Brunobnhtr/projeto-integrador-camara-frigorifica/imagens/regulador_de_tensao_lm2596_step_down_com_display.webp

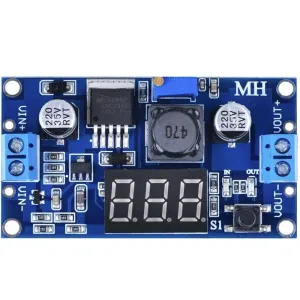
imagens/regulador_de_tensao_lm2596_step_down_com_display.webp
