Brunobnhtr/projeto-integrador-camara-frigorifica/imagens/bts7960-Pinout.webp

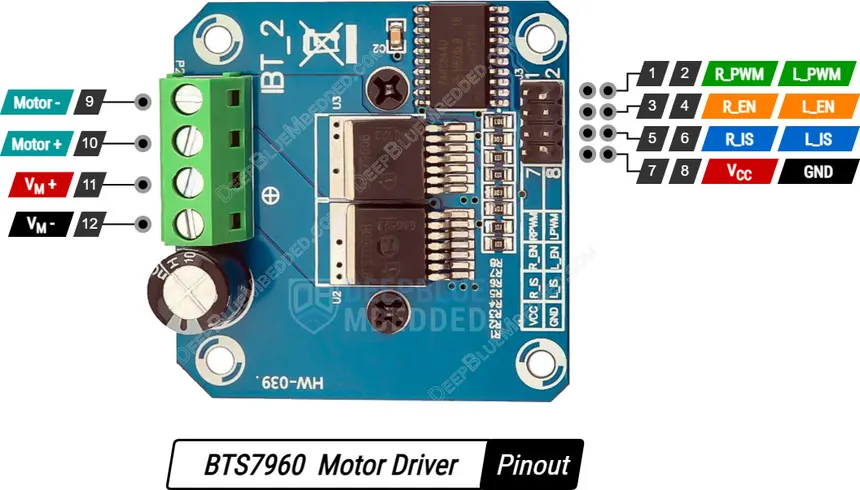
imagens/bts7960-Pinout.webp
