Brunobnhtr/projeto-integrador-camara-frigorifica/referencias/README.md

# Referências externas

Relatórios e análises de fora do projeto, guardados como estão — **não são documentação do
projeto**. Quando uma conclusão daqui vira decisão, ela é escrita no documento dono do assunto
e o relatório fica aqui só como fonte.

| Arquivo | O que é | Para onde foram as conclusões |
|---|---|---|
| [`2026-08_analise_acionamento_peltier.md`](2026-08_analise_acionamento_peltier.md) | Análise técnica do acionamento das cargas (Peltier, PTC, ventoinhas), com referências de fabricantes e do relatório SLUA979A da TI | ⏳ pendente — o ponto principal (PWM de 1 Hz na Peltier degrada o COP e a vida da pastilha) precisa ser decidido e escrito no [Doc 40](../camada_4_programacao/40_firmware_arduino.md) |
