Brunobnhtr/projeto-integrador-camara-frigorifica/compras_projeto/RELATORIO_OFERTAS_ALIEXPRESS.md

# Relatório Completo de Ofertas e Links no AliExpress

**Data da Varredura:** 01/11/2026 13:03
**Total de Itens Analisados:** 60 componentes
**Orçamento Estimado das Peças:** R$ 963.08

> [!NOTE]
> Todos os 60 componentes foram varridos no AliExpress com filtros anti-isca, detecção de frete grátis e verificação de reputação. O arquivo interativo [`lista_compras_interativa.html`](file:///c:/Users/Bruno/Documents/Estudos%20Programação/tecnico%20em%20eletrotecnica/projeto%20integrador/lista_compras_interativa.html) já foi atualizado com todos os links e opções.

### 1 · Núcleo térmico da câmara

| ID | Componente | Preço (R$) | Frete | Total (R$) | Reputação / Vendas | Anúncio Selecionado |
| :--- | :--- | :---: | :---: | :---: | :--- | :--- |
| `CAM-01` | **Kit Peltier duplo 2× TEC1-12706** | R$ 68.11 | Grátis | **R$ 68.11** | 68 vendido(s) 5★ | [Kit DIY Resfriamento Peltier Duplo com R...](https://pt.aliexpress.com/item/1005011995246407.html) |
| `CAM-02` | **Dissipador do lado quente (rejeitar 184 W a 43 °C)** | R$ 6.99 | Grátis | **R$ 6.99** | 8 vendido(s) 5★ | [Dissipador de Calor de Alumínio 40mm 40x...](https://pt.aliexpress.com/item/1005013118166628.html) |
| `CAM-03` | **Aquecedor Cerâmico PTC 12 V / 50 W com ventoinha integrada** | R$ 20.98 | Grátis | **R$ 20.98** | 57 vendido(s) 4.5★ | [Aquecedor automático, termostato, ptc, c...](https://pt.aliexpress.com/item/1005001849494940.html) |
| `CAM-04` | **Ventoinha 40 mm 12 V (boca dos dutos)** | R$ 5.59 | Grátis | **R$ 5.59** | 42 vendido(s) 4★ | [Dc 5v 12v 24v ventilador turbo impressor...](https://pt.aliexpress.com/item/1005004661839574.html) |
| `CAM-05` | **Sensor AM2315C (temperatura + umidade)** | R$ 28.20 | Grátis | **R$ 28.20** | ★ | [1 unidade/peça, 100% novo, sensor de tem...](https://pt.aliexpress.com/item/1005013336794806.html) |

### 2 · Vedação e montagem da câmara

| ID | Componente | Preço (R$) | Frete | Total (R$) | Reputação / Vendas | Anúncio Selecionado |
| :--- | :--- | :---: | :---: | :---: | :--- | :--- |
| `VED-01` | **Cola S-320 Sinteglas (acrílico)** | R$ 4.36 | Grátis | **R$ 4.36** | 300 vendido(s) 4.6★ | [5/30/50/100 pces cola de unhas de adesão...](https://pt.aliexpress.com/item/1005009827743042.html) |
| `VED-02` | **Silicone neutro transparente** | R$ 3.06 | Grátis | **R$ 3.06** | 243 vendido(s) 3.9★ | [Borracha De Silicone Resistente De Alta ...](https://pt.aliexpress.com/item/1005005574541570.html) |
| `VED-03` | **Fita adesiva de alumínio 50 mm** | R$ 5.17 | Grátis | **R$ 5.17** | 164 vendido(s) 4.5★ | [Filme de isolamento térmico de folha de ...](https://pt.aliexpress.com/item/1005006259610758.html) |
| `VED-04` | **Perfil EPDM tubular autoadesivo 9 × 6 mm** | R$ 6.99 | Grátis | **R$ 6.99** | 18 vendido(s) ★ | [Fita de Vedação de Espuma de Borracha EP...](https://pt.aliexpress.com/item/1005012600375752.html) |
| `VED-05` | **Dobradiça piano de alumínio 250 mm** | R$ 3.87 | Grátis | **R$ 3.87** | 28 vendido(s) 4★ | [Engrossar 304 aço inoxidável miniatura s...](https://pt.aliexpress.com/item/1005010578226233.html) |
| `VED-06` | **Fecho de pressão tipo borboleta (inox)** | R$ 3.91 | Grátis | **R$ 3.91** | 16 vendido(s) ★ | [Fecho de trava para caixa de ferramentas...](https://pt.aliexpress.com/item/1005013139036831.html) |
| `VED-07` | **Sílica gel indicadora** | R$ 8.28 | Grátis | **R$ 8.28** | 89 vendido(s) 5★ | [Desecante de sílica gel que muda de cor ...](https://pt.aliexpress.com/item/1005009708591354.html) |
| `VED-08` | **Bandeja de alumínio removível (condensado)** | R$ 4.36 | Grátis | **R$ 4.36** | 291 vendido(s) 4.7★ | [Chaveiro colorido vazio maquiagem compac...](https://pt.aliexpress.com/item/1005010219203881.html) |
| `VED-09` | **Tubo de silicone Ø 4 mm (respiro)** | R$ 3.96 | Grátis | **R$ 3.96** | 88 vendido(s) 5★ | [Mangueira de borracha de silicone de gra...](https://pt.aliexpress.com/item/1005007005480071.html) |
| `VED-10` | **Pasta térmica de alta condutividade** | R$ 4.44 | Grátis | **R$ 4.44** | 17 vendido(s) 4.9★ | [Pasta de graxa térmica condutora gd900, ...](https://pt.aliexpress.com/item/1005007124076300.html) |
| `VED-11` | **Prensa-cabo PG13,5 (PC-1) + prensa-cabo PG11 (PC-2)** | R$ 6.59 | Grátis | **R$ 6.59** | 4.000+ vendido(s) 4.8★ | [10 unidades de prensa-cabos à prova d'ág...](https://pt.aliexpress.com/item/1005003593198702.html) |
| `VED-12` | **Passa-fio / bucha do respiro Ø 6 mm** | R$ 5.61 | Grátis | **R$ 5.61** | 94 vendido(s) 4.7★ | [Plugue de borracha para cabo shifter ele...](https://pt.aliexpress.com/item/1005006423905385.html) |
| `VED-13` | **Isolante EPS/XPS 1 mm** | R$ 6.99 | Grátis | **R$ 6.99** | 29 vendido(s) 5★ | [1/18 peças de Folhas de Espuma EVA Color...](https://pt.aliexpress.com/item/1005012741696113.html) |

### 3 · Cargas de ensaio (LED 12 V)

| ID | Componente | Preço (R$) | Frete | Total (R$) | Reputação / Vendas | Anúncio Selecionado |
| :--- | :--- | :---: | :---: | :---: | :--- | :--- |
| `ELE-01` | **LED 5 mm difuso (kit)** | R$ 3.06 | Grátis | **R$ 3.06** | 200 vendido(s) 4.8★ | [10/20/100 pces led transparente redondo ...](https://pt.aliexpress.com/item/1005006728032746.html) |
| `ELE-02` | **Resistor 1 kΩ 1/4 W** | R$ 6.89 | Grátis | **R$ 6.89** | 1K+ vendido(s | [Frete grátis 100 peças 1/4w resistor de ...](https://pt.aliexpress.com/item/32660635741.html) |
| `ELE-03` | **Borne 2 vias 5,08 mm para PCB** | R$ 4.29 | Grátis | **R$ 4.29** | 2 vendido(s) ★ | [10 Peças Bloco de Terminais KF301-2P de ...](https://pt.aliexpress.com/item/1005011982846512.html) |
| `ELE-04` | **Placa ilhada 10 × 15 cm — corta em 2 de 95 × 75 mm** | R$ 6.99 | Grátis | **R$ 6.99** | 66 vendido(s) 4.8★ | [5pcs PCB 5x7 4x6 3x7 2x8 10x15 9x7x10 7x...](https://pt.aliexpress.com/item/1005001990562066.html) |
| `ELE-05` | **Verniz isolante para PCB (conformal coating)** | R$ 4.86 | Grátis | **R$ 4.86** | 48 vendido(s) 5★ | [1Pç Selante Isolante Eletrônico Impermeá...](https://pt.aliexpress.com/item/1005012496214820.html) |
| `ELE-06` | **Régua de borne plugável 8 vias 5,08 mm (macho + fêmea)** | R$ 5.20 | Grátis | **R$ 5.20** | 122 vendido(s) 4.6★ | [10 Peças Conector de Bloco de Terminais ...](https://pt.aliexpress.com/item/1005010423019702.html) |

### 4 · Controle e interface

| ID | Componente | Preço (R$) | Frete | Total (R$) | Reputação / Vendas | Anúncio Selecionado |
| :--- | :--- | :---: | :---: | :---: | :--- | :--- |
| `CTR-01` | **Arduino Mega 2560 R3** | R$ 48.50 | Grátis | **R$ 48.50** | 16 vendido(s) 5★ | [Placa Arduino Mega 2560 R3 CH340 (seleci...](https://pt.aliexpress.com/item/1005009455420266.html) |
| `CTR-02` | **Adaptador DIN do Mega com bornes parafuso** | R$ 54.00 | Grátis | **R$ 54.00** | 465 vendido(s) 4.6★ | [Shield Borne Parafuso Mega 2560 Montado ...](https://pt.aliexpress.com/item/1005008674435948.html) |
| `CTR-03` | **ESP32-WROOM-32U (DevKit 30 pinos, u.FL)** | R$ 8.81 | Grátis | **R$ 8.81** | 94 vendido(s) 5★ | [Kit de Placa de Desenvolvimento 32 com C...](https://pt.aliexpress.com/item/1005012903691148.html) |
| `CTR-04` | **DNLCB30 — base DIN para ESP32** | R$ 30.23 | Grátis | **R$ 30.23** | 500+ vendido(s) 4.9★ | [30pin 38pin esp32 placa de expansão mont...](https://pt.aliexpress.com/item/1005007915407236.html) |
| `CTR-05` | **IHM ES3C28P — ESP32-S3 2,8" toque, microSD, microfone (LCDWIKI)** | R$ 64.90 | Grátis | **R$ 64.90** | 154 vendido(s) 4.8★ | [Display IHM Touch 2.8 ESP32-S3 ES3C28P (...](https://pt.aliexpress.com/item/1005008568072063.html) |
| `CTR-06` | **Cartão microSD 8–16 GB Classe 10** | R$ 26.39 | Grátis | **R$ 26.39** | 26 vendido(s) 4.7★ | [2026 1PCS Cartão TF Classe 10 128GB 256G...](https://pt.aliexpress.com/item/1005013170105807.html) |
| `CTR-07` | **Conversor de nível lógico bidirecional 4 canais** | R$ 2.59 | Grátis | **R$ 2.59** | 37 vendido(s | [Conversor de Nível Lógico I2C de 2/4 Can...](https://pt.aliexpress.com/item/1005012391263916.html) |
| `CTR-08` | **Módulo RTC DS3231** | R$ 5.00 | Grátis | **R$ 5.00** | 280 vendido(s) 5★ | [Tzt ds3231 at24c32 módulo iic ds1302 mód...](https://pt.aliexpress.com/item/1005008404452597.html) |
| `CTR-09` | **Bateria CR2032** | R$ 5.25 | Grátis | **R$ 5.25** | 3 vendido(s) 5★ | [VINIK Bateria de Litio CR2032 Cartela C/...](https://pt.aliexpress.com/item/1005013396106230.html) |

### 5 · Sensores e potência

| ID | Componente | Preço (R$) | Frete | Total (R$) | Reputação / Vendas | Anúncio Selecionado |
| :--- | :--- | :---: | :---: | :---: | :--- | :--- |
| `POT-01` | **Módulo N4AIC24 — 22 canais 0–20 mA + 2 canais 0–30 V, RS-485 (eletechsup)** | R$ 45.71 | Grátis | **R$ 45.71** | 63 vendido(s) 4.8★ | [Placa do coletor do IO do PLC de MODBUS ...](https://pt.aliexpress.com/item/1005006985583356.html) |
| `POT-03` | **DS18B20 à prova d'água + adaptador com pull-up 4,7 kΩ** | R$ 3.17 | Grátis | **R$ 3.17** | 1.000+ vendido(s) 5★ | [Kit de módulo sensor de temperatura ds18...](https://pt.aliexpress.com/item/4000068914916.html) |
| `POT-04` | **Driver ponte-H BTS7960 (IBT-2)** | R$ 15.45 | Grátis | **R$ 15.45** | 215 vendido(s) 4.4★ | [Módulo Driver de Motor de Alta Potência ...](https://pt.aliexpress.com/item/1005001552617411.html) |
| `POT-05` | **Suporte SPCI4 para trilho DIN (placa BTS7960)** | R$ 18.14 | Grátis | **R$ 18.14** | 211 vendido(s) 5★ | [Suporte de montagem com capacidade forte...](https://pt.aliexpress.com/item/1005006330486538.html) |
| `POT-06` | **Módulo MAX485 TTL ↔ RS-485** | R$ 2.52 | Grátis | **R$ 2.52** | 413 vendido(s | [1/5 pces max485 módulo RS-485 ttl virar ...](https://pt.aliexpress.com/item/1005008143587329.html) |

### 6 · Comando e proteção

| ID | Componente | Preço (R$) | Frete | Total (R$) | Reputação / Vendas | Anúncio Selecionado |
| :--- | :--- | :---: | :---: | :---: | :--- | :--- |
| `CMD-01` | **KM1 — Relé 14 pinos 24 Vcc (HH64P / LY4NJ 10 A) + base DIN PTF14A** | R$ 5.00 | Grátis | **R$ 5.00** | 7 vendido(s) ★ | [5 peças branco ly4nj hh64p ac 110v 220v ...](https://pt.aliexpress.com/item/1005009694726729.html) |
| `CMD-02` | **Módulo relé 1 canal 5 V optoacoplado** | R$ 3.99 | Grátis | **R$ 3.99** | 729 vendido(s | [DC 3V 5V 12V 24V 1 Canal Relé Optoacopla...](https://pt.aliexpress.com/item/1005006636278681.html) |
| `CMD-03` | **Botão de emergência cogumelo 22 mm com trava** | R$ 15.61 | Grátis | **R$ 15.61** | 2.000+ vendido(s) 4.9★ | [ZB2-BE102C p172 220v 10a vermelho nc 22m...](https://pt.aliexpress.com/item/1005002447999037.html) |
| `CMD-04` | **Botão START / LIGAR 22 mm verde** | R$ 3.65 | Grátis | **R$ 3.65** | 63 vendido(s) ★ | [XB2-EC31 XB2-EC42 XB2-EC51 cogumelo cabe...](https://pt.aliexpress.com/item/1005005249188935.html) |
| `CMD-05` | **Botão STOP 22 mm preto** | R$ 16.38 | Grátis | **R$ 16.38** | 700+ vendido(s) 4.5★ | [1PC Botão de Pressão Momentâneo de Metal...](https://pt.aliexpress.com/item/1005011991759856.html) |
| `CMD-06` | **Sinaleiro LED 22 mm 5 V** | R$ 5.80 | Grátis | **R$ 5.80** | 5K+ vendido(s | [Luz indicadora de metal led 6/8/10/12/16...](https://pt.aliexpress.com/item/1005006509086830.html) |
| `CMD-07` | **Disjuntor bipolar DIN 2P** | R$ 8.18 | Grátis | **R$ 8.18** | 10.000+ vendido(s) 4.9★ | [Disjuntor Miniatura TOMZN AC MCB TOB1-63...](https://pt.aliexpress.com/item/1005005315486852.html) |
| `CMD-08` | **Porta-fusível DIN 1 via com gaveta (ramais DC)** | R$ 17.27 | Grátis | **R$ 17.27** | 191 vendido(s) 5★ | [1 conjunto RT18-32X ac 500v ~ 690v 32a 1...](https://pt.aliexpress.com/item/1005005652228604.html) |
| `CMD-09` | **Fusíveis para F1/F2/F3 — valores e formato pendentes** | R$ 18.51 | Grátis | **R$ 18.51** | 286 vendido(s) 4.9★ | [Fusível cerâmico rápido do sopro, 10x38m...](https://pt.aliexpress.com/item/1005004206329118.html) |
| `CMD-10` | **Placa de distribuição 8 canais com chave + porta-fusível (trilho DIN)** | R$ 47.79 | Grátis | **R$ 47.79** | 119 vendido(s) 4.9★ | [Caixa de Fusíveis Universal para Carro c...](https://pt.aliexpress.com/item/1005004520637634.html) |
| `CMD-12` | **Fusíveis de lâmina ATO/ATC 1 A (para o CMD-10)** | R$ 6.69 | Grátis | **R$ 6.69** | 1.000+ vendido(s) 4.8★ | [Caixa média do fusível do carro do ATC, ...](https://pt.aliexpress.com/item/4000827623534.html) |
| `CMD-11` | **Barra de terra PE para painel** | R$ 6.99 | Grátis | **R$ 6.99** | 250 vendido(s | [1 peça verde azul parafuso latão trilho ...](https://pt.aliexpress.com/item/1005005675027929.html) |

### 7 · Alimentação

| ID | Componente | Preço (R$) | Frete | Total (R$) | Reputação / Vendas | Anúncio Selecionado |
| :--- | :--- | :---: | :---: | :---: | :--- | :--- |
| `ALI-01` | **Fonte chaveada 24 Vcc 10 A / 240 W** | R$ 134.99 | Grátis | **R$ 134.99** | 6 vendido(s) ★ | [Fonte de Alimentação Chaveada NDR-240-24...](https://pt.aliexpress.com/item/1005012555935454.html) |
| `ALI-02` | **T2/T3 — conversores propostos, modelos não aprovados** | R$ 58.00 | Grátis | **R$ 58.00** | 2.000+ vendido(s) 4.8★ | [Conversor Step-Down 24V para 12V 15A/20A...](https://pt.aliexpress.com/item/32827678754.html) |

### 8 · Comunicação

| ID | Componente | Preço (R$) | Frete | Total (R$) | Reputação / Vendas | Anúncio Selecionado |
| :--- | :--- | :---: | :---: | :---: | :--- | :--- |
| `COM-01` | **Antena 2,4 GHz SMA macho 3 dBi articulável** | R$ 8.35 | Grátis | **R$ 8.35** | 97 vendido(s) 5★ | [2.4GHz 3dBi WiFi 2.4g Antena Aérea RP-SM...](https://pt.aliexpress.com/item/1005003106292591.html) |
| `COM-02` | **Pigtail IPEX (u.FL) → SMA fêmea de painel, 20–30 cm** | R$ 3.61 | Grátis | **R$ 3.61** | 1.000+ vendido(s) 5★ | [U.FL IPX IPX1 UFL para RP-SMA Antena de ...](https://pt.aliexpress.com/item/1005006779358232.html) |

### 9 · Passivos

| ID | Componente | Preço (R$) | Frete | Total (R$) | Reputação / Vendas | Anúncio Selecionado |
| :--- | :--- | :---: | :---: | :---: | :--- | :--- |
| `PAS-01` | **Capacitor cerâmico 100 nF** | R$ 4.01 | Grátis | **R$ 4.01** | 1.000+ vendido(s) 4.8★ | [100PCS capacitor cerâmico monolítico 10P...](https://pt.aliexpress.com/item/1005007121552900.html) |
| `PAS-02` | **Resistor 10 kΩ ¼ W** | R$ 2.29 | Grátis | **R$ 2.29** | 632 vendido(s | [100pcs 1/4W 1R ~ 22M 1% resistor de film...](https://pt.aliexpress.com/item/1005002759346943.html) |
| `PAS-03` | **Diodo 1N4007** | R$ 3.45 | Grátis | **R$ 3.45** | 108 vendido(s) 5★ | [100PCS 1N4007 IN4007 4007 1N4007W 1N4007...](https://pt.aliexpress.com/item/1005007474734646.html) |

### 3 · Cargas de ensaio (LED 12 V)

| ID | Componente | Preço (R$) | Frete | Total (R$) | Reputação / Vendas | Anúncio Selecionado |
| :--- | :--- | :---: | :---: | :---: | :--- | :--- |
| `ELE-07` | **Chapa de alumínio 5052, 1,0 mm — retalho 250 × 200 mm** | R$ 25.19 | Grátis | **R$ 25.19** | 5 vendido(s) ★ | [5052 placa redonda de alumínio do círcul...](https://pt.aliexpress.com/item/1005010446356446.html) |
| `ELE-08` | **Parafuso M4 × 10 mm + porca (berço nas cantoneiras CAM-24)** | R$ 4.43 | Grátis | **R$ 4.43** | 213 vendido(s) 5★ | [1-2 Peças M3 M4 M5 M6 M8 M10 M12 Parafus...](https://pt.aliexpress.com/item/1005005883416931.html) |
| `ELE-09` | **Parafuso M3 × 8 mm + porca (fixação das placas no berço)** | R$ 3.49 | Grátis | **R$ 3.49** | 42 vendido(s) ★ | [1-100 Peças M1 M1.2 M1.4 M1.6 M2 M2.5 M3...](https://pt.aliexpress.com/item/1005008277639639.html) |
