Brunobnhtr/projeto-integrador-camara-frigorifica/compras_projeto/LISTA_COMPRAS.md

# Lista de compras — Projeto Integrador

Atualizado em 01/11/2026 · **0 de 60** itens com preço · total **R$ 0,00**

> **BLOQUEIO DE COMPRA:** PTC 12 V/50 W e conversores T2 (5 V/5 A) e T3 (12 V/20 A) são propostas sem modelos/fichas aprovados. Não comprar nem energizar. Corte DC do PTC, F3, proteção da saída de 12 V e condutores seguem pendentes; esta lista não autoriza compra.

> Não entram na lista porque o SENAI fornece: Cabos de alimentação e de sinal; Trilho DIN 35 mm; Canaletas perfuradas 30×30 e 25×25; Parafusos, porcas e arruelas; Gabinete/painel 600×800×250 (ou 700×700×250); Chapa de acrílico (corte da câmara); Bornes internos de distribuição (BD-24V, BD-POT, BD-5V, BD-AUX, BD-0V).

## Bloco 1 · Núcleo térmico da câmara

| ID | Item | Qtd | Loja | Preço | Link |
|---|---|---|---|---|---|
| CAM-01 | Kit Peltier duplo 2× TEC1-12706 | 1 kit | AliExpress | R$ 20,69 | [abrir](https://pt.aliexpress.com/item/1005009521156873.html) |
| CAM-02 | Dissipador do lado quente (rejeitar 184 W a 43 °C) | 1 | AliExpress | R$ 6,99 | [abrir](https://pt.aliexpress.com/item/1005013118166628.html) |
| CAM-03 | Aquecedor Cerâmico PTC 12 V / 50 W com ventoinha integrada | 1 | AliExpress | R$ 20,98 | [abrir](https://pt.aliexpress.com/item/1005001849494940.html) |
| CAM-04 | Ventoinha 40 mm 12 V (boca dos dutos) | 2 | AliExpress | R$ 5,59 | [abrir](https://pt.aliexpress.com/item/1005004661839574.html) |
| CAM-05 | Sensor AM2315C (temperatura + umidade) | 1 | Mercado Livre | a confirmar | [abrir](https://lista.mercadolivre.com.br/sensor-am2315c) |
| CAM-05 | Sensor AM2315C (temperatura + umidade) | 1 | AliExpress | a confirmar | [abrir](https://www.aliexpress.com/w/wholesale-AM2315C-sensor.html) |
| CAM-05 | Sensor AM2315C (temperatura + umidade) | 1 | AliExpress | R$ 28,20 | [abrir](https://pt.aliexpress.com/item/1005013336794806.html) |

## Bloco 2 · Vedação e montagem da câmara

| ID | Item | Qtd | Loja | Preço | Link |
|---|---|---|---|---|---|
| VED-01 | Cola S-320 Sinteglas (acrílico) | 1 frasco | AliExpress | R$ 4,36 | [abrir](https://pt.aliexpress.com/item/1005009827743042.html) |
| VED-02 | Silicone neutro transparente | 1 tubo | AliExpress | R$ 3,06 | [abrir](https://pt.aliexpress.com/item/1005005574541570.html) |
| VED-03 | Fita adesiva de alumínio 50 mm | 1 rolo 20 m | AliExpress | R$ 5,17 | [abrir](https://pt.aliexpress.com/item/1005006259610758.html) |
| VED-04 | Perfil EPDM tubular autoadesivo 9 × 6 mm | ~1,5 m | AliExpress | R$ 6,99 | [abrir](https://pt.aliexpress.com/item/1005012600375752.html) |
| VED-05 | Dobradiça piano de alumínio 250 mm | 1 | AliExpress | R$ 3,87 | [abrir](https://pt.aliexpress.com/item/1005010578226233.html) |
| VED-06 | Fecho de pressão tipo borboleta (inox) | 2 | AliExpress | R$ 3,91 | [abrir](https://pt.aliexpress.com/item/1005013139036831.html) |
| VED-07 | Sílica gel indicadora | 4 sachês | AliExpress | R$ 8,28 | [abrir](https://pt.aliexpress.com/item/1005009708591354.html) |
| VED-08 | Bandeja de alumínio removível (condensado) | 1 | AliExpress | R$ 4,36 | [abrir](https://pt.aliexpress.com/item/1005010219203881.html) |
| VED-09 | Tubo de silicone Ø 4 mm (respiro) | 0,5 m | AliExpress | R$ 3,96 | [abrir](https://pt.aliexpress.com/item/1005007005480071.html) |
| VED-10 | Pasta térmica de alta condutividade | 1 bisnaga | AliExpress | R$ 4,44 | [abrir](https://pt.aliexpress.com/item/1005007124076300.html) |
| VED-11 | Prensa-cabo PG13,5 (PC-1) + prensa-cabo PG11 (PC-2) | 1 de cada | AliExpress | R$ 6,59 | [abrir](https://pt.aliexpress.com/item/1005003593198702.html) |
| VED-12 | Passa-fio / bucha do respiro Ø 6 mm | 1 | AliExpress | R$ 5,61 | [abrir](https://pt.aliexpress.com/item/1005006423905385.html) |
| VED-13 | Isolante EPS/XPS 1 mm | a medir | AliExpress | R$ 6,99 | [abrir](https://pt.aliexpress.com/item/1005012741696113.html) |

## Bloco 3 · Cargas de ensaio (LED 12 V)

| ID | Item | Qtd | Loja | Preço | Link |
|---|---|---|---|---|---|
| ELE-01 | LED 5 mm difuso (kit) | 8 | AliExpress | R$ 3,06 | [abrir](https://pt.aliexpress.com/item/1005006728032746.html) |
| ELE-02 | Resistor 1 kΩ 1/4 W | 8 | AliExpress | R$ 6,89 | [abrir](https://pt.aliexpress.com/item/32660635741.html) |
| ELE-03 | Borne 2 vias 5,08 mm para PCB | 8 (4 por placa) | AliExpress | R$ 4,29 | [abrir](https://pt.aliexpress.com/item/1005011982846512.html) |
| ELE-04 | Placa ilhada 10 × 15 cm — corta em 2 de 95 × 75 mm | 1 | AliExpress | R$ 6,99 | [abrir](https://pt.aliexpress.com/item/1005001990562066.html) |
| ELE-05 | Verniz isolante para PCB (conformal coating) | 1 frasco | AliExpress | R$ 4,86 | [abrir](https://pt.aliexpress.com/item/1005012496214820.html) |
| ELE-06 | Régua de borne plugável 8 vias 5,08 mm (macho + fêmea) | 2 conjuntos | AliExpress | R$ 5,20 | [abrir](https://pt.aliexpress.com/item/1005010423019702.html) |

## Bloco 4 · Controle e interface

| ID | Item | Qtd | Loja | Preço | Link |
|---|---|---|---|---|---|
| CTR-01 | Arduino Mega 2560 R3 | 1 | AliExpress | R$ 15,28 | [abrir](https://pt.aliexpress.com/item/1005009455420266.html) |
| CTR-02 | Adaptador DIN do Mega com bornes parafuso | 1 | AliExpress | R$ 16,34 | [abrir](https://pt.aliexpress.com/item/1005008674435948.html) |
| CTR-03 | ESP32-WROOM-32U (DevKit 30 pinos, u.FL) | 1 | AliExpress | R$ 8,81 | [abrir](https://pt.aliexpress.com/item/1005012903691148.html) |
| CTR-04 | DNLCB30 — base DIN para ESP32 | 1 | AliExpress | R$ 30,23 | [abrir](https://pt.aliexpress.com/item/1005007915407236.html) |
| CTR-05 | IHM ES3C28P — ESP32-S3 2,8" toque, microSD, microfone (LCDWIKI) | 1 | AliExpress | R$ 19,32 | [abrir](https://pt.aliexpress.com/item/1005008568072063.html) |
| CTR-06 | Cartão microSD 8–16 GB Classe 10 | 1 | AliExpress | R$ 26,39 | [abrir](https://pt.aliexpress.com/item/1005013170105807.html) |
| CTR-07 | Conversor de nível lógico bidirecional 4 canais | 1 | AliExpress | R$ 2,59 | [abrir](https://pt.aliexpress.com/item/1005012391263916.html) |
| CTR-08 | Módulo RTC DS3231 | 1 | AliExpress | R$ 5,00 | [abrir](https://pt.aliexpress.com/item/1005008404452597.html) |
| CTR-09 | Bateria CR2032 | 1 | AliExpress | R$ 5,25 | [abrir](https://pt.aliexpress.com/item/1005013396106230.html) |

## Bloco 5 · Sensores e potência

| ID | Item | Qtd | Loja | Preço | Link |
|---|---|---|---|---|---|
| POT-01 | Módulo N4AIC24 — 22 canais 0–20 mA + 2 canais 0–30 V, RS-485 (eletechsup) | 1 | AliExpress | R$ 45,71 | [abrir](https://pt.aliexpress.com/item/1005006985583356.html) |
| POT-03 | DS18B20 à prova d'água + adaptador com pull-up 4,7 kΩ | 1 kit | AliExpress | R$ 3,17 | [abrir](https://pt.aliexpress.com/item/4000068914916.html) |
| POT-04 | Driver ponte-H BTS7960 (IBT-2) | 2 | AliExpress | R$ 15,45 | [abrir](https://pt.aliexpress.com/item/1005001552617411.html) |
| POT-05 | Suporte SPCI4 para trilho DIN (placa BTS7960) | 2 | AliExpress | R$ 18,14 | [abrir](https://pt.aliexpress.com/item/1005006330486538.html) |
| POT-06 | Módulo MAX485 TTL ↔ RS-485 | 1 | AliExpress | R$ 2,52 | [abrir](https://pt.aliexpress.com/item/1005008143587329.html) |

## Bloco 6 · Comando e proteção

| ID | Item | Qtd | Loja | Preço | Link |
|---|---|---|---|---|---|
| CMD-01 | KM1 — Relé 14 pinos 24 Vcc (HH64P / LY4NJ 10 A) + base DIN PTF14A | 1 | Mercado Livre | a confirmar | [abrir](https://lista.mercadolivre.com.br/rele-ly2n-24vcc-com-base-din-ptf08a) |
| CMD-01 | KM1 — Relé 14 pinos 24 Vcc (HH64P / LY4NJ 10 A) + base DIN PTF14A | 1 | AliExpress | a confirmar | [abrir](https://www.aliexpress.com/w/wholesale-LY2NJ-24VDC-relay-with-socket-base.html) |
| CMD-01 | KM1 — Relé 14 pinos 24 Vcc (HH64P / LY4NJ 10 A) + base DIN PTF14A | 1 | AliExpress | R$ 5,00 | [abrir](https://pt.aliexpress.com/item/1005009694726729.html) |
| CMD-01 | KM1 — Relé 14 pinos 24 Vcc (HH64P / LY4NJ 10 A) + base DIN PTF14A | 1 | AliExpress | R$ 6,99 | [abrir](https://pt.aliexpress.com/item/1005008248092442.html) |
| CMD-01 | KM1 — Relé 14 pinos 24 Vcc (HH64P / LY4NJ 10 A) + base DIN PTF14A | 1 | AliExpress | R$ 15,05 | [abrir](https://pt.aliexpress.com/item/1005004341879976.html) |
| CMD-02 | Módulo relé 1 canal 5 V optoacoplado | 3 | AliExpress | R$ 3,99 | [abrir](https://pt.aliexpress.com/item/1005006636278681.html) |
| CMD-03 | Botão de emergência cogumelo 22 mm com trava | 1 | AliExpress | R$ 15,61 | [abrir](https://pt.aliexpress.com/item/1005002447999037.html) |
| CMD-04 | Botão START / LIGAR 22 mm verde | 1 | AliExpress | R$ 3,65 | [abrir](https://pt.aliexpress.com/item/1005005249188935.html) |
| CMD-05 | Botão STOP 22 mm preto | 1 | AliExpress | R$ 16,38 | [abrir](https://pt.aliexpress.com/item/1005011991759856.html) |
| CMD-06 | Sinaleiro LED 22 mm 5 V | 4 | AliExpress | R$ 5,80 | [abrir](https://pt.aliexpress.com/item/1005006509086830.html) |
| CMD-07 | Disjuntor bipolar DIN 2P | 1 | AliExpress | R$ 8,18 | [abrir](https://pt.aliexpress.com/item/1005005315486852.html) |
| CMD-08 | Porta-fusível DIN 1 via com gaveta (ramais DC) | 3 | AliExpress | R$ 17,27 | [abrir](https://pt.aliexpress.com/item/1005005652228604.html) |
| CMD-09 | Fusíveis para F1/F2/F3 — valores e formato pendentes | a dimensionar | AliExpress | R$ 18,51 | [abrir](https://pt.aliexpress.com/item/1005004206329118.html) |
| CMD-10 | Placa de distribuição 8 canais com chave + porta-fusível (trilho DIN) | 1 | AliExpress | R$ 47,79 | [abrir](https://pt.aliexpress.com/item/1005004520637634.html) |
| CMD-12 | Fusíveis de lâmina ATO/ATC 1 A (para o CMD-10) | 10 (8 + 2 de reserva) | AliExpress | R$ 6,69 | [abrir](https://pt.aliexpress.com/item/4000827623534.html) |
| CMD-11 | Barra de terra PE para painel | 1 | AliExpress | R$ 6,99 | [abrir](https://pt.aliexpress.com/item/1005005675027929.html) |

## Bloco 7 · Alimentação

| ID | Item | Qtd | Loja | Preço | Link |
|---|---|---|---|---|---|
| ALI-01 | Fonte chaveada 24 Vcc 10 A / 240 W | 1 | Mercado Livre | a confirmar | [abrir](https://www.mercadolivre.com.br/fonte-chaveada-24v-10a-240w-bivolt-gabinete-metal-colmeia/up/MLBU2208031138) |
| ALI-01 | Fonte chaveada 24 Vcc 10 A / 240 W | 1 | AliExpress | R$ 134,99 | [abrir](https://pt.aliexpress.com/item/1005012555935454.html) |
| ALI-02 | T2/T3 — conversores propostos, modelos não aprovados | 2 | AliExpress | R$ 25,10 | [abrir](https://pt.aliexpress.com/item/32827678754.html) |

## Bloco 8 · Comunicação

| ID | Item | Qtd | Loja | Preço | Link |
|---|---|---|---|---|---|
| COM-01 | Antena 2,4 GHz SMA macho 3 dBi articulável | 1 | AliExpress | R$ 8,35 | [abrir](https://pt.aliexpress.com/item/1005003106292591.html) |
| COM-02 | Pigtail IPEX (u.FL) → SMA fêmea de painel, 20–30 cm | 1 | AliExpress | R$ 3,61 | [abrir](https://pt.aliexpress.com/item/1005006779358232.html) |

## Bloco 9 · Passivos

| ID | Item | Qtd | Loja | Preço | Link |
|---|---|---|---|---|---|
| PAS-01 | Capacitor cerâmico 100 nF | 2 | Mercado Livre | a confirmar | [abrir](https://produto.mercadolivre.com.br/MLB-1854298160-kit-20-capacitores-ceramicos-100nf-50v-104-_JM) |
| PAS-01 | Capacitor cerâmico 100 nF | 2 | AliExpress | R$ 4,01 | [abrir](https://pt.aliexpress.com/item/1005007121552900.html) |
| PAS-02 | Resistor 10 kΩ ¼ W | 6 | AliExpress | R$ 2,29 | [abrir](https://pt.aliexpress.com/item/1005002759346943.html) |
| PAS-03 | Diodo 1N4007 | 3 | Mercado Livre | a confirmar | [abrir](https://produto.mercadolivre.com.br/MLB-3563968257-filtro-diodo-supressor-de-ruido-0-a-24vcc-dds-sibratec-_JM) |
| PAS-03 | Diodo 1N4007 | 3 | AliExpress | R$ 3,45 | [abrir](https://pt.aliexpress.com/item/1005007474734646.html) |

## Bloco 3 · Cargas de ensaio (LED 12 V)

| ID | Item | Qtd | Loja | Preço | Link |
|---|---|---|---|---|---|
| ELE-07 | Chapa de alumínio 5052, 1,0 mm — retalho 250 × 200 mm | 1 | AliExpress | R$ 25,19 | [abrir](https://pt.aliexpress.com/item/1005010446356446.html) |
| ELE-08 | Parafuso M4 × 10 mm + porca (berço nas cantoneiras CAM-24) | 4 conjuntos | AliExpress | R$ 4,43 | [abrir](https://pt.aliexpress.com/item/1005005883416931.html) |
| ELE-09 | Parafuso M3 × 8 mm + porca (fixação das placas no berço) | 8 conjuntos | AliExpress | R$ 3,49 | [abrir](https://pt.aliexpress.com/item/1005008277639639.html) |
