Brunobnhtr/projeto-integrador-camara-frigorifica/demanda_secundaria/02_PROJECT_CANVAS.md

# PROJECT MODEL CANVAS
## SILO INTELIGENTE (Demanda GP Inovação #13063)

| JUSTIFICATIVAS | OBJETIVO SMART | BENEFÍCIOS |
| :--- | :--- | :--- |
| **Por que o projeto existe?**<br>- Processo atual de medição da gipsita é manual.<br>- Risco de acidentes ao subir nos silos.<br>- Falta de previsibilidade logística, causando paradas ou falta de material para os fornos.<br>- Alto nível de particulado (poeira) dificulta uso de sensores ópticos/ultrassônicos convencionais. | **O que o projeto vai entregar e quando?**<br>Desenvolver, no prazo do curso técnico, um protótipo funcional de telemetria sem contato para medição de nível de sólidos (gipsita), integrando radar de 80GHz a um painel IoT (ESP32) enviando dados via Wi-Fi/MQTT para uma interface de controle em tempo real. | **Quais os ganhos esperados?**<br>- Fim da necessidade do operador escalar silos de forma arriscada.<br>- Informação 24/7 sobre o estoque logístico, permitindo melhor controle dos fornos.<br>- Painel centralizado eliminando o "achismo" fabril.<br>- Custo-benefício aplicando IoT e microcontroladores sobre instrumentação pesada. |

| PRODUTO | REQUISITOS | STAKEHOLDERS |
| :--- | :--- | :--- |
| **O que será entregue?**<br>1. Painel Elétrico de Medição IP65.<br>2. Sistema de captação de sinal 4-20mA (Conversor ADC e ESP32).<br>3. Sensor Radar de Nível 80GHz instalado no topo do silo.<br>4. Dashboard remoto em tempo real exibindo a lotação (Volume) dos três silos. | **Características obrigatórias?**<br>- O sensor não pode ter contato físico direto com a matéria-prima.<br>- O sistema de sensoriamento deve ser imune à poeira densa (uso de onda eletromagnética).<br>- O painel elétrico deve suportar o ambiente hostil da mineração (vedação).<br>- Leitura atualizada pelo menos a cada 10 segundos.<br>- Conformidade com a NR-10 e NR-35 (reduzindo trabalho em altura). | **Quem está envolvido?**<br>- **Equipe técnica:** Alunos do curso de Eletrotécnica.<br>- **Cliente:** Gestores de Operação e Logística da fábrica de gesso.<br>- **Banca de Avaliação:** Professores do SENAI. |

| EQUIPE | PREMISSAS | RESTRIÇÕES |
| :--- | :--- | :--- |
| **Quem fará o trabalho?**<br>- Integrantes do grupo (Técnicos em Eletrotécnica em formação).<br> | **Suposições essenciais?**<br>- A infraestrutura da empresa cliente tem cobertura de Wi-Fi próxima aos silos.<br>- O cliente fornecerá a altura geométrica e formato (cone/cilindro) do silo para o cálculo algorítmico do volume.<br>- Disponibilidade de alimentação elétrica 127/220V no topo do silo ou na base. | **Limitações do projeto?**<br>- Orçamento limitado para a construção do protótipo.<br>- Não podemos alterar ou interferir nos painéis de comando dos fornos, apenas extrair a medição.<br>- O sensor deve ser homologado e não uma adaptação caseira de ultrassom (que falhará na poeira). |

| RISCOS | LINHA DO TEMPO | CUSTOS |
| :--- | :--- | :--- |
| **O que pode dar errado?**<br>- Queda de rede Wi-Fi interrompendo a telemetria (Mitigação: usar armazenamento local no SD Card do ESP32 até a rede voltar).<br>- Superaquecimento do painel devido ao sol escaldante na área externa (Mitigação: instalar o quadro protegido com tampa anti-UV ou teto). | **Quando será feito?**<br>- **Fase 1:** Pesquisa de especificação do radar didático/industrial e componentes elétricos.<br>- **Fase 2:** Montagem do quadro de comando e teste de bancada na maquete.<br>- **Fase 3:** Programação do ESP32, MQTT e Dashboard.<br>- **Fase 4:** Teste na maquete do silo e Validação final. | **Estimativa orçamentária do Protótipo:**<br>- **Opção Nível 1:** Radar mmWave Distância (ex: Acconeer A121 ou DFRobot): ~R$ 70 a R$ 150<br>- **Opção Nível 2:** Radar Industrial 80GHz Chinês 4-20mA: ~R$ 1.000 a R$ 1.500<br><br>*(Demais custos da maquete/painel)*<br>- Quadro IP65, Disjuntores, Bornes e Fontes: ~R$ 150<br>- Módulos IoT (ESP32): ~R$ 60<br>- Componentes da maquete (tubos PVC): ~R$ 50<br>**Custo Total (Nível 1):** ~R$ 330<br>**Custo Total (Nível 2):** ~R$ 1.300 |
