Brunobnhtr/projeto-integrador-camara-frigorifica/entrega_senai/06_entrega/ANALISE_VIABILIDADE.md

# Análise de Viabilidade — Projeto Integrador 2026

> ⚠️ **Como usar:** este documento apresenta a análise de viabilidade das **duas demandas**
> cadastradas no SAGA (GP Inovação SENAI). Cada demanda é analisada de forma independente,
> com três pilares: **viabilidade técnica**, **viabilidade econômica** e **viabilidade
> operacional**. O formato segue o padrão das entregas do Projeto Integrador — linguagem
> impessoal, objetiva e com evidências.

---

# DEMANDA 1 — Cabine Climatizada de Ensaios Térmicos

> **SAGA GP Inovação:** Projeto Integrador 2026/01 6.01 03
> **Título:** Implementação de Sistema de Controle Inteligente com ESP32 para Cabine Climatizada
> **Empresa:** Ensaios & Controle Tech
> **Área:** Automação

---

## 1. Descrição da Demanda

A empresa realiza ensaios térmicos em dispositivos eletrônicos embarcados, submetendo até 50
unidades simultaneamente a ciclos de aquecimento e resfriamento em cabine climatizada, conforme
a série IEC 60068-2. O sistema atual opera com Arduino e acionamento manual, sem monitoramento
remoto, sem registro de dados e sem detecção individual de falha. Quando um dispositivo falha
durante o ciclo, a falha só é percebida ao final — sem rastreabilidade de quando nem por quê.
O ensaio inteiro é descartado.
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
