Brunobnhtr/projeto-integrador-camara-frigorifica/compras_projeto/fotos/CAM-01_capturado.jpg

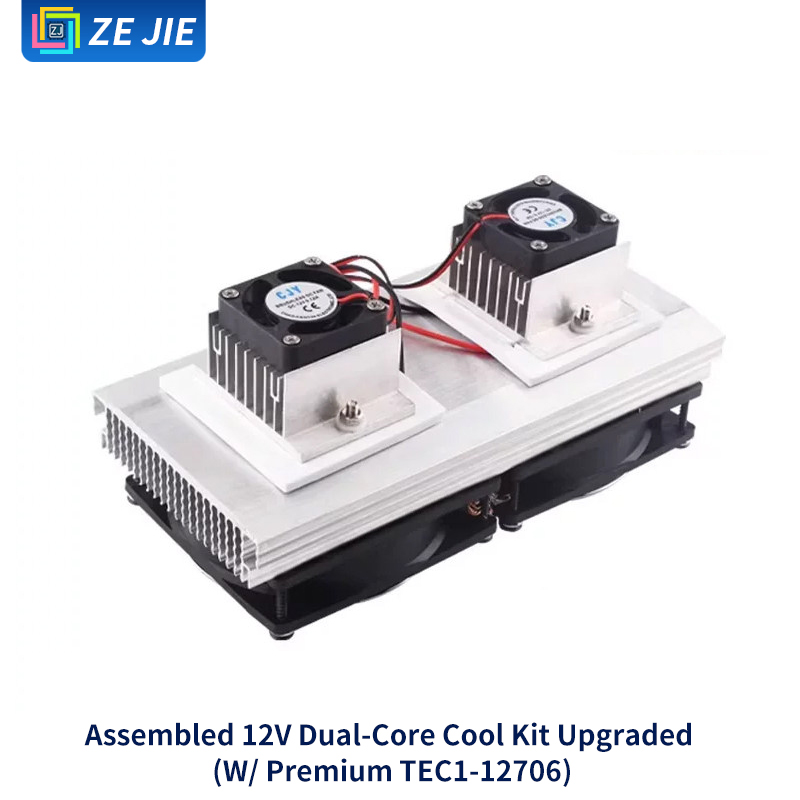
compras_projeto/fotos/CAM-01_capturado.jpg
