Brunobnhtr/projeto-integrador-camara-frigorifica/compras_projeto/fotos/CAM-01_variacao.jpg

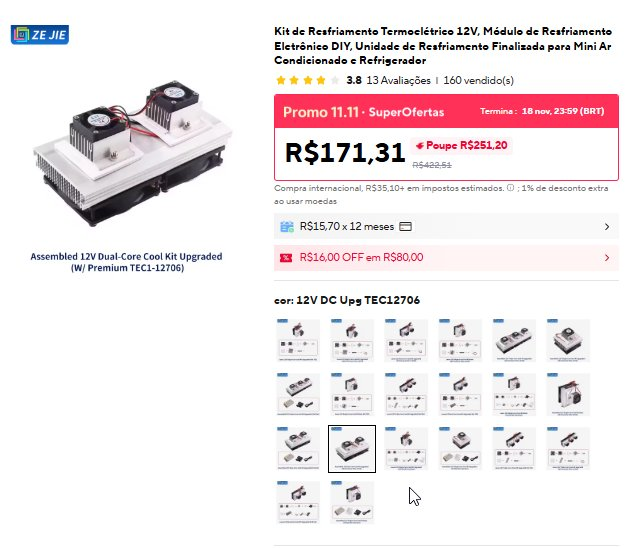
compras_projeto/fotos/CAM-01_variacao.jpg
