Brunobnhtr/projeto-integrador-camara-frigorifica/compras_projeto/fotos/CAM-05_capturado.jpg

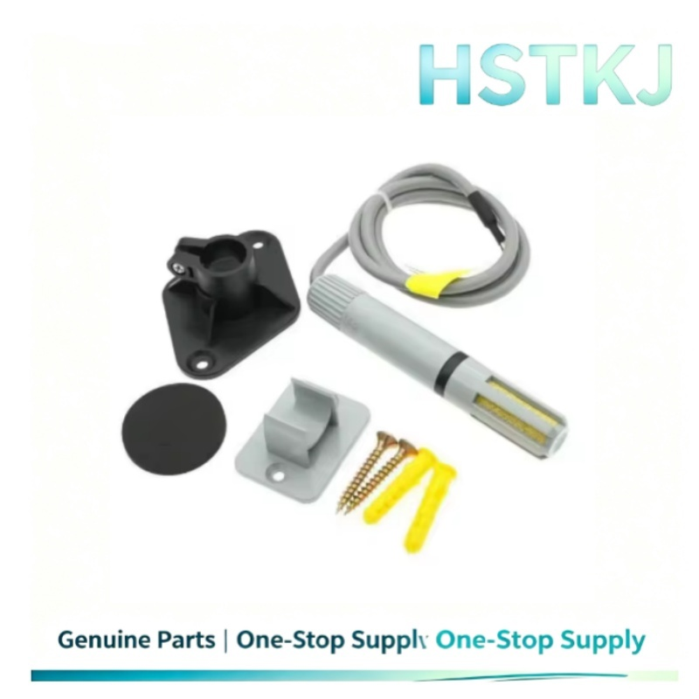
compras_projeto/fotos/CAM-05_capturado.jpg
