Brunobnhtr/projeto-integrador-camara-frigorifica/compras_projeto/fotos/CMD-01_capturado.jpg

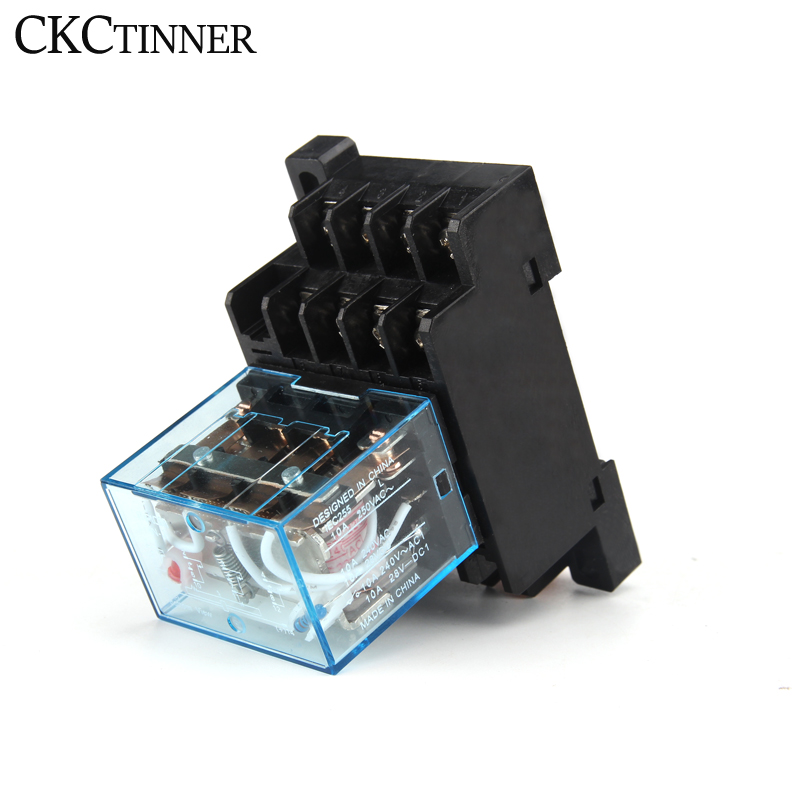
compras_projeto/fotos/CMD-01_capturado.jpg
