Brunobnhtr/projeto-integrador-camara-frigorifica/compras_projeto/fotos/CTR-01_capturado.jpg

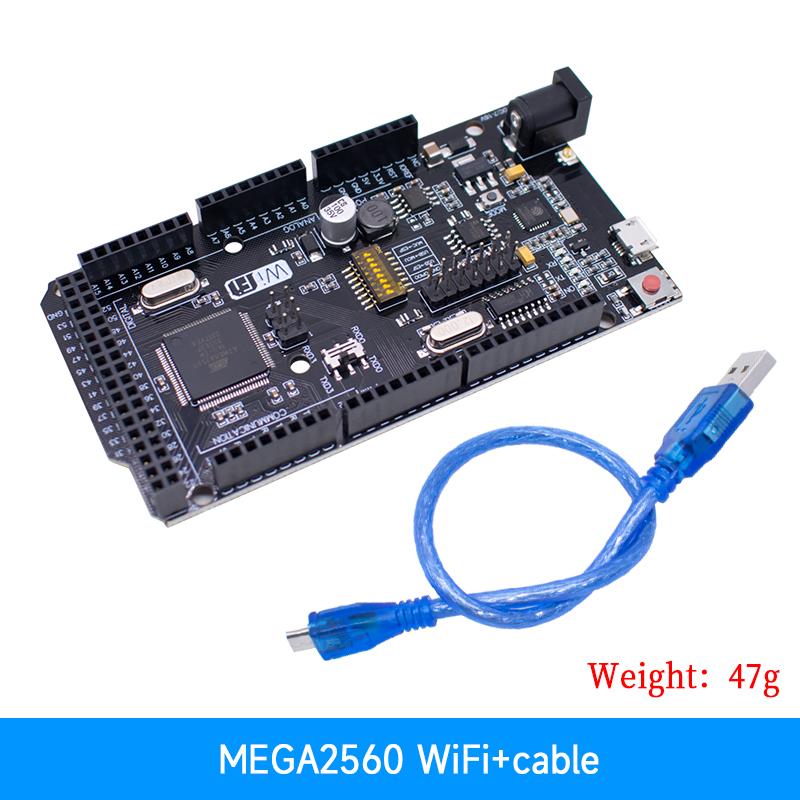
compras_projeto/fotos/CTR-01_capturado.jpg
