Brunobnhtr/projeto-integrador-camara-frigorifica/compras_projeto/fotos/ELE-04_capturado.jpg

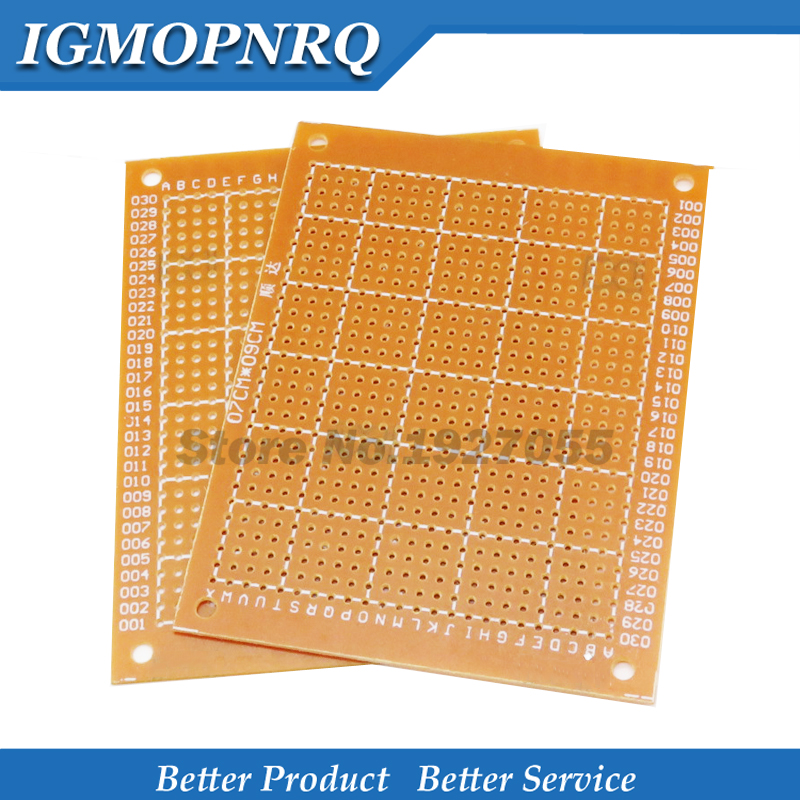
compras_projeto/fotos/ELE-04_capturado.jpg
