Brunobnhtr/projeto-integrador-camara-frigorifica/compras_projeto/fotos/POT-01_capturado.jpg

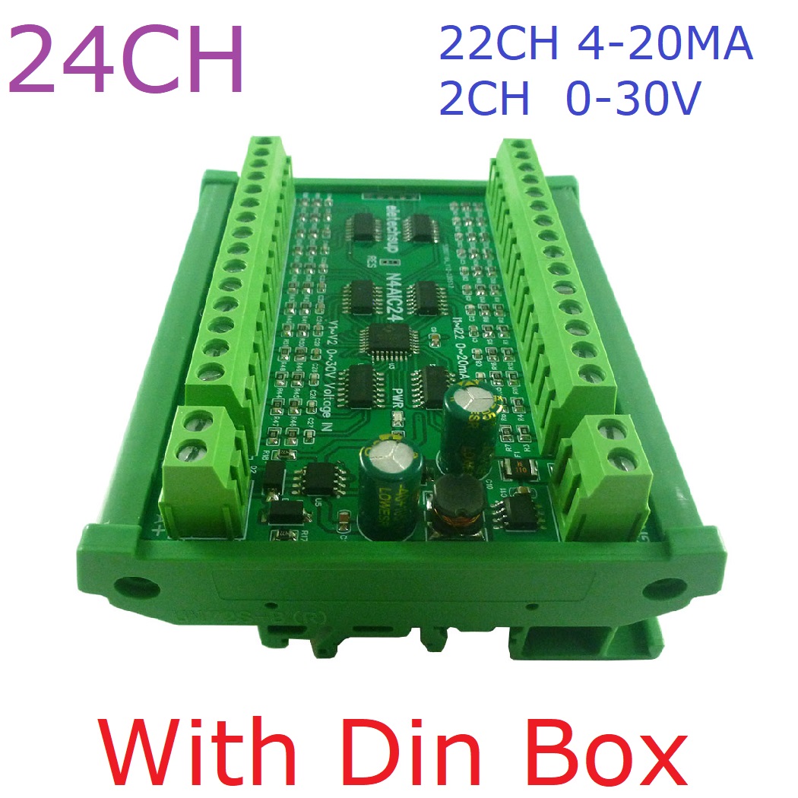
compras_projeto/fotos/POT-01_capturado.jpg
