Brunobnhtr/projeto-integrador-camara-frigorifica/compras_projeto/fotos/POT-04_capturado.jpg

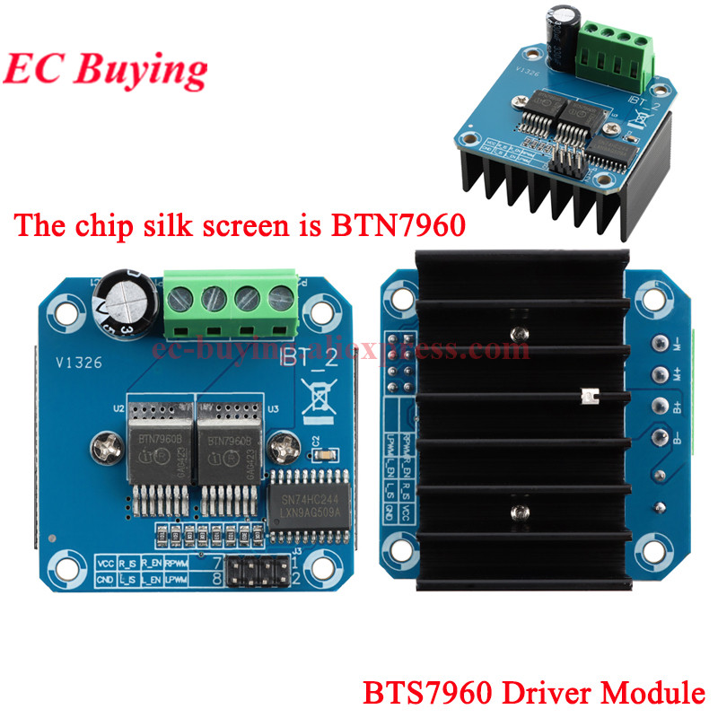
compras_projeto/fotos/POT-04_capturado.jpg
