Brunobnhtr/projeto-integrador-camara-frigorifica/compras_projeto/fotos/VED-03_capturado.jpg

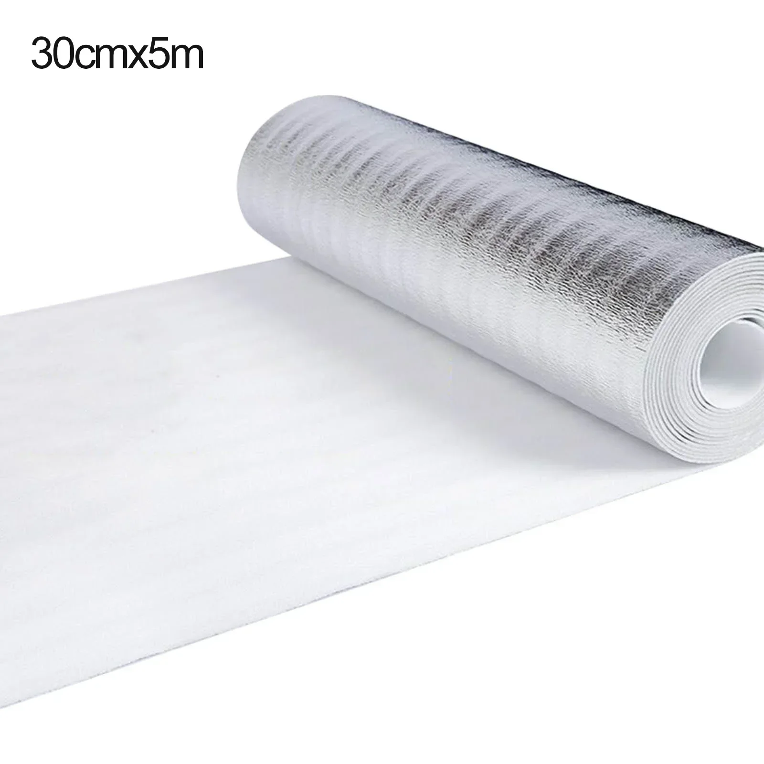
compras_projeto/fotos/VED-03_capturado.jpg
