Brunobnhtr/projeto-integrador-camara-frigorifica/compras_projeto/fotos/VED-04_capturado.jpg

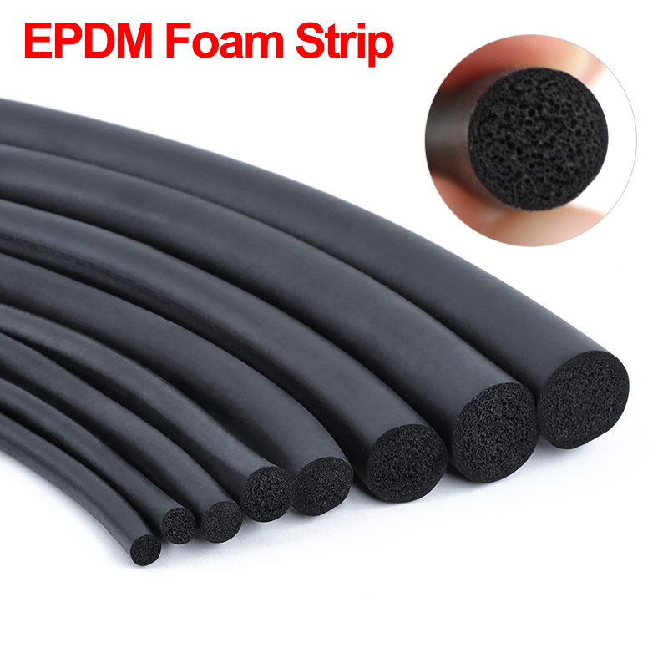
compras_projeto/fotos/VED-04_capturado.jpg
