Brunobnhtr/projeto-integrador-camara-frigorifica/desenhos/10_placa_pi1_circuito.png

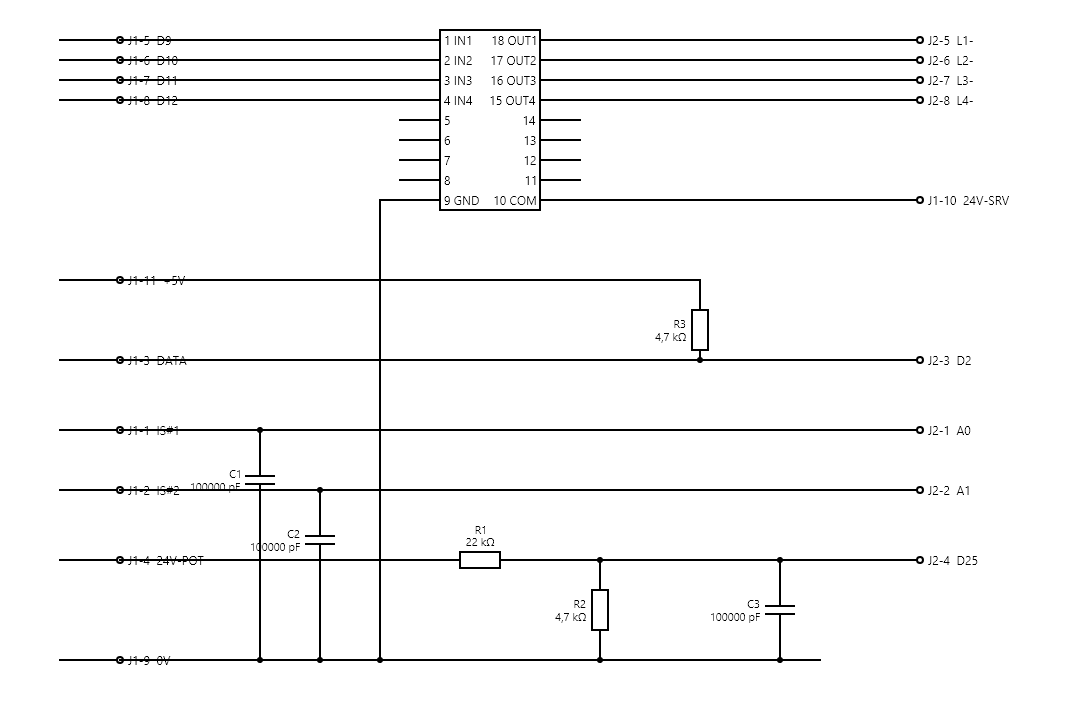
desenhos/10_placa_pi1_circuito.png
