Brunobnhtr/projeto-integrador-camara-frigorifica/imagens/rele ka1 e ka2.webp

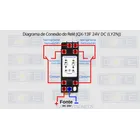
imagens/rele ka1 e ka2.webp
