Brunobnhtr/projeto-integrador-camara-frigorifica/painel_interativo/cad_corte/previas/CHAPA_acrilico_branco_3mm.png

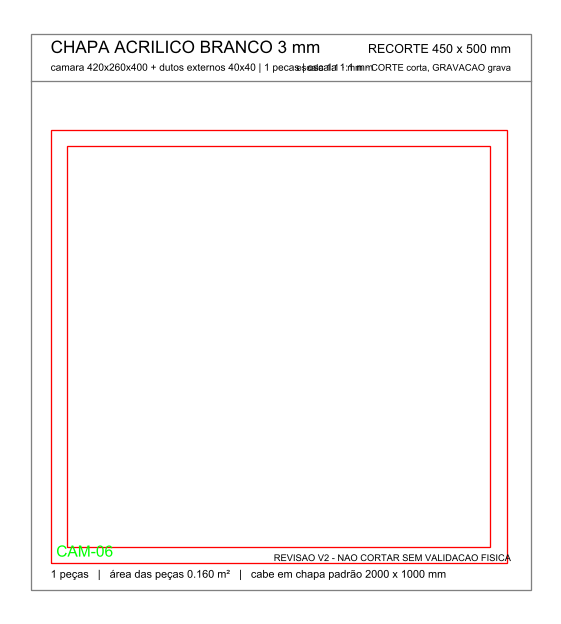
painel_interativo/cad_corte/previas/CHAPA_acrilico_branco_3mm.png
