Brunobnhtr/projeto-integrador-camara-frigorifica/painel_interativo/cad_corte/previas/CHAPA_acrilico_cristal_2mm.png

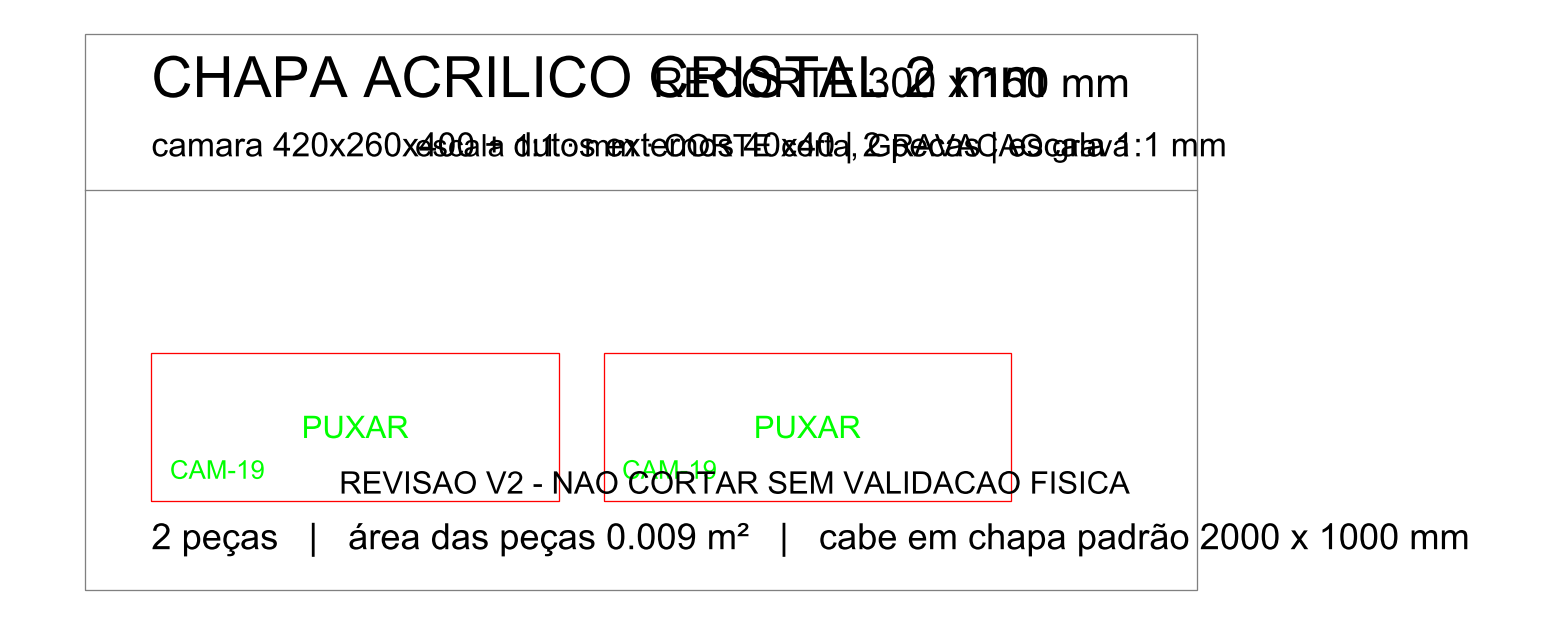
painel_interativo/cad_corte/previas/CHAPA_acrilico_cristal_2mm.png
