Brunobnhtr/projeto-integrador-camara-frigorifica/painel_interativo/cad_corte/previas/CHAPA_acrilico_cristal_5mm.png

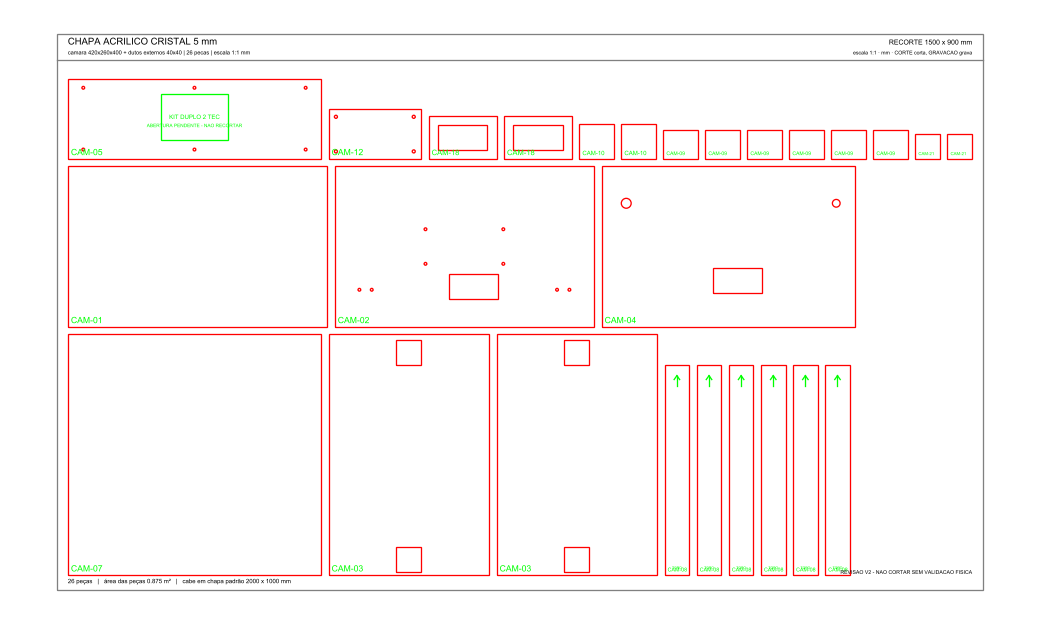
painel_interativo/cad_corte/previas/CHAPA_acrilico_cristal_5mm.png
