Brunobnhtr/projeto-integrador-camara-frigorifica/painel_interativo/cad_corte/previas/CHAPA_aluminio_3mm.png

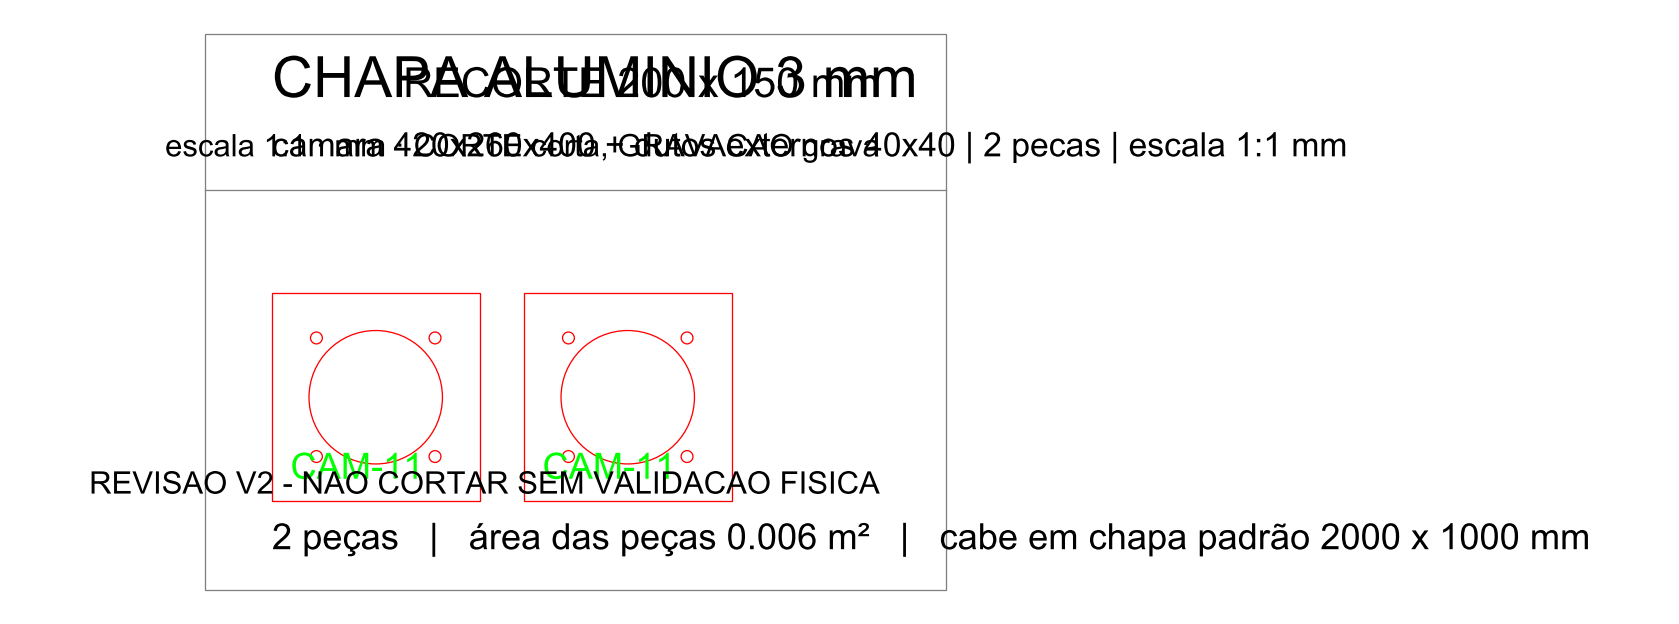
painel_interativo/cad_corte/previas/CHAPA_aluminio_3mm.png
