Brunobnhtr/projeto-integrador-camara-frigorifica/painel_interativo/cad_corte/previas/CHAPA_inox_1mm.png

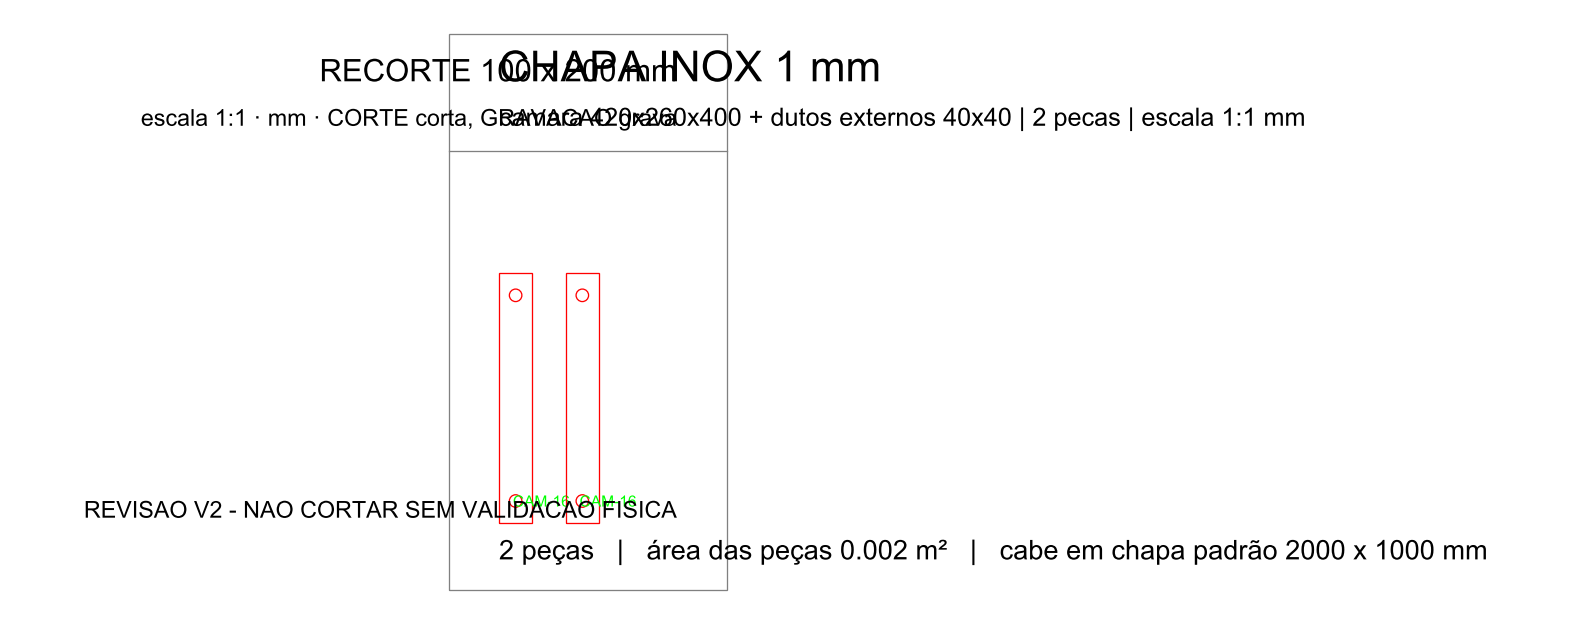
painel_interativo/cad_corte/previas/CHAPA_inox_1mm.png
