Brunobnhtr/projeto-integrador-camara-frigorifica/painel_interativo/cad_corte/previas/CHAPA_mdf_15mm.png

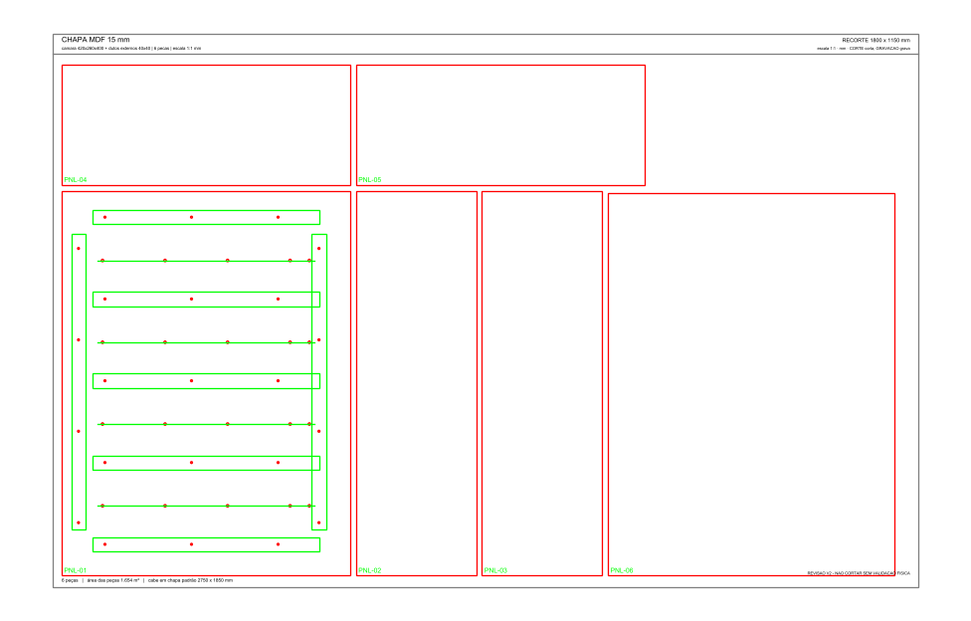
painel_interativo/cad_corte/previas/CHAPA_mdf_15mm.png
