Brunobnhtr/projeto-integrador-camara-frigorifica/painel_interativo/cad_corte/previas/CIRCULACAO_DE_AR_V8.png

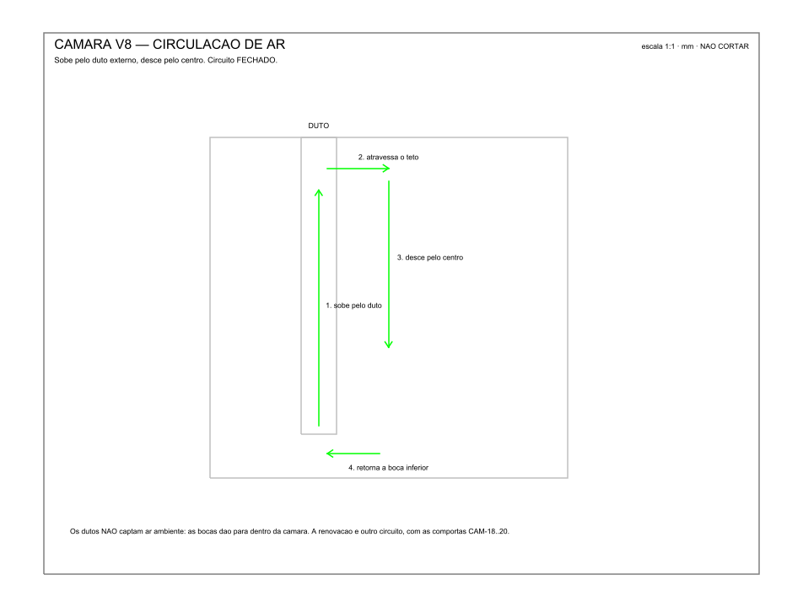
painel_interativo/cad_corte/previas/CIRCULACAO_DE_AR_V8.png
