Brunobnhtr/projeto-integrador-camara-frigorifica/painel_interativo/cad_corte/previas/CORTE_INTERNO_V8.png

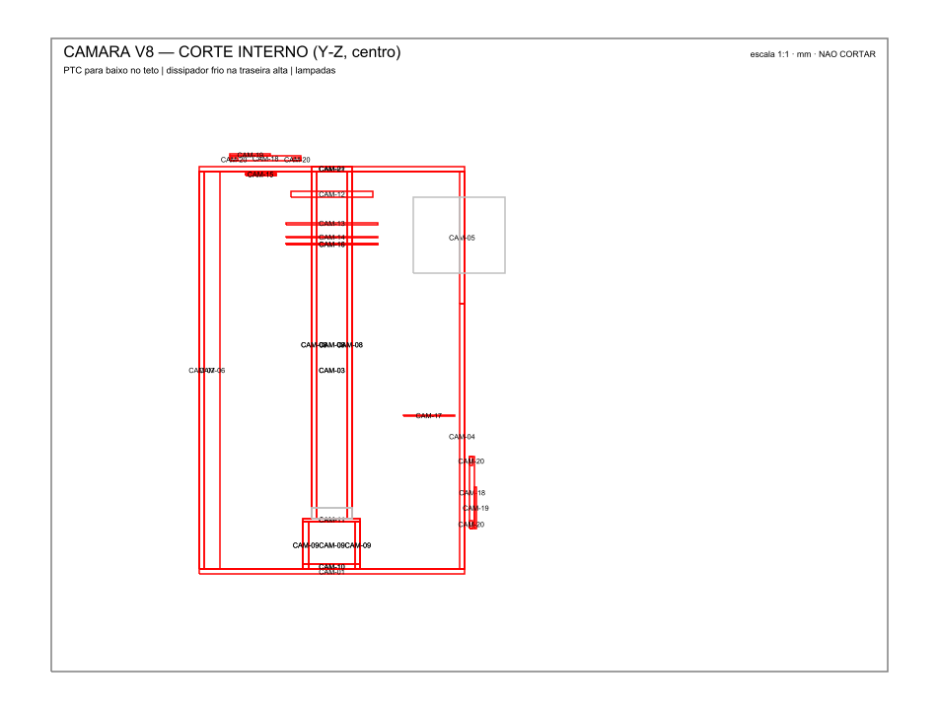
painel_interativo/cad_corte/previas/CORTE_INTERNO_V8.png
