Brunobnhtr/projeto-integrador-camara-frigorifica/painel_interativo/cad_corte/previas/DETALHE_LAMPADA_V8.png

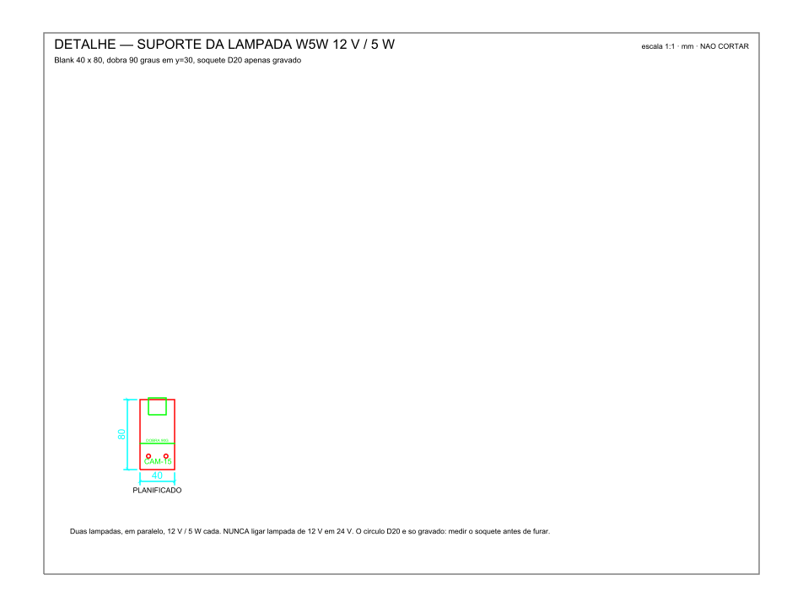
painel_interativo/cad_corte/previas/DETALHE_LAMPADA_V8.png
