Brunobnhtr/projeto-integrador-camara-frigorifica/painel_interativo/cad_corte/previas/DETALHE_VENTILACAO_V8.png

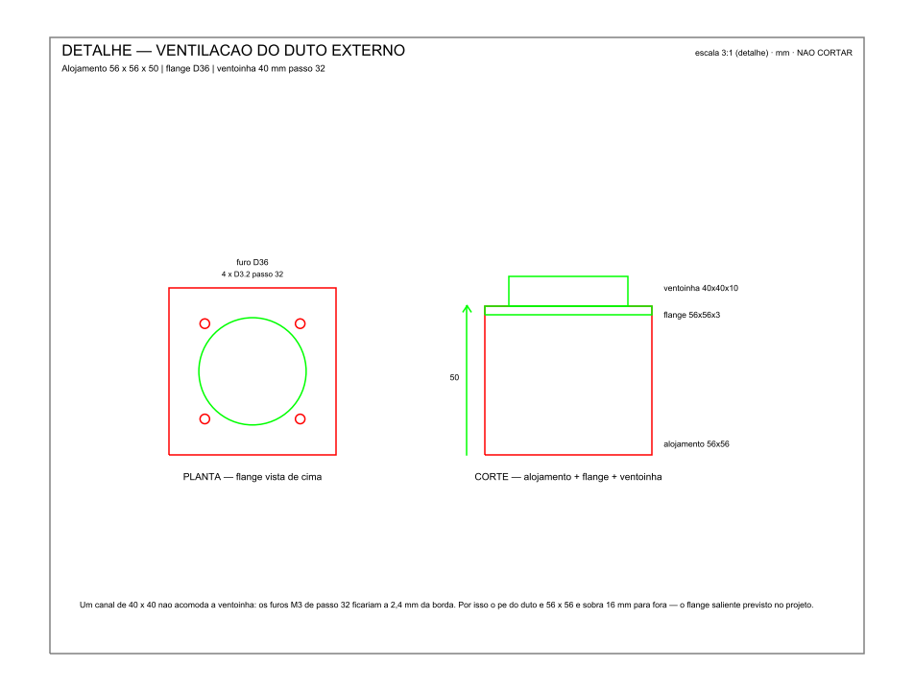
painel_interativo/cad_corte/previas/DETALHE_VENTILACAO_V8.png
