Brunobnhtr/projeto-integrador-camara-frigorifica/painel_interativo/cad_corte/previas/VISTA_FRONTAL_V8.png

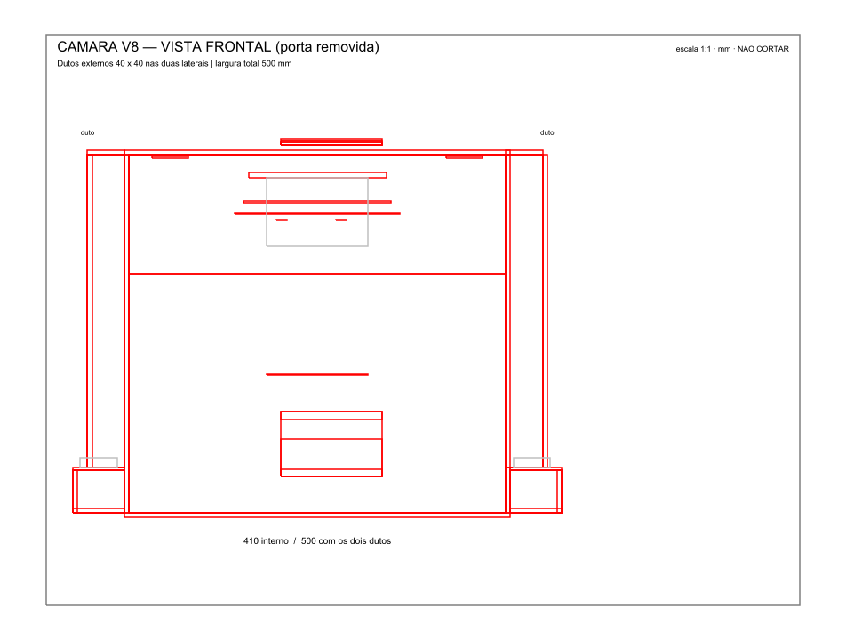
painel_interativo/cad_corte/previas/VISTA_FRONTAL_V8.png
