Brunobnhtr/projeto-integrador-camara-frigorifica/painel_interativo/cad_corte/previas/VISTA_PLANTA_V8.png

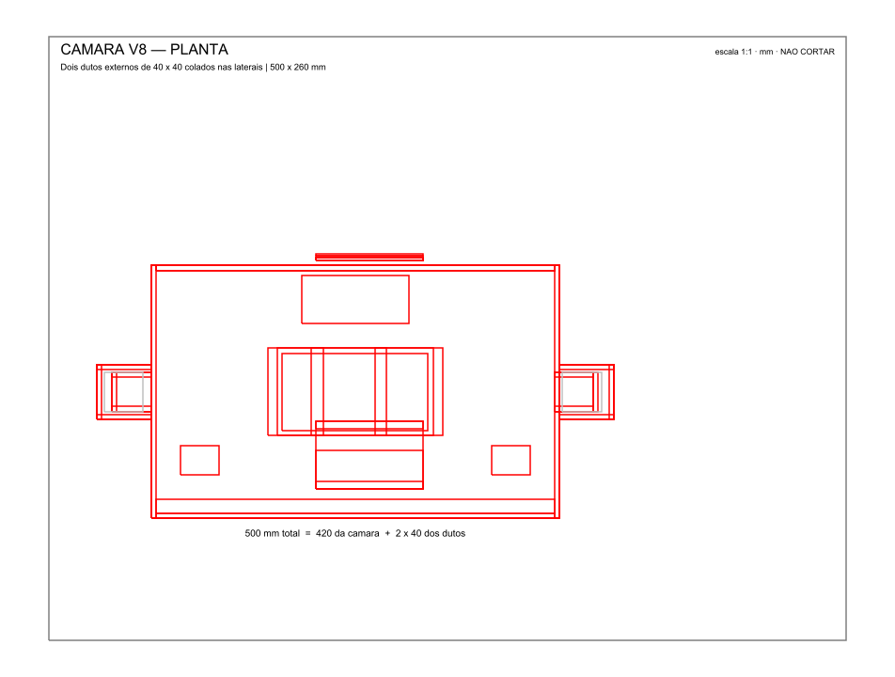
painel_interativo/cad_corte/previas/VISTA_PLANTA_V8.png
