Brunobnhtr/projeto-integrador-camara-frigorifica/painel_interativo/cad_corte/previas/VISTA_TRASEIRA_V8.png

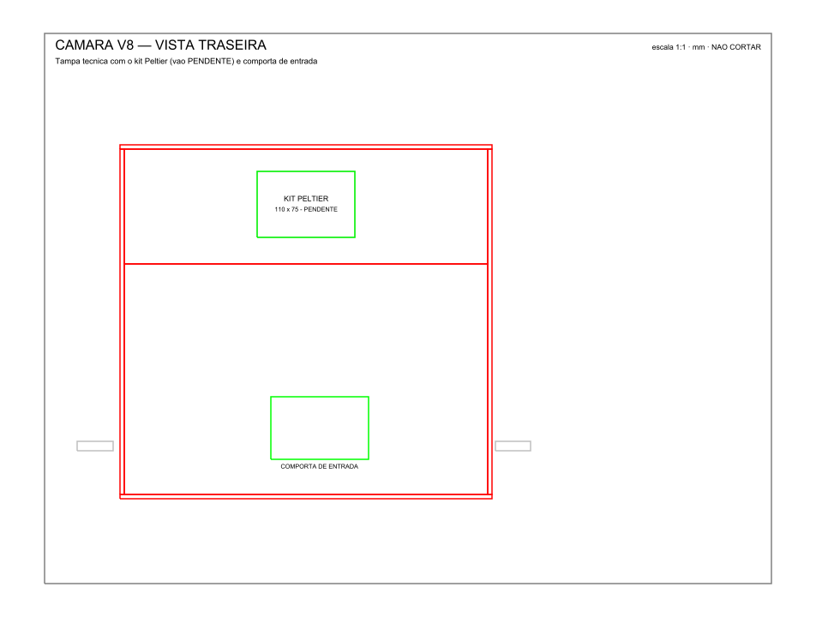
painel_interativo/cad_corte/previas/VISTA_TRASEIRA_V8.png
