Brunobnhtr/projeto-integrador-camara-frigorifica/painel_interativo/cad_corte/V12_SUPORTES_PTC_LAMPADAS_FANS_INTERNAS/BANDEJA_LAMPADAS_V12.png

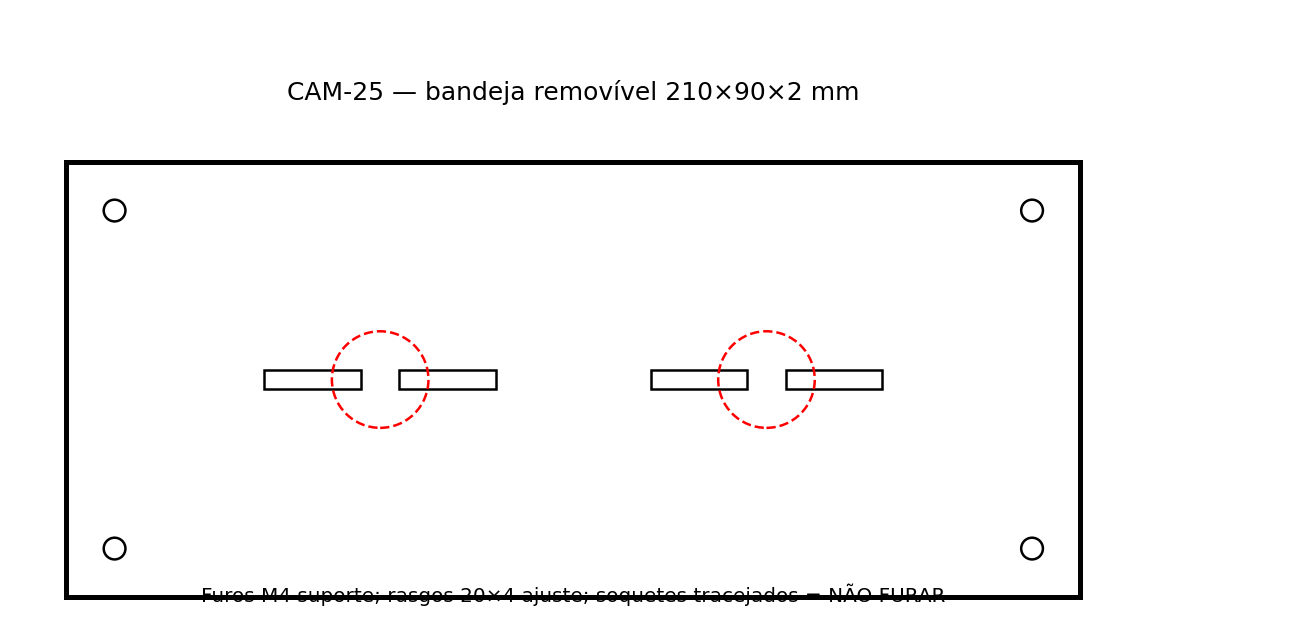
painel_interativo/cad_corte/V12_SUPORTES_PTC_LAMPADAS_FANS_INTERNAS/BANDEJA_LAMPADAS_V12.png
