Brunobnhtr/projeto-integrador-camara-frigorifica/camada_0_fundamentos/03_lista_materiais.md

# CAMADA 0 · Doc 03 — Lista de Materiais (BOM)

> ⚠️ **Revisão da sétima auditoria:** trechos do carrinho e tabelas de versões
> anteriores abaixo são históricos, não especificações de compra. A planilha
> regenerada reconcilia o painel com o modelo atual (700 × 700 × 250 mm,
> N4AIC24/Modbus, oito DUTs e sinaleiros de 5 V). ST-1 e ST-2 seguem bloqueados
> para compra; o PTC não está liberado para energização.

> ⛔ **Proposta provisória de potência — não comprar nem montar T2, T3 ou o PTC ainda.**
> A especificação pretendida é T2 24→5,0 V/5 A, T3 24→12 V/20 A e PTC 12 V/50 W.
> O modelo exato e as fichas, a tensão máxima/transientes de entrada de T2, o corte
> CC independente do PTC, F3 e bitolas ainda estão pendentes. As linhas correspondentes
> ficam fora da planilha de compra até a liberação técnica.

> A BOM está organizada **na ordem de construção (por camada)**, não por tipo de peça. Assim você compra o que precisa quando precisa, e não fica com R$ 800 em componentes parados esperando a maquete ficar pronta.
>
> 🔄 **Mudanças em relação à versão anterior:** a **fonte ATX saiu** (não tem 24 V — ver [Doc 02 §2.1](02_arquitetura_de_energia.md)); entraram a **fonte chaveada de 24 V**, os **conversores step-down**, o **disjuntor**, o **relé de interface KM1** e todo o material de cenografia da maquete.
>
> 🗂 **Revisão intermediária "Potência em 24 V" — registro histórico, substituído pela proposta provisória acima:**
>
> | Saiu | Entrou |
> |---|---|
> | ~~1× XL4016 (T1)~~ + ~~2× XL4015~~ + ~~kit LM2596~~ | **T2 e T3 provisórios, aguardando validação de modelo e ficha** |
> | ~~6× Diodo Zener (5V6 / 13 V / 15 V)~~ | **Decisão antiga baseada no LM2596; revisar as proteções quando T2/T3 forem identificados.** |
> | ~~2× porta-fusível (F4/F5)~~ + ~~fusíveis de saída~~ | A revisão retirou F4/F5; F1/F2/F3 e o novo ramal ainda exigem coordenação e dimensionamento |
> | ~~2× voltímetro 3 fios~~ (T2 e T3) | Decisão baseada nos LM2596 da revisão intermediária; não presumir display nos conversores atualmente propostos |
> | ~~Tubo PVC Ø 63 mm + tampas~~ + ~~cooler 30 mm do T1~~ | **Janelas de acrílico** nos tubos dos postes |
> | ~~1× Peltier~~ · ~~1× PTC 12 V antigo~~ · ~~1× cooler 80 mm~~ | **2× Peltier (série)** · **proposta PTC 12 V / 50 W, compra bloqueada** · **2× cooler 80 mm** |
>
> **Orçamento ainda não fechado.** T2/T3 e o ramal do PTC não têm modelos nem proteções aprovados; não considerar economias ou equivalência de custo até obter as fichas e dimensionar o conjunto.

---

## 🟢 Em palavras simples — como usar esta lista sem se perder

Esta é a **lista de compras** do projeto. Ela é longa, e isso assusta. Mas há três coisas que tornam ela fácil de usar:

**1. Ela está na ordem em que você vai construir, não por tipo de peça.**
Não procure "todos os resistores" — eles estão espalhados de propósito, cada um perto da etapa em que é usado. Você compra o que precisa quando precisa.

**2. Você não compra tudo de uma vez.** São 5 lotes:

| Lote | Quando | Por quê |
|---|---|---|
| **A** | Agora | Coisas que demoram a chegar. Se atrasar, atrasa o projeto inteiro |
| **B** | Agora também | Acrílico e MDF — a gráfica leva de 5 a 10 dias para cortar |
| **C** | Ao começar o painel | Não adianta ter borne com a caixa do painel ainda por fazer |
| **D** | Ao começar a fiação | Cabos e terminais |
| **E** | No fim | Tinta, figuras, acabamento |

**3. As colunas querem dizer isto:**

| Coluna | O que é |
|---|---|
| **Item** | O nome pelo qual procurar |
| **Qtd** | Quantos comprar — já inclui reservas onde faz sentido |
| **Especificação** | Os detalhes que **não podem** estar errados. É aqui que mora o motivo de o item ser aquele e não outro |
| **Link** | Deixado em branco de propósito, para você colar o anúncio escolhido |

> ⚠️ **Leia a coluna Especificação antes de comprar, sempre.** Muitos itens deste projeto têm um "sósia" mais barato que **não serve**. Exemplos: relé de 10 A que só vale 5 A em corrente contínua; PTC de 24 V/80 W no lugar da proposta provisória de 12 V/50 W (ainda bloqueada); fusível de 6 A onde precisa de 10 A. Todos parecem certos no anúncio.

### Os 6 erros de compra mais fáceis de cometer

Se você já tinha uma lista antiga em mãos, **confira estes seis antes de fechar o pedido**:

| ⚠️ | Item | O erro |
|---|---|---|
| 1 | **Peltier** | Comprar 1. São **3** (2 em uso + 1 reserva), do mesmo lote |
| 2 | **PTC** | Proposta atual: **12 V / 50 W**; confirmar modelo e proteções. **Não comprar enquanto bloqueado** |
| 3 | **Cooler externo 80 mm** | Comprar 1. São **2**, e os dois com **3 fios** |
| 4 | **Fusível F1** | Comprar 6 A. Tem que ser **10 A** |
| 5 | **Fio rígido** | Comprar fino. **Vermelho 1,00 mm²** e **azul 1,50 mm²** |
| 6 | **Fonte** | Comprar a de 150 W. **Só a de 240 W atende** |

### Dicionário rápido de compras

| Termo no anúncio | O que quer dizer |
|---|---|
| **Trilho DIN** | Barra metálica padrão onde os componentes do painel encaixam. Tudo "DIN" encaixa nela |
| **Borne** | Peça onde o fio é preso com parafuso. Organiza e permite desmontar |
| **Step-down** | Abaixa a tensão |
| **CC / CV** | Corrente Constante / Tensão Constante — modos de ajuste de um conversor |
| **NA / NF** | Contato Normalmente Aberto / Normalmente Fechado |
| **Bivolt / auto-range** | Funciona em 110 e 220 V sem chavinha |
| **Terminal tubular (ilhós)** | Ponteira que se crimpa na ponta do fio antes de parafusar. **Obrigatório** em painel |
| **3 fios** (num cooler) | Tem o fio extra que informa a rotação. O projeto **depende** disso |

---

## 🛒 Carrinho de 19/08/2026 — registro histórico, não usar para compras

> 📌 **Esta seção é o retrato do carrinho real, com os preços do dia.** Ela existe porque
> conferir anúncio contra projeto é o momento em que os erros de compra aparecem — e aqui já
> apareceram seis.

### Registro do que foi considerado correto naquela revisão (histórico; não comprar)

| Item no carrinho | R$ | No projeto é | Conferir ao receber |
|---|---:|---|---|
| ~~Módulo sensor de tensão DC 0-25 V (5 pçs)~~ | 16,07 | ~~SV-1 — vigia analógica do 24 V~~. **Obsoleto; não comprar.** A tensão de BD-POT é medida pelo V1 do N4AIC24 via Modbus RTU/RS-485. | |
| Sensor WCS2702 ajustável | 25,41 | ⭐ **SC-1** — detector de dispositivo morto | Que tenha **furo de passagem** para o fio (é por ele que entram as 10 voltas) |
| Conversor de nível lógico 4 canais I²C | 10,44 | **CONV** — 5 V ↔ 3,3 V entre Mega e ESP32 | Bidirecional, com os dois lados alimentados |
| BTS7960 ponte-H 43 A (2 pçs) | 20,96 | **BTS1 e BTS2** | Barra de pinos com `R_EN`, `L_EN`, `R_IS`, `GND` |
| LM2596 com display (2 pçs) | 21,16 | Proposta antiga para **T2/T3**, substituída pelas especificações provisórias atuais; não comprar | Modelo e ficha técnica pendentes |
| Módulo relé 1 canal 5 V (2 pçs) | 6,79 | **KA1** (veto), **KA2** e **KA3** (ventoinhas) — ⚠️ **compre 2 pares**: são 3 em uso | ⭐ **"5VDC" no corpo do relé** e jumper em **H** |
| AM2315C I²C | 68,59 | Sensor de temperatura e umidade da câmara | Endereço 0x38, não conflita com o RTC (0x68) |
| ESP32-WROOM-32U DevKitC | 31,72 | **ESP32** — MQTT e dashboard | Versão **U** = conector de antena externa ✔ |
| Antena 2,4 GHz RP-SMA + cabo U.FL→SMA + flange | 42,00 | A antena do ESP32, do lado de **fora** da caixa | ⚠️ **RP-SMA e SMA não encaixam entre si** — confira que antena e flange são o mesmo padrão |
| Aquecedor PTC 24 V com ventilador | 78,08 | Proposta antiga de PTC, substituída pela proposta provisória de **12 V/50 W**; não comprar | Modelo, corte DC e proteções pendentes |
| DS18B20 à prova d'água, cabo 1 m | 6,90 | Sonda do dissipador (1-Wire) | ⚠️ **VEJA O ALERTA ABAIXO** |

### ⚠️ Os seis pontos de atenção do carrinho

**1 · O DS18B20 do carrinho parece ser só a sonda — e o projeto precisa do adaptador.**
O anúncio fala em sonda de aço com cabo de 1 m, e não menciona a plaquinha de terminais. É o
**adaptador** que traz o **pull-up de 4,7 kΩ** — o resistor sem o qual o sensor não responde
([Doc 33 §33.4](../camada_3_eletrica/33_placa_interface_componentes.md)). Duas saídas:

- comprar o **kit com adaptador** (`DS18B20 waterproof kit adapter terminal`), ou
- comprar 1 resistor de 4,7 kΩ e ligá-lo entre `DATA` e `+5 V` no borne — funciona igual.

⭐ **De qualquer forma, meça ao receber:** ohmímetro entre `DATA` e `VCC`, procurando ~4,7 kΩ.

**2 · As placas de ensaio (R$ 64,39) e os bornes KF128 (R$ 16,48) não são mais necessários.**
Elas eram para a PI-1 e a PI-2 — **as duas deixaram de existir**. O que sobrou de solda no
projeto é a placa simuladora do DUT, que cabe num pedaço de 30 × 40 mm.

| | Carrinho | Necessário |
|---|---:|---:|
| Placas de ensaio | R$ 64,39 (conjunto 5×7, 7×9, 9×15 cm) | uma sobra qualquer, ou a menor do conjunto |
| Bornes KF128 (2 anúncios) | R$ 16,48 | nenhum — os bornes agora são de **trilho DIN** |

💰 **Economia possível: ~R$ 65**, comprando só a placa menor.

**3 · Os dois módulos DIN de fusível/distribuição podem cobrir mais de um item da lista.**

| Item no carrinho | R$ | Pode substituir |
|---|---:|---|
| Módulo de distribuição DC para trilho DIN, com divisora de fusíveis e interruptor | 55,39 | Parte dos blocos **BD-** e o porta-fusível **F-P** |
| Módulo de interface de fusível DIN 2–15 canais (5×20 mm) | 52,66 | Os fusíveis de ramal **F1, F2, F3** e o **F-P** |

⚠️ **Confira ao receber, antes de comprar bloco de distribuição separado:** quantas saídas tem
cada um, se cada saída tem fusível próprio, e a corrente máxima. O projeto precisa de **6
barramentos** (BD-24V, BD-POT, BD-5V, BD-AUX e os dois blocos de 0 V) e de **4 fusíveis**
(F1 10 A, F2 2 A, F3 2 A e o F-P de 100 mA). Se os dois módulos cobrirem isso, saem itens da
lista; se não, eles complementam.

**4 · ⭐ O adaptador DIN do Mega (R$ 113,71) VIROU REQUISITO — era listado como opcional.**
O `DNMEGA1` põe o Arduino no trilho e transforma cada pino num borne de parafuso. Ele sempre foi
o que a decisão de **não soldar nada no painel** pressupõe — e o modelo do painel já o assumia
(82 bornes, 134 × 96 mm), enquanto esta lista o chamava de conforto. **A contradição acabou:**

- os capacitores `C1` e `C2` moram nos bornes `A0`–`GND2` e `A1`–`GND2` do próprio adaptador
  ([Doc 33 §33.10](../camada_3_eletrica/33_placa_interface_componentes.md));
- sem ele, os pinos do Mega são headers fêmea: não há parafuso onde prender a perna do capacitor,
  e voltaria a ser preciso um bloco de bornes só para isso — com o componente pendurado no ar.

💰 **O que ele devolve:** os 3 bornes do BS-1, os fios `S5`, `S6` e `D20`, e 24 mm do trilho 3.

**5 · Os 6 filamentos COB LED de 3 V não estão no projeto.**
São R$ 70 em filamentos de letra, DC 3 V. Se forem para letreiro ou iluminação cenográfica da
maquete, tudo bem — mas ⚠️ **eles são de 3 V**: ligados direto no BD-5V queimam. Cada um precisa
de resistor em série (`(5 − 3) ÷ 0,02 = 100 Ω`) ou de fonte própria. E, se entrarem na maquete,
**entram no balanço do BD-5V** ([Doc 02](02_arquitetura_de_energia.md)) — hoje ele já está com
12 de 14 saídas usadas.

**6 · 🗑️ O módulo MOSFET de 4 canais (R$ 43,51) SAIU do projeto — não feche este item.**
Ele era o **MV-1**, e ficou prestando **um** serviço: ligar e desligar as 5 ventoinhas internas.
12 V, 0,63 A, **uma comutação por ensaio**, num pino (`D29`) que **nem PWM tem** — e um MOSFET
só se paga quando é preciso modular ou comutar milhares de vezes por hora.

| | MV-1 (MOSFET 4 canais) | **KA3 (módulo de relé)** |
|---|---:|---:|
| Preço | R$ 43,51 | **R$ 3,40** |
| Canais usados | 1 de 4 | 1 de 1 |
| Chaveia | o **negativo** (canal N de lado baixo) | ⭐ o **positivo**, contato seco |
| Espaço no trilho | 66 mm | cabe na caixa dos outros dois relés |

💰 **O que muda no pedido:** tire o módulo MOSFET, compre **2 pares** de módulo de relé de 1 canal
(R$ 13,58 pelos 4, com 1 de reserva) e troque a caixa DIN de 4M pela de **6M**. Economia líquida de
**~R$ 33**. Justificativa completa em [Doc 31 §31.16](../camada_3_eletrica/31_comando_e_protecoes.md).

### 🔎 O que ainda falta comprar

Nada disso aparece no carrinho, e tudo é necessário para montar:

| Falta | Qtd | Onde entra |
|---|---:|---|
| ⭐ **Sinaleiro 22 mm de 5 V** | 4 | RUN, COOL, HEAT, FALHA — acesos direto pelo pino do Arduino |
| **Bornes de passagem DIN 2,5 mm²** | 4 | 🔧 **Só reservas** — o BS-1 saiu: os capacitores foram para os bornes do próprio Mega ([Doc 33 §33.10](../camada_3_eletrica/33_placa_interface_componentes.md)) |
| **Blocos de distribuição DIN** | ver ponto 3 | BD-24V, BD-POT, BD-5V, BD-AUX, BD-0V e BD-0V-B |
| **Botoeira cogumelo com trava** | 1 | **S0** — a emergência |
| **Botoeiras 22 mm** (verde e preta) | 2 | S1 LIGAR · S2 STOP |
| **Relé 24 V 14 pinos HH64P / LY4NJ + base PTF14A** | 1 | KM1 *(Peltier 24 V + PTC 12 V + Selo)* |
| **RTC DS3231** | 1 | Data e hora do log |
| **Capacitor cerâmico 100 nF** | 4 | C1 e C2 + reservas |
| **Resistores** ¼ W | ~10 | 2× 10 kΩ (BTS) · 3× 10 kΩ (pull-down dos KA1/KA2/KA3) · 4× 220 Ω (postes) · 1,2 kΩ (DUT) + reservas |
| **Diodo 1N4007** | 4 | D1 (bobina do KM1), D2 (ventoinhas do radiador) e D3 (ventoinhas internas) + reserva |
| **LED 3 mm branco** | 4 | Iluminação dos postes |
| **Fusíveis** | A revisar | F1 e F-P conforme circuito; F2/F3 e o ramal novo do PTC sem liberação |
| **Trilho DIN, canaleta, caixa do painel, cabo e anilhas** | — | A infraestrutura do painel ([Doc 20](../camada_2_painel/20_painel_projeto_e_layout.md)) |

---

## Índice de compras por prioridade

| Lote | Quando comprar | Itens | Custo estimado |
|---|---|---|---|
| **Lote A** | Após liberar componentes de potência | Itens sem pendência técnica; **não comprar T2, T3 nem PTC** até aprovar modelos e proteção | Recalcular |
| **Lote B** | Junto com o A | Estrutura da maquete e acrílico (gráfica leva 5–10 dias) | ~R$ 450 |
| **Lote C** | Ao iniciar a Camada 2 | Painel, trilho DIN, bornes, botoeiras | ~R$ 350 |
| **Lote D** | Ao iniciar a Camada 3 | Cabos, terminais, canaleta, fusíveis | ~R$ 200 |
| **Lote E** | Por último | Cenografia, tintas, figuras, acabamento | ~R$ 200 |

> Valores são ordem de grandeza para orçamento (Mercado Livre / lojas de material elétrico, 2026). Preencha a coluna **Link** com o anúncio escolhido.

---

## 🌏 Comprando no AliExpress — o que muda no planejamento

A planilha gerada tem uma coluna **🌏 AliExpress** com busca pronta **em inglês** (termo em português não acha quase nada por lá). Mas importar muda três coisas no projeto, e a mais perigosa não é o preço.

### 1. ⏱️ O prazo é o risco real — não o preço

| Origem | Prazo típico |
|---|---|
| Mercado Livre / loja local | 2 a 7 dias |
| **AliExpress** | **20 a 60 dias** |
| AliExpress com "Envio do Brasil" | 5 a 15 dias (mais caro, estoque limitado) |

> ⚠️ **Um pedido feito hoje pode chegar depois da entrega do projeto.** Faça a conta ao contrário: **data da apresentação − 60 dias = último dia para pedir.** Se essa data já passou, compre nacional e pare de discutir preço.

### 2. 🔁 Não existe devolução prática — compre reserva

Se um componente chegar morto, errado ou nunca chegar, **você não recebe outro a tempo**. Isso muda a lógica de quantidades:

| Componente | Reserva | Por quê |
|---|---|---|
| Peltier | **+1** (já na lista: 3) | É o que mais queima, e queima por erro de montagem |
| LM2596 | **+1 kit** | São os únicos conversores do projeto |
| BTS7960 | **+1** | Sem ele não há acionamento |
| ~~ULN2803~~ | ~~+1~~ | 🗑️ saiu do projeto com os sinaleiros de 5 V |
| DS18B20 | **+1** | É o sensor que fecha a malha de controle |
| ESP32 | **+1** | É o protagonista do edital |
| Arduino Mega | **+1** (já na lista: 2) | Roda o PID, o intertravamento e as proteções |

> 💡 **A regra:** se o item **para o projeto** quando falha, e vem do exterior, compre dois. A diferença de custo é de poucos reais; a diferença de risco é o projeto inteiro.

### 3. 💰 O preço do anúncio não é o preço final

Importação para pessoa física tem **imposto**, e as regras mudam com frequência. Trate o valor anunciado como **base**, não como total, e **confira as regras vigentes** antes de fechar o pedido.

> 📌 **Regra prática de orçamento:** reserve **+40 % sobre o valor do anúncio** para imposto e frete. Se sobrar, ótimo. Se você orçar pelo preço do anúncio, vai faltar.

### 4. ⚡ O que NÃO importar — e este é um argumento de norma

O edital exige *"garantir conformidade com normas de segurança elétrica"*. Componentes que fazem parte da **cadeia de proteção** precisam ser certificados, e produto de importação direta não traz certificação INMETRO.

| Comprar **NACIONAL** (certificado) | Por quê |
|---|---|
| **Disjuntor 2P 6 A curva C** | É a proteção da entrada em 127 V. Certificação não é detalhe |
| **Fonte chaveada 24 V / 240 W** | Faz a barreira entre 127 V e a parte SELV. Além disso é pesada — frete inviabiliza |
| **Relé KM1** | Aqui você **vê o produto, tem nota fiscal e consegue trocar** se vier errado. Importado, um relé sem marca chega em 40 dias e sem recurso — e relé é peça de segurança, no caminho crítico da montagem |
| **Porta-fusíveis, trilho DIN, canaleta, bornes** | Baratos aqui, volumosos para importar |
| **Cabos e terminais** | Peso e volume |
| **MDF, acrílico, tintas, cenografia** | Óbvio |

| Comprar **IMPORTADO** (vale muito a pena) | Economia típica |
|---|---|
| Peltier, PTC de 24 V, LM2596, BTS7960, sensores e módulos | 3× a 5× mais barato |
| ESP32, Arduino, tela ES3C28P, sensores, módulo RTC | 2× a 4× |
| Coolers, dissipadores, botoeiras 22 mm, sinaleiros | 2× a 3× |

> ✅ **A planilha já faz essa separação sozinha:** o link do AliExpress só aparece nos itens que faz sentido importar. **Item sem link de AliExpress é recomendação de compra nacional, não falha do gerador.**

### 5. 📦 Estratégia de pedido

1. **Divida em 2 pedidos** com vendedores diferentes. Se um travar na alfândega ou sumir, você não fica sem nada.
2. **Priorize o que tem prazo longo E é insubstituível**: PTC de 24 V, Peltier, LM2596.
3. **Prefira vendedores com muitas vendas e avaliação alta**, mesmo custando um pouco mais.
4. **Tire foto de tudo ao abrir** — é a sua única prova se algo vier errado.
5. **Teste cada componente assim que chegar**, ainda dentro do prazo de reclamação. Não deixe para descobrir na montagem que o módulo veio morto.

> 🎯 **O item mais crítico para pedir cedo é o PTC de 24 V.** No mercado nacional ele é raro; no AliExpress é comum, mas com o prazo longo. **Ele define a sua data-limite de pedido.**

---

# 🔌 SISTEMA DE ENERGIA (o coração da refatoração)

## E.1 — Subestação: entrada AC e fonte principal

| Item | Qtd | Especificação | Busca sugerida | Link |
|---|---:|---|---|---|
| **Fonte chaveada 24 Vcc** | 1 | **24 V / 10 A / 240 W**, bivolt 110-220 V (chave seletora ou auto-range). Modelo tipo **S-240-24** | `fonte chaveada 24v 10a 240w` | |
| **Disjuntor DIN 2P 6 A curva C** | 1 | Bipolar, 6 A, curva C (por causa do inrush da fonte), 3 kA | `disjuntor bipolar 6a curva c din` | |
| ~~Chave rotativa 0-1 22 mm~~ | ~~1~~ | **REMOVIDA do projeto.** O disjuntor Q0 acumula proteção e chave geral. ⚠️ Por isso ele precisa ficar **acessível por fora** da casa de comando: monte atrás de uma tampa com recorte, como num quadro de luz | `chave seletora 2 posicoes 22mm` | |
| Cabo PP 3×1,5 mm² + plugue | 1,5 m | Cabo de entrada AC com plugue 2P+T 10 A | `cabo pp 3x1,5 com plugue` | |
| Prensa-cabo PG9 / PG13 | 3 | Entrada e saída de cabos da caixa da subestação | `prensa cabo pg9` | |
| Borne DIN 4 mm² | 6 | Distribuição 24 V e 0 V na subestação | `borne trilho din 4mm parafuso` | |
| **Cooler 60 mm 24 V** | 1 | Exaustão da **casa de comando** (~29 W de perda da fonte). ⚠️ **Obrigatório, não opcional** — a casinha encolheu para 250 × 150 × 90 mm e a fonte continua dissipando o mesmo. ⚠️ **24 V**: é a única tensão de saída disponível. Alternativa: 2× de 12 V **em série** | `cooler 60mm 24v` | |
| Grade + filtro 60 mm | 1 | Veneziana de entrada de ar da subestação | `grade cooler 60mm com filtro` | |

> ⚠️ **A CASA DE COMANDO deve ser fechada e aparafusada.** É o único lugar do projeto com 127 V AC. Sinalize com etiqueta **"PERIGO — 127 V CA"** na tampa.
>
> 🔄 **A subestação é um PÁTIO ABERTO** (cercado, com brita), com uma **casa de comando** fechada dentro dele — como numa subestação real ao tempo. Só a fonte, o disjuntor e a chave ficam trancados; os fusíveis de 24 V ficam **visíveis no pátio**. Ver [Doc 11 §11.3](../camada_1_maquete/11_subestacao_e_postes.md).

## E.2 — Conversores de tensão (os "transformadores" da maquete)

| Item | Qtd | Especificação | Ajuste | Link |
|---|---:|---|---|---|
| **T2 — conversor 24 V → 5 V / 5 A (25 W)** | 1 | **PROPOSTA · NÃO COMPRAR.** Saída fixa 5,0 V. Exigir ficha do modelo exato e confirmar Vin máximo acima da tensão máxima real da fonte e transientes; verificar dissipação, proteção e entrada segura da placa Arduino | `conversor buck 24v 5v 5a ficha tecnica` | |
| **T3 — conversor 24 V → 12 V / 20 A (240 W)** | 1 | **PROPOSTA · NÃO COMPRAR.** Ficha do modelo exato deve comprovar operação contínua, faixa de entrada, térmica, proteção e capacidade em 5,49 A ou mais | `conversor buck 24v 12v 20a ficha tecnica` | |
| Kit LM2596 reserva | — | ~~Removido da arquitetura proposta~~ | — | |
| **Acrílico transparente 1 mm** | 1 lâmina | Janelas dos postes somente se o conversor escolhido tiver display e a decisão de exibição for mantida; modelo ainda pendente | — | |
| **Voltímetro + amperímetro digital 3 fios** | 1 | **Único medidor comprado à parte** — vai na caixa de derivação do **P1**, mostrando os 24,0 V do barramento e **a corrente das Peltier ao vivo**. Faixa: 0-100 V / 10 A | — | |

> ⛔ Os links e especificações dos LM2596 acima pertencem ao projeto anterior. A proposta nova ainda não tem modelos aprovados; não inferir proteção, corrente contínua ou segurança a partir do anúncio.

> 📌 As janelas e a demonstração do display pertencem ao kit LM2596 anterior. Não fabricar os recortes antes de selecionar os conversores novos.

## E.3 — Proteção do sistema de energia

| Item | Qtd | Especificação | Aplicação | Link |
|---|---:|---|---|---|
| Porta-fusível mini automotivo | 3 | **Fusível de LÂMINA (automotivo)**, não de vidro. Trilho DIN 35 mm **ou** bloco parafusado — ver nota abaixo | **F1, F2, F3** — entrada dos 3 ramais, **na subestação** | |
| *Alternativa:* **bloco de 3 posições para fusível lâmina** | 1 | Substitui os 3 suportes acima. ⚠️ Conferir: **fusível lâmina** · **≥ 10 A por posição** · **≥ 32 Vdc** · preferir **entrada comum** (1 entrada + 3 saídas). Parafusa na parede da caixa — dispensa trilho DIN na subestação | idem | |
| **Fusível mini automotivo 10 A** | 2 | 1 uso + 1 reserva | **F1** — ramal RM1 (potência 24 V, 6,0 A) | |
| Fusível mini automotivo 2 A | 3 | 1 uso + 2 reservas | **F2** (comando); F3 para T3 está pendente de dimensionamento e não é item liberado | |
| Terminal olhal M4 amarelo | 10 | Aterramento e barramento de 0 V | — | |

> ⚠️ **F1 subiu de 6 A para 10 A.** O ramal de potência agora conduz 6,0 A contínuos em 24 V; um fusível de 6 A abriria em operação normal. **Confira antes de comprar** — é o erro mais fácil de cometer copiando a lista antiga.

> ### ⚠️ Os 3 ramais são TODOS de 24 V — confusão comum
>
> É natural olhar "3 ramais" e pensar "24 V, 12 V e 5 V". **Não é isso.** No ponto onde ficam os fusíveis, os três conduzem **24 V**:
>
> ```
> FONTE 24 V
>     ├──[F1 10A]──► R1 · 24 V ──► poste P1 ──► 24 V DIRETO ──► BTS/Peltier
>     ├──[F2  2A]──► R2 · 24 V ──► poste P2 ──► [LM2596] ──► 5,10 V
>     └──[F3  2A]──► R3 · 24 V ──► poste P3 ──► [LM2596] ──► 12,0 V
>          ▲                                       ▲
>     tudo 24 V aqui                  é AQUI que a tensão muda
> ```
>
> **O que difere entre os ramais é a CORRENTE, não a tensão.** O R1 leva 6,0 A (as duas Peltier); R2 e R3 levam menos de 1 A cada. Por isso F1 é de 10 A e os outros de 2 A.
>
> ### 📍 E eles ficam na SUBESTAÇÃO, não no painel
>
> Na saída da fonte de 24 V, dentro da caixa fechada. O motivo é a função: eles protegem **a linha que atravessa a maquete pelos postes**. Se ficassem no painel, justamente o trecho mais longo e mais exposto do projeto ficaria sem proteção.
>
> É o mesmo princípio da chave fusível real: ela fica **no poste, na origem do ramal** — não na casa do consumidor.

> ### 🔩 Lâmina ou vidro? Use LÂMINA
>
> | Tipo | Corrente do suporte | Serve para o F1 (10 A)? |
> |---|---|---|
> | **Lâmina (automotivo)** ✅ | ~30 A por posição | **Sim, com folga** |
> | Vidro 5 × 20 mm | 5 A ou 6,3 A | ❌ **Não** |
> | Vidro/cerâmico 6 × 30 mm | 15–20 A | Sim, mas ver abaixo |
>
> **Três motivos para a lâmina, além da corrente:**
> 1. **É projetada para corrente contínua de 12 a 32 V** — exatamente o nosso barramento de 24 Vdc. Fusível de vidro é pensado para 250 V **AC**; funciona aqui, mas fora da aplicação natural.
> 2. **2 A e 10 A são valores padrão de linha** — acha em qualquer auto peças.
> 3. **O corpo é translúcido**: dá para ver o elemento queimado sem instrumento. Num projeto didático isso vale ponto na apresentação.

> 🗑️ **Os 6 diodos Zener e os fusíveis F4/F5 saíram do projeto.** O circuito *crowbar* existia para proteger contra a falha do conversor em curto; o LM2596 já traz **limite de corrente e desligamento térmico no próprio CI**, e o barramento que mais preocupava (os 12 V de potência do T1) deixou de existir. Resultado: **8 componentes a menos**, nenhum deles em fio volante. O raciocínio completo está em [Doc 02 §2.6](02_arquitetura_de_energia.md), inclusive o risco residual que se está aceitando.
>
> ✅ **O que NÃO saiu:** os fusíveis de **entrada** dos ramais (F1, F2, F3). Eles nunca foram parte do crowbar — são a seletividade da rede de distribuição, o equivalente à chave fusível do poste, e continuam obrigatórios.

---

# 🏭 CAMADA 1 — MAQUETE

## M.1 — Base e estrutura

| Item | Qtd | Especificação | Link |
|---|---:|---|---|
| MDF 12 mm | 1 chapa | **1500 × 500 mm** — tampo da base | |
| MDF 15 mm | — | Moldura perimetral 40 mm de altura (4 tiras) | |
| MDF 15 mm | 3 tiras | **Travessas de reforço** 15 × 40 mm, com entalhe de 20 × 25 mm no centro | |
| Pés de borracha antiderrapante | 8 | Autoadesivos, Ø 25 mm — a base tem 1,5 m e pesa ~18 kg | |
| **Conector circular GX16 8 pinos** | 1 par | **Opcional** — só na versão modular (união elétrica entre os 2 módulos) | |
| Pinos-guia Ø 6 mm + buchas | 2 | **Opcional** — alinhamento dos módulos | |
| Alças de transporte | 2 | Alça embutida de baú/case, laterais | |
| Parafusos M5×20, M4×16, M3×12 | kits | Fixações gerais | |
| Insertos rosqueados M4/M5 p/ MDF | 20 | Evita espanar a rosca no MDF | |

## M.2 — Subestação (caixa)

| Item | Qtd | Especificação | Link |
|---|---:|---|---|
| MDF 9 mm ou acrílico opaco 4 mm | — | **CASA DE COMANDO 250 × 150 × 90 mm** (L×P×A), face de operação voltada para a rua. Abriga **apenas** fonte, disjuntor e chave — os fusíveis de 24 V ficam no pátio aberto | |
| **Fio verde-amarelo 0,75 mm²** | 1 m | ⚡ **Aterramento das estruturas metálicas do pátio** à barra de terra (equipotencialização). Torre real é aterrada — vale ponto na defesa | |
| *Opcional:* **arame / barra de latão 1,5–2 mm** | 2 m | Estruturas treliçadas do pátio. ⚠️ **Latão aceita solda de estanho; alumínio não** — se quiser treliça soldada, é latão | |
| Dobradiça pequena + fecho | 1 jogo | Tampa de manutenção | |
| Tela metálica / alambrado miniatura | 1 | Cerca do pátio (tela de aço, malha 3 mm). ⚠️ **Funcional, não decorativa**: com o pátio aberto, é ela que delimita a área e impede aproximação — mesma função da cerca de uma subestação real | |
| Pedrisco / brita fina (aquário) | 500 g | Piso do pátio da subestação — como nas subestações reais | |
| Placa "PERIGO ALTA TENSÃO" | 2 | Impressa em papel adesivo, ~15 × 10 mm | |

## M.3 — Postes e linha de distribuição

| Item | Qtd | Especificação | Link |
|---|---:|---|---|
| **Tubo de alumínio Ø 8 mm** | 1,5 m | Cortar em 3 postes de **350 mm** (300 mm visíveis + 50 mm de encaixe) | |
| Barra chata de alumínio 12 × 2 mm | 40 cm | **Cruzetas** — 3 peças de 90 mm + 3 de 60 mm | |
| **Fio rígido ENCAPADO 1,00 mm² VERMELHO** ⬆ | 2 m | Ramal **R1** (potência, **6,0 A**). ⚠️ Subiu de 0,75 para 1,00 mm² por causa da corrente das 2 Peltier. **Nunca condutor nu** — em CC qualquer ponte metálica é curto franco | |
| **Fio rígido ENCAPADO 0,50 mm² MARROM** | 2 m | Ramal **R2** (comando) | |
| **Fio rígido ENCAPADO 0,50 mm² CINZA** | 2 m | Ramal **R3** (auxiliares) | |
| **Fio rígido ENCAPADO 1,50 mm² AZUL CLARO** ⬆ | 2 m | **Retorno comum 0 V** — o "neutro" da linha, 40 mm abaixo da cruzeta. Subiu de 1,00 para 1,50 mm²: conduz a **soma** dos 3 ramais (7,11 A) | |
| Contas/miçangas marrom ou branca Ø 6 mm | 20 | **Isoladores** de pino da cruzeta | |
| **Tubo de PVC Ø 50 mm** | 24 cm | Corpos dos 3 postes — 8 cm cada: **T2** (P2), **T3** (P3) e a **caixa de derivação** (P1). Agora os três têm o mesmo diâmetro, porque o P1 deixou de ter conversor | |
| Tampa/cap PVC Ø 50 mm | 6 | Tampas dos 3 corpos | |
| Cinta de alumínio 10 mm | 1 m | Fixação dos transformadores e da caixa de derivação nos postes | |
| **Bornes de emenda pequenos (2 ou 3 vias)** | 2 | Dentro da **caixa de derivação do P1** — ali os 24 V só se distribuem, não se transformam | |
| Flange/base de fixação dos postes | 3 | Podem ser feitas com sobra de MDF + insertos M4 | |
| Etiquetas adesivas impressas | 3 | Identificação dos corpos: **"P1 — DERIVAÇÃO 24 V"**, **"T2 — 24/5 V"**, **"T3 — 24/12 V"** | |

> 🔎 **O poste P1 não tem transformador — e isso é proposital.** Como as Peltier e o PTC já operam em 24 V, não há tensão a transformar naquele ramal: o corpo do P1 é apenas uma **caixa de derivação** com bornes e o medidor de tensão/corrente. Vale a etiqueta e vale explicar na defesa, porque é a analogia mais bonita que a maquete ganhou: **consumidor industrial de grande porte é atendido na tensão primária da rede e monta a própria subestação**, enquanto os consumidores comuns recebem o transformador de poste. P1 é o grande consumidor; P2 e P3 são os transformadores de distribuição.

## M.4 — Rua e entrada da empresa (zona externa)

| Item | Qtd | Especificação | Link |
|---|---:|---|---|
| Tinta spray **cinza-asfalto escuro fosco** | 1 | Pista da rua | |
| **Tubo de alumínio Ø 5 mm** | 60 cm | 3 postes de **iluminação pública** de 180 mm — ⚠️ diferentes dos postes de distribuição | |
| Arame 1,5 mm | 1 m | Braço curvo das luminárias e estrutura do portão | |
| **LED 3 mm branco quente** | 4 | 3 luminárias da rua + 1 na guarita. **Alimentados em 5 V** (BD-5V), com 220 Ω em série, sempre acesos. Vf ≈ 3,1 V | |
| **Resistor 220 Ω 1/4 W** | — | Limitador dos LEDs da rua — **já contabilizado na lista L.4**, não compre de novo. ⚠️ Valor dimensionado para **5 V**: `(5 − 3,1)/220 = 8,6 mA`. Monte cada um **dentro da base do poste**, com termorretrátil | |
| **Carro de passeio miniatura 1:50** | 2 | ~88 mm. Se só achar 1:64 (68 mm), pode usar — mas não misture escalas | |
| **Caminhão / van 1:50** | 1 | ~150 mm, entrando pelo portão | |
| Tira de MDF 3 mm | 1,5 m | **Meio-fio (guia)**, 4 mm de altura, pintado de branco | |
| Fita branca 2 mm ou caneta posca branca | 1 | Faixa central tracejada, faixa de bordo e faixa de pedestres | |
| MDF 4 mm | — | **Muro da empresa**: 50 mm de altura × 290 mm, em X = 640 | |
| MDF 4 mm | — | **Guarita** 45 × 45 × 55 mm, com janela recortada | |
| Tinta azul industrial | 1 | Portão corrediço | |
| Árvores de maquete | 3 | Escala 1:50, na calçada da frente | |
| Placas de trânsito miniatura | 2 | "PARE" e "VELOCIDADE MÁXIMA 10 km/h" | |
| Lixeira urbana + abrigo de ônibus | 1 cada | Opcional — enriquece a cena | |

> 🎬 **A rua é o que explica de onde vem a energia.** Sem ela, a subestação e os postes ficam "flutuando no nada". E o **muro com portão** marca o limite: à esquerda, via pública e rede da concessionária; à direita, a instalação do consumidor — que é o que o painel comanda.

## M.5 — Chão de fábrica (cenografia)

| Item | Qtd | Especificação | Link |
|---|---:|---|---|
| Tinta spray cinza claro fosco | 2 | Piso industrial (epóxi) | |
| Tinta spray preto fosco | 1 | Estruturas e acabamento | |
| Verniz fosco spray | 1 | Proteção final do piso pintado | |
| **Fita adesiva amarela 10 mm** | 1 rolo | Demarcação de corredores e áreas | |
| **Fita zebrada amarelo/preto 20 mm** | 1 rolo | Faixa de segurança em frente ao painel (**exigência NR-10** — zona de trabalho) | |
| Fita adesiva verde 10 mm | 1 rolo | Rota de fuga | |
| Figuras de maquete escala **1:50** | 10 | (4 na fábrica, 3 na rua, 3 reservas) Pessoas com EPI (loja de maquetaria/arquitetura) | |
| Miniaturas: empilhadeira, pallets, tambores | — | Ambientação do chão de fábrica | |
| Extintor miniatura + placa | 2 | Sinalização de segurança | |
| Placas de sinalização impressas | 1 folha | "RISCO ELÉTRICO", "USO OBRIGATÓRIO DE EPI", "SAÍDA" — papel adesivo | |
| **Eletrocalha / perfilado aéreo** | 60 cm | Canaleta de acrílico ou perfil U de alumínio — leva os cabos do painel à câmara **por cima**, como na indústria | |
| Suportes/mãos-francesas da eletrocalha | 4 | Cantoneira de alumínio | |
| EVA ou MDF 6 mm | — | Bases de máquinas fictícias e plataformas | |

---

# ❄️ CAMADA 1 — CÂMARA TÉRMICA

## C.1 — Acrílico (levar a lista para a gráfica — corte a laser)

> ⚠️ **REVISÃO V7 — esta tabela está duplamente superada.** Ela descreve o envelope
> **V4** (câmara de 5,25 L), que por sua vez já foi substituído pela V6 (40,8 L) e
> agora pela **V7** (15,0 L). A lista válida hoje é
> [`cad_corte/LISTA_FERRAGENS_E_MATERIAIS_V7.md`](../cad_corte/LISTA_FERRAGENS_E_MATERIAIS_V7.md),
> gerada a partir dos dois CSV de corte:
>
> | | V7 |
> |---|---|
> | Câmara | **300 × 200 × 250 internos (15,0 L)**, corpo de 310 × 205 × 260 |
> | Peças | **36 físicas em 22 modelos + 6 de isolamento** |
> | Acrílico 5 mm | 0,475 m² (chapa de 1150 × 700) |
> | Isopor EPS 1 mm | 0,364 m² |
> | Painel | 600 × 800 × 250, 6 peças de MDF 15 mm (1,59 m²) |
>
> Use a tabela abaixo **só como histórico** do que já foi comprado na V4.

| Peça | Espessura | Dimensão | Qtd | Observação |
|---|---|---|---:|---|
| Parede lateral ESQ / DIR | 5 mm transp. | 110 × 250 mm | 2 | Recorte 90 × 210 mm (duto), bordas 45° |
| Parede traseira | 5 mm transp. | 210 × 250 mm | 1 | Bordas 45° + **2 furos Ø 16 mm para prensa-cabo**, um no canto inferior e outro no superior, ⚠️ **afastados ≥ 100 mm** |
| Tampa topo | 5 mm transp. | 210 × 110 mm | 1 | Recorte das 2 Peltier |
| Base externa | 5 mm transp. | 210 × 110 mm | 1 | 🔧 **Sem furos** — o dreno saiu do projeto |
| Base interna (apoio do PTC) | 5 mm transp. | 190 × 90 mm | 1 | Bordas 90° |
| **Porta — vidro externo** | 5 mm transp. | 210 × 250 mm | 1 | **Porta dupla (ver §C.3)** |
| **Porta — vidro interno** | 5 mm transp. | 190 × 230 mm | 1 | **Porta dupla** |
| **Porta — moldura espaçadora** | 10 mm transp. | tiras 10 mm | 4 | Perímetro da porta, cria a câmara de ar |
| Dutos: frente | 3 mm transp. | 30 × 210 mm | 2 | Bordas 45° |
| Dutos: laterais | 3 mm transp. | 30 × 210 mm | 4 | Borda traseira 90° |
| Dutos: tampas topo/base | 3 mm transp. | 30 × 30 mm | 4 | Borda traseira 90° |
| Cobertura externa | 3 mm **branco** | conforme §C.2 | 5 | **Branco** = visual de painel PIR de câmara frigorífica real |
| Cubinhos de apoio | sobra 5 mm | 20 × 20 × 30 mm | 4 | Sustentam a base interna (plenum de 30 mm) |

> 🎨 **Mudança de acabamento:** a cobertura externa passou de **preto** para **branco**. Câmaras frigoríficas reais são feitas de painel sanduíche PIR com face de aço branco — o visual fica imediatamente reconhecível como "câmara fria" dentro da fábrica.

## C.2 — Isolamento térmico

| Item | Qtd | Especificação | Link |
|---|---:|---|---|
| ~~XPS 30 mm~~ | ~~1 m²~~ | 🔧 **REMOVIDO.** O vão de 30 mm que ele ocupava fica **com ar**, e a fita de alumínio nas duas faces o transforma em barreira de radiação. Custa **3 pontos de duty** (41 % → 44 %) e economiza a chapa inteira. Ver [Doc 12 §12.2](../camada_1_maquete/12_camara_termica.md) | |
| ⭐ **Fita adesiva de alumínio 50 mm** | **3 rolos** | 🔧 **Virou o isolamento E a superfície externa da câmara.** Reveste toda a caixa por fora e sela **todas** as juntas coladas do acrílico. Com ε ≈ 0,05 ela mais que dobra a resistência de superfície (0,13 → 0,31 m²·K/W). ⚠️ **Barreira de vapor é a função mais importante dela** — quanto menos vapor entra, mais a sílica dura e menos gelo se forma | |
| ~~Espaçadores de 30 mm~~ | — | 🔧 **REMOVIDOS junto com a cobertura externa.** Eles só existiam para manter o vão de ar aberto | |
| Manta elastomérica autoadesiva 6 mm | 1 m² | Tipo Armaflex — cantos, arestas e ao redor das passagens de cabo | |
| Espuma expansiva PU (mini) | 1 | Selagem das passagens de cabo | |

## C.3 — Vedação, porta e condensado

| Item | Qtd | Especificação | Link |
|---|---:|---|---|
| **Perfil EPDM tubular autoadesivo 9 × 6 mm** | 2 m | Vedação da porta — perfil **tubular** comprime muito melhor que o chato de 5 mm | |
| Dobradiça piano de alumínio | 1 | 250 mm (cortar de uma barra de 75 cm) | |
| **Fecho de pressão (borboleta) inox** | 2 | Comprime a vedação — tipo fecho de baú | |
| Puxador de câmara fria (miniatura) | 1 | Estética — pode ser um puxador de móvel pequeno | |
| Cola S-320 Sinteglas | 250 ml | Colagem de acrílico por capilaridade | |
| Silicone neutro transparente | 1 tubo | Vedação de juntas (⚠️ **neutro**, o acético ataca o acrílico) | |
| ⭐ **Bandeja de alumínio REMOVÍVEL** | 1 | ~190 × 90 mm, **sem furo** — desliza para fora para esvaziar. 🔧 Era fixa e inclinada, com dreno | |
| ⭐ **Tubo de silicone Ø 4 mm** | 40 cm | **RESPIRO**, enrolado em espiral dentro da câmara. ⚠️ **Não é opcional:** resfriar de 25 para 5 °C contrai o ar 6,7 % e, numa câmara bem vedada, isso dá **34 kgf puxando a porta para dentro**. O caminho longo e estreito equaliza a pressão e quase não deixa vapor passar | |
| ⭐ **Sílica gel indicadora** | **4 sachês** | 3 na câmara + 1 dentro da câmara de ar da porta dupla. Azul → rosa = trocar. Regenera no forno a 120 °C por 2 h | |
| ~~Tubo Ø 6 mm, sifão e frasco coletor~~ | — | 🔧 **REMOVIDOS.** São **~1 grama de água** numa apresentação inteira (§12.6) — a bandeja removível dá conta | |

---

# ⚡ CAMADA 2 — PAINEL DE COMANDO

| Item | Qtd | Especificação | Link |
|---|---:|---|---|
| Caixa de comando ou MDF | 1 | **500 × 500 × 200 mm** — comprada pronta ou feita em MDF 15 mm | |
| Porta do painel | 1 | MDF 12 mm ou acrílico fumê 5 mm (fica bonito ver os LEDs) | |
| **Trilho DIN 35 mm** | 1,5 m | Aço galvanizado — 3 trilhos de ~360 mm | |
| **Canaleta perfurada 30 × 30 mm** | 3 m | Com tampa. **Placa de montagem:** 4 horizontais + 2 verticais ≈ 2,8 m | |
| ⭐ **Canaleta perfurada 25 × 25 mm** | 2 m | **PORTA** — 5 horizontais + 1 vertical na dobradiça ≈ 1,5 m. Mais estreita que a da placa porque a porta tem menos fio e não pode ficar pesada | |
| ⭐ **Espiral organizador Ø 12 mm** | 40 cm | A **passagem flexível** entre a placa e a porta. Protege o chicote nos ciclos de abertura | |
| **Bloco de distribuição DIN** — 1 entrada 4 mm² + **4 saídas** | 1 | **BD-POT** — 24 V de potência comutados pelo KM1 → BTS #1, BTS #2, medição do D25 e 1 reserva. ⚠️ Cai com a emergência | |
| **Bloco de distribuição DIN** — 1 entrada 2,5 mm² + **4 saídas** | 1 | **BD-AUX** — 12 V auxiliar (do T3): cooler dos BTS + 2 coolers das Peltier + 1 reserva | |
| **Bloco de distribuição DIN** — 1 entrada 2,5 mm² + **6 saídas** | 1 | **BD-24V** — 24 V permanentes. São **3 cargas** (DNLCB30/ESP32, cadeia de comando e a alimentação das 2 posições de ensaio) + 3 reservas. ⭐ **Duas saídas ficaram livres** quando os sinaleiros passaram para 5 V: elas levavam o positivo comum das lâmpadas e o COM do o driver dos sinaleiros, que saiu. **Não confundir com o BD-POT** — este não cai com a emergência | |
| **Bloco de distribuição DIN** — 1 entrada 2,5 mm² + **8 saídas** ⬆ | 1 | **BD-5V** — ⚠️ **Subiu de 6 para 8:** são **7 cargas** (Arduino, tela ES3C28P, RTC, lógica do BTS #1, lógica do BTS #2, placa PI-1 e os LEDs da maquete) + 1 reserva | |
| ⭐ **Barra de distribuição / régua com pente — mín. 20 pontos** ⬆⬆ | 1 | **BD-0V** — o **star ground** do projeto. ⚠️ **Um bloco de 8 saídas NÃO serve:** aqui convergem **4 entradas + ~16 retornos**. Use uma **barra de neutro/terra de 16–20 furos** em suporte DIN, ou **dois blocos de 1×8 interligados** por ponte de 4 mm². Entrada de **10 mm²** | |

> ### ⚠️ Conferência de saídas — feita cabo a cabo no [Doc 30](../camada_3_eletrica/30_forca_e_distribuicao.md)
>
> | Bloco | Cargas reais | Comprar | Antes |
> |---|---:|---:|---:|
> | BD-POT | 3 | **4** | 4 ✅ |
> | BD-AUX | 3 | **4** | 4 ✅ |
> | BD-24V | **5** | **6** | 4 ❌ faltava |
> | BD-5V | **7** | **8** | 6 ❌ faltava |
> | BD-0V | **~20** | **20** | 8 ❌❌ faltava muito |
>
> **Por que o BD-0V é tão maior que os outros:** ele é o único bloco por onde passa **tudo**. Cada carga do projeto tem um positivo (que sai de um bloco diferente conforme a tensão) mas **todas dividem o mesmo retorno**. Somando as 4 entradas e os retornos de BTS, relés, Arduino, ESP32, tela ES3C28P, RTC, PI-1, três coolers, LEDs e posições de ensaio, passa de 20 pontos.
>
> ✅ **A troca da tela já está contabilizada.** A ES3C28P substituiu a Nextion **e** o módulo de cartão SD, mas ocupa a mesma saída de 5 V que a Nextion ocupava — e o RTC continua existindo. **O BD-5V segue com 7 cargas e o BD-24V com 5.** O DNLCB30 e o ESP32 de IoT permanecem.
| Bornes DIN parafuso 2,5 mm² | 6 | Passagem e reservas | |
| Separadores/tampas de borne | 4 | Acabamento das réguas | |
| **Alternativa mais barata:** bornes comuns + **ponte de interligação (pente)** | — | Funciona igual aos blocos, custa menos, menos prático para alterar depois | |
| Identificadores de borne e de cabo | 1 kit | Anilhas numeradas — **exigido em painel industrial** | |
| Trava-fim de trilho DIN | 8 | Impede os componentes de deslizarem | |
| **Botão de Emergência cogumelo 22 mm** | 1 | Com trava (girar p/ destravar) — **2 blocos NF** (1 para o comando 24 V, 1 para a leitura do Arduino) | |
| **Botão START / LIGAR 22 mm** | 1 | **Verde**, momentâneo — **1 bloco NA de 24 V**. ⭐ Fica na **cadeia de comando**, refazendo o selo do KM1: é ele que traz os 24 V de volta ao BD-POT depois de um STOP. **Não é lido por pino nenhum.** ⚠️ Etiquete-o como `LIGAR` — o `INICIAR ENSAIO` é o da tela | |
| **Botão STOP 22 mm** | 1 | Preto, momentâneo — **1 NF de 24 V + 1 NA de 5 V**. O NF fica **dentro da malha do selo do KM1**, em série com o do cogumelo, e corta a potência de verdade, retendo; o NA avisa o `D23` | |
| **Blocos de contato 22 mm avulsos** | 3 | **3 NF**: emergência (2 NF) e STOP (1 NF). ⭐ O NA de 5 V do STOP e o NA de 24 V do LIGAR vêm com as próprias botoeiras. Ver [Doc 31 §31.6](../camada_3_eletrica/31_comando_e_protecoes.md) | |

> ### ⭐ A porta: TRÊS botoeiras e a tela
>
> **EMERGÊNCIA (vermelho) · STOP (preto) · LIGAR (verde)**, mais a IHM.
>
> ⭐ **Um selo só, e um botão só para refazê-lo:**
>
> | | cai com | refeito por |
> |---|---|---|
> | Selo do **KM1** | EMERGÊNCIA · STOP · trip do KA1 · falta de energia | **LIGAR verde** |
>
> 🔧 **O botão azul de REARME saiu daqui**, junto com o **segundo relé de selo**. Ele existia para refazer esse selo, e depois dele ainda era preciso apertar o verde — dois botões para a mesma decisão. Hoje destravar o cogumelo devolve tensão à malha e o verde religa, que é exatamente o que a ISO 13850 pede: soltar o atuador não religa; religar é um ato deliberado. **E some junto o erro mais caro do painel, que era trocar os dois selos entre si.**
>
> 🔧 **A seletora LOCAL / REMOTO continua fora**, e não volta: era a segunda camada de uma regra que a primeira já garante sozinha — *o `START` nunca é aceito por MQTT*. Libera o pino **D26**.

| **Chave seccionadora 24 V no painel** | 1 | Rotativa 2 posições 22 mm — chave geral local da máquina. ⚠️ **Não confundir com a antiga seletora LOCAL/REMOTO, que foi removida** | |
| **Sinaleiros LED 22 mm ⭐ 5 V** | 4 | Verde (RUN), Azul (COOL), Amarelo (HEAT), Vermelho (FAULT). ⭐ **5 V, e não mais 24 V** — cada um é aceso DIRETO por um pino do Arduino (D9 a D12), sem CI, sem relé e sem resistor externo: o resistor já vem dentro do sinaleiro. ⚠️ **Confirme ~20 mA no anúncio e MEÇA ao receber** (passo A-02) — 20 mA é o limite recomendado do pino do Mega. O vermelho de FALHA continua aceso na emergência porque quem o segura é o Arduino, alimentado pelo BD-5V, que não cai | |
| **Prensa-cabo PG9** | 3 | Entrada **24 V de potência** (vindo do P1) · saída de potência para a câmara · saída de sinais | |
| **Prensa-cabo PG7** | 2 | Entrada 5 V (do T2) e entrada 12 V auxiliar + 24 V (do T3) | |
| ~~Placa ilhada 9 × 15 cm~~ | ~~2~~ | 🗑️ **NÃO COMPRE PARA O PAINEL.** Não há mais placa nenhuma: o divisor e o pull-up viraram módulos comprados, e os dois capacitores que sobraram entram parafusados em borne. ⚠️ **Uma placa pequena ainda serve** para o corpo da placa simuladora de DUT (~30 × 40 mm) — qualquer sobra resolve | |
| ⭐ **Prensa-cabo PG9 — parede da CÂMARA** | 2 | **PC-1 (potência)** e **PC-2 (medição e sinal)**, um em cada canto da parede traseira. ⚠️ **Não é economia juntar num só:** os BTS chaveiam 6 A e induziriam transiente nos retornos de 17,6 mA e no I²C. Ver Doc 12 §12.7 | |
| Bolsa porta-documentos p/ porta | 1 | Guarda o diagrama elétrico — **padrão em painel industrial** | |

---

# 🧠 CAMADA 2/3 — ELETRÔNICA E COMANDO

## L.1 — Controle e interface

| Item | Qtd | Especificação | Link |
|---|---:|---|---|
| Arduino Mega 2560 R3 | **2** | ATmega2560, 54 GPIO, 4 UARTs. **1 uso + 1 reserva** — ele roda o PID e as proteções; se morrer, o projeto para. ⚙️ **Versão: CH340 + USB Type-C.** O chip USB não é o processador (o ATmega2560 é o mesmo nas três versões) — muda só a ponte USB↔serial, que só serve para gravar e depurar. ⚠️ **CH340 pode exigir driver no Windows** (site `wch.cn`): se for gravar em PC de escola sem permissão de instalar, prefira a versão com **ATmega16U2** (anunciada como "sem CH340"), que é nativa. ⚠️ **Type-C: use cabo A-para-C** — algumas placas baratas omitem os resistores de 5,1 kΩ nos pinos CC e não são reconhecidas por cabo C-para-C | |
| Shield de expansão Mega (bornes parafuso) | 1 | Sensor Shield V2.0 | |
| Suporte DIN para Arduino Mega | 1 | Ou SPCI4/adaptador | |
| ~~Tela Nextion Basic 3.2"~~ | ~~1~~ | ~~NX4024T032~~ — **substituída pelo módulo ESP32-S3 com tela** (ver abaixo) | |
| ⭐ **ES3C28P** — ESP32-**S3** 2,8" toque capacitivo, microSD, microfone (LCDWIKI) | 1 | **A IHM do projeto.** Substitui a tela Nextion **e** o módulo de cartão SD. **8 MB de PSRAM** → a Xiaozhi roda. ILI9341V 240×320, toque capacitivo FT6336G, 5 V / 140 mA, **−30 a 80 °C**. Vem com alto-falante. ⚠️ Comprar a versão **ES3C28P** (com toque) — a `ES3N28P` é sem toque | |

> ### ✅ O módulo de tela — modelo confirmado e pinagem levantada
>
> A placa escolhida é a **ES3C28P**, da LCDWIKI. Tem wiki oficial e um pacote de suporte no GitHub, o que para um projeto escolar vale muito.
>
> ### ⭐ Ela tem PSRAM — e o anúncio não diz
>
> A descrição do vendedor lista só `384 KB ROM + 512 KB SRAM + 16 KB RTC SRAM + 16 MB Flash`. **Faltou a informação mais importante:** a wiki oficial e o pacote de suporte no GitHub confirmam **8 MB de PSRAM OPI**.
>
> É isso que separa esta placa da ESP32-2432S028R (*Cheap Yellow Display*), que foi a primeira candidata: **sem PSRAM a Xiaozhi não roda de jeito nenhum**; com 8 MB, roda. O próprio anúncio já promete *"suporte ao chat de voz Xiaozhi AI"*, o que só faz sentido por causa dela.
>
> | Ponto | Resultado |
> |---|---|
> | Processador | ✅ **ESP32-S3** dual-core LX7 |
> | **PSRAM** | ✅ **8 MB OPI** — confirmada na wiki e no BSP |
> | Flash | ✅ 16 MB |
> | Slot microSD | ✅ em interface **SDMMC dedicada** (CLK IO38, CMD IO40, DATA IO39/41/48/47) |
> | Alimentação | ✅ **5 V** · 140 mA só com a tela |
> | Toque | ✅ **capacitivo** (FT6336G, por I²C) — dedo, sem caneta |
> | Microfone e alto-falante | ✅ mic embutido, alto-falante **vem na caixa** |
> | Temperatura de operação | ✅ **−30 a 80 °C** |
> | Documentação | ✅ wiki oficial + BSP no GitHub |
>
> #### 🔌 A ligação com o Arduino — os pinos que sobram
>
> A CYD usa quase tudo no display. Sobram só três, em dois conectores JST de 1,25 mm:
>
> ### 🔌 Os conectores — e por que some o improviso do cabo USB cortado
>
> | Conector | Pinos | Uso no projeto |
> |---|---|---|
> | ⭐ **UART** | 5 V ⚠️ · **GND · TXD (IO44) · RXD (IO43)** | **serial** — usar só 3 fios, ver abaixo |
> | I²C | 3,3 V · GND · SDA (IO16) · SCL (IO15) | livre — compartilhado com o toque |
> | Expansão | IO2 · IO3 · IO14 · IO21 | 4 GPIOs livres de verdade |
> | Speaker | — | alto-falante que vem na caixa |
> | BAT | — | ⚠️ **não usar** — ver abaixo |
>
> ### 🔌 "VBUS" e "GND-PWR" no diagrama SÃO o Type-C
>
> No desenho do painel a tela aparece com dois bornes, `VBUS` e `GND-PWR`. **Não são uma segunda entrada de alimentação ao lado do Type-C — são o Type-C.**
>
> `VBUS` é o nome universal do pino de **+5 V** de qualquer conector USB, e `GND-PWR` é o **0 V** dele. São o vermelho e o preto do mesmo cabo. Não existe alimentar por um sem o outro, do mesmo jeito que não se alimenta nada com um fio só.
>
> Eles ganharam nome no diagrama por um motivo prático: **todo condutor do painel precisa de um destino com nome** para o desenho poder mostrar onde ele termina e para o script conseguir conferir. "Vai no USB" não é um borne; `VBUS` e `GND-PWR` são.
>
> **Como isso vira montagem:** um **rabicho Type-C** — plugue USB-C de um lado, dois fios nus do outro, de 20 a 30 cm. Vermelho no BD-5V (saída 2), preto no BD-0V (ponto R9). Você não solda nada na placa nem abre o conector: pluga.
>
> | O que você compra | Onde encosta |
> |---|---|
> | rabicho USB-C macho, 2 fios, ~0,5 mm² | vermelho → **BD-5V O2** · preto → **BD-0V Z9** |
>
> 🔥 **Um alimentador de cada vez.** Com o rabicho ligado no barramento, **não plugue também um carregador nem o cabo do PC** — seriam duas fontes de 5 V empurrando uma contra a outra dentro do mesmo conector, sem nada entre elas. Para gravar firmware: desligue o disjuntor do painel **ou** desconecte o rabicho antes de plugar o PC.
>
> ⚠️ Confira a bitola do rabicho antes de usar. A tela puxa ~140 mA e o cabo é longo — ele atravessa a dobradiça da porta.
>
> ### ⚠️ O pino de 5 V do conector UART é provavelmente SAÍDA — não ligue nele
>
> A wiki oficial lista **apenas duas** entradas de alimentação: o **Type-C** e o **conector de bateria**. O conector UART é descrito só como *"depuração, download e comunicação — requer um módulo USB-serial externo"*.
>
> Ou seja, aquele pino de 5 V provavelmente existe para **alimentar o adaptador USB-serial** que se plugaria ali — é saída, não entrada.
>
> 🔥 **Ligá-lo no BD-5V seria ruim:** os 5,10 V do painel encontrariam os 5 V da placa, um empurrando o outro, com corrente circulando por onde não deve.
>
> **Regra segura: alimente pelo Type-C e use só 3 fios do cabo UART** — GND, TXD e RXD. Isole a ponta do quarto fio.
>
> #### 🔎 Como tirar a dúvida com multímetro, sem energizar
>
> Com a placa **desligada e sem nada conectado**, meça continuidade entre o pino de 5 V do conector UART e o **VBUS do Type-C** (ou o positivo do capacitor grande perto do USB):
>
> | Leitura | Significa |
> |---|---|
> | ~0 Ω nos dois sentidos | é a mesma rede → **pode alimentar por ali** |
> | queda de diodo só num sentido | protegido / unidirecional → **só saída** |
> | aberto | redes independentes → não alimenta |
>
> ### ⚠️ E o TXD/RXD são 3,3 V — o conversor continua obrigatório
>
> Não é suposição. São o `IO43` e o `IO44` do ESP32-S3, e três fontes batem: o **BSP no GitHub** mapeia `TX = GPIO44` e `RX = GPIO43`; a ficha declara **"tensão de operação 3,0~3,6 V"** para o módulo; e a wiki fala em *"módulo USB-serial externo"*, que para ESP32 é de 3,3 V. **Nenhuma documentação menciona conversor de nível a bordo.**
>
> ### ⚠️ O UART é o UART0 — o mesmo do log de boot
>
> Os pinos IO43/IO44 são o **UART0** do ESP32-S3, por onde o bootloader imprime o log a cada reinício. **O Arduino vai receber ~500 bytes de texto toda vez que a tela reiniciar.** Não faz mal, mas o parser do Arduino precisa **ignorar linhas que não sigam o protocolo** — o que é boa prática de qualquer jeito.
>
> Duas saídas se incomodar:
> 1. **No ESP-IDF**, apontar o console para o USB-Serial-JTAG em vez do UART0. O log some do conector e o UART0 fica limpo.
> 2. **Usar o conector de expansão** (IO2/IO3) para uma UART1 dedicada, deixando o conector UART só para os 5 V. Custa um segundo cabo.
>
> ### 🔋 Não instale bateria
>
> A placa aceita Li-Po e traz circuito de carga. **Não use.** Dentro de um painel elétrico fechado, uma bateria de lítio é risco de incêndio sem contrapartida — o painel já tem 24 V permanente pelo BD-24V, que é o que mantém a supervisão viva. Deixe o conector BAT vazio.
>
> ### 🔌 O conversor de nível — ligação pino a pino
>
> O modelo de **6 pinos por lado** é o de **4 canais**: alimentação + terra + 4 vias. Usamos 2.
>
> | Tela | Conversor | Arduino Mega |
> |---|---|---|
> | 3,3 V (conector **I²C**) | `LV` | — |
> | GND | `GND` (dos **dois** lados) | BD-0V |
> | **RXD · IO43** (conector UART) | `LV1` ↔ `HV1` | **pino 16** (TX2) |
> | **TXD · IO44** (conector UART) | `LV2` ↔ `HV2` | **pino 17** (RX2) |
> | — (o `HV` vem do Arduino) | `HV` | **5 V** do BD-5V |
> | *alimentação da tela* | — | **Type-C**, cabo à parte |
>
> Os canais 3 e 4 ficam livres para uma expansão futura.
>
> ### 🎁 O que ela habilita que o Nextion não habilitava
>
> | Recurso | Uso no projeto |
> |---|---|
> | **Alto-falante** (vem na caixa) | ⭐ **alarme sonoro** quando um DUT morre — hoje o projeto só avisa pelo sinaleiro FALHA, que ninguém vê de costas |
> | **Microfone + 8 MB PSRAM** | a **Xiaozhi** no futuro, como você planejou |
> | **LED RGB** (IO42) | um segundo indicador de estado, sem gastar sinaleiro |
> | **4 GPIOs de expansão** | espaço para crescer, coisa que a CYD não tinha |
>
> ### 🤔 O único ponto em que o toque capacitivo perde
>
> Toque **capacitivo não funciona com luva grossa**; o resistivo funciona. Numa fábrica de verdade isso pesa a favor do resistivo — e é um bom detalhe para citar na defesa, mostrando que a escolha foi consciente. Para esta bancada, o capacitivo ganha por ser muito mais agradável de usar e não exigir caneta.
>
> ### ⭐ O módulo de tela — exigências que motivaram a escolha
>
> Estas foram as cinco exigências levantadas para escolher a placa. Ficam registradas porque explicam **por que a ES3C28P foi escolhida** e servem de critério caso seja preciso trocar de modelo:
>
> | # | Exigência | Por quê |
> |---|---|---|
> | 1 | **PSRAM** (8 MB de preferência) | Sem PSRAM não roda LVGL com folga, e **a IA da Xiaozhi não roda de jeito nenhum** |
> | 2 | **Slot microSD ligado ao ESP32** | É o que substitui o módulo de cartão. Confirmar que o SD é do ESP32 e não só do display |
> | 3 | **2 GPIOs livres** para UART | É por eles que o Arduino conversa com a tela. Nessas placas quase tudo vai para o display |
> | 4 | **Entrada de 5 V** que não seja só o USB | O painel alimenta pelo BD-5V; depender de conector USB dentro de um painel é frágil |
> | 5 | **I²S livre + mic e alto-falante** | Só se a Xiaozhi entrar no plano. Decidir agora evita furar a porta duas vezes |
>
> ⚠️ **Não é o slot SD do Nextion.** No Nextion o cartão só grava o firmware da tela; aqui ele é **armazenamento de verdade**, no barramento SPI do próprio ESP32. É essa diferença que permite o módulo acumular as duas funções.
>
> ### 🔥 O item que é fácil esquecer e queima a placa
>
> | Item | Qtd | Por quê |
> |---|---|---|
> | **Conversor de nível lógico bidirecional 4 canais** (3,3 V ↔ 5 V) | 1 | ⚠️ **Obrigatório.** O GPIO do ESP32 aceita no máximo **3,6 V** e o Arduino Mega transmite em **5 V**. Buscar `conversor nivel logico bidirecional 4 canais` |
>
> ### ⚠️ "Mas eu alimento a placa com 5 V — ela não fala em 5 V?"
>
> **Não.** Os 5 V não chegam ao ESP32: eles entram num **regulador na própria placa**, que os converte em 3,3 V. O chip e os pinos dele trabalham em 3,3 V.
>
> ```
>    5 V  ──►  [regulador da placa]  ──►  3,3 V  ──►  ESP32
>                                                      ▲
>                                           os GPIOs vivem AQUI
> ```
>
> O projeto já tem esse mesmo arranjo: a **DNLCB30 recebe 24 V** e o ESP32 dentro dela segue em 3,3 V. **Alimentação e nível lógico são grandezas diferentes** — uma é a comida, a outra é o idioma.
>
> **Só um sentido precisa de conversão:**
>
> | Sentido | Precisa? | Por quê |
> |---|---|---|
> | Arduino TX (5 V) → tela RXD | ❌ **precisa** | 5 V num pino de 3,6 V no máximo |
> | Tela TXD (3,3 V) → Arduino RX | ✅ vai direto | o Mega lê acima de 3,0 V como nível alto |
>
> ### 🤔 "E a DNLCB30, que já tem conversor? Não dá para aproveitar?"
>
> **Não, e o motivo é a topologia dela.** O conversor da DNLCB30 fica *entre o soquete do ESP32 e o borne*:
>
> ```
>    borne parafuso ──[conversor]── pino do soquete ── ESP32
>         5 V                            3,3 V
> ```
>
> O lado de 5 V é o borne, acessível. O lado de **3,3 V termina no pino do soquete**, onde o ESP32 está encaixado — não existe borne para ele. Para o sinal chegar na tela, o ESP32 teria que **repassá-lo por software**, que é a arquitetura em cadeia já descartada (a tela cega se o ESP32 reiniciar).
>
> Grampear um fio no pino do soquete resolveria no papel, mas traz três problemas — e o terceiro é sério:
>
> 1. **O GPIO do ESP32 fica exposto** ao sinal. Se o firmware um dia configurar aquele pino como saída, dois circuitos disputam a mesma linha.
> 2. **É fio soldado em header dentro de painel** — falha por vibração, e meses depois.
> 3. ⚠️ **Retroalimentação.** No módulo dedicado, o lado `LV` é alimentado pelos **3,3 V da própria tela**: se a tela desliga, o lado baixo morre junto e nada é injetado nela. Grampeando a DNLCB30, o sinal fica vivo sempre que o **ESP32 de IoT** estiver ligado — injetando 3,3 V numa placa sem alimentação, pelos diodos de proteção dela. É o mesmo mecanismo de dano, por outro caminho.
>
> **Os R$ 5 do módulo compram o direito de não pensar mais nisso.**

> 🎁 **O módulo resolve dois problemas com um.** Os conversores baseados em BSS138 já trazem **pull-up de 10 kΩ nos dois lados de cada canal** — ou seja, ele também resolve o GPIO35 sem pull-up. Com resistores avulsos você resolveria só a conversão, e ainda ficaria com componente solto no meio do fio, contra a regra que motivou a placa PI-1.
>
> **Ligação:**
>
> | Conversor | Liga em |
> |---|---|
> | **LV** | ES3C28P · 3,3 V (conector **I²C**) |
> | **HV** | Arduino · 5 V |
> | **GND** (os dois lados) | BD-0V |
> | **LV1 ↔ HV1** | **RXD (IO43)** ↔ Mega **pino 16** (TX2) |
> | **LV2 ↔ HV2** | **TXD (IO44)** ↔ Mega **pino 17** (RX2) |

> **O perigo é que ligar direto *parece* funcionar.** O ESP32 tem diodos internos de proteção que grampeiam a tensão, então a comunicação estabelece e tudo aparenta estar certo. Mas passa corrente por esses diodos continuamente, e o pino degrada em semanas. Quando falhar, vai parecer defeito de fábrica do módulo.
>
> Quem faz essa adaptação para o **outro** ESP32 é a própria **DNLCB30** (está na serigrafia dela: *3.3V to 5V level*). O módulo de tela não tem — por isso o conversor entra na lista.
>
> ### 🔌 Alimentar o módulo de tela pelo cabo Type-C cortado
>
> É a saída prática, já que essas placas raramente têm borne. Três cuidados:
>
> 1. **Cabo comum serve.** A ficha da CYD declara **115 mA**, não os ~500 mA que eu havia estimado. Mesmo 1 m de cabo barato (28 AWG) derruba só ~80 mV, e nos picos de transmissão Wi-Fi (~300 mA) não passa de 210 mV. Chega folgado acima de 4,8 V. Só evite emendas e cabos de mais de 2 m.
> 2. ⚠️ **Nunca plugar o USB do PC com o painel energizado.** As duas entradas de alimentação da placa costumam ser paralelas por dentro: o painel empurra 5,10 V contra os 5,00 V do PC, com risco de retroalimentar a porta USB. **Desligue o BD-5V antes de gravar firmware.**
> 3. **Procure primeiro um pino de 5 V.** Os conectores de 4 pinos 1,25 mm (`IO1`/`IO2 estendido`) normalmente trazem 5 V e GND — bem mais firme que conector USB, que não foi feito para vibração.
>
> Os **5,10 V do BD-5V** estão dentro da faixa USB (4,75–5,25 V), sem problema.

> 🔌 **Vai precisar de um divisor resistivo.** O Arduino Mega transmite em **5 V** e o ESP32-S3 só aceita **3,3 V** no pino de entrada. Quem fazia essa adaptação para o outro ESP32 era a DNLCB30 — o módulo de tela não tem isso. São 2 resistores (10 kΩ + 20 kΩ) na linha `Mega TX → S3 RX`. O caminho contrário (`S3 TX → Mega RX`) funciona direto, porque o Mega já reconhece 3,3 V como nível alto.
| ESP32-WROOM-32U | 1 | 30 pinos, conector de antena IPEX | |
| **DNLCB30** — base DIN para ESP32 | 1 | Entrada **7–35 V** (alimentada direto do barramento 24 V), conversão 3,3 ↔ 5 V automática. **Não inclui o ESP32** | |
| Pigtail **IPEX (u.FL) → SMA macho**, 20–30 cm | 1 | Liga o ESP32 ao conector de painel | |
| **Conector SMA fêmea de painel (bulkhead)** | 1 | Rosca de painel Ø 6,5 mm, com porca e arruela de pressão. ⚠️ **Nunca** passar o coaxial por prensa-cabo | |
| Antena 2,4 GHz SMA macho 3 dBi articulável | 1 | Rosqueada por fora, na **lateral direita, parte alta** do painel | |
| ~~Módulo Micro SD (SPI)~~ | ~~1~~ | 🔧 **NÃO COMPRAR** — a ES3C28P já traz o slot, ligado ao ESP32-S3 por SDMMC. Esta linha tinha sobrado da versão com Nextion | |
| Cartão Micro SD | 1 | 8–16 GB, Classe 10. **Vai no slot da tela**, não em módulo separado | |
| Módulo RTC DS3231 | 1 | I²C, ±2 ppm | |
| Bateria CR2032 | 1 | Backup do RTC | |

## L.2 — Potência e acionamento

| Item | Qtd | Especificação | Link |
|---|---:|---|---|
| Driver ponte-H **BTS7960** | 2 | 43 A, pino IS de diagnóstico | |
| Suporte SPCI4 trilho DIN | 2 | Fixa PCI 100 × 79 mm | |
| Cooler 40 mm 12 V | 1 | Refrigeração dos BTS | |
| **KM1 — Relé 14 pinos 24 Vcc (HH64P / LY4NJ 10 A) + base DIN PTF14A** | **2** | 1 em uso + 1 reserva. Relé eletromecânico **14 pinos, bobina 24 Vcc, 4 contatos reversíveis (4 NA + 4 NF) de 10 A cada**, com **base para trilho DIN PTF14A inclusa**. Modelo: `HH64P` / `LY4NJ 24VDC 10A`. Ele usa os contatos independentes: Polo 1 (9-5) para os 6,0 A da Peltier (24 V), Polo 2 (10-6) para os 4,2 A do PTC (12 V) e Polo 3 (11-7) para o selo do botão Ligar. Ao bater emergência ou STOP, desenergiza Peltier e PTC simultaneamente! | |
| *Alternativa premium (só se sobrar orçamento)* | — | **Finder 46.61 24VDC** (1 reversível **16 A**) + base **95.05** para o KM1, ~R$ 80–110. Vale se você quiser folga grande sobre os 6,0 A e datasheet publicado | |
| **Resistor 10 kΩ 1/4 W** | 4 | **Pull-down** em cada `R_EN` dos BTS7960 (2) + reservas. ⚠️ Garante que **pino solto = driver desligado** — ficou ainda mais crítico com os 24 V permanentes na entrada dos BTS | |
| **Resistor 22 kΩ 1/4 W** ⬆ | 2 | **Braço superior** do divisor de realimentação de tensão para o pino D25 | |
| **Resistor 4,7 kΩ 1/4 W** | 2 | **Braço inferior** do mesmo divisor | |

> ### 🛒 Decisão de compra dos relés — por que o genérico e não o Finder
>
> Comparação real de dois anúncios avaliados:
>
> | | Finder 49.52 · R$ 58 | **Genérico 8 pinos · R$ 39** |
> |---|---|---|
> | Contatos | 2 reversíveis · **8 A** | 2 reversíveis · **10 A** |
> | Serve para o **KM1** (6,0 A)? | ❌ **8 A é abaixo do mínimo** | ⚠️ Sim, no limite aceitável |
> | Base inclusa? | ⚠️ Não informado | ✅ Relé **+ base** |
> | Custo para resolver o relé + reserva | R$ 116 (2 iguais) — e nenhum atende | **R$ 78** (2 iguais) |
>
> ✅ **Escolhido: o genérico de 8 pinos.** O Finder é melhor relé, mas 8 A não atende os 6,0 A da carga com margem nenhuma.
>
> **A ressalva do genérico, e por que ela é aceitável aqui:** sem marca, não há datasheet para conferir a corrente em DC. Mas **desgaste de contato é cumulativo — depende de quantas VEZES ele interrompe corrente**, não de quanto tempo fica ligado. O KM1 só abre com 6 A quando alguém aperta STOP ou a emergência: ao longo da vida do projeto, algumas dezenas de vezes. Um contato de 10 A aguenta isso com folga. O risco seria real num equipamento industrial partindo o dia inteiro — não é o caso.
>
> ⚠️ **Se optar pelo Finder mesmo assim, confira duas coisas:** o anúncio informa *"Tipo de montagem: Circuito impresso"* — se for literal, é relé de **soldar em placa** e não encaixa no trilho. E ele **não menciona a base**, que pode custar mais R$ 20–30.
>
> 📌 **Ignore os campos absurdos dos anúncios** ("Potência 1,2 kW", "Tipo de motor: Bobina Helicoidal"). É preenchimento automático do Mercado Livre, não especificação.
>
> ### ✅ Conferir ao receber
> - Bobina **24 Vcc** (não Vca) — meça a resistência: ~600 a 1500 Ω
> - 8 pinos, e a base encaixando no trilho DIN
> - 2 NA + 2 NF (= 2 reversíveis)
> - Alimente a bobina com 24 V e confira a comutação com o multímetro em continuidade **antes de instalar**

> ### 🇧🇷 A palavra que destrava a busca no Brasil: **relé ACOPLADOR**
>
> Procurar "relé de interface" no Mercado Livre quase não retorna nada. O termo comercial usado aqui é **relé acoplador** (ou *acoplador a relé*).
>
> | Busca que funciona |
> |---|
> | `relé acoplador 24vcc` |
> | `relé acoplador 2 contatos reversíveis 24v` |
> | `relé 8 pinos 24vdc base trilho din` |
> | `relé 24v trilho din` |
>
> ⚠️ **Descoberta importante da pesquisa de mercado:** praticamente **todo relé acoplador vendido no Brasil é de 6 a 8 A**. Isso serviria para uma bobina de miliampères, mas **não resolve o KM1** (6,0 A de carga = 100 % da capacidade, sem margem nenhuma).
>
> **O caminho prático é o relé de 8 pinos + base** — o arranjo clássico de painel brasileiro, com 2 contatos de 10 A, barato e disponível em qualquer lugar: **1 em uso + 1 reserva**.

> ### 🛒 Como ler um anúncio de relé — o vocabulário que engana
>
> "Reversível" vira outra palavra em inglês, e o anúncio quase nunca usa a que você espera:
>
> | Português | No anúncio | Serve? |
> |---|---|---|
> | 1 contato **NA** só | `SPST-NO` · `1A` · `1 Form A` | ❌ Não serve — faltaria o contato do selo |
> | **1 reversível** | `SPDT` · **`1CO`** · `1Z` · `1 Form C` | ⚠️ Só se o selo for feito em outro lugar |
> | **2 reversíveis** | `DPDT` · **`2CO`** · `2Z` · `2 Form C` | ✅ **é o do KM1** — um contato para a carga, outro para o selo |
>
> 🔑 **"CO" = changeover = reversível.** Buscar `2CO 24VDC relay` já filtra quase tudo que não serve.
>
> ⚠️ **Muitos anúncios escrevem só "24V".** Tem que ser **24VDC** — bobina de 24VAC não funciona no nosso barramento.
>
> ⚠️ **Módulo pronto ou relé avulso?** `interface relay module` / `relay with socket` vem com base DIN, LED e diodo. Só `relay` vem sem a base.
>
> ⚠️ **Confirme "with LED and diode"** (ou *freewheeling diode*). A documentação assume que o módulo já traz o diodo de roda-livre — foi por isso que os 4× 1N4007 saíram do painel. **Se o seu não tiver, o diodo volta**, em antiparalelo com a bobina.
>
> 📌 **Sobre importar:** a recomendação de comprar nacional existe por causa do **datasheet com a corrente em DC**, que anúncio genérico não fornece. Isso não impede importar — impede comprar **sem marca**. Um Omron, Finder ou Hongfa com número de modelo você consulta antes de clicar; um "24V 10A Relay Module" sem fabricante, não.

> ⚠️ **O divisor de realimentação mudou de escala.** Ele antes lia os 12 V do T1 (10 kΩ + 4,7 kΩ → 3,84 V no ADC). Agora precisa ler o **barramento de 24 V**, e com os resistores antigos entregaria **7,67 V no pino D25 — o suficiente para danificar a entrada do Arduino**. Com **22 kΩ + 4,7 kΩ** a leitura fica em `24 × 4,7/26,7 = 4,22 V`, dentro da faixa segura e com margem para o barramento oscilar. 📌 **Sinalizar em [Doc 32](../camada_3_eletrica/32_sinais_e_sensores.md):** o esquema do divisor e a constante de conversão do firmware precisam ser atualizados junto.
| Diodo 1N4007 | 4 | **2 usos + 2 reservas.** `D1` na bobina do KM1 (catodo no `A1`) e `D2` nas ventoinhas do radiador (catodo no `+12 V`). 🔎 **Antes de montar o `D1`:** multímetro em *teste de diodo* entre `A1` e `A2` do KM1 — se já conduzir num sentido só, o relé tem diodo interno e o `D1` é dispensável. **O `D2` é sempre obrigatório** — o motor é indutivo e nada mais o grampeia. Ver [Doc 31 §31.9](../camada_3_eletrica/31_comando_e_protecoes.md) | |

## L.3 — Atuadores térmicos e ventilação

| Item | Qtd | Especificação | Link |
|---|---:|---|---|
| ⭐ **Kit duplo de refrigeração Peltier** (2× TEC1-12706) | 1 | **Adotado — kit já conferido por foto** ([`imagens/peltir.avif`](../imagens/peltir.avif)): 2 conjuntos lado a lado, **cada pastilha com seu par de fios** e **cada ventoinha com cabo próprio**, o que viabiliza as modificações 1 e 2 sem cortar nada. Traz **2 pastilhas + radiador + 2 blocos frios + ventoinhas + montagem térmica pronta**. Anunciado como **12 V / 15 A**, ou seja, **vem ligado em PARALELO** — ⚠️ **religar em SÉRIE** para 24 V / 6,0 A (ver as 3 modificações abaixo). ~200 × 115 × 85 mm. Buscar `kit peltier duplo TEC1-12706 refrigeração` | |
| Pastilha Peltier TEC1-12706 avulsa | 1 | **Reserva.** ⚠️ Trocar uma pastilha do kit exige desmontar a junta térmica — tenha a peça, mas conte com o trabalho | |
| ~~Módulo MOSFET 4 canais — LR7843 (MV-1)~~ | ~~1~~ | 🗑️ **NÃO COMPRE — R$ 43,51 economizados.** Ele ficou usando **1 dos 4 canais**, para ligar e desligar as 5 ventoinhas internas: 12 V, 0,63 A, uma comutação por ensaio, num pino (`D29`) que **nem PWM tem**. Um MOSFET só se paga quando precisa MODULAR ou comutar milhares de vezes por hora. Quem faz o serviço agora é o **KA3**, um terceiro módulo de relé de R$ 3,40 na mesma caixa DIN do KA1 e do KA2 ([Doc 31 §31.16](../camada_3_eletrica/31_comando_e_protecoes.md)) | |

> ### 🗑️ Por que este módulo saiu — e a regra que ficou no lugar dele
>
> A escolha do módulo de 4 canais foi **certa dentro da pergunta errada**. A pergunta era *"um módulo de 4 canais ou três de 1 canal?"*, e o de 4 ganhava fácil: 66 mm contra 114 mm de trilho, um par de alimentação em vez de três, dois retornos em vez de seis, e ainda sobrava um canal.
>
> A pergunta que faltava era **anterior a essa: MOSFET ou contato?**
>
> | Quando o módulo entrou | Quando ele saiu |
> |---|---|
> | 3 grupos de ventoinha para comandar | **1 grupo** — o radiador foi para o KA2 e o PTC entrou junto com as internas |
> | 3 dos 4 canais em uso | **1 dos 4 canais** em uso |
> | R$ 43,51 por 3 acionamentos | R$ 43,51 por **um interruptor** |
>
> 🎯 **A regra, e ela vale para o projeto inteiro:** um MOSFET só se paga quando é preciso **modular** (PWM) ou comutar **milhares de vezes por hora**. As 5 internas ligam **uma vez por ensaio**, comandadas pelo `D29` — que **nem é pino de PWM** no Mega. Quem modula aqui são os **BTS7960**, na Peltier e no PTC, a 20 kHz. Ver [Doc 31 §31.16](../camada_3_eletrica/31_comando_e_protecoes.md).
>
> ### ⚠️ E havia uma segunda razão, que é elétrica e não de preço
>
> **O LR7843 é canal N de lado baixo: ele chaveia o NEGATIVO.** Foi isso que já tinha derrubado o comando das ventoinhas do radiador — o tacômetro delas é referenciado nesse mesmo negativo, e com o canal desligado o preto subia para ~12 V e a leitura de RPM mentia "parada".
>
> Nas internas o defeito ficava **dormindo**, porque elas são de 2 fios e não têm tacômetro. Bastaria trocar uma por outra de 3 fios para ele acordar. Com o **KA3** no lado positivo, o preto das cinco é 0 V de verdade — ligadas ou paradas.
>
> ### 📌 O que este box ensinava e continua valendo
>
> - **O anúncio dizia "5 V a 36 V", mas o transistor é de 30 V.** Confie no componente, não no anúncio: é comum o vendedor descrever a placa e esquecer o limite do transistor que ele mesmo montou nela. **É esse hábito de leitura que a banca procura.**
> - **Jumper H/L existe para não haver dois significados de `HIGH`** no firmware. Os três módulos de relé herdaram a mesma regra: todos em **H**.
> - **O optoacoplador entrega imunidade a ruído, não isolação galvânica**, num projeto de 0 V único. O mesmo vale para os módulos de relé — e neles a isolação de verdade está no **contato**, que é seco.
| 🔄 **DS18B20 à prova d'água** | 1 | **Mudou de lugar:** saiu de dentro da câmara e foi para o **dissipador do lado quente**. É ele que diz quando a pós-ventilação pode parar | |
| 🔄 **AM2315C** | 1 | **Passou a ser o único sensor de dentro da câmara.** Mede temperatura **e umidade** no mesmo encapsulamento, e já estava no barramento I²C | |
| **PI-2 — caixa DIN 4 módulos** | 1 | Abriga o multiplexador, os shunts e o INA219 para a detecção de corrente das 2 posições de ensaio | |
| **Módulo CD74HC4067** | 1 | Multiplexador analógico de 16 canais (PI-2) | |
| **Módulo INA219** | 1 | Medição de corrente/tensão (PI-2) | |
| ⭐ **Porta-fusível DIN 2 vias COM INTERRUPTOR** | 1 | Para as 2 posições de ensaio, com fusíveis tubulares de **100 mA**. ⭐ **O interruptor é a demonstração:** desligando a chave na frente da banca, o sensor vê a corrente sumir e o sistema acusa a falha em menos de 1 s. | |
| **Aquecedor PTC 12 V / 50 W** | 1 | **PROPOSTA · NÃO COMPRAR/ENERGIZAR.** Corrente estimada 4,17 A. Exigir variante identificável, ficha técnica, ventilação e compatibilidade térmica; aguardar projeto do corte CC independente, proteção do ramal, cabos e F3. Buscar `aquecedor PTC 12v 50w` | |
| ⭐ **Ventoinha de reposição do RADIADOR — 3 fios** | 2 | ⭐ **A troca mais importante do kit.** As originais são de **2 fios** e não informam rotação. Têm que ser **as do radiador (lado quente)** — se elas param, a Peltier queima em < 1 min. As dos **blocos frios** podem continuar de 2 fios. Medir o tamanho no kit antes de comprar | |
| Pasta térmica | 1 | Seringa 5 g. **O kit já vem com a junta térmica montada** — a pasta é só para retrabalho, se você abrir para trocar uma pastilha | |
| **Ventoinha interna 12 V** | 5 | Internas — 4 de circulação + 1 do PTC (grupo único em paralelo) | |

> ### ⭐ Kit duplo de Peltier — as 3 modificações obrigatórias
>
> O kit pronto foi adotado porque entrega a **montagem mecânica e térmica já feita** — radiador, blocos frios, fixação e a junta com pasta, que é justamente a parte mais fácil de errar. Mas ele vem configurado para 12 V e precisa de três mudanças:
>
> **1. Religar as pastilhas em SÉRIE**
>
> O anúncio de **12 V / 15 A** denuncia o paralelo. A conta:
>
> | Ligação | Tensão | Corrente |
> |---|---:|---:|
> | 2 em **paralelo** (como vem) | 12 V | ~12 A |
> | 2 em **série** (o que queremos) | **24 V** | **~6 A** |
>
> Ligue **(+) de uma no (−) da outra**; as pontas que sobram viram o par de 24 V.
>
> ✅ **A foto do kit recebido confirma que dá para fazer isso.** Em [`imagens/peltir.avif`](../imagens/peltir.avif) vê-se que **cada pastilha tem o seu próprio par de fios** (vermelho e preto) saindo do chicote. Ou seja, elas **não vêm ligadas entre si de fábrica** — basta unir um (−) a um (+) para ter a série, sem cortar nada que já esteja soldado.
>
> **2. 🔥 Separar as ventoinhas das pastilhas — o erro que queima o kit**
>
> Kits assim costumam ter **uma entrada de 12 V só**, alimentando pastilhas e ventoinhas juntas. **Ligar 24 V nessa entrada única queima todas as ventoinhas na hora.**
>
> ✅ **A foto também resolve esta.** Cada ventoinha do kit tem **cabo próprio e independente** — não há uma entrada única de 12 V compartilhada. Isso torna a modificação 2 trivial: é só **não** juntar os chicotes. Leve os fios das pastilhas ao BD-POT (24 V) e os das ventoinhas ao BD-AUX (12 V).
>
> ```
> Peltier 1 ──série── Peltier 2  ────► 24 V   (BTS #1, via BD-POT)
> Ventoinhas (todas)  ────────────────► 12 V   (BD-AUX)
> ```
>
> **3. Trocar as ventoinhas do RADIADOR por modelos de 3 fios**
>
> | Ventoinha | Se parar | Precisa de RPM? |
> |---|---|---|
> | **Do radiador** (lado quente) | ⚠️ **Peltier queima em < 1 min** | ✅ **SIM** |
> | Dos blocos frios (lado frio) | O ar não circula bem — não destrói nada | ❌ Não |
>
> ⚠️ **Troque as do radiador, não as dos blocos frios.** É um erro fácil de cometer e ele anula a proteção nº 1 do projeto.
>
> ### 💡 Possível economia: 2 ventoinhas internas a menos
>
> As **2 ventoinhas dos blocos frios já sopram para dentro da câmara**. Elas podem assumir o papel das 2 ventoinhas de 40 mm que o projeto previa no lado Peltier. **Decida na montagem**, ao ver a geometria real — se aproveitar, são 2 peças a menos e menos coisa dentro da câmara.
>
> ### ⚠️ Dois pontos a verificar no comissionamento
>
> | Verificação | Por quê |
> |---|---|
> | **Temperatura do radiador** com as 2 pastilhas em 100 % | O radiador do kit é dimensionado para ~120 W, e o lado quente rejeita até ~200 W no *pull-down*. Se passar de **60 °C**, o ΔT despenca e a câmara para de esfriar. Em regime (duty ~40 %) não deve ser problema |
> | **Corrente total das ventoinhas** do kit | O ramal de 12 V (T3) está em 0,87 A, ou seja **58 % do limite seguro do LM2596**. Há folga, mas não é infinita — meça antes de fechar |

> ⚠️ **As duas Peltier ficam em SÉRIE, nunca em paralelo.** Em série cada pastilha recebe 12 V (o nominal dela) e as duas compartilham os mesmos 6 A. **Em paralelo cada uma receberia os 24 V inteiros e queima em segundos.** Antes de energizar, meça a resistência do conjunto com o multímetro: deve dar **o dobro** da resistência de uma pastilha isolada. Se der metade, a ligação está em paralelo — corrija.

> 🔥 **Dobrar a Peltier obriga a dobrar a dissipação.** Cada pastilha joga ~90 W no lado quente (a potência elétrica dela mais o calor bombeado). Um único dissipador de 80 mm não dá conta dos dois — e se o lado quente saturar, o ΔT despenca, a câmara para de esfriar e a pastilha cozinha. **São 2 conjuntos completos, e é o único ponto em que o Plano B ficou mais trabalhoso que o anterior.** Reserve o espaço atrás da câmara no projeto mecânico.

## L.4 — Sensores

| Item | Qtd | Especificação | Link |
|---|---:|---|---|
| Sensor DS18B20 à prova d'água | 1 | 1-Wire, no dissipador quente; não mede o corpo do PTC nem substitui ST-1 | |
| Resistor 4,7 kΩ 1/4 W | 1 | Reserva somente se o adaptador do DS18B20 não incluir pull-up | |
| Sensor AM2315C | 1 | I²C, umidade + temperatura, carcaça selada | |
| Resistor 220 Ω 1/4 W | 6 | 4 usos + 2 reservas — série dos LEDs brancos da iluminação da maquete (5 V); os sinaleiros do painel são módulos de 5 V | |

## L.4b — Posições de ensaio (dispositivos sob teste)

> ⭐ **É o núcleo do problema descrito no edital.** Detalhamento completo em [Doc 13](../camada_1_maquete/13_posicoes_de_ensaio.md). A maquete tem **8 posições de LED em 12 V** (2 placas de 95 × 75 mm), medidas por **um** módulo N4AIC24 em Modbus RS-485 — o Mega **não** gasta entrada analógica: A2 e A3 estão livres.

| Item | Qtd | Especificação | Link |
|---|---:|---|---|
| ~~Sensor de corrente WCS2702~~ | ~~1~~ | 🗑️ **NÃO COMPRE.** Substituído pelo ACS712 | |
| ~~Módulo ADC 2 Canais Modbus RTU RS-485~~ | ~~1~~ | 🗑️ **NÃO COMPRE PARA A BANCADA.** Desnecessário no painel local (< 40 cm). Mantido apenas no memorial conceitual de 50 posições da fábrica | |
| ~~Módulo Conversor RS-485 para TTL (MAX485)~~ | ~~1~~ | 🗑️ **NÃO COMPRE PARA A BANCADA.** Eliminado junto com o módulo ADC | |
| ~~Sensor de corrente ACS712-5A~~ | ~~2~~ | 🗑️ **NÃO COMPRE.** Substituído pelo **N4AIC24** (Modbus RS-485, 22 canais de corrente + 2 de tensão). Com ele saíram também o divisor do POT-02 e o uso das entradas A2/A3 |
| ~~Porta-fusível DIN 1 via com gaveta~~ | ~~2~~ | 🗑️ **NÃO COMPRE.** As 8 posições usam **um bloco de 8 vias com chave** (CMD-10), com um fusível de lâmina de 1 A por posição |
| ~~Fusível de vidro 5×20 mm · 500 mA~~ | ~~4~~ | 🗑️ Substituído pelos fusíveis ATO/ATC de **1 A** do bloco de 8 vias (CMD-12) |
| ~~Lâmpada automotiva W5W (Pingo) 24 V 5 W~~ | ~~4~~ | 🗑️ **NÃO COMPRE.** A lâmpada saiu do projeto: o dispositivo sob ensaio são **8 posições de LED em 12 V**. O caminho novo está em [`../placa_leds/PLACA_LEDS.md`](../placa_leds/PLACA_LEDS.md) §9 |
| ~~Soquete T10 (pingo)~~ | ~~2~~ | 🗑️ **NÃO COMPRE.** Não existe mais lâmpada para encaixar: as 8 posições são 2 placas de 95 × 75 mm com LED e resistor soldados |
| ⭐ **Capacitor cerâmico 100 nF** | 2 | `C1` e `C2` nos pinos A0/A1 (diagnóstico dos BTS). ⚠️ **Eram 4:** os dois dos A2/A3 saíram junto com os ACS712 |
| ~~Borne DIN 2,5 mm²~~ | ~~4~~ | 🗑️ **NÃO COMPRE.** As posições não passam mais por borne DIN: o retorno entra direto no `I_n` do N4AIC24 |

> 💡 **O interruptor (gaveta) do porta-fusível DIN** é o que simula a falha (abertura de circuito) durante a apresentação, provando a detecção direta de falha em tempo real pelo Mega (< 1 segundo).

## L.5 — Módulos de interface e componentes em borne

> ⭐ **Nenhum resistor ou capacitor deste projeto fica pendurado no fio — e nenhum é soldado
> dentro do painel.** As placas PI-1/PI-2, o divisor D25, o CD74HC4067 e o INA219 não pertencem
> à arquitetura atual. A aquisição é feita pelo N4AIC24/Modbus; os discretos atuais moram nos
> bornes dos módulos. A ligação **perna por perna** de
> cada um está no [Doc 33](../camada_3_eletrica/33_placa_interface_componentes.md), e o passo a
> passo com o que medir está na aba **Guia de montagem** do aplicativo.

| Item | Qtd | Especificação | R$ |
|---|---:|---|---:|
| ⭐ **Módulo de aquisição N4AIC24** | 1 | Mede correntes e tensões; `V1` ligado a BD-POT e `V2` a BD-12V. Alimentado pelo 24 V permanente; requer validação do mapa Modbus e do timeout no firmware real | — |
| ⭐ **Transceptor RS-485 MAX485** | 1 | Interface entre o N4AIC24 e Serial3 do Mega; par A/B conforme Doc 13 e a fiação atual | — |
| ⭐ **DS18B20 à prova d'água + adaptador** | 1 | **AD-1** — mede o dissipador quente, não o corpo do PTC. Confirmar pull-up de 4,7 kΩ integrado ao adaptador | 6,90 |
| ~~Borne de passagem DIN 2,5 mm² (BS-1)~~ | ~~6~~ | 🗑️ **NÃO SÃO MAIS NECESSÁRIOS** para os filtros. O `C1` e o `C2` foram para os bornes `A0`, `A1` e `GND2` do adaptador do Mega — ali o `A0` é **vizinho** do `GND2` (~3,9 mm) e a perna do cerâmico entra sem esticar. No BS-1 as duas pernas caíam em bornes a **30 mm** um do outro, penduradas no ar. ⭐ **Compre 4 assim mesmo, como reserva** — borne de passagem 2,5 mm² resolve emenda de qualquer fio. Ver [Doc 33 §33.10](../camada_3_eletrica/33_placa_interface_componentes.md) |
| **Capacitor cerâmico 100 nF** | 4 | `C1` e `C2` + reservas — parafusados nos bornes do **Mega** (`A0`–`GND2` e `A1`–`GND2`), sem solda | — |
| ⭐ **Módulo relé 1 canal 5 V, optoacoplado** | 4 | **`KA1`** (veto, contato `NO`), **`KA2`** (ventoinhas do radiador, contato `NC`) e ⭐ **`KA3`** (as 5 ventoinhas internas, contato `NO`) — **3 em uso + 1 reserva**. ⚠️ Exija *optoacoplador*, **jumper H/L** e a variante de **5 V** (a foto costuma ser da de 24 V). 💰 Relé de 8 pinos aqui seria R$ 75 de folga que ninguém usa — só o **KM1** precisa dos 10 A | 6,79 |
| ⭐ **Caixa modular DIN 6 módulos (105 mm)** | 1 | Abriga os **três** módulos de relé empilhados, no trilho 2. ⚠️ **NÃO a de 4M:** 3 × 25,5 mm = 76,5 mm e a de 4M tem 70 mm. Mesmo assim o trilho 2 ficou mais folgado — o MV-1, que saiu, media 66 mm | — |
| ⭐ **Resistor 10 kΩ · ¼ W** | 5 | `R10`, `R11` e ⭐ `R12` (pull-down dos `IN` dos três módulos) + `R8` e `R9` (soldados nos BTS7960). ⚠️ **É o que torna o fail-safe medível:** Arduino ausente ou fio rompido → `IN` em 0 V → potência cortada e ventoinha girando | — |
| ⭐ **Diodo 1N4007** | 4 | `D1` (bobina do KM1), `D2` (ventoinhas do radiador) e ⭐ `D3` (as 5 internas) + 1 reserva. 🔎 **O `D1` pode ser dispensável:** teste o KM1 em *teste de diodo* entre `A1` e `A2` — se conduzir num sentido só, ele já tem diodo interno. ⚠️ **O `D2` e o `D3` são obrigatórios** — o `D3` entrou quando o MV-1 saiu: o módulo MOSFET trazia o roda-livre dentro da placa, o contato do KA3 não traz nada | — |
| Termorretrátil Ø 2 mm | 30 cm | Isolação dos 10 kΩ soldados nos BTS7960 e das emendas nos postes | — |
| Etiqueta impressa em papel adesivo | 1 | Identificação dos bornes — **é o que torna a montagem auditável** | — |

> 🗑️ **Saíram desta lista, e não devem ser comprados:** placa ilhada para o painel, caixa DIN da
> PI-1, bornes KF301/KF128 de placa, CI ULN2803A, soquete DIP-18, verniz para PCI e o fio de
> interligação por baixo da placa. **Não há mais placa no painel.**

> ⭐ **Onde cada discreto mora hoje** — 16 registros, 22 peças, nenhuma soldada em placa:
>
> | Lugar | Peças |
> |---|---|
> | Bornes do **adaptador do Mega** | `C1`, `C2` (100 nF em `A0`/`A1`) para `GND2`; `A2`/`A3` não medem tensão |
> | Bornes dos relés | `D1` no KM1 · `R10`, `R11` e `R12` nos três módulos |
> | Dentro dos **BTS7960** | `R8`, `R9` (10 kΩ, soldados no módulo) |
> | Na **maquete** | `R4`–`R7` (220 Ω) + 4 LEDs brancos, nas bases dos postes |
> | Na **câmara** | `D2` nas ventoinhas · resistor, LED e jumper do DUT |
> | **Módulos comprados** | `SV-1`, `AD-1`, `SC-1` |

> 📌 **O KA1, o KA2 e seus resistores ficam no trilho 2**, não junto do Arduino — onde a canaleta
> de baixo já é de potência e serve o trilho 1 diretamente. A primeira versão punha um MOSFET na
> PI-1 e o `npm run valida` reprovou: o circuito da bobina teria de atravessar o painel duas
> vezes, uma delas pela canaleta de sinal. **Componente de ancoragem é de proximidade.**

## Resumo de conferência rápida

| Grupo | Itens-chave |
|---|---|
| **Energia** | 1× fonte 24 V/10 A (verificar pior caso) · 1× disjuntor 2P 6 A · T2/T3 propostos, **compra bloqueada** · suportes de fusível a revisar |
| **Proteção** | F1 10 A legado; F2/F3 e o ramal PTC precisam de novo dimensionamento · **KM1 não corta o PTC 12 V** · proteção CC independente pendente |
| **Controle** | 1× Arduino Mega · 1× ESP32 · 1× DNLCB30 · 1× tela ES3C28P · 1× RTC · **1× N4AIC24 + 1× MAX485 (Modbus RS-485)** |
| **Potência** | 2× BTS7960 · **2× Peltier em série** (+1 reserva de compra) · proposta PTC 12 V/50 W, **não comprar/energizar** até fechar corte e proteção · ventoinhas a revisar |
| **Sensores** | 1× DS18B20 · 1× AM2315C |
| **Maquete** | 3× poste Ø 8 mm · ~8 m de fio rígido ENCAPADO (4 cores, **R1 e 0 V mais grossos**) · 2× "transformador" + **1× caixa de derivação** · 3× janela de acrílico · 1× caixa de subestação |
| **Comando** | 1× emergência (2 NF) · 1× LIGAR (NA) · 1× STOP (NF+NA) · 1× seccionadora · **4× sinaleiro 22 mm de 5 V** |

### ⛔ Checklist provisório — não libera compra

Se você já tinha uma lista antiga em mãos, confira **estes seis** antes de fechar o pedido — são os erros mais fáceis de cometer copiando a versão anterior:

- [ ] **Peltier: 3 unidades** (2 em uso + 1 reserva), do mesmo lote
- [ ] PTC proposto **12 V/50 W** (~4,17 A); modelo e ficha pendentes, não comprar
- [ ] T2 **24→5,0 V/5 A**; confirmar faixa máxima de entrada e transientes
- [ ] T3 **24→12 V/20 A**; confirmar capacidade contínua e térmica do modelo exato
- [ ] Definir corte DC independente, F3 e bitolas do PTC/T3; **não dimensionar pelo limite anunciado de 20 A**
- [ ] **Cooler externo 80 mm de 3 fios: 2 unidades**, não 1
- [ ] **Fusível F1 de 10 A**, não de 6 A
- [ ] **Fio rígido vermelho 1,00 mm²** e **azul claro 1,50 mm²** (ambos subiram)
- [ ] Fonte e conversores: recalcular orçamento com rendimento real após seleção dos modelos
- [ ] ⭐ **Sinaleiros 22 mm de 5 V** (não de 24 V) — e o ULN2803A e o soquete DIP-18 saíram da lista
- [ ] **Resistores de 220 Ω** (não 2,2 kΩ) para os LEDs da maquete, que agora são de 5 V

---

## ⚠️ Itens que NÃO existem mais nesta versão

| Item removido | Motivo |
|---|---|
| ~~Fonte ATX 500 W~~ | Não possui trilho de 24 V; substituída pela fonte chaveada de 24 V |
| ~~Jumper PS_ON (verde-preto)~~ | Era específico da ATX |
| ~~Módulo XL4016 (T1)~~ | **Plano B:** a potência térmica ligou direto em 24 V — não há tensão a transformar no ramal RM1 |
| ~~2× Módulo XL4015 (T2, T3)~~ | Uma revisão intermediária propôs LM2596; essa proposta também foi substituída. T2/T3 atuais continuam sem modelo aprovado |
| ~~6× Diodo Zener (5V6 / 13 V / 15 V)~~ | O descarte foi baseado em uma proposta anterior de LM2596; confirmar as proteções exigidas após selecionar T2/T3 |
| ~~Fusíveis F4 e F5 + 2 porta-fusíveis~~ | Eram os fusíveis de **saída** do crowbar. Os de **entrada** dos ramais (F1/F2/F3) continuam |
| ~~2× Voltímetro digital 3 fios~~ | Dispensados na revisão intermediária dos LM2596; não presumir display nos conversores atualmente propostos |
| ~~Tubo PVC Ø 63 mm + 2 tampas~~ | Era o corpo maior do T1; hoje os 3 postes usam Ø 50 mm |
| ~~Cooler 30 mm 12 V~~ | Ventilava o XL4016 dentro do T1 |
| ~~Fusível 6 A~~ | **F1 subiu para 10 A** (ramal RM1 conduz 6,0 A contínuos) |
| ~~Aquecedor PTC de 24 V / 80 W~~ | Substituído pela proposta provisória de **12 V / 50 W**; ramal, corte DC e proteção seguem bloqueados |
| ~~Resistor 220 Ω / 5 W (carga térmica do simulador)~~ | O DUT **não** simula carga térmica: são 8 posições de LED + resistor de ¼ W, **0,12 W cada** (~1 W no total), e o conjunto todo dissipa menos que uma das duas W5W antigas ([Doc 13 §13.2](../camada_1_maquete/13_posicoes_de_ensaio.md)) |
| ~~Resistor 2,2 kΩ (LEDs da maquete em 24 V)~~ | A iluminação da maquete passou para **5 V** — o limitador virou **220 Ω** |
| ~~4× resistor 220 Ω nos sinaleiros do painel~~ | Os sinaleiros passaram por duas mudanças: viraram módulos de 24 V com ULN2803, e depois **módulos de 5 V acionados direto pelo pino** — que dispensa CI e resistor. Os 220 Ω migraram para os LEDs da maquete |
| ~~Acrílico preto 3 mm (cobertura)~~ | Trocado por **branco**, visual de câmara frigorífica real |
| ~~Porta simples de acrílico 10 mm~~ | Trocada por **porta dupla com câmara de ar** (metade da perda térmica) |
| ~~XPS 20 mm~~ | Aumentado para **30 mm** |

> 📊 O script [`gerar_planilha_bom.py`](../gerar_planilha_bom.py) gera a planilha a partir das seções de compra e reconcilia os itens com o modelo React atual. As tabelas do carrinho e trechos marcados como históricos não são fonte de compra. Mesmo na planilha regenerada, ST-1/ST-2 permanecem pendentes: não comprar esses itens nem energizar o PTC até encerrar as validações.

---

📄 **Anterior:** [Doc 02 — Arquitetura de Energia](02_arquitetura_de_energia.md) · **Próximo:** [Doc 10 — Base e Chão de Fábrica](../camada_1_maquete/10_base_e_chao_de_fabrica.md)
