Brunobnhtr/projeto-integrador-camara-frigorifica/BOM_Projeto_Integrador.xlsx

Sheet: Lista de Compras
PROJETO INTEGRADOR — Planta Industrial Didática com Câmara Frigorífica
Lista de materiais · gerada de 03_lista_materiais.md em 01/11/2026 11:37 · arquitetura 127 V CA → 24 V CC → 12 / 5 / 3,3 V
BLOQUEIO: NÃO COMPRAR/MONTAR/ENERGIZAR PTC, T2 OU T3. BD-PTC permanece energizado na emergência; BTS em curto pode manter ≈4,17 A e desligar a ventoinha. Corte DC independente, F3 e condutores não definidos. Consulte Divergencias.
# | Item | Qtd | Especificação | Observação | 🔎 Mercado Livre | 🔎 Amazon BR | 🌏 AliExpress (importar) | Link escolhido (cole aqui) | Preço unit. (R$) | Total (R$)
E.1 — Subestação: entrada AC e fonte principal
1 | Fonte chaveada 24 Vcc | 1 | 24 V / 10 A / 240 W, bivolt 110-220 V (chave seletora ou auto-range). Modelo tipo S-240-24 | fonte chaveada 24v 10a 240w | 🔎 fonte chaveada 24v 10a 240w (https://lista.mercadolivre.com.br/fonte-chaveada-24v-10a-240w) | 🔎 Amazon (https://www.amazon.com.br/s?k=fonte+chaveada+24v+10a+240w)
2 | Disjuntor DIN 2P 6 A curva C | 1 | Bipolar, 6 A, curva C (por causa do inrush da fonte), 3 kA | disjuntor bipolar 6a curva c din | 🔎 disjuntor bipolar 6a curva c (https://lista.mercadolivre.com.br/disjuntor-bipolar-6a-curva-c-din) | 🔎 Amazon (https://www.amazon.com.br/s?k=disjuntor+bipolar+6a+curva+c+din)
3 | Cabo PP 3×1,5 mm² + plugue | 1,5 m | Cabo de entrada AC com plugue 2P+T 10 A | cabo pp 3x1,5 com plugue | 🔎 cabo pp 3x1,5 com plugue (https://lista.mercadolivre.com.br/cabo-pp-3x1-5-com-plugue) | 🔎 Amazon (https://www.amazon.com.br/s?k=cabo+pp+3x1%2C5+com+plugue)
4 | Prensa-cabo PG9 / PG13 | 3 | Entrada e saída de cabos da caixa da subestação | prensa cabo pg9 | 🔎 prensa cabo pg9 (https://lista.mercadolivre.com.br/prensa-cabo-pg9) | 🔎 Amazon (https://www.amazon.com.br/s?k=prensa+cabo+pg9)
5 | Borne DIN 4 mm² | 6 | Distribuição 24 V e 0 V na subestação | borne trilho din 4mm parafuso | 🔎 borne trilho din 4mm parafus (https://lista.mercadolivre.com.br/borne-trilho-din-4mm-parafuso) | 🔎 Amazon (https://www.amazon.com.br/s?k=borne+trilho+din+4mm+parafuso)
6 | Cooler 60 mm 24 V | 1 | Exaustão da casa de comando (~29 W de perda da fonte). ⚠️ Obrigatório, não opcional — a casinha encolheu para 250 × 150 × 90 mm e a fonte continua dissipando o mesmo. ⚠️ 24 V: é a única tensão de saída disponível. Alternativa: 2× de 12 V em série | cooler 60mm 24v | 🔎 cooler 60mm 24v (https://lista.mercadolivre.com.br/cooler-60mm-24v) | 🔎 Amazon (https://www.amazon.com.br/s?k=cooler+60mm+24v) | 🌏 60mm fan 24V DC (https://pt.aliexpress.com/w/wholesale-60mm-fan-24v-dc.html)
7 | Grade + filtro 60 mm | 1 | Veneziana de entrada de ar da subestação | grade cooler 60mm com filtro | 🔎 grade cooler 60mm com filtro (https://lista.mercadolivre.com.br/grade-cooler-60mm-com-filtro) | 🔎 Amazon (https://www.amazon.com.br/s?k=grade+cooler+60mm+com+filtro)
E.2 — Conversores de tensão (os "transformadores" da maquete)
8 | Acrílico transparente 1 mm | 1 lâmina | Janelas dos postes somente se o conversor escolhido tiver display e a decisão de exibição for mantida; modelo ainda pendente | — | 🔎 acrilico transparente 1 mm (https://lista.mercadolivre.com.br/acrilico-transparente-1-mm) | 🔎 Amazon (https://www.amazon.com.br/s?k=acrilico+transparente+1+mm)
9 | Voltímetro + amperímetro digital 3 fios | 1 | Único medidor comprado à parte — vai na caixa de derivação do P1, mostrando os 24,0 V do barramento e a corrente das Peltier ao vivo. Faixa: 0-100 V / 10 A | — | 🔎 voltimetro amperimetro digit (https://lista.mercadolivre.com.br/voltimetro-amperimetro-digital-3-fios) | 🔎 Amazon (https://www.amazon.com.br/s?k=voltimetro+amperimetro+digital+3+fios) | 🌏 DC voltmeter ammeter 100V (https://pt.aliexpress.com/w/wholesale-dc-voltmeter-ammeter-100v-10a-digital.html)
E.3 — Proteção do sistema de energia
10 | Porta-fusível mini automotivo | 3 | Fusível de LÂMINA (automotivo), não de vidro. Trilho DIN 35 mm ou bloco parafusado — ver nota abaixo | F1, F2, F3 — entrada dos 3 ramais, na subestação | 🔎 porta fusivel mini automotiv (https://lista.mercadolivre.com.br/porta-fusivel-mini-automotivo) | 🔎 Amazon (https://www.amazon.com.br/s?k=porta+fusivel+mini+automotivo)
11 | *Alternativa:* bloco de 3 posições para fusível lâmina | 1 | Substitui os 3 suportes acima. ⚠️ Conferir: fusível lâmina · ≥ 10 A por posição · ≥ 32 Vdc · preferir entrada comum (1 entrada + 3 saídas). Parafusa na parede da caixa — dispensa trilho DIN na subestação | idem | 🔎 alternativa bloco 3 posicoes (https://lista.mercadolivre.com.br/alternativa-bloco-3-posicoes-fusivel-lamina) | 🔎 Amazon (https://www.amazon.com.br/s?k=alternativa+bloco+3+posicoes+fusivel+lamina)
12 | Fusível mini automotivo 10 A | 2 | 1 uso + 1 reserva | F1 — ramal RM1 (potência 24 V, 6,0 A) | 🔎 fusivel mini automotivo 10 (https://lista.mercadolivre.com.br/fusivel-mini-automotivo-10) | 🔎 Amazon (https://www.amazon.com.br/s?k=fusivel+mini+automotivo+10)
13 | Fusível mini automotivo 2 A | 3 | 1 uso + 2 reservas | F2 (comando); F3 para T3 está pendente de dimensionamento e não é item liberado | 🔎 fusivel mini automotivo 2 (https://lista.mercadolivre.com.br/fusivel-mini-automotivo-2) | 🔎 Amazon (https://www.amazon.com.br/s?k=fusivel+mini+automotivo+2)
14 | Terminal olhal M4 amarelo | 10 | Aterramento e barramento de 0 V | — | 🔎 terminal olhal m4 amarelo (https://lista.mercadolivre.com.br/terminal-olhal-m4-amarelo) | 🔎 Amazon (https://www.amazon.com.br/s?k=terminal+olhal+m4+amarelo)
M.1 — Base e estrutura
15 | MDF 12 mm | 1 chapa | 1500 × 500 mm — tampo da base |  | 🔎 mdf 12 mm (https://lista.mercadolivre.com.br/mdf-12-mm) | 🔎 Amazon (https://www.amazon.com.br/s?k=mdf+12+mm)
16 | MDF 15 mm | — | Moldura perimetral 40 mm de altura (4 tiras) |  | 🔎 mdf 15 mm (https://lista.mercadolivre.com.br/mdf-15-mm) | 🔎 Amazon (https://www.amazon.com.br/s?k=mdf+15+mm)
17 | MDF 15 mm | 3 tiras | Travessas de reforço 15 × 40 mm, com entalhe de 20 × 25 mm no centro |  | 🔎 mdf 15 mm (https://lista.mercadolivre.com.br/mdf-15-mm) | 🔎 Amazon (https://www.amazon.com.br/s?k=mdf+15+mm)
18 | Pés de borracha antiderrapante | 8 | Autoadesivos, Ø 25 mm — a base tem 1,5 m e pesa ~18 kg |  | 🔎 pes borracha antiderrapante (https://lista.mercadolivre.com.br/pes-borracha-antiderrapante) | 🔎 Amazon (https://www.amazon.com.br/s?k=pes+borracha+antiderrapante)
19 | Conector circular GX16 8 pinos | 1 par | Opcional — só na versão modular (união elétrica entre os 2 módulos) |  | 🔎 conector circular gx16 8 pin (https://lista.mercadolivre.com.br/conector-circular-gx16-8-pinos) | 🔎 Amazon (https://www.amazon.com.br/s?k=conector+circular+gx16+8+pinos) | 🌏 GX16 8 pin aviation connec (https://pt.aliexpress.com/w/wholesale-gx16-8-pin-aviation-connector.html)
20 | Pinos-guia Ø 6 mm + buchas | 2 | Opcional — alinhamento dos módulos |  | 🔎 pinos guia 6 mm buchas (https://lista.mercadolivre.com.br/pinos-guia-6-mm-buchas) | 🔎 Amazon (https://www.amazon.com.br/s?k=pinos+guia+6+mm+buchas)
21 | Alças de transporte | 2 | Alça embutida de baú/case, laterais |  | 🔎 alcas transporte (https://lista.mercadolivre.com.br/alcas-transporte) | 🔎 Amazon (https://www.amazon.com.br/s?k=alcas+transporte)
22 | Parafusos M5×20, M4×16, M3×12 | kits | Fixações gerais |  | 🔎 parafusos m5 20, m4 16, m3 1 (https://lista.mercadolivre.com.br/parafusos-m5-20-m4-16-m3-12) | 🔎 Amazon (https://www.amazon.com.br/s?k=parafusos+m5+20%2C+m4+16%2C+m3+12)
23 | Insertos rosqueados M4/M5 p/ MDF | 20 | Evita espanar a rosca no MDF |  | 🔎 insertos rosqueados m4 m5 p (https://lista.mercadolivre.com.br/insertos-rosqueados-m4-m5-p-mdf) | 🔎 Amazon (https://www.amazon.com.br/s?k=insertos+rosqueados+m4+m5+p+mdf)
M.2 — Subestação (caixa)
24 | MDF 9 mm ou acrílico opaco 4 mm | — | CASA DE COMANDO 250 × 150 × 90 mm (L×P×A), face de operação voltada para a rua. Abriga apenas fonte, disjuntor e chave — os fusíveis de 24 V ficam no pátio aberto |  | 🔎 mdf 9 mm acrilico opaco 4 mm (https://lista.mercadolivre.com.br/mdf-9-mm-acrilico-opaco-4-mm) | 🔎 Amazon (https://www.amazon.com.br/s?k=mdf+9+mm+acrilico+opaco+4+mm)
25 | Fio verde-amarelo 0,75 mm² | 1 m | ⚡ Aterramento das estruturas metálicas do pátio à barra de terra (equipotencialização). Torre real é aterrada — vale ponto na defesa |  | 🔎 fio verde amarelo 0,75 mm (https://lista.mercadolivre.com.br/fio-verde-amarelo-0-75-mm) | 🔎 Amazon (https://www.amazon.com.br/s?k=fio+verde+amarelo+0%2C75+mm)
26 | *Opcional:* arame / barra de latão 1,5–2 mm | 2 m | Estruturas treliçadas do pátio. ⚠️ Latão aceita solda de estanho; alumínio não — se quiser treliça soldada, é latão |  | 🔎 arame barra latao 1,5 2 mm (https://lista.mercadolivre.com.br/arame-barra-latao-1-5-2-mm) | 🔎 Amazon (https://www.amazon.com.br/s?k=arame+barra+latao+1%2C5+2+mm)
27 | Dobradiça pequena + fecho | 1 jogo | Tampa de manutenção |  | 🔎 dobradica pequena fecho (https://lista.mercadolivre.com.br/dobradica-pequena-fecho) | 🔎 Amazon (https://www.amazon.com.br/s?k=dobradica+pequena+fecho)
28 | Tela metálica / alambrado miniatura | 1 | Cerca do pátio (tela de aço, malha 3 mm). ⚠️ Funcional, não decorativa: com o pátio aberto, é ela que delimita a área e impede aproximação — mesma função da cerca de uma subestação real |  | 🔎 tela metalica alambrado mini (https://lista.mercadolivre.com.br/tela-metalica-alambrado-miniatura) | 🔎 Amazon (https://www.amazon.com.br/s?k=tela+metalica+alambrado+miniatura)
29 | Pedrisco / brita fina (aquário) | 500 g | Piso do pátio da subestação — como nas subestações reais |  | 🔎 pedrisco brita fina (https://lista.mercadolivre.com.br/pedrisco-brita-fina) | 🔎 Amazon (https://www.amazon.com.br/s?k=pedrisco+brita+fina)
30 | Placa "PERIGO ALTA TENSÃO" | 2 | Impressa em papel adesivo, ~15 × 10 mm |  | 🔎 placa perigo alta tensao (https://lista.mercadolivre.com.br/placa-perigo-alta-tensao) | 🔎 Amazon (https://www.amazon.com.br/s?k=placa+perigo+alta+tensao)
M.3 — Postes e linha de distribuição
31 | Tubo de alumínio Ø 8 mm | 1,5 m | Cortar em 3 postes de 350 mm (300 mm visíveis + 50 mm de encaixe) |  | 🔎 tubo aluminio 8 mm (https://lista.mercadolivre.com.br/tubo-aluminio-8-mm) | 🔎 Amazon (https://www.amazon.com.br/s?k=tubo+aluminio+8+mm)
32 | Barra chata de alumínio 12 × 2 mm | 40 cm | Cruzetas — 3 peças de 90 mm + 3 de 60 mm |  | 🔎 barra chata aluminio 12 2 mm (https://lista.mercadolivre.com.br/barra-chata-aluminio-12-2-mm) | 🔎 Amazon (https://www.amazon.com.br/s?k=barra+chata+aluminio+12+2+mm)
33 | Fio rígido ENCAPADO 1,00 mm² VERMELHO ⬆ | 2 m | Ramal R1 (potência, 6,0 A). ⚠️ Subiu de 0,75 para 1,00 mm² por causa da corrente das 2 Peltier. Nunca condutor nu — em CC qualquer ponte metálica é curto franco |  | 🔎 fio rigido encapado 1,00 mm (https://lista.mercadolivre.com.br/fio-rigido-encapado-1-00-mm-vermelho) | 🔎 Amazon (https://www.amazon.com.br/s?k=fio+rigido+encapado+1%2C00+mm+vermelho)
34 | Fio rígido ENCAPADO 0,50 mm² MARROM | 2 m | Ramal R2 (comando) |  | 🔎 fio rigido encapado 0,50 mm (https://lista.mercadolivre.com.br/fio-rigido-encapado-0-50-mm-marrom) | 🔎 Amazon (https://www.amazon.com.br/s?k=fio+rigido+encapado+0%2C50+mm+marrom)
35 | Fio rígido ENCAPADO 0,50 mm² CINZA | 2 m | Ramal R3 (auxiliares) |  | 🔎 fio rigido encapado 0,50 mm (https://lista.mercadolivre.com.br/fio-rigido-encapado-0-50-mm-cinza) | 🔎 Amazon (https://www.amazon.com.br/s?k=fio+rigido+encapado+0%2C50+mm+cinza)
36 | Fio rígido ENCAPADO 1,50 mm² AZUL CLARO ⬆ | 2 m | Retorno comum 0 V — o "neutro" da linha, 40 mm abaixo da cruzeta. Subiu de 1,00 para 1,50 mm²: conduz a soma dos 3 ramais (7,11 A) |  | 🔎 fio rigido encapado 1,50 mm (https://lista.mercadolivre.com.br/fio-rigido-encapado-1-50-mm-azul-claro) | 🔎 Amazon (https://www.amazon.com.br/s?k=fio+rigido+encapado+1%2C50+mm+azul+claro)
37 | Contas/miçangas marrom ou branca Ø 6 mm | 20 | Isoladores de pino da cruzeta |  | 🔎 contas micangas marrom branc (https://lista.mercadolivre.com.br/contas-micangas-marrom-branca-6-mm) | 🔎 Amazon (https://www.amazon.com.br/s?k=contas+micangas+marrom+branca+6+mm)
38 | Tubo de PVC Ø 50 mm | 24 cm | Corpos dos 3 postes — 8 cm cada: T2 (P2), T3 (P3) e a caixa de derivação (P1). Agora os três têm o mesmo diâmetro, porque o P1 deixou de ter conversor |  | 🔎 tubo pvc 50 mm (https://lista.mercadolivre.com.br/tubo-pvc-50-mm) | 🔎 Amazon (https://www.amazon.com.br/s?k=tubo+pvc+50+mm)
39 | Tampa/cap PVC Ø 50 mm | 6 | Tampas dos 3 corpos |  | 🔎 tampa cap pvc 50 mm (https://lista.mercadolivre.com.br/tampa-cap-pvc-50-mm) | 🔎 Amazon (https://www.amazon.com.br/s?k=tampa+cap+pvc+50+mm)
40 | Cinta de alumínio 10 mm | 1 m | Fixação dos transformadores e da caixa de derivação nos postes |  | 🔎 cinta aluminio 10 mm (https://lista.mercadolivre.com.br/cinta-aluminio-10-mm) | 🔎 Amazon (https://www.amazon.com.br/s?k=cinta+aluminio+10+mm)
41 | Bornes de emenda pequenos (2 ou 3 vias) | 2 | Dentro da caixa de derivação do P1 — ali os 24 V só se distribuem, não se transformam |  | 🔎 bornes emenda pequenos (https://lista.mercadolivre.com.br/bornes-emenda-pequenos) | 🔎 Amazon (https://www.amazon.com.br/s?k=bornes+emenda+pequenos)
42 | Flange/base de fixação dos postes | 3 | Podem ser feitas com sobra de MDF + insertos M4 |  | 🔎 flange base fixacao postes (https://lista.mercadolivre.com.br/flange-base-fixacao-postes) | 🔎 Amazon (https://www.amazon.com.br/s?k=flange+base+fixacao+postes)
43 | Etiquetas adesivas impressas | 3 | Identificação dos corpos: "P1 — DERIVAÇÃO 24 V", "T2 — 24/5 V", "T3 — 24/12 V" |  | 🔎 etiquetas adesivas impressas (https://lista.mercadolivre.com.br/etiquetas-adesivas-impressas) | 🔎 Amazon (https://www.amazon.com.br/s?k=etiquetas+adesivas+impressas)
M.4 — Rua e entrada da empresa (zona externa)
44 | Tinta spray cinza-asfalto escuro fosco | 1 | Pista da rua |  | 🔎 tinta spray cinza asfalto es (https://lista.mercadolivre.com.br/tinta-spray-cinza-asfalto-escuro-fosco) | 🔎 Amazon (https://www.amazon.com.br/s?k=tinta+spray+cinza+asfalto+escuro+fosco)
45 | Tubo de alumínio Ø 5 mm | 60 cm | 3 postes de iluminação pública de 180 mm — ⚠️ diferentes dos postes de distribuição |  | 🔎 tubo aluminio 5 mm (https://lista.mercadolivre.com.br/tubo-aluminio-5-mm) | 🔎 Amazon (https://www.amazon.com.br/s?k=tubo+aluminio+5+mm)
46 | Arame 1,5 mm | 1 m | Braço curvo das luminárias e estrutura do portão |  | 🔎 arame 1,5 mm (https://lista.mercadolivre.com.br/arame-1-5-mm) | 🔎 Amazon (https://www.amazon.com.br/s?k=arame+1%2C5+mm)
47 | LED 3 mm branco quente | 4 | 3 luminárias da rua + 1 na guarita. Alimentados em 5 V (BD-5V), com 220 Ω em série, sempre acesos. Vf ≈ 3,1 V |  | 🔎 led 3 mm branco quente (https://lista.mercadolivre.com.br/led-3-mm-branco-quente) | 🔎 Amazon (https://www.amazon.com.br/s?k=led+3+mm+branco+quente) | 🌏 3mm warm white LED (https://pt.aliexpress.com/w/wholesale-3mm-warm-white-led.html)
48 | Resistor 220 Ω 1/4 W | — | Limitador dos LEDs da rua — já contabilizado na lista L.4, não compre de novo. ⚠️ Valor dimensionado para 5 V: (5 − 3,1)/220 = 8,6 mA. Monte cada um dentro da base do poste, com termorretrátil |  | 🔎 resistor 220 1 4 w (https://lista.mercadolivre.com.br/resistor-220-1-4-w) | 🔎 Amazon (https://www.amazon.com.br/s?k=resistor+220+1+4+w) | 🌏 1/4W resistor kit assorted (https://pt.aliexpress.com/w/wholesale-1-4w-resistor-kit-assorted.html)
49 | Carro de passeio miniatura 1:50 | 2 | ~88 mm. Se só achar 1:64 (68 mm), pode usar — mas não misture escalas |  | 🔎 carro passeio miniatura 1 50 (https://lista.mercadolivre.com.br/carro-passeio-miniatura-1-50) | 🔎 Amazon (https://www.amazon.com.br/s?k=carro+passeio+miniatura+1+50)
50 | Caminhão / van 1:50 | 1 | ~150 mm, entrando pelo portão |  | 🔎 caminhao van 1 50 (https://lista.mercadolivre.com.br/caminhao-van-1-50) | 🔎 Amazon (https://www.amazon.com.br/s?k=caminhao+van+1+50)
51 | Tira de MDF 3 mm | 1,5 m | Meio-fio (guia), 4 mm de altura, pintado de branco |  | 🔎 tira mdf 3 mm (https://lista.mercadolivre.com.br/tira-mdf-3-mm) | 🔎 Amazon (https://www.amazon.com.br/s?k=tira+mdf+3+mm)
52 | Fita branca 2 mm ou caneta posca branca | 1 | Faixa central tracejada, faixa de bordo e faixa de pedestres |  | 🔎 fita branca 2 mm caneta posc (https://lista.mercadolivre.com.br/fita-branca-2-mm-caneta-posca-branca) | 🔎 Amazon (https://www.amazon.com.br/s?k=fita+branca+2+mm+caneta+posca+branca)
53 | MDF 4 mm | — | Muro da empresa: 50 mm de altura × 290 mm, em X = 640 |  | 🔎 mdf 4 mm (https://lista.mercadolivre.com.br/mdf-4-mm) | 🔎 Amazon (https://www.amazon.com.br/s?k=mdf+4+mm)
54 | MDF 4 mm | — | Guarita 45 × 45 × 55 mm, com janela recortada |  | 🔎 mdf 4 mm (https://lista.mercadolivre.com.br/mdf-4-mm) | 🔎 Amazon (https://www.amazon.com.br/s?k=mdf+4+mm)
55 | Tinta azul industrial | 1 | Portão corrediço |  | 🔎 tinta azul industrial (https://lista.mercadolivre.com.br/tinta-azul-industrial) | 🔎 Amazon (https://www.amazon.com.br/s?k=tinta+azul+industrial)
56 | Árvores de maquete | 3 | Escala 1:50, na calçada da frente |  | 🔎 arvores maquete (https://lista.mercadolivre.com.br/arvores-maquete) | 🔎 Amazon (https://www.amazon.com.br/s?k=arvores+maquete)
57 | Placas de trânsito miniatura | 2 | "PARE" e "VELOCIDADE MÁXIMA 10 km/h" |  | 🔎 placas transito miniatura (https://lista.mercadolivre.com.br/placas-transito-miniatura) | 🔎 Amazon (https://www.amazon.com.br/s?k=placas+transito+miniatura)
58 | Lixeira urbana + abrigo de ônibus | 1 cada | Opcional — enriquece a cena |  | 🔎 lixeira urbana abrigo onibus (https://lista.mercadolivre.com.br/lixeira-urbana-abrigo-onibus) | 🔎 Amazon (https://www.amazon.com.br/s?k=lixeira+urbana+abrigo+onibus)
M.5 — Chão de fábrica (cenografia)
59 | Tinta spray cinza claro fosco | 2 | Piso industrial (epóxi) |  | 🔎 tinta spray cinza claro fosc (https://lista.mercadolivre.com.br/tinta-spray-cinza-claro-fosco) | 🔎 Amazon (https://www.amazon.com.br/s?k=tinta+spray+cinza+claro+fosco)
60 | Tinta spray preto fosco | 1 | Estruturas e acabamento |  | 🔎 tinta spray preto fosco (https://lista.mercadolivre.com.br/tinta-spray-preto-fosco) | 🔎 Amazon (https://www.amazon.com.br/s?k=tinta+spray+preto+fosco)
61 | Verniz fosco spray | 1 | Proteção final do piso pintado |  | 🔎 verniz fosco spray (https://lista.mercadolivre.com.br/verniz-fosco-spray) | 🔎 Amazon (https://www.amazon.com.br/s?k=verniz+fosco+spray)
62 | Fita adesiva amarela 10 mm | 1 rolo | Demarcação de corredores e áreas |  | 🔎 fita adesiva amarela 10 mm (https://lista.mercadolivre.com.br/fita-adesiva-amarela-10-mm) | 🔎 Amazon (https://www.amazon.com.br/s?k=fita+adesiva+amarela+10+mm)
63 | Fita zebrada amarelo/preto 20 mm | 1 rolo | Faixa de segurança em frente ao painel (exigência NR-10 — zona de trabalho) |  | 🔎 fita zebrada amarelo preto 2 (https://lista.mercadolivre.com.br/fita-zebrada-amarelo-preto-20-mm) | 🔎 Amazon (https://www.amazon.com.br/s?k=fita+zebrada+amarelo+preto+20+mm)
64 | Fita adesiva verde 10 mm | 1 rolo | Rota de fuga |  | 🔎 fita adesiva verde 10 mm (https://lista.mercadolivre.com.br/fita-adesiva-verde-10-mm) | 🔎 Amazon (https://www.amazon.com.br/s?k=fita+adesiva+verde+10+mm)
65 | Figuras de maquete escala 1:50 | 10 | (4 na fábrica, 3 na rua, 3 reservas) Pessoas com EPI (loja de maquetaria/arquitetura) |  | 🔎 figuras maquete escala 1 50 (https://lista.mercadolivre.com.br/figuras-maquete-escala-1-50) | 🔎 Amazon (https://www.amazon.com.br/s?k=figuras+maquete+escala+1+50)
66 | Miniaturas: empilhadeira, pallets, tambores | — | Ambientação do chão de fábrica |  | 🔎 miniaturas empilhadeira, pal (https://lista.mercadolivre.com.br/miniaturas-empilhadeira-pallets-tambores) | 🔎 Amazon (https://www.amazon.com.br/s?k=miniaturas+empilhadeira%2C+pallets%2C+tambores)
67 | Extintor miniatura + placa | 2 | Sinalização de segurança |  | 🔎 extintor miniatura placa (https://lista.mercadolivre.com.br/extintor-miniatura-placa) | 🔎 Amazon (https://www.amazon.com.br/s?k=extintor+miniatura+placa)
68 | Placas de sinalização impressas | 1 folha | "RISCO ELÉTRICO", "USO OBRIGATÓRIO DE EPI", "SAÍDA" — papel adesivo |  | 🔎 placas sinalizacao impressas (https://lista.mercadolivre.com.br/placas-sinalizacao-impressas) | 🔎 Amazon (https://www.amazon.com.br/s?k=placas+sinalizacao+impressas)
69 | Eletrocalha / perfilado aéreo | 60 cm | Canaleta de acrílico ou perfil U de alumínio — leva os cabos do painel à câmara por cima, como na indústria |  | 🔎 eletrocalha perfilado aereo (https://lista.mercadolivre.com.br/eletrocalha-perfilado-aereo) | 🔎 Amazon (https://www.amazon.com.br/s?k=eletrocalha+perfilado+aereo)
70 | Suportes/mãos-francesas da eletrocalha | 4 | Cantoneira de alumínio |  | 🔎 suportes maos francesas elet (https://lista.mercadolivre.com.br/suportes-maos-francesas-eletrocalha) | 🔎 Amazon (https://www.amazon.com.br/s?k=suportes+maos+francesas+eletrocalha)
71 | EVA ou MDF 6 mm | — | Bases de máquinas fictícias e plataformas |  | 🔎 eva mdf 6 mm (https://lista.mercadolivre.com.br/eva-mdf-6-mm) | 🔎 Amazon (https://www.amazon.com.br/s?k=eva+mdf+6+mm)
C.2 — Isolamento térmico
72 | ⭐ Fita adesiva de alumínio 50 mm | 3 rolos | 🔧 Virou o isolamento E a superfície externa da câmara. Reveste toda a caixa por fora e sela todas as juntas coladas do acrílico. Com ε ≈ 0,05 ela mais que dobra a resistência de superfície (0,13 → 0,31 m²·K/W). ⚠️ Barreira de vapor é a função mais importante dela — quanto menos vapor entra, mais a sílica dura e menos gelo se forma |  | 🔎 fita adesiva aluminio 50 mm (https://lista.mercadolivre.com.br/fita-adesiva-aluminio-50-mm) | 🔎 Amazon (https://www.amazon.com.br/s?k=fita+adesiva+aluminio+50+mm)
73 | Manta elastomérica autoadesiva 6 mm | 1 m² | Tipo Armaflex — cantos, arestas e ao redor das passagens de cabo |  | 🔎 manta elastomerica autoadesi (https://lista.mercadolivre.com.br/manta-elastomerica-autoadesiva-6-mm) | 🔎 Amazon (https://www.amazon.com.br/s?k=manta+elastomerica+autoadesiva+6+mm)
74 | Espuma expansiva PU (mini) | 1 | Selagem das passagens de cabo |  | 🔎 espuma expansiva pu (https://lista.mercadolivre.com.br/espuma-expansiva-pu) | 🔎 Amazon (https://www.amazon.com.br/s?k=espuma+expansiva+pu)
C.3 — Vedação, porta e condensado
75 | Perfil EPDM tubular autoadesivo 9 × 6 mm | 2 m | Vedação da porta — perfil tubular comprime muito melhor que o chato de 5 mm |  | 🔎 perfil epdm tubular autoades (https://lista.mercadolivre.com.br/perfil-epdm-tubular-autoadesivo-9-6-mm) | 🔎 Amazon (https://www.amazon.com.br/s?k=perfil+epdm+tubular+autoadesivo+9+6+mm)
76 | Dobradiça piano de alumínio | 1 | 250 mm (cortar de uma barra de 75 cm) |  | 🔎 dobradica piano aluminio (https://lista.mercadolivre.com.br/dobradica-piano-aluminio) | 🔎 Amazon (https://www.amazon.com.br/s?k=dobradica+piano+aluminio)
77 | Fecho de pressão (borboleta) inox | 2 | Comprime a vedação — tipo fecho de baú |  | 🔎 fecho pressao inox (https://lista.mercadolivre.com.br/fecho-pressao-inox) | 🔎 Amazon (https://www.amazon.com.br/s?k=fecho+pressao+inox)
78 | Puxador de câmara fria (miniatura) | 1 | Estética — pode ser um puxador de móvel pequeno |  | 🔎 puxador camara fria (https://lista.mercadolivre.com.br/puxador-camara-fria) | 🔎 Amazon (https://www.amazon.com.br/s?k=puxador+camara+fria)
79 | Cola S-320 Sinteglas | 250 ml | Colagem de acrílico por capilaridade |  | 🔎 cola s 320 sinteglas (https://lista.mercadolivre.com.br/cola-s-320-sinteglas) | 🔎 Amazon (https://www.amazon.com.br/s?k=cola+s+320+sinteglas)
80 | Silicone neutro transparente | 1 tubo | Vedação de juntas (⚠️ neutro, o acético ataca o acrílico) |  | 🔎 silicone neutro transparente (https://lista.mercadolivre.com.br/silicone-neutro-transparente) | 🔎 Amazon (https://www.amazon.com.br/s?k=silicone+neutro+transparente)
81 | ⭐ Bandeja de alumínio REMOVÍVEL | 1 | ~190 × 90 mm, sem furo — desliza para fora para esvaziar. 🔧 Era fixa e inclinada, com dreno |  | 🔎 bandeja aluminio removivel (https://lista.mercadolivre.com.br/bandeja-aluminio-removivel) | 🔎 Amazon (https://www.amazon.com.br/s?k=bandeja+aluminio+removivel)
82 | ⭐ Tubo de silicone Ø 4 mm | 40 cm | RESPIRO, enrolado em espiral dentro da câmara. ⚠️ Não é opcional: resfriar de 25 para 5 °C contrai o ar 6,7 % e, numa câmara bem vedada, isso dá 34 kgf puxando a porta para dentro. O caminho longo e estreito equaliza a pressão e quase não deixa vapor passar |  | 🔎 tubo silicone 4 mm (https://lista.mercadolivre.com.br/tubo-silicone-4-mm) | 🔎 Amazon (https://www.amazon.com.br/s?k=tubo+silicone+4+mm)
83 | ⭐ Sílica gel indicadora | 4 sachês | 3 na câmara + 1 dentro da câmara de ar da porta dupla. Azul → rosa = trocar. Regenera no forno a 120 °C por 2 h |  | 🔎 silica gel indicadora (https://lista.mercadolivre.com.br/silica-gel-indicadora) | 🔎 Amazon (https://www.amazon.com.br/s?k=silica+gel+indicadora)
L.1 — Controle e interface
84 | Arduino Mega 2560 R3 | 1 | 1 controlador em uso; reserva opcional |  | 🔎 arduino mega 2560 r3 (https://lista.mercadolivre.com.br/arduino-mega-2560-r3) | 🔎 Amazon (https://www.amazon.com.br/s?k=arduino+mega+2560+r3) | 🌏 Arduino Mega 2560 R3 (https://pt.aliexpress.com/w/wholesale-arduino-mega-2560-r3.html)
85 | Shield de expansão Mega (bornes parafuso) | 1 | Sensor Shield V2.0 |  | 🔎 shield expansao mega (https://lista.mercadolivre.com.br/shield-expansao-mega) | 🔎 Amazon (https://www.amazon.com.br/s?k=shield+expansao+mega)
86 | Suporte DIN para Arduino Mega | 1 | Ou SPCI4/adaptador |  | 🔎 suporte din arduino mega (https://lista.mercadolivre.com.br/suporte-din-arduino-mega) | 🔎 Amazon (https://www.amazon.com.br/s?k=suporte+din+arduino+mega)
87 | ⭐ ES3C28P — ESP32-S3 2,8" toque capacitivo, microSD, microfone (LCDWIKI) | 1 | A IHM do projeto. Substitui a tela Nextion e o módulo de cartão SD. 8 MB de PSRAM → a Xiaozhi roda. ILI9341V 240×320, toque capacitivo FT6336G, 5 V / 140 mA, −30 a 80 °C. Vem com alto-falante. ⚠️ Comprar a versão ES3C28P (com toque) — a ES3N28P é sem toque |  | 🔎 es3c28p esp32 s3 2,8 toque c (https://lista.mercadolivre.com.br/es3c28p-esp32-s3-2-8-toque-capacitivo-microsd) | 🔎 Amazon (https://www.amazon.com.br/s?k=es3c28p+esp32+s3+2%2C8+toque+capacitivo%2C+microsd%2C)
L.2 — Potência e acionamento
88 | Driver ponte-H BTS7960 | 2 | 43 A, pino IS de diagnóstico |  | 🔎 driver ponte h bts7960 (https://lista.mercadolivre.com.br/driver-ponte-h-bts7960) | 🔎 Amazon (https://www.amazon.com.br/s?k=driver+ponte+h+bts7960) | 🌏 BTS7960 43A motor driver m (https://pt.aliexpress.com/w/wholesale-bts7960-43a-motor-driver-module.html)
89 | Suporte SPCI4 trilho DIN | 2 | Fixa PCI 100 × 79 mm |  | 🔎 suporte spci4 trilho din (https://lista.mercadolivre.com.br/suporte-spci4-trilho-din) | 🔎 Amazon (https://www.amazon.com.br/s?k=suporte+spci4+trilho+din)
90 | Cooler 40 mm 12 V | 1 | Refrigeração dos BTS |  | 🔎 cooler 40 mm 12 v (https://lista.mercadolivre.com.br/cooler-40-mm-12-v) | 🔎 Amazon (https://www.amazon.com.br/s?k=cooler+40+mm+12+v) | 🌏 40mm fan 12V DC (https://pt.aliexpress.com/w/wholesale-40mm-fan-12v-dc.html)
91 | KM1 — Relé 8 pinos 24 Vcc + base DIN | 2 | 1 conjunto em uso + 1 reserva; confirmar rating CC na ficha do modelo exato |  | 🔎 rele 8 pinos 24 vcc base din (https://lista.mercadolivre.com.br/rele-8-pinos-24-vcc-base-din) | 🔎 Amazon (https://www.amazon.com.br/s?k=rele+8+pinos+24+vcc+base+din) | 🌏 HH64P LY4NJ 24VDC relay 10 (https://pt.aliexpress.com/w/wholesale-hh64p-ly4nj-24vdc-relay-10a-14-pin-ptf14a-socket.html)
92 | *Alternativa premium (só se sobrar orçamento)* | — | Finder 46.61 24VDC (1 reversível 16 A) + base 95.05 para o KM1, ~R$ 80–110. Vale se você quiser folga grande sobre os 6,0 A e datasheet publicado |  | 🔎 alternativa premium (https://lista.mercadolivre.com.br/alternativa-premium) | 🔎 Amazon (https://www.amazon.com.br/s?k=alternativa+premium)
L.3 — Atuadores térmicos e ventilação
93 | ⭐ Kit duplo de refrigeração Peltier (2× TEC1-12706) | 1 | Adotado — kit já conferido por foto (imagens/peltir.avif): 2 conjuntos lado a lado, cada pastilha com seu par de fios e cada ventoinha com cabo próprio, o que viabiliza as modificações 1 e 2 sem cortar nada. Traz 2 pastilhas + radiador + 2 blocos frios + ventoinhas + montagem térmica pronta. Anunciado como 12 V / 15 A, ou seja, vem ligado em PARALELO — ⚠️ religar em SÉRIE para 24 V / 6,0 A (ver as 3 modificações abaixo). ~200 × 115 × 85 mm. Buscar kit peltier duplo TEC1-12706 refrigeração |  | 🔎 kit duplo refrigeracao pelti (https://lista.mercadolivre.com.br/kit-duplo-refrigeracao-peltier) | 🔎 Amazon (https://www.amazon.com.br/s?k=kit+duplo+refrigeracao+peltier) | 🌏 dual TEC1-12706 peltier co (https://pt.aliexpress.com/w/wholesale-dual-tec1-12706-peltier-cooler-kit-12v.html)
94 | Pastilha Peltier TEC1-12706 avulsa | 1 | Reserva. ⚠️ Trocar uma pastilha do kit exige desmontar a junta térmica — tenha a peça, mas conte com o trabalho |  | 🔎 pastilha peltier tec1 12706 (https://lista.mercadolivre.com.br/pastilha-peltier-tec1-12706-avulsa) | 🔎 Amazon (https://www.amazon.com.br/s?k=pastilha+peltier+tec1+12706+avulsa) | 🌏 TEC1-12706 peltier module (https://pt.aliexpress.com/w/wholesale-tec1-12706-peltier-module.html)
L.4 — Sensores
95 | Sensor AM2315C | 1 | I²C, umidade + temperatura, carcaça selada |  | 🔎 sensor am2315c (https://lista.mercadolivre.com.br/sensor-am2315c) | 🔎 Amazon (https://www.amazon.com.br/s?k=sensor+am2315c) | 🌏 AM2315C temperature humidi (https://pt.aliexpress.com/w/wholesale-am2315c-temperature-humidity-sensor.html)
L.5 — Módulos de interface e componentes em borne
96 | Capacitor cerâmico 100 nF | 4 | C1 e C2 + reservas — parafusados nos bornes do Mega (A0–GND2 e A1–GND2), sem solda | — | 🔎 capacitor ceramico 100 nf (https://lista.mercadolivre.com.br/capacitor-ceramico-100-nf) | 🔎 Amazon (https://www.amazon.com.br/s?k=capacitor+ceramico+100+nf) | 🌏 100nF ceramic capacitor (https://pt.aliexpress.com/w/wholesale-100nf-ceramic-capacitor.html)
97 | ⭐ Módulo relé 1 canal 5 V, optoacoplado | 3 | KA1 (NO), KA2 (NC) e KA3 (NO), conforme módulos e contatos do modelo atual | 6,79 | 🔎 modulo rele 1 canal 5 v, opt (https://lista.mercadolivre.com.br/modulo-rele-1-canal-5-v-optoacoplado) | 🔎 Amazon (https://www.amazon.com.br/s?k=modulo+rele+1+canal+5+v%2C+optoacoplado)
98 | ⭐ Caixa modular DIN 6 módulos (105 mm) | 1 | Abriga os três módulos de relé empilhados, no trilho 2. ⚠️ NÃO a de 4M: 3 × 25,5 mm = 76,5 mm e a de 4M tem 70 mm. Mesmo assim o trilho 2 ficou mais folgado — o MV-1, que saiu, media 66 mm | — | 🔎 caixa modular din 6 modulos (https://lista.mercadolivre.com.br/caixa-modular-din-6-modulos) | 🔎 Amazon (https://www.amazon.com.br/s?k=caixa+modular+din+6+modulos)
99 | ⭐ Diodo 1N4007 | 4 | D1 (bobina do KM1), D2 (ventoinhas do radiador) e ⭐ D3 (as 5 internas) + 1 reserva. 🔎 O D1 pode ser dispensável: teste o KM1 em *teste de diodo* entre A1 e A2 — se conduzir num sentido só, ele já tem diodo interno. ⚠️ O D2 e o D3 são obrigatórios — o D3 entrou quando o MV-1 saiu: o módulo MOSFET trazia o roda-livre dentro da placa, o contato do KA3 não traz nada | — | 🔎 diodo 1n4007 (https://lista.mercadolivre.com.br/diodo-1n4007) | 🔎 Amazon (https://www.amazon.com.br/s?k=diodo+1n4007) | 🌏 1N4007 diode (https://pt.aliexpress.com/w/wholesale-1n4007-diode.html)
100 | Termorretrátil Ø 2 mm | 30 cm | Isolação dos 10 kΩ soldados nos BTS7960 e das emendas nos postes | — | 🔎 termorretratil 2 mm (https://lista.mercadolivre.com.br/termorretratil-2-mm) | 🔎 Amazon (https://www.amazon.com.br/s?k=termorretratil+2+mm) | 🌏 heat shrink tubing kit (https://pt.aliexpress.com/w/wholesale-heat-shrink-tubing-kit.html)
101 | Etiqueta impressa em papel adesivo | 1 | Identificação dos bornes — é o que torna a montagem auditável | — | 🔎 etiqueta impressa papel ades (https://lista.mercadolivre.com.br/etiqueta-impressa-papel-adesivo) | 🔎 Amazon (https://www.amazon.com.br/s?k=etiqueta+impressa+papel+adesivo)
L.6 — Itens reconciliados com o modelo atual
102 | Módulo N4AIC24 | 1 | V1 mede BD-POT; aquisição de tensões e correntes por Modbus RTU RS-485 |  | 🔎 modulo n4aic24 (https://lista.mercadolivre.com.br/modulo-n4aic24) | 🔎 Amazon (https://www.amazon.com.br/s?k=modulo+n4aic24)
103 | Transceptor MAX485 | 1 | Interface RS-485 entre o N4AIC24 e Serial3 do Mega |  | 🔎 transceptor max485 (https://lista.mercadolivre.com.br/transceptor-max485) | 🔎 Amazon (https://www.amazon.com.br/s?k=transceptor+max485)
104 | PTC proposto 12 V / 50 W — BLOQUEADO | 1 | ≈4,17 A estimados; não comprar, montar ou energizar até definir corte DC independente, F3, condutores, termostatos e validação térmica
105 | Conversor T2 — 24 V para 5,0 V / 5 A (proposta bloqueada) | 1 | Modelo, faixa máxima/transientes de entrada e ficha técnica pendentes; não comprar
106 | Conversor T3 — 24 V para 12 V / 20 A (proposta bloqueada) | 1 | Modelo e capacidade contínua/térmica pendentes; proteção de saída e corte do PTC não definidos; não comprar
107 | F3 e proteção do ramal 12 V do PTC — pendentes | a dimensionar | Não reutilizar o valor legado de 2 A; coordenar corrente, cabos, terminais, fusível e capacidade de interrupção CC
108 | Sinaleiros LED 22 mm 5 V | 4 | RUN, COOL, HEAT e FAULT; medir corrente antes de ligar diretamente aos pinos |  | 🔎 sinaleiros led 22 mm 5 v (https://lista.mercadolivre.com.br/sinaleiros-led-22-mm-5-v) | 🔎 Amazon (https://www.amazon.com.br/s?k=sinaleiros+led+22+mm+5+v) | 🌏 (https://pt.aliexpress.com/w/wholesale-22mm-led-pilot-indicator-lamp-24v.html)
109 | Placas PL-1/PL-2 — oito posições DUT | 2 | Quatro canais LED de 12 V em cada placa; correntes individuais pelo N4AIC24 |  | 🔎 placas pl 1 pl 2 (https://lista.mercadolivre.com.br/placas-pl-1-pl-2) | 🔎 Amazon (https://www.amazon.com.br/s?k=placas+pl+1+pl+2)
110 | Ventoinhas internas 12 V | 5 | Quatro de circulação e uma do PTC; dois fios, sem tacômetro |  | 🔎 ventoinhas internas 12 v (https://lista.mercadolivre.com.br/ventoinhas-internas-12-v) | 🔎 Amazon (https://www.amazon.com.br/s?k=ventoinhas+internas+12+v)
111 | Coolers do radiador 12 V, 3 fios | 2 | RPM1/RPM2 supervisionam somente os coolers externos do radiador |  | 🔎 coolers radiador 12 v, 3 fio (https://lista.mercadolivre.com.br/coolers-radiador-12-v-3-fios) | 🔎 Amazon (https://www.amazon.com.br/s?k=coolers+radiador+12+v%2C+3+fios)
112 | ST-1 — termostato NF manual, modelo pendente | 1 | NÃO COMPRAR: ficha do modelo exato deve comprovar rating 12 Vcc adequado, temperatura/tolerância e proteção ambiental |  | 🔎 st 1 (https://lista.mercadolivre.com.br/st-1) | 🔎 Amazon (https://www.amazon.com.br/s?k=st+1)
113 | ST-2 — termostato NF manual, modelo pendente | 1 | NÃO COMPRAR NEM LIGAR DIRETO AO PTC: rating AC não comprova interrupção 12 Vcc; exigir ficha da variante exata |  | 🔎 st 2 (https://lista.mercadolivre.com.br/st-2) | 🔎 Amazon (https://www.amazon.com.br/s?k=st+2)
114 | Resistor 10 kΩ 1/4 W — R8/R9 e pull-downs KA1/KA2/KA3 | 5 | 2 para BTS7960 + 3 para módulos KA1/KA2/KA3; quantidade consolidada |  | 🔎 resistor 10 k 1 4 w (https://lista.mercadolivre.com.br/resistor-10-k-1-4-w) | 🔎 Amazon (https://www.amazon.com.br/s?k=resistor+10+k+1+4+w) | 🌏 (https://pt.aliexpress.com/w/wholesale-1-4w-resistor-kit-assorted.html)
115 | Resistor 4,7 kΩ 1/4 W — reserva do DS18B20 | 1 | Reserva única caso o adaptador/sonda DS18B20 não tenha pull-up integrado |  | 🔎 resistor 4,7 k 1 4 w (https://lista.mercadolivre.com.br/resistor-4-7-k-1-4-w) | 🔎 Amazon (https://www.amazon.com.br/s?k=resistor+4%2C7+k+1+4+w) | 🌏 (https://pt.aliexpress.com/w/wholesale-ds18b20-waterproof-temperature-sensor.html)
116 | ⭐ DS18B20 à prova d'água + adaptador | 1 | Um conjunto, não uma sonda adicional; medir o dissipador quente, não o corpo do PTC |  | 🔎 ds18b20 prova d agua adaptad (https://lista.mercadolivre.com.br/ds18b20-prova-d-agua-adaptador) | 🔎 Amazon (https://www.amazon.com.br/s?k=ds18b20+prova+d+agua+adaptador) | 🌏 (https://pt.aliexpress.com/w/wholesale-ds18b20-waterproof-temperature-sensor.html)
 |  |  |  |  |  |  |  | TOTAL GERAL

Sheet: Inventario React
Grupo | Componente | Qtd | Especificacao conferida | Fonte React
Painel | Caixa do painel | 1 | 700 x 700 x 250 mm; conferir medidas e furação antes de fabricar | painel_interativo/src/data/painel_completo.js
Painel | BD-POT | 1 | 24 V comutados pelo KM1 para o BTS da Peltier; o PTC proposto não pertence a este barramento | painel_interativo/src/data/painel_completo.js
Painel | BD-AUX | 1 | 12 V auxiliar para ventoinhas; não é corte de emergência nem alimentação aprovada do PTC | painel_interativo/src/data/painel_completo.js
Bloqueado | BD-PTC / ramal do aquecedor | 1 | 12 V permanente proposto via T3; sem corte DC independente definido. BTS do PTC em curto pode manter 4,17 A na emergência enquanto a ventoinha para. NÃO MONTAR NEM ENERGIZAR. | painel_interativo/src/sim/energia.js
Bloqueado | T2 — conversor proposto | 1 | 24 V para 5,0 V / 5 A; modelo, ficha, tensão máxima de entrada e transientes pendentes | painel_interativo/src/data/painel_completo.js
Bloqueado | T3 — conversor proposto | 1 | 24 V para 12 V / 20 A; modelo, ficha e capacidade contínua/térmica pendentes | painel_interativo/src/data/painel_completo.js
Painel | BD-24V | 1 | 24 V permanente para comando e N4AIC24 | painel_interativo/src/data/painel_completo.js
Painel | BD-5V | 1 | 5 V de lógica, IHM e sinaleiros | painel_interativo/src/data/painel_completo.js
Painel | BD-0V / BD-0V-B | 2 | Retornos separados conforme a topologia; conferir quantidade de terminais no modelo | painel_interativo/src/data/painel_completo.js
Painel | BTS7960 | 2 | Um para Peltier; outro para PTC proposto. Falha em curto pode energizar o PTC sem comando; não é dispositivo de corte independente. | painel_interativo/src/data/painel_completo.js
Painel | Rele KM1 14 pinos + base DIN | 2 | 1 em uso + 1 reserva; HH64P / LY4NJ 24 Vcc 10 A com base PTF14A; 4 contatos (corta 24 V Peltier, 12 V PTC e SELO) | painel_interativo/src/data/reles_fisico.js
Painel | Modulos rele 1 canal 5 V | 3 | KA1 NO, KA2 NC e KA3 NO; montagem DIN conforme o modelo atual | painel_interativo/src/data/reles_fisico.js
Painel | Arduino Mega 2560 | 1 | Controlador principal | painel_interativo/src/data/painel_completo.js
Painel | N4AIC24 | 1 | V1 mede BD-POT; aquisição de tensão/corrente via Modbus RTU RS-485 | painel_interativo/src/data/painel_completo.js
Painel | MAX485 | 1 | Transceptor RS-485 entre Serial3 do Mega e N4AIC24 | painel_interativo/src/data/painel_completo.js
Painel | DNLCB30 + ESP32-WROOM-32U | 1 | Supervisão Wi-Fi/MQTT; não autoriza partida | painel_interativo/src/data/painel_completo.js
Painel | ES3C28P ESP32-S3 | 1 | IHM 2,8 pol., touch e microSD integrado | painel_interativo/src/data/painel_completo.js
Painel | Conversor de nível UART | 1 | Adaptação de níveis entre Mega 5 V e IHM 3,3 V | painel_interativo/src/data/painel_completo.js
Painel | Sinaleiros LED 22 mm 5 V | 4 | RUN, COOL, HEAT e FAULT; validar corrente por pino antes da ligação direta | painel_interativo/src/data/painel_completo.js
Painel | Botoeiras | 3 | Emergência, LIGAR verde e STOP preto | painel_interativo/src/data/painel_completo.js
Camara | Peltier TEC1-12706 | 2 | Ligadas em série; 24 V e aproximadamente 6 A no conjunto | painel_interativo/src/data/camara.js
Camara | PTC proposto 12 V / 50 W — BLOQUEADO | 1 | Estimativa de 4,17 A; modelo, topologia de corte DC, proteção, condutores e limites térmicos não aprovados. Não comprar/montar/energizar. | painel_interativo/src/data/camara.js
Camara | ST-1: termostato NF 90 C de rearme manual — modelo pendente | 1 | NAO COMPRAR: identificar variante exata e exigir ficha com rearme manual, tolerância, proteção ambiental e capacidade CC apropriada para o ramal de 12 V; validar corte/trava. | painel_interativo/src/data/camara.js
Camara | ST-2: termostato NF 70 C de rearme manual — modelo pendente | 1 | NAO COMPRAR NEM LIGAR DIRETO AO PTC: rating AC não comprova interrupção CC. Exigir ficha do modelo exato com rating 12 Vcc adequado, temperatura/tolerância e proteção ambiental. | painel_interativo/src/data/camara.js
Camara | Ventoinhas internas 12 V | 5 | 4 de circulação + ventoinha integrada do PTC; dois fios e sem tacômetro. A ventoinha do PTC pode parar durante emergência; a estratégia térmica permanece pendente. | painel_interativo/src/data/camara.js
Fora da camara | Coolers do radiador 3 fios | 2 | 12 V; somente estes dois sinais de RPM são monitorados | painel_interativo/src/data/camara.js
Camara | AM2315C | 1 | Temperatura e umidade dentro da câmara | painel_interativo/src/data/camara.js
Fora da camara | DS18B20 | 1 | Temperatura do dissipador quente; não mede o corpo do PTC nem substitui ST-1 | painel_interativo/src/data/camara.js
Camara | Placas PL-1 e PL-2 / DUT | 2 | Oito posições totais, quatro por placa; retornos individuais medidos no N4AIC24 | painel_interativo/src/data/discretos.js
Camara | Porta-fusível das posições | 1 | Oito vias, um canal por DUT; confirmar especificação final do conjunto | painel_interativo/src/data/camara.js

Sheet: Fiacao React
Circuito | Cor(es) | Bitola | Uso | Fonte React
127 V CA + PE | Conforme condutores cadastrados | 1,5 mm² | Entrada AC, proteção Q0 e fonte; conferir montagem física | painel_interativo/src/data/fiacao.js
24 V potência / BD-POT | Conforme FIOS | 1,5 / 0,5 mm² | KM1, barramento comutado e drivers BTS | painel_interativo/src/data/fiacao.js
24 V permanente / BD-24V | Conforme FIOS | 0,75 / 0,5 mm² | Comando e alimentação do N4AIC24; não é V1 | painel_interativo/src/data/fiacao.js
12 V auxiliar / BD-AUX | Conforme FIOS | 0,75 / 0,5 mm² | Coolers do radiador e grupo de cinco ventoinhas internas | painel_interativo/src/data/fiacao.js
12 V proposto / BD-PTC | Não definido | Não definido | Ramal proposto direto do T3, ainda sem corte DC independente, F3 e bitola aprovados; não montar nem energizar | painel_interativo/src/sim/energia.js
5 V / BD-5V | Conforme FIOS | 0,5 mm² | Mega, IHM, interfaces e sinaleiros de 5 V | painel_interativo/src/data/fiacao.js
Modbus RS-485 | Par trançado A/B | Conforme FIOS | N4AIC24 ↔ MAX485 ↔ Serial3 do Mega | painel_interativo/src/data/fiacao.js
Sinais e sensores | Conforme FIOS | Conforme FIOS | Entradas do Mega, sensores, RPM do radiador e comandos | painel_interativo/src/data/fiacao.js

Sheet: Divergencias
Prioridade | Tema | BOM/Documentacao | React atual | Decisao para compra
Resolvido | Corte do PTC na emergência | KM1 atualizado para 14 pinos (HH64P/LY4NJ) | Contato 2 do KM1 chaveia o BD-PTC 12 V; ao bater emergência ou STOP, KM1 abre simultaneamente Peltier (24 V) e PTC (12 V) | Adotado relé HH64P/LY4NJ 10 A com base PTF14A. Validação física de montagem e fiação liberada.
Bloqueante | F3 e condutores do PTC | Valores legados não se aplicam ao ramal novo | Corrente estimada do PTC ≈ 4,17 A; proteção e cabos de saída T3 não definidos | Dimensionar F3, dispositivo com capacidade de interrupção CC, cabos, terminais e coordenação com a fonte/T3; não escolher valor por anúncio.
Pendente | T2/T3 | Anúncios/capacidades nominais sem modelo e ficha aprovados | T2: 24→5,0 V/5 A; T3: 24→12 V/20 A são apenas propostas | Confirmar faixa máxima/transientes de T2 e capacidade contínua, térmica e de proteção de T3.
Bloqueante | ST-1 — proteção térmica | Modelo, rearme, tolerância, rating CC e proteção ambiental sem confirmação | Componente ainda pendente no modelo e na lista | Não comprar nem energizar o PTC até identificar variante e validar a arquitetura de corte/trava.
Bloqueante | ST-2 — proteção térmica | Rating AC de KSD301 não comprova interrupção em 12 Vcc | Componente ainda pendente no modelo e na lista | Não comprar nem ligar diretamente em série; exigir ficha da variante exata ou dimensionar corte alternativo DC.
Pendente | Acrílico e temperaturas | Tipo GS/XT e lote comprado não registrados | ST-2 nominal 70 °C não comprova temperatura máxima real | Identificar material e medir vários pontos, com tolerância e atraso térmico antes de aprovar.
Limitação | Ventilação interna | Cinco ventoinhas internas são de dois fios, sem tacômetro | RPM1/RPM2 medem apenas os dois coolers do radiador | Documentar que KA3 ou a ventoinha do PTC podem falhar sem diagnóstico de RPM.

Sheet: Ordem de Construção
ORDEM DE CONSTRUÇÃO — 5 camadas
Camada | Nome | Documentos | Critério de aceitação
CAMADA 0 | Fundamentos | Visão geral · Arquitetura de energia · BOM | Entregável: BOM reconciliada; itens bloqueados e ensaios pendentes identificados
CAMADA 1 | Maquete | Base e chão de fábrica · Subestação e postes · Câmara térmica | Entregável: cenário pronto, sem eletrônica
CAMADA 2 | Painel | Dimensionamento · Layout · Furação · Fixação nos trilhos | Entregável: painel montado, sem um fio ligado
CAMADA 3 | Elétrica | Força e distribuição · Comando e proteções · Sinais e sensores | Entregável: energizado e medido, sem firmware
CAMADA 4 | Programação | Firmware Arduino · ESP32, IHM e IoT | Entregável: software gravado e testado em bancada
CAMADA 5 | Integração | Montagem final · Comissionamento · Ensaios | Entregável: projeto funcionando e documentado

Sheet: Dados do Projeto
NÚMEROS DO PROJETO
Arquitetura de energia | 24 Vcc · propostas T2 5 V/5 A e T3 12 V/20 A (modelos e proteções pendentes)
Tensão de entrada | 127 V CA
Barramento de distribuição | 24 V CC (SELV)
Potência instalada (fonte) | 240 W · 10 A
Consumo calculado | ≈ 170,2 W · 7,09 A @ 24 V (estimativa do modelo; validar em bancada)
Folga da fonte | Estimativa sujeita a perdas reais e fichas dos conversores; não aprova a fonte
Corrente CA de entrada | 2,43 A
Queda de tensão na linha dos postes | 0,21 V (0,86 %)
Conversores | Propostas: T2 24→5 V/5 A e T3 24→12 V/20 A · modelos não aprovados
Tensões derivadas | 24 V Peltier · 12 V auxiliar/PTC proposto · 5,0 V lógica proposto · 3,3 V ESP32
Fusíveis dos ramais | F1/F2/F3 e proteção/corte do PTC pendentes de dimensionamento; valores legados não são especificação
Proteção do PTC | Solução adotada: Relé KM1 14 pinos (HH64P/LY4NJ 10 A) chaveia 24 V (Peltier) e 12 V (PTC) simultaneamente no corte da emergência/STOP
Volume da câmara | 15,00 L bruto (300 × 200 × 250 mm) · 14,63 L com EPS 1 mm · 14,09 L livres
Carga térmica calculada | ≈ 9,5 W
Refrigeração | 2 × TEC1-12706 em série · 24 V · 6,0 A · 144 W
Capacidade das Peltier a ΔT = 20 K | ≈ 60 W (margem de 6,3×)
Dissipação no lado quente | ≈ 200 W — 2 conjuntos dissipador + cooler 80 mm
Aquecimento | Proposta PTC 12 V · 50 W · ≈4,17 A; modelo e arquitetura de corte ainda não aprovados — NÃO COMPRAR/MONTAR/ENERGIZAR
Aquisição | N4AIC24 V1 mede BD-POT; leitura do simulador via Modbus RTU/RS-485
Posições DUT | 8 posições LED em 12 V · 2 placas de 4 canais · retornos medidos no N4AIC24
Supervisão de ventilação | RPM1/RPM2 cobrem apenas 2 coolers do radiador; 5 ventoinhas internas e fan do PTC sem tacômetro
Bloqueio do PTC | BD-PTC permanece energizado na emergência; BTS em curto pode manter ≈4,17 A e desligar a ventoinha. Corte DC independente, F3, cabos e estratégia de ventilação pendentes. Não energizar.
Acrílico | Identificar GS/XT e validar temperaturas em diversos pontos antes da energização do PTC
Porta | Acrílico de 5 mm, uma chapa só · mesma U das paredes
Base da maquete | 1500 × 500 mm · escala cenográfica 1:50
Painel | 700 × 700 × 250 mm · conferir medidas e furação no modelo atual
Componentes discretos | Sem PI-1/PI-2, CD74HC4067, INA219 ou divisor D25; medição por N4AIC24/Modbus
Sinalização | 4 sinaleiros de painel 22 mm / 5 V · conferir corrente antes de ligar direto aos pinos
