Brunobnhtr/projeto-integrador-camara-frigorifica/painel_interativo/cad_corte/lista_corte_camara.csv

codigo | nome | material | esp_mm | larg_mm | alt_mm | qtd | area_m2 | furos | recortes | obs
CAM-01 | Base | Acrilico cristal | 5 | 420 | 260 | 1 | 0.1092 | 0 | 0 | Face INTERNA para cima. Sem furos. O fundo do alojamento da ventoinha e uma peca propria (CAM-10).
CAM-02 | Teto | Acrilico cristal | 5 | 420 | 260 | 1 | 0.1092 | 8 | 1 | 4 tirantes M4 do PTC + 4 furos M4 dos suportes de lampada + o vao de 80 x 40 da comporta de exaustao. Fora da comporta o teto e fechado: a recirculacao nao usa o teto.
CAM-03 | Lateral (esquerda/direita) | Acrilico cristal | 5 | 260 | 390 | 2 | 0.2028 | 0 | 2 | Peca SIMETRICA: a mesma serve para os dois lados (girar 180 graus). Os dois recortes de 40 x 40 sao as bocas do duto externo. Nada de ar ambiente entra por eles: o duto e fechado.
CAM-04 | Traseira fixa (inferior) | Acrilico cristal | 5 | 410 | 260 | 1 | 0.1066 | 2 | 1 | Parte fixa da traseira, abaixo da tampa tecnica. Tem a comporta de ENTRADA de ar de renovacao e as duas passagens de cabo vedadas com silicone neutro.
CAM-05 | Tampa tecnica removivel (kit Peltier) | Acrilico cristal | 5 | 410 | 130 | 1 | 0.0533 | 8 | 0 | BLANK. O retangulo gravado de 110 x 75 e a area de referencia do kit, NAO recorte. O circulo D12 do dreno tambem e APENAS GRAVACAO: medir o adaptador passa-parede e validar vedacao antes de cortar. Fixacoes M4 dos suportes CAM-22 posicionadas fora da projecao provisoria do Peltier. Nao cortar o vao do kit: a medida do conjunto montado nao foi confirmada.
CAM-06 | Batente de vedacao (moldura interna) | Acrilico branco | 3 | 410 | 390 | 1 | 0.1599 | 0 | 1 | Moldura de 15 mm colada na face interna do vao, em Y 0..3. E a face onde o EPDM e comprimido pela porta. Fica DENTRO da cavidade, por isso a profundidade externa fecha em 260 mm sem sobra.
CAM-07 | Porta (vidro unico 5 mm) | Acrilico cristal | 5 | 410 | 390 | 1 | 0.1599 | 0 | 0 | Recessada em Y -5..0, rente a face frontal: 260 mm de profundidade total. Dobradica e trinco furados na montagem. Unico vidro de 5 mm (a V7 usava duplo); o isolante ISO-05 vai na face interna.
CAM-08 | Painel do duto externo | Acrilico cristal | 5 | 40 | 340 | 6 | 0.0816 | 0 | 0 | 3 paineis por duto x 2 dutos = 6 pecas IGUAIS (a quarta face do canal e a propria lateral da camara). Colados: face externa, face frontal e face traseira. A seta marca o TOPO — nao inverter.
CAM-09 | Painel do alojamento da ventoinha | Acrilico cristal | 5 | 56 | 47 | 6 | 0.0158 | 0 | 0 | 3 paineis por alojamento x 2 = 6 pecas iguais, de 56 x 47. Sao as paredes do pe do duto. A flange CAM-11 fecha por cima, em Z 47..50.
CAM-21 | Tampa do duto (topo) | Acrilico cristal | 5 | 40 | 40 | 2 | 0.0032 | 0 | 0 | Fecha o TOPO de cada canal, em Z 390..395, rente com a face externa do teto. Sem esta peca o duto e uma chamine aberta: a ventoinha empurra o ar para o ambiente em vez de devolve-lo a camara pela boca superior.
CAM-10 | Fundo do alojamento | Acrilico cristal | 5 | 56 | 56 | 2 | 0.0063 | 0 | 0 | Fecha o alojamento por baixo. Sem furo: o ar vem da boca inferior da lateral, nao do ambiente.
CAM-11 | Flange da ventoinha | Aluminio | 3 | 56 | 56 | 2 | 0.0063 | 5 | 0 | A abertura de ar e CIRCULAR (D36), nao quadrada: num quadrado de 32 x 32 os 4 furos de passo 32 cairiam exatamente nos cantos do vao. Os furos ficam a 22,6 mm do centro, fora do circulo, com 3 mm de ligamento. Fecha o alojamento de 56 x 56 por cima.
CAM-12 | Plataforma do PTC | Acrilico cristal | 5 | 150 | 80 | 1 | 0.0120 | 4 | 0 | Pende do teto a 18 mm. Nao tem furo de PTC: o PTC pende do suporte metalico CAM-13, 25 mm abaixo, para o acrilico nao receber calor.
CAM-13 | Suporte metalico do PTC | Aluminio | 2 | 160 | 90 | 1 | 0.0144 | 8 | 0 | O PTC encosta por CIMA nesta chapa e sopra para baixo. Os 4 furos D5 sao os tirantes que vem do teto; os 4 D4,5 sao dos grampos.
CAM-14 | Escudo / defletor do PTC | Aluminio | 1 | 180 | 90 | 1 | 0.0162 | 4 | 1 | Fica 12 mm abaixo do suporte, no MESMO padrao de tirantes. O vao de 114 x 34 deixa o PTC atravessar com 2 mm de folga por lado. E o escudo que impede o isopor e o acrilico de receberem radiacao direta.
CAM-15 | Suporte da lampada (dobrado 90) | Aluminio | 2 | 40 | 80 | 2 | 0.0064 | 2 | 0 | Aba de 30 mm parafusada no teto; aba de 50 mm para baixo com o soquete. O circulo de D20 e apenas GRAVADO: medir o soquete W5W comprado antes de furar.
CAM-16 | Grampo do PTC | Inox | 1 | 12 | 90 | 2 | 0.0022 | 2 | 0 | Prensa o PTC contra o suporte. Inox de 1 mm e largura de 12 mm de proposito: o grampo e uma ponte termica entre a face quente e o suporte, e a secao pequena mantem essa ponte abaixo de 2 W.
CAM-17 | Coletor condensado inox dobrado e selado | Inox | 1 | 180 | 70 | 1 | 0.0126 | 0 | 0 | BLANK DE INOX 1mm 180x70, 4 alívios 8x8; abas 8mm de dobra. SOLDA ESTANQUE em todos os cantos antes de usar. Base inclinada com queda longitudinal 2mm (esquerda -> direita) e transversal 1,5mm (frente -> tras). O ponto de dreno D8 so GRAVADO; nao furar sem medir espigao e conexao. MONTAR Z278, X115..295, Y179..249, 12mm sob PEL_Z0, cobrir toda a projecao fria com juncao vedada na traseira; teste de agua obrigatorio.
CAM-22 | Cantoneira cantilever de apoio calha 90 graus | Aluminio | 2 | 110 | 20 | 2 | 0.0044 | 1 | 0 | DOBRAR 90 graus x35: perna de parede 35mm, prateleira 75mm. Fixar com 1x M4 nos X125 e 285 da CAM-05, Z290; ficam fora do envelope X150..260 do Peltier. Apoiam a calha SEM perfurar o piso. Usar calcos metalicos inclinados e travamento removivel. Aba/grau e resistencia do apoio exigem prototipo. Nao liberar para corte final.
CAM-18 | Quadro da comporta | Acrilico cristal | 5 | 110 | 70 | 2 | 0.0154 | 0 | 1 | Colado por FORA do vao do teto (exaustao) e da traseira (entrada). O EPDM de vedacao vai na face que encosta no acrilico.
CAM-19 | Lamina da comporta | Acrilico cristal | 2 | 110 | 40 | 2 | 0.0088 | 0 | 0 | Desliza entre as duas guias CAM-20. Fecha o vao de 80 x 40. Aberta so no modo de renovacao; fechada, a camara volta a ser um circuito fechado.
CAM-20 | Guia da comporta | Acrilico cristal | 3 | 110 | 8 | 4 | 0.0035 | 0 | 0 | 2 guias por comporta, coladas no quadro, formando a canaleta da lamina.
ISO-01 | Isolamento do fundo | Isopor EPS | 1 | 408 | 248 | 1 | 0.1012 | 0 | 0 | Fundo INTEIRO. A V8 previa um furo de dreno incorreto no piso: REMOVIDO. Condensado sai na parte ALTA da traseira, sob o Peltier.
ISO-02 | Isolamento do teto | Isopor EPS | 1 | 408 | 248 | 1 | 0.1012 | 8 | 1 | Os suportes de lampada e os tirantes comprimem o isopor: nao ha recorte, so furo passante. O vao da comporta tem de ficar livre.
ISO-03 | Isolamento lateral | Isopor EPS | 1 | 248 | 388 | 2 | 0.1924 | 0 | 2 | Face interna das duas laterais. Os dois recortes de 42 x 42 sao as bocas do duto: o isolante nao pode fechar a passagem de ar.
ISO-04 | Isolamento traseiro FIXO (inferior) | Isopor EPS | 1 | 408 | 259 | 1 | 0.1057 | 0 | 1 | Somente a traseira FIXA Z0..260. A V8 usava uma peca unica que impedia remover a tampa Peltier. Agora ISO-09 fica na tampa.
ISO-09 | Isolamento da tampa tecnica REMOVIVEL | Isopor EPS | 1 | 408 | 129 | 1 | 0.0526 | 2 | 0 | Isolamento independente e removivel junto da CAM-05. Abertura do kit e passagem da mangueira em GRAVACAO apenas. Aguardar medidas do kit e do passa-parede antes de recortar.
ISO-05 | Isolamento da porta | Isopor EPS | 1 | 380 | 360 | 1 | 0.1368 | 0 | 0 | Colado na face interna do vidro, dentro do vao do batente (380 x 360). Nao pode impedir a compressao do EPDM: fica 15 mm afastado da borda.
ISO-06 | Isolamento do painel do duto | Isopor EPS | 1 | 40 | 340 | 6 | 0.0816 | 0 | 0 | Colado na face EXTERNA dos 6 paineis CAM-08. Sem isolante o duto externo vira uma aleta: ganha calor do ambiente ao longo dos 350 mm de subida.
ISO-07 | Isolamento do alojamento | Isopor EPS | 1 | 56 | 47 | 6 | 0.0158 | 0 | 0 | Face externa dos 6 paineis CAM-09.
ISO-08 | Isolamento do fundo do alojamento | Isopor EPS | 1 | 56 | 56 | 2 | 0.0063 | 0 | 0 | Sob a CAM-10. Fecha o pe do duto termicamente.
