Brunobnhtr/projeto-integrador-camara-frigorifica/painel_interativo/cad_corte/camara/01_pecas/CAM-26.dxf

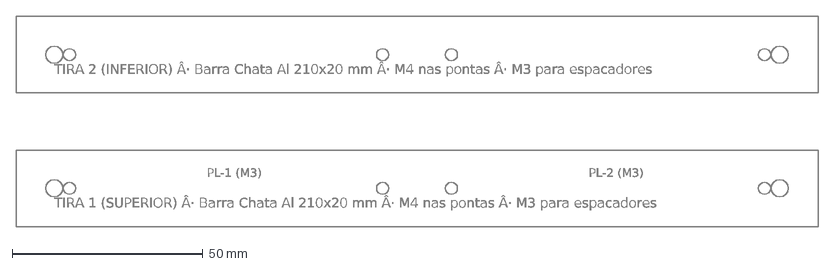
[picture p39: CAD file, 2026-11-03]
painel_interativo/cad_corte/camara/01_pecas/CAM-26.dxf
TIRA 1 (SUPERIOR) Â· Barra Chata Al 210x20 mm Â· M4 nas pontas Â· M3 para espacadores
TIRA 2 (INFERIOR) Â· Barra Chata Al 210x20 mm Â· M4 nas pontas Â· M3 para espacadores
PL-1 (M3)
PL-2 (M3)
