Brunobnhtr/projeto-integrador-camara-frigorifica/painel_interativo/cad_corte/camara/02_chapas/CHAPA_inox_1mm.dxf

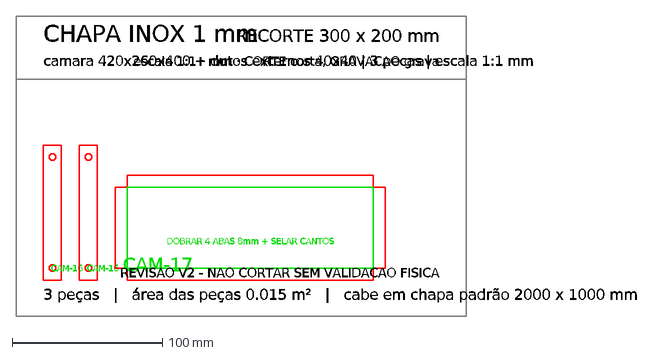
[picture p40: CAD file, 2026-11-02]
painel_interativo/cad_corte/camara/02_chapas/CHAPA_inox_1mm.dxf
CHAPA INOX 1 mm
camara 420x260x400 + dutos externos 40x40 | 3 pecas | escala 1:1 mm
RECORTE 300 x 200 mm
escala 1:1 · mm · CORTE corta, GRAVACAO grava
CAM-16
DOBRAR 4 ABAS 8mm + SELAR CANTOS
CAM-17
3 peças | área das peças 0.015 m² | cabe em chapa padrão 2000 x 1000 mm
REVISAO V2 - NAO CORTAR SEM VALIDACAO FISICA
