Brunobnhtr/projeto-integrador-camara-frigorifica/painel_interativo/cad_corte/camara/03_montagem/DETALHE_BANDEJA_LAMPADAS_V12.dxf

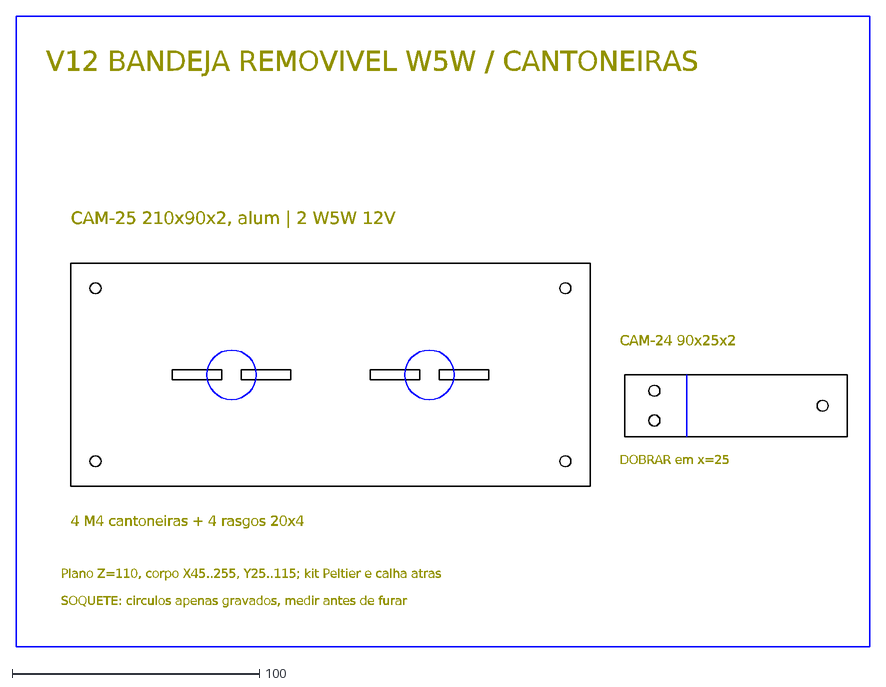
[picture p41: CAD file, 2026-11-02]
painel_interativo/cad_corte/camara/03_montagem/DETALHE_BANDEJA_LAMPADAS_V12.dxf
V12 BANDEJA REMOVIVEL W5W / CANTONEIRAS
CAM-25 210x90x2, alum | 2 W5W 12V
4 M4 cantoneiras + 4 rasgos 20x4
CAM-24 90x25x2
DOBRAR em x=25
Plano Z=110, corpo X45..255, Y25..115; kit Peltier e calha atras
SOQUETE: circulos apenas gravados, medir antes de furar
