Brunobnhtr/projeto-integrador-camara-frigorifica/painel_interativo/cad_corte/painel/01_pecas/PNL-02.dxf

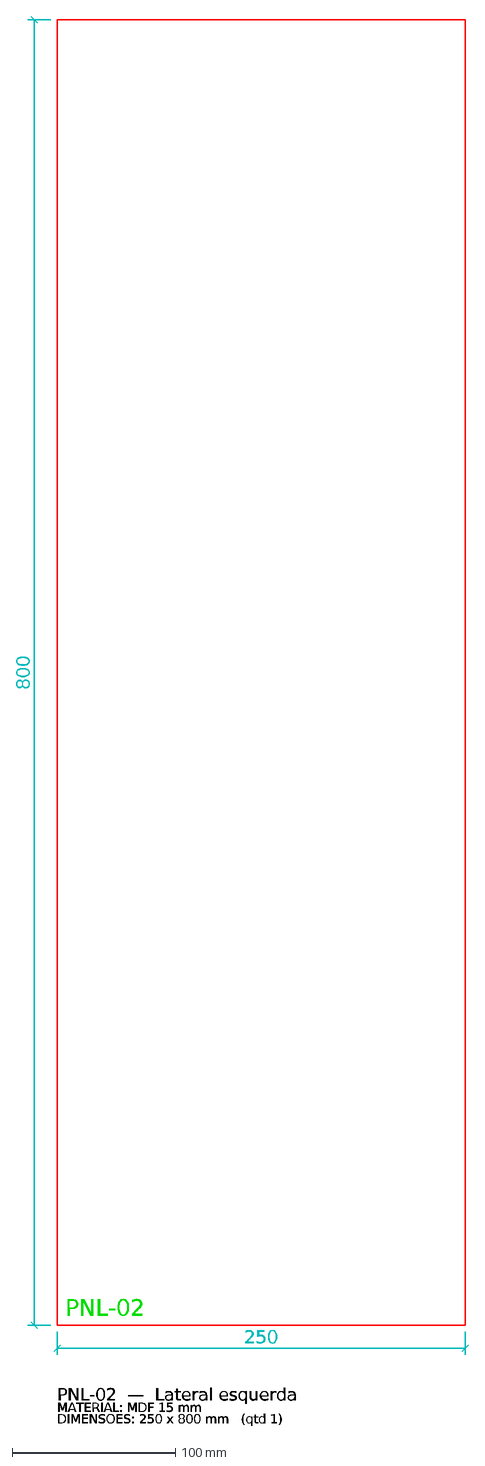
[picture p42: CAD file, 2026-11-02]
painel_interativo/cad_corte/painel/01_pecas/PNL-02.dxf
PNL-02
250
800
PNL-02 — Lateral esquerda
MATERIAL: MDF 15 mm
DIMENSOES: 250 x 800 mm (qtd 1)
