Brunobnhtr/projeto-integrador-camara-frigorifica/painel_interativo/cad_corte/painel/02_chapas/CHAPA_mdf_15mm.dxf

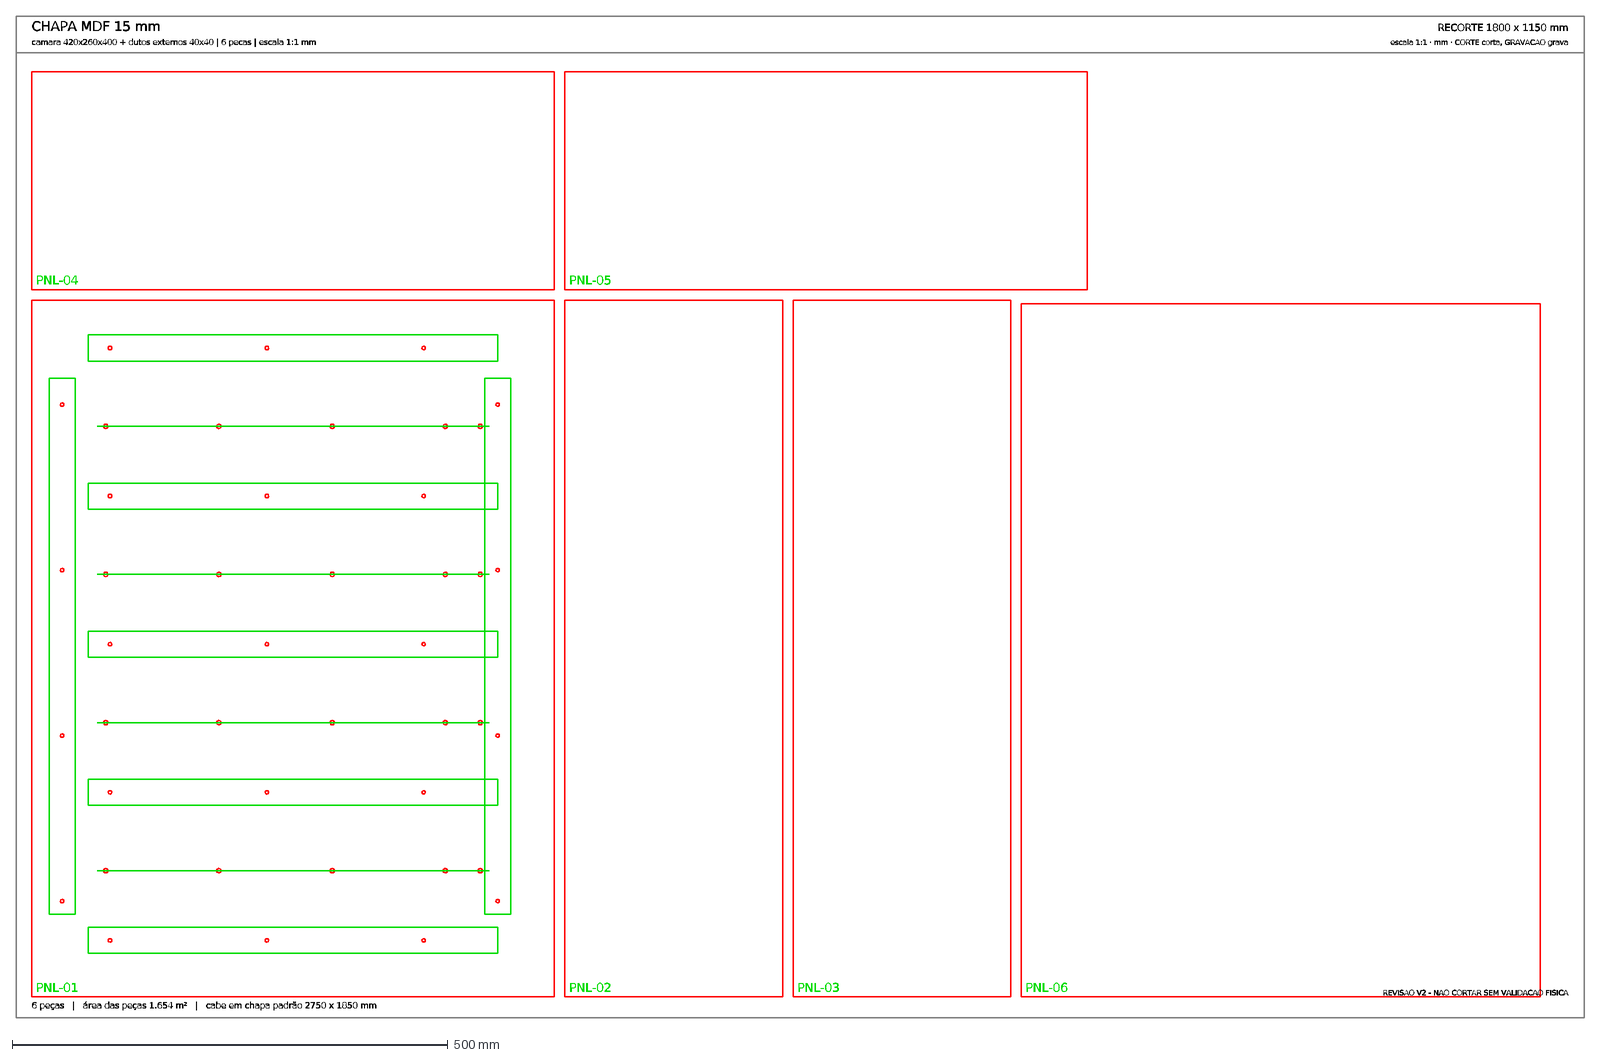
[picture p43: CAD file, 2026-11-02]
painel_interativo/cad_corte/painel/02_chapas/CHAPA_mdf_15mm.dxf
CHAPA MDF 15 mm
camara 420x260x400 + dutos externos 40x40 | 6 pecas | escala 1:1 mm
RECORTE 1800 x 1150 mm
escala 1:1 · mm · CORTE corta, GRAVACAO grava
PNL-01
PNL-02
PNL-03
PNL-06
PNL-04
PNL-05
6 peças | área das peças 1.654 m² | cabe em chapa padrão 2750 x 1850 mm
REVISAO V2 - NAO CORTAR SEM VALIDACAO FISICA
