Brunobnhtr/projeto-integrador-camara-frigorifica/painel_interativo/cad_corte/V12_SUPORTES_PTC_LAMPADAS_FANS_INTERNAS/DETALHE_FANS_INTERNAS_V12.dxf

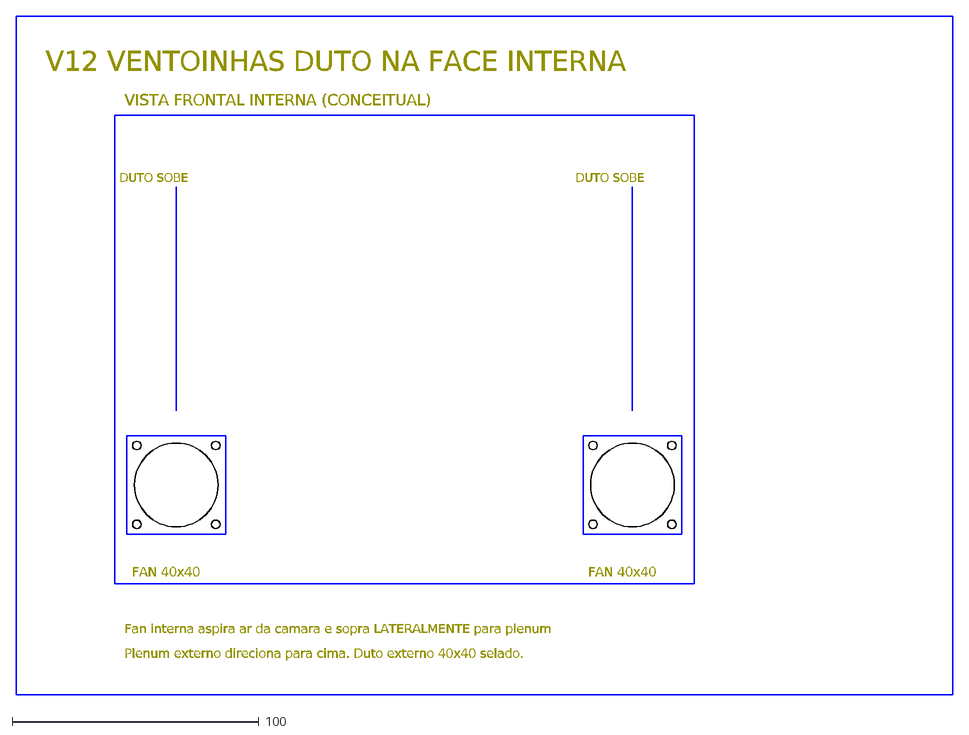
[picture p44: CAD file, 2026-11-02]
painel_interativo/cad_corte/V12_SUPORTES_PTC_LAMPADAS_FANS_INTERNAS/DETALHE_FANS_INTERNAS_V12.dxf
V12 VENTOINHAS DUTO NA FACE INTERNA
VISTA FRONTAL INTERNA (CONCEITUAL)
FAN 40x40
DUTO SOBE
Fan interna aspira ar da camara e sopra LATERALMENTE para plenum
Plenum externo direciona para cima. Duto externo 40x40 selado.
