Brunobnhtr/projeto-integrador-camara-frigorifica/placa_leds/placa_leds.dxf

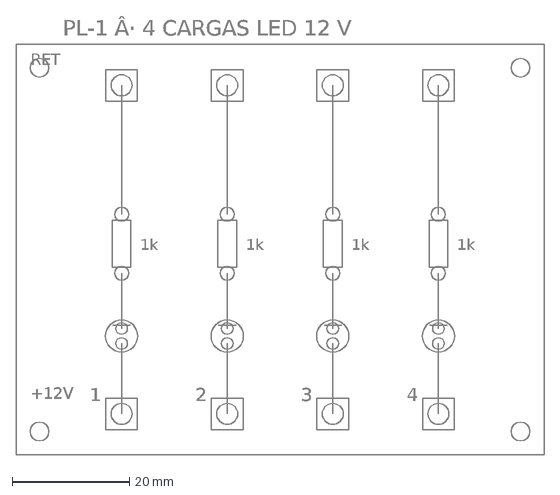
[picture p45: CAD file, 2026-11-02]
placa_leds/placa_leds.dxf
PL-1 Â· 4 CARGAS LED 12 V
+12V
RET
1
2
3
4
1k
