Brunobnhtr/projeto-integrador-camara-frigorifica/painel_interativo/cad_corte/camara/01_pecas/CAM-19.dxf

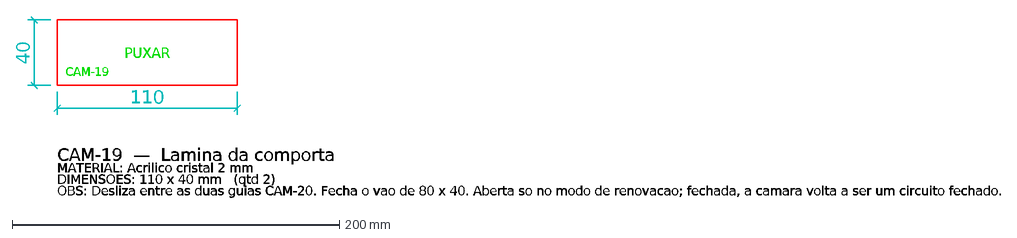
[picture p46: CAD file, 2026-11-02]
painel_interativo/cad_corte/camara/01_pecas/CAM-19.dxf
PUXAR
CAM-19
110
40
CAM-19 — Lamina da comporta
MATERIAL: Acrilico cristal 2 mm
DIMENSOES: 110 x 40 mm (qtd 2)
OBS: Desliza entre as duas guias CAM-20. Fecha o vao de 80 x 40. Aberta so no modo de renovacao; fechada, a camara volta a ser um circuito fechado.
