Brunobnhtr/projeto-integrador-camara-frigorifica/painel_interativo/cad_corte/camara/03_montagem/DETALHE_DRENO_PELTIER_V9.dxf

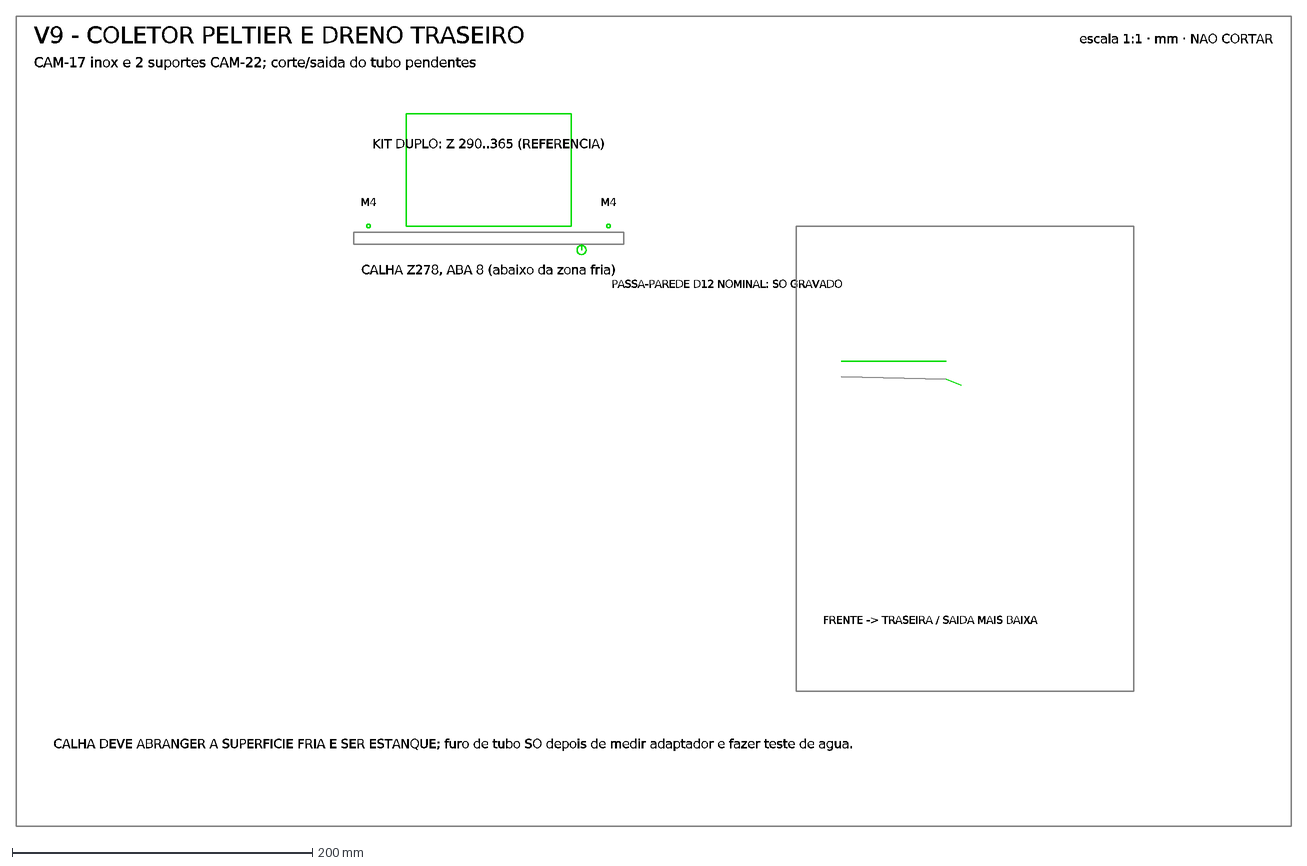
[picture p48: CAD file, 2026-11-02]
painel_interativo/cad_corte/camara/03_montagem/DETALHE_DRENO_PELTIER_V9.dxf
V9 - COLETOR PELTIER E DRENO TRASEIRO
CAM-17 inox e 2 suportes CAM-22; corte/saida do tubo pendentes
escala 1:1 · mm · NAO CORTAR
KIT DUPLO: Z 290..365 (REFERENCIA)
CALHA Z278, ABA 8 (abaixo da zona fria)
M4
PASSA-PAREDE D12 NOMINAL: SO GRAVADO
FRENTE -> TRASEIRA / SAIDA MAIS BAIXA
CALHA DEVE ABRANGER A SUPERFICIE FRIA E SER ESTANQUE; furo de tubo SO depois de medir adaptador e fazer teste de agua.
