Brunobnhtr/projeto-integrador-camara-frigorifica/painel_interativo/cad_corte/painel/01_pecas/PNL-04.dxf

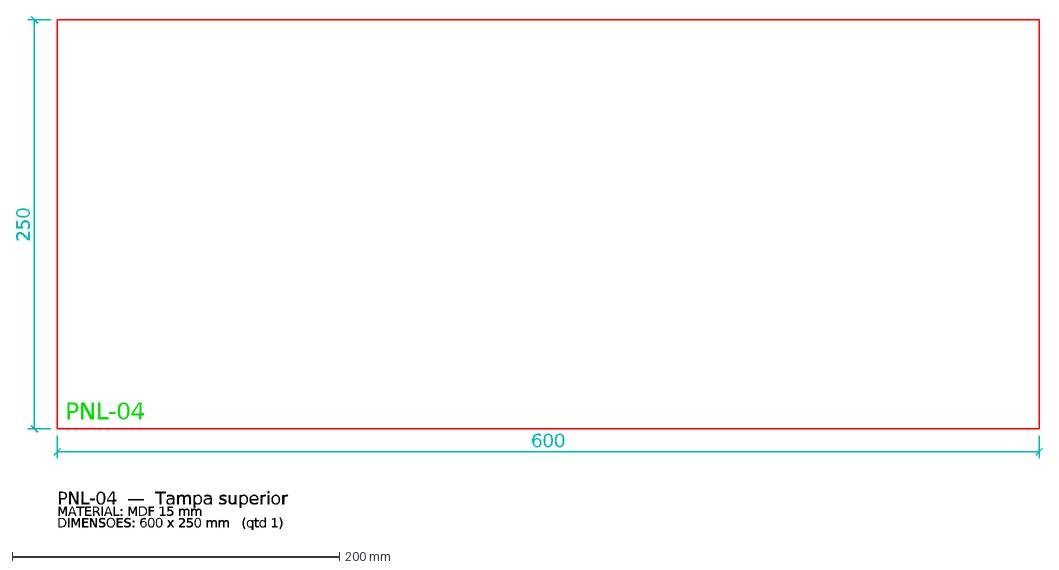
[picture p49: CAD file, 2026-11-02]
painel_interativo/cad_corte/painel/01_pecas/PNL-04.dxf
PNL-04
600
250
PNL-04 — Tampa superior
MATERIAL: MDF 15 mm
DIMENSOES: 600 x 250 mm (qtd 1)
