Brunobnhtr/projeto-integrador-camara-frigorifica/painel_interativo/cad_corte/V12_SUPORTES_PTC_LAMPADAS_FANS_INTERNAS/CAM-23_apoio_PTC.dxf

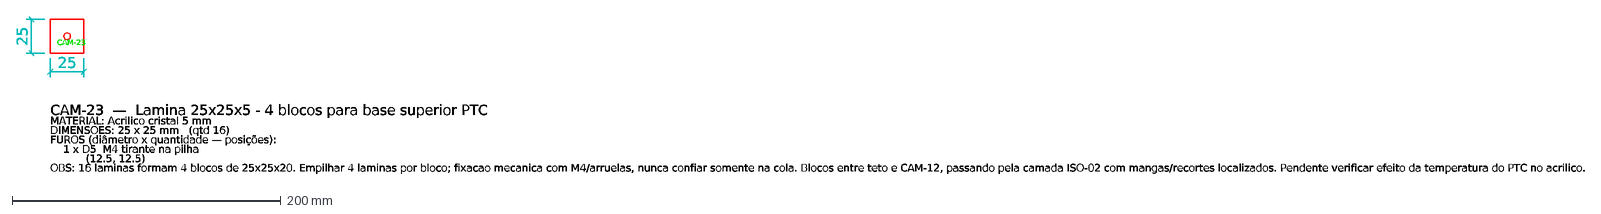
[picture p50: CAD file, 2026-11-02]
painel_interativo/cad_corte/V12_SUPORTES_PTC_LAMPADAS_FANS_INTERNAS/CAM-23_apoio_PTC.dxf
CAM-23
25
CAM-23 — Lamina 25x25x5 - 4 blocos para base superior PTC
MATERIAL: Acrilico cristal 5 mm
DIMENSOES: 25 x 25 mm (qtd 16)
FUROS (diâmetro x quantidade — posições):
1 x D5 M4 tirante na pilha
(12.5, 12.5)
OBS: 16 laminas formam 4 blocos de 25x25x20. Empilhar 4 laminas por bloco; fixacao mecanica com M4/arruelas, nunca confiar somente na cola. Blocos entre teto e
