Brunobnhtr/projeto-integrador-camara-frigorifica/painel_interativo/cad_corte/camara/01_pecas/CAM-02.dxf

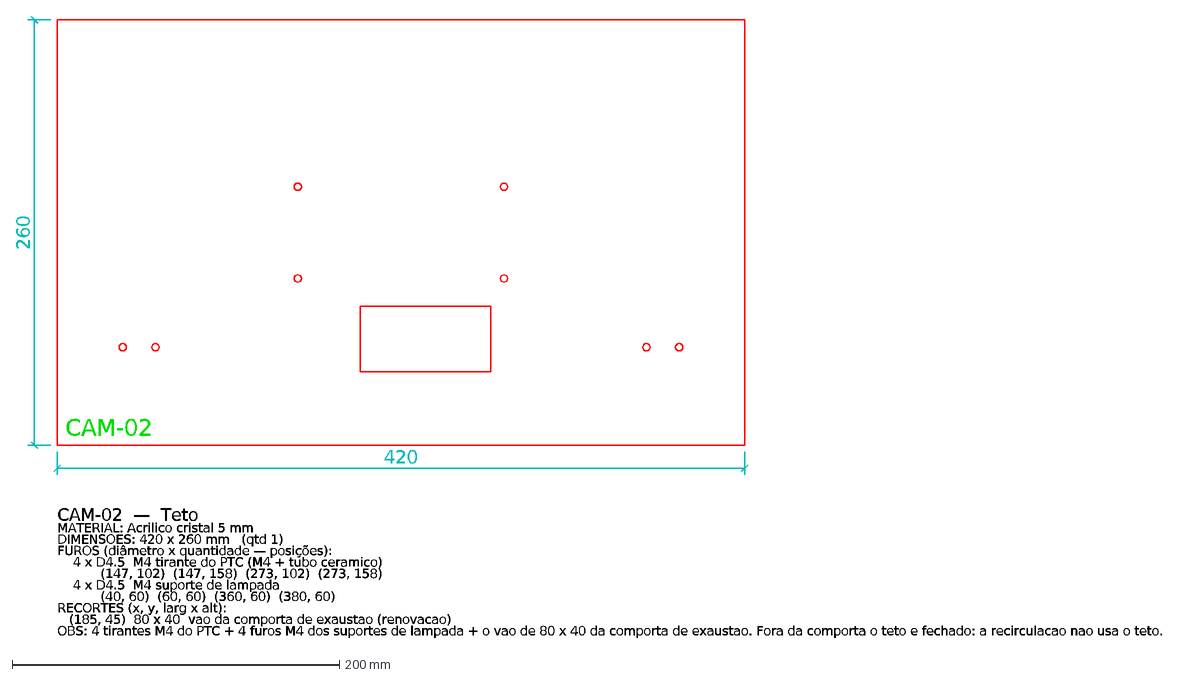
[picture p51: CAD file, 2026-11-02]
painel_interativo/cad_corte/camara/01_pecas/CAM-02.dxf
CAM-02
420
260
CAM-02 — Teto
MATERIAL: Acrilico cristal 5 mm
DIMENSOES: 420 x 260 mm (qtd 1)
FUROS (diâmetro x quantidade — posições):
4 x D4.5 M4 tirante do PTC (M4 + tubo ceramico)
(147, 102) (147, 158) (273, 102) (273, 158)
4 x D4.5 M4 suporte de lampada
(40, 60) (60, 60) (360, 60) (380, 60)
RECORTES (x, y, larg x alt):
(185, 45) 80 x 40 vao da comporta de exaustao (renovacao)
OBS: 4 tirantes M4 do PTC + 4 furos M4 dos suportes de lampada + o vao de 80 x 40 da comporta de exaustao. Fora da comporta o teto e fechado: a recirculacao nao
