Brunobnhtr/projeto-integrador-camara-frigorifica/painel_interativo/cad_corte/camara/02_chapas/CHAPA_aluminio_1mm.dxf

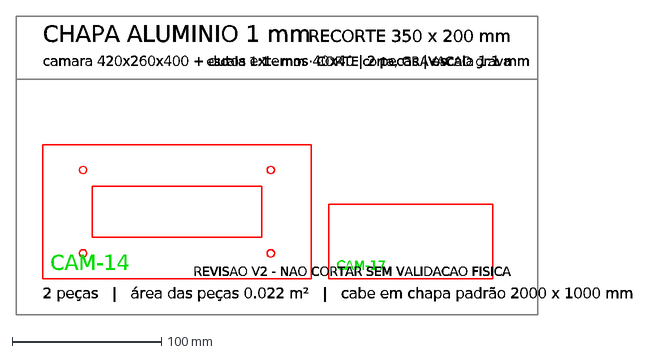
[picture p52: CAD file, 2026-11-02]
painel_interativo/cad_corte/camara/02_chapas/CHAPA_aluminio_1mm.dxf
CHAPA ALUMINIO 1 mm
camara 420x260x400 + dutos externos 40x40 | 2 pecas | escala 1:1 mm
RECORTE 350 x 200 mm
escala 1:1 · mm · CORTE corta, GRAVACAO grava
CAM-14
CAM-17
2 peças | área das peças 0.022 m² | cabe em chapa padrão 2000 x 1000 mm
REVISAO V2 - NAO CORTAR SEM VALIDACAO FISICA
