Brunobnhtr/projeto-integrador-camara-frigorifica/painel_interativo/cad_corte/painel/01_pecas/PNL-01.dxf

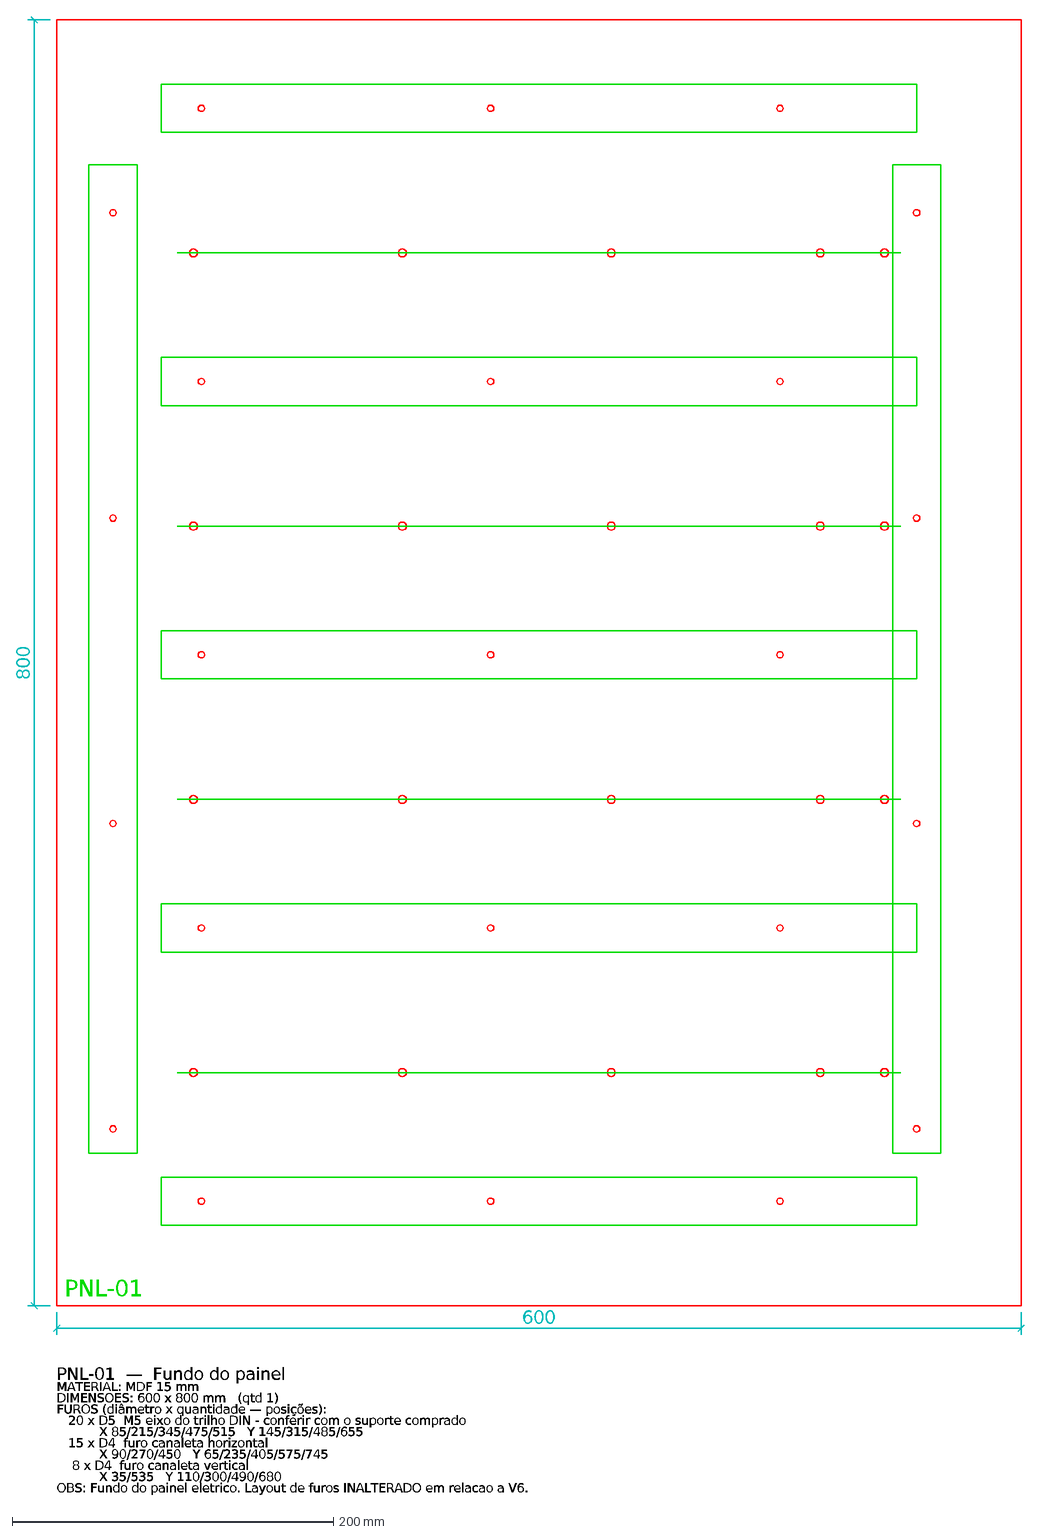
[picture p53: CAD file, 2026-11-02]
painel_interativo/cad_corte/painel/01_pecas/PNL-01.dxf
PNL-01
600
800
PNL-01 — Fundo do painel
MATERIAL: MDF 15 mm
DIMENSOES: 600 x 800 mm (qtd 1)
FUROS (diâmetro x quantidade — posições):
20 x D5 M5 eixo do trilho DIN - conferir com o suporte comprado
X 85/215/345/475/515 Y 145/315/485/655
15 x D4 furo canaleta horizontal
X 90/270/450 Y 65/235/405/575/745
8 x D4 furo canaleta vertical
X 35/535 Y 110/300/490/680
OBS: Fundo do painel eletrico. Layout de furos INALTERADO em relacao a V6.
