Brunobnhtr/projeto-integrador-camara-frigorifica/painel_interativo/cad_corte/V12_SUPORTES_PTC_LAMPADAS_FANS_INTERNAS/DETALHE_APOIOS_PTC_V12.dxf

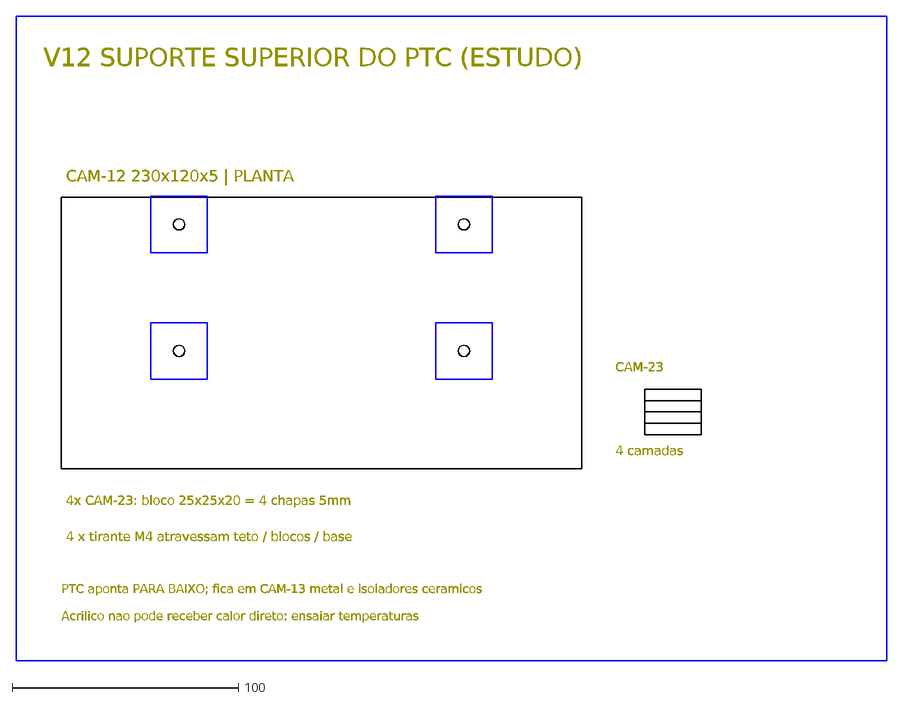
[picture p54: CAD file, 2026-11-02]
painel_interativo/cad_corte/V12_SUPORTES_PTC_LAMPADAS_FANS_INTERNAS/DETALHE_APOIOS_PTC_V12.dxf
V12 SUPORTE SUPERIOR DO PTC (ESTUDO)
CAM-12 230x120x5 | PLANTA
4x CAM-23: bloco 25x25x20 = 4 chapas 5mm
4 x tirante M4 atravessam teto / blocos / base
CAM-23
4 camadas
PTC aponta PARA BAIXO; fica em CAM-13 metal e isoladores ceramicos
Acrilico nao pode receber calor direto: ensaiar temperaturas
