Brunobnhtr/projeto-integrador-camara-frigorifica/painel_interativo/cad_corte/camara/01_pecas/CAM-13.dxf

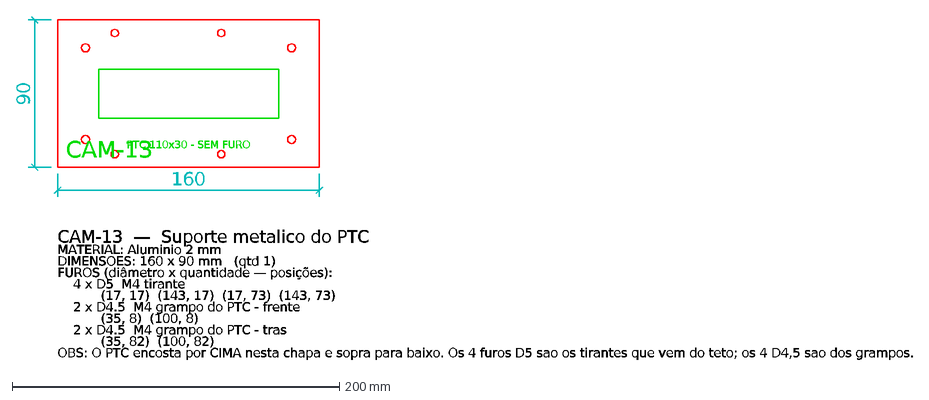
[picture p55: CAD file, 2026-11-02]
painel_interativo/cad_corte/camara/01_pecas/CAM-13.dxf
PTC 110x30 - SEM FURO
CAM-13
160
90
CAM-13 — Suporte metalico do PTC
MATERIAL: Aluminio 2 mm
DIMENSOES: 160 x 90 mm (qtd 1)
FUROS (diâmetro x quantidade — posições):
4 x D5 M4 tirante
(17, 17) (143, 17) (17, 73) (143, 73)
2 x D4.5 M4 grampo do PTC - frente
(35, 8) (100, 8)
2 x D4.5 M4 grampo do PTC - tras
(35, 82) (100, 82)
OBS: O PTC encosta por CIMA nesta chapa e sopra para baixo. Os 4 furos D5 sao os tirantes que vem do teto; os 4 D4,5 sao dos grampos.
