Brunobnhtr/projeto-integrador-camara-frigorifica/painel_interativo/cad_corte/painel/01_pecas/PNL-05.dxf

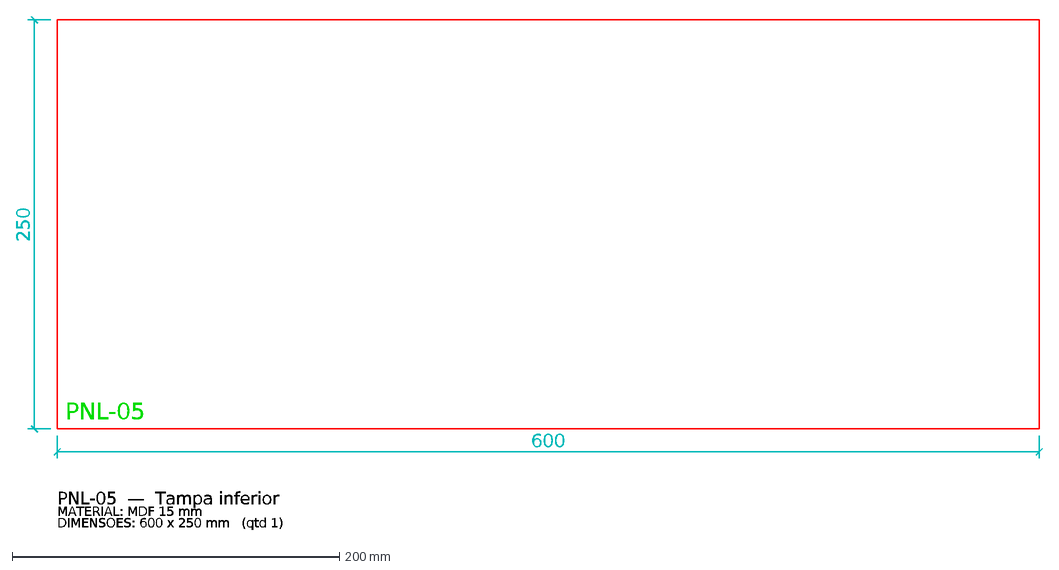
[picture p57: CAD file, 2026-11-02]
painel_interativo/cad_corte/painel/01_pecas/PNL-05.dxf
PNL-05
600
250
PNL-05 — Tampa inferior
MATERIAL: MDF 15 mm
DIMENSOES: 600 x 250 mm (qtd 1)
