Brunobnhtr/projeto-integrador-camara-frigorifica/painel_interativo/cad_corte/V12_SUPORTES_PTC_LAMPADAS_FANS_INTERNAS/CAM-03_fans_internas.dxf

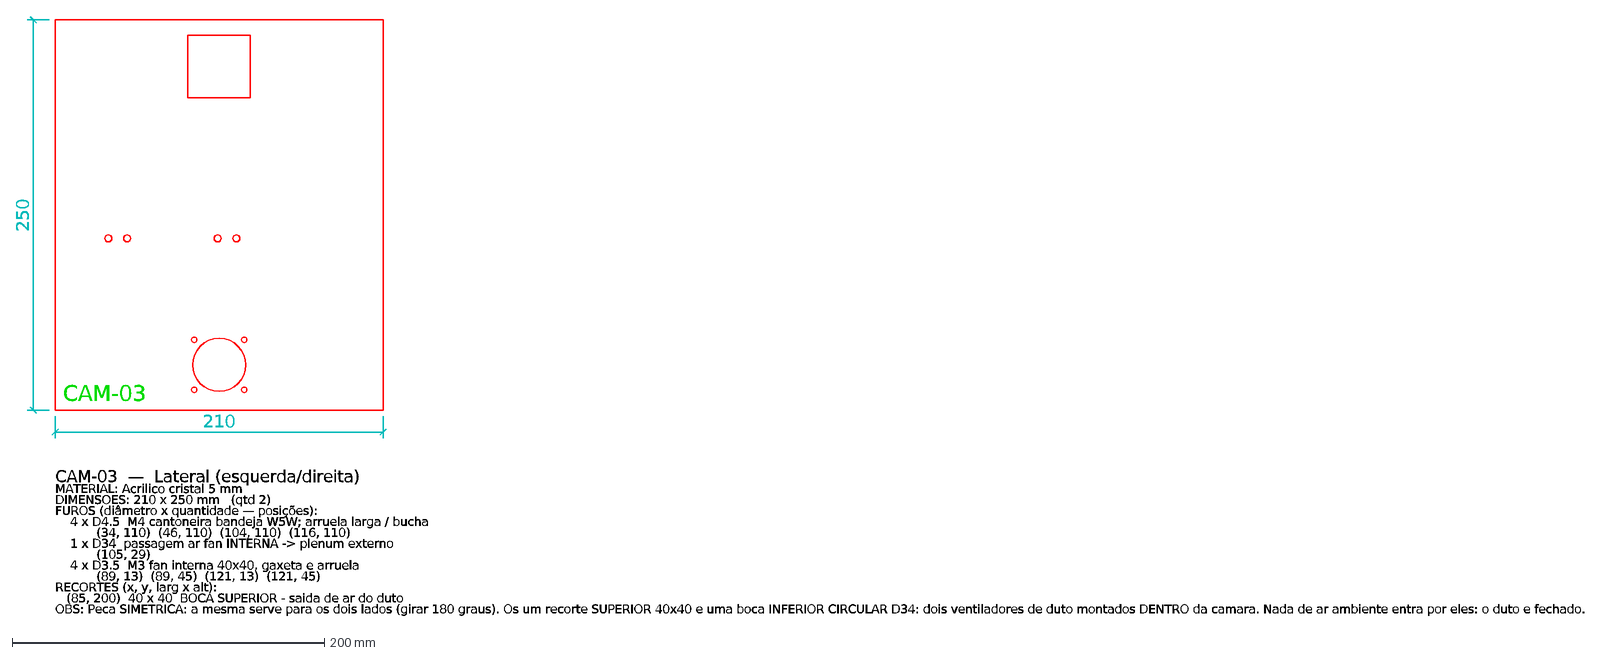
[picture p58: CAD file, 2026-11-02]
painel_interativo/cad_corte/V12_SUPORTES_PTC_LAMPADAS_FANS_INTERNAS/CAM-03_fans_internas.dxf
CAM-03
210
250
CAM-03 — Lateral (esquerda/direita)
MATERIAL: Acrilico cristal 5 mm
DIMENSOES: 210 x 250 mm (qtd 2)
FUROS (diâmetro x quantidade — posições):
4 x D4.5 M4 cantoneira bandeja W5W; arruela larga / bucha
(34, 110) (46, 110) (104, 110) (116, 110)
1 x D34 passagem ar fan INTERNA -> plenum externo
(105, 29)
4 x D3.5 M3 fan interna 40x40, gaxeta e arruela
(89, 13) (89, 45) (121, 13) (121, 45)
RECORTES (x, y, larg x alt):
(85, 200) 40 x 40 BOCA SUPERIOR - saida de ar do duto
OBS: Peca SIMETRICA: a mesma serve para os dois lados (girar 180 graus). Os um recorte SUPERIOR 40x40 e uma boca INFERIOR CIRCULAR D34: dois ventiladores de dut
