Brunobnhtr/projeto-integrador-camara-frigorifica/painel_interativo/cad_corte/camara/01_pecas/CAM-01.dxf

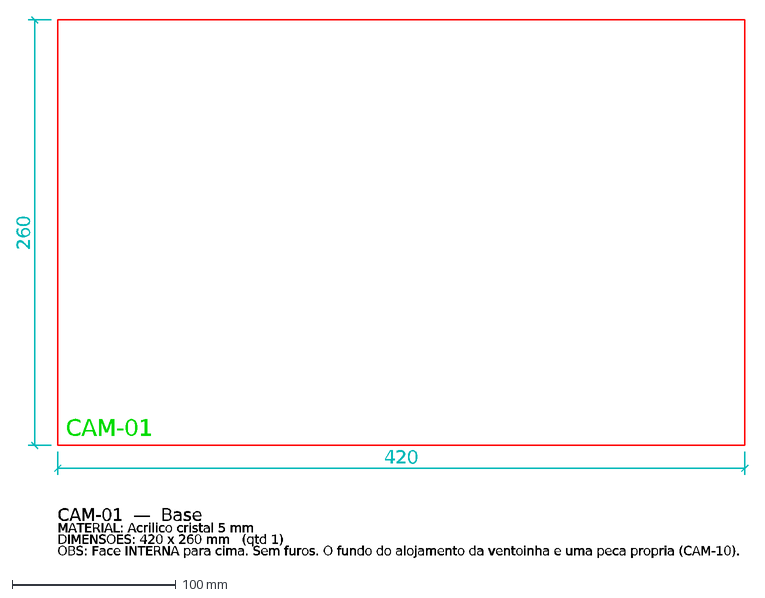
[picture p59: CAD file, 2026-11-02]
painel_interativo/cad_corte/camara/01_pecas/CAM-01.dxf
CAM-01
420
260
CAM-01 — Base
MATERIAL: Acrilico cristal 5 mm
DIMENSOES: 420 x 260 mm (qtd 1)
OBS: Face INTERNA para cima. Sem furos. O fundo do alojamento da ventoinha e uma peca propria (CAM-10).
