Brunobnhtr/projeto-integrador-camara-frigorifica/painel_interativo/cad_corte/camara/02_chapas/CHAPA_aluminio_3mm.dxf

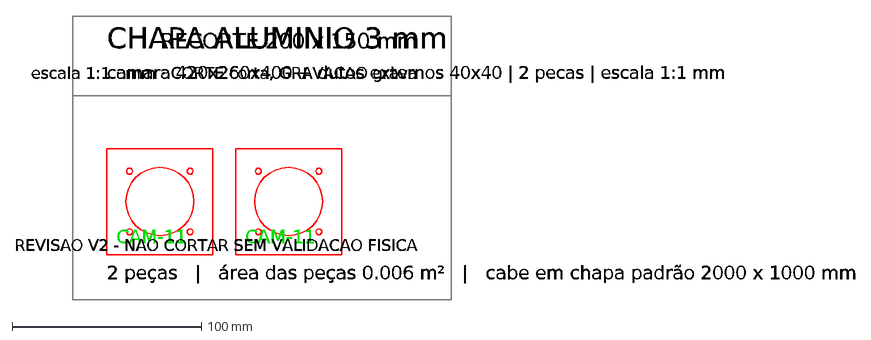
[picture p60: CAD file, 2026-11-02]
painel_interativo/cad_corte/camara/02_chapas/CHAPA_aluminio_3mm.dxf
CHAPA ALUMINIO 3 mm
camara 420x260x400 + dutos externos 40x40 | 2 pecas | escala 1:1 mm
RECORTE 200 x 150 mm
escala 1:1 · mm · CORTE corta, GRAVACAO grava
CAM-11
2 peças | área das peças 0.006 m² | cabe em chapa padrão 2000 x 1000 mm
REVISAO V2 - NAO CORTAR SEM VALIDACAO FISICA
