Brunobnhtr/projeto-integrador-camara-frigorifica/painel_interativo/cad_corte/painel/01_pecas/PNL-03.dxf

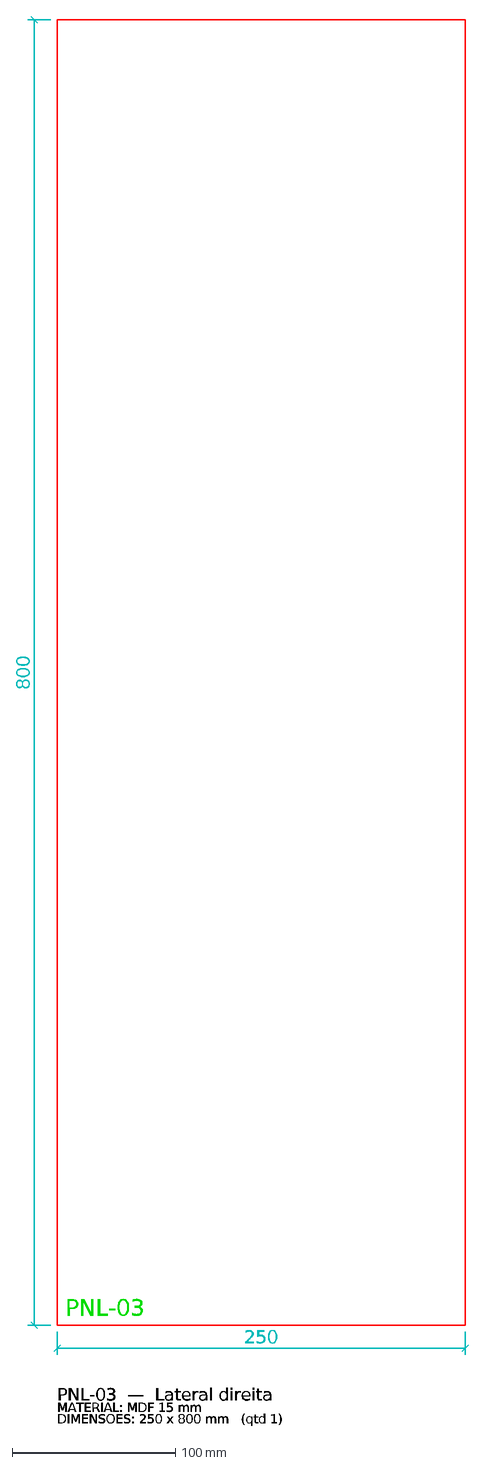
[picture p61: CAD file, 2026-11-02]
painel_interativo/cad_corte/painel/01_pecas/PNL-03.dxf
PNL-03
250
800
PNL-03 — Lateral direita
MATERIAL: MDF 15 mm
DIMENSOES: 250 x 800 mm (qtd 1)
