Brunobnhtr/projeto-integrador-camara-frigorifica/painel_interativo/cad_corte/camara/01_pecas/CAM-10.dxf

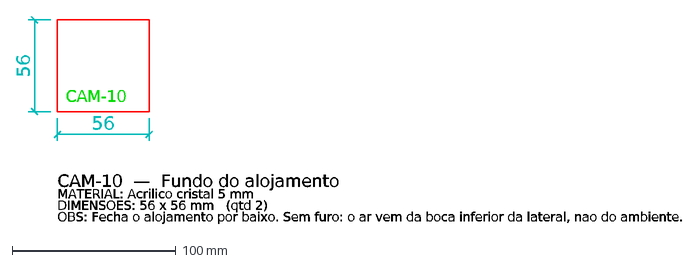
[picture p62: CAD file, 2026-11-02]
painel_interativo/cad_corte/camara/01_pecas/CAM-10.dxf
CAM-10
56
CAM-10 — Fundo do alojamento
MATERIAL: Acrilico cristal 5 mm
DIMENSOES: 56 x 56 mm (qtd 2)
OBS: Fecha o alojamento por baixo. Sem furo: o ar vem da boca inferior da lateral, nao do ambiente.
