Brunobnhtr/projeto-integrador-camara-frigorifica/painel_interativo/cad_corte/camara/02_chapas/CHAPA_acrilico_cristal_2mm.dxf

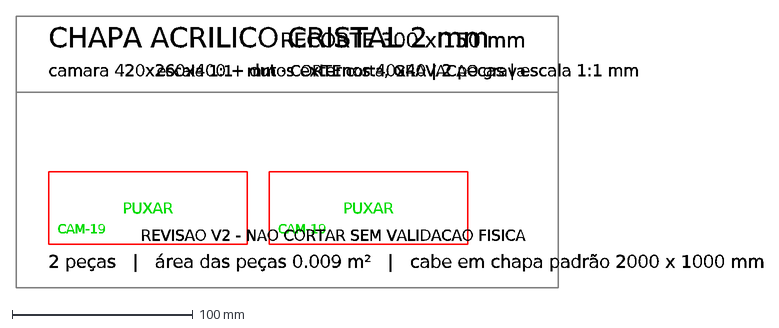
[picture p63: CAD file, 2026-11-02]
painel_interativo/cad_corte/camara/02_chapas/CHAPA_acrilico_cristal_2mm.dxf
CHAPA ACRILICO CRISTAL 2 mm
camara 420x260x400 + dutos externos 40x40 | 2 pecas | escala 1:1 mm
RECORTE 300 x 150 mm
escala 1:1 · mm · CORTE corta, GRAVACAO grava
PUXAR
CAM-19
2 peças | área das peças 0.009 m² | cabe em chapa padrão 2000 x 1000 mm
REVISAO V2 - NAO CORTAR SEM VALIDACAO FISICA
