Brunobnhtr/projeto-integrador-camara-frigorifica/painel_interativo/cad_corte/painel/01_pecas/PNL-06.dxf

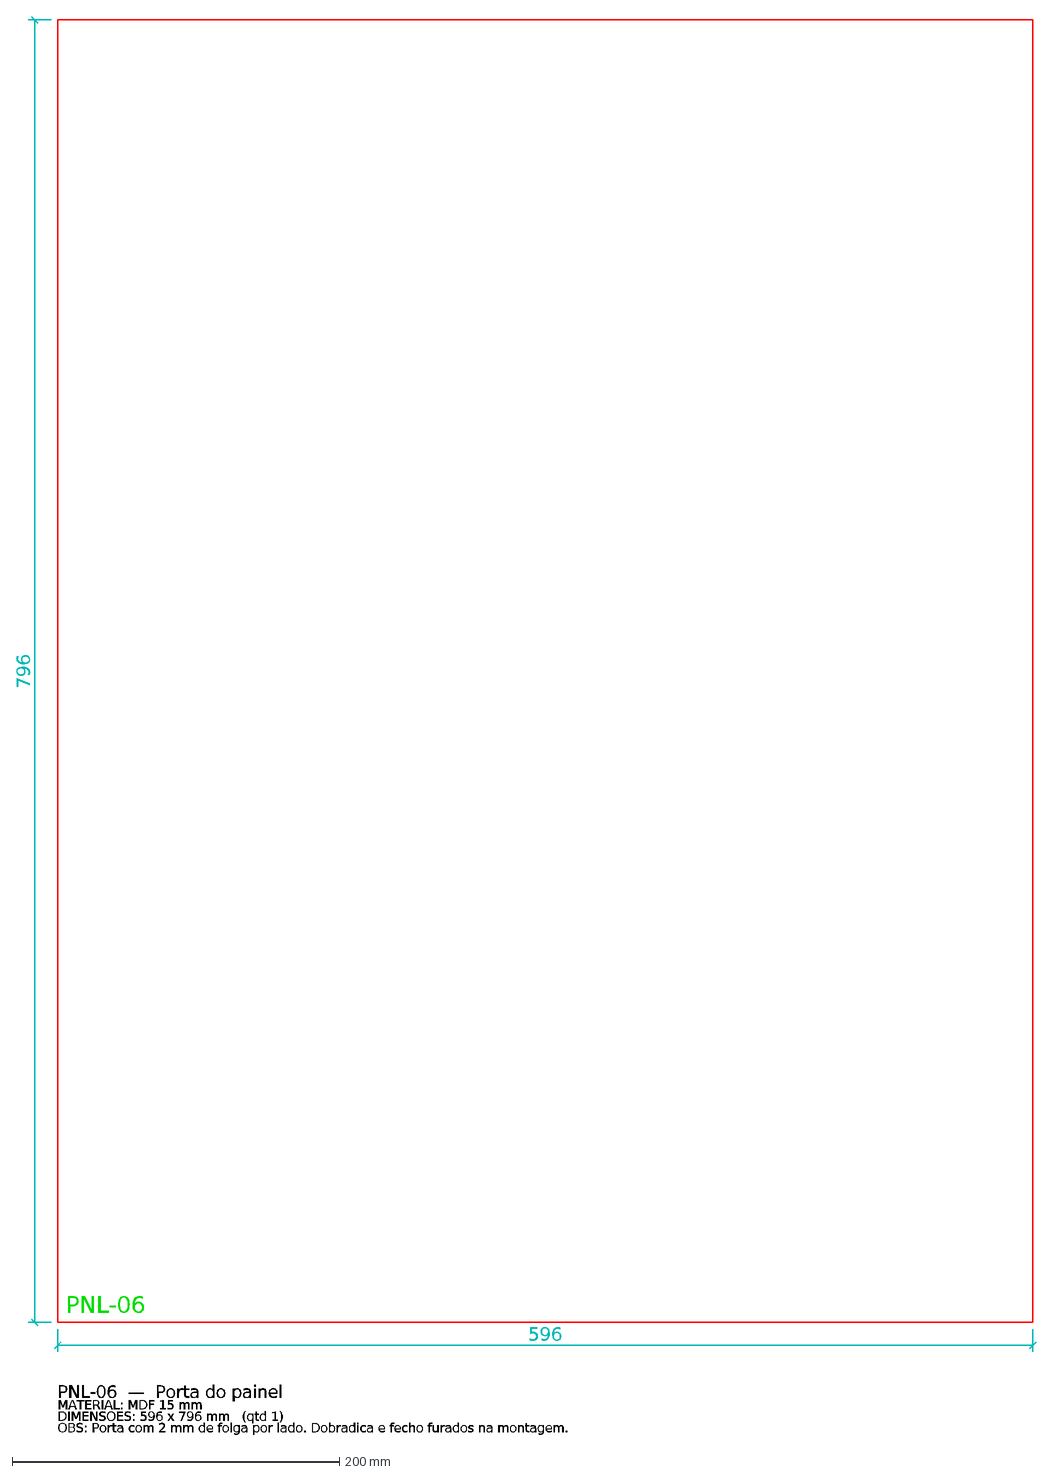
[picture p64: CAD file, 2026-11-02]
painel_interativo/cad_corte/painel/01_pecas/PNL-06.dxf
PNL-06
596
796
PNL-06 — Porta do painel
MATERIAL: MDF 15 mm
DIMENSOES: 596 x 796 mm (qtd 1)
OBS: Porta com 2 mm de folga por lado. Dobradica e fecho furados na montagem.
