Brunobnhtr/projeto-integrador-camara-frigorifica/painel_interativo/cad_corte/camara/01_pecas/CAM-15.dxf

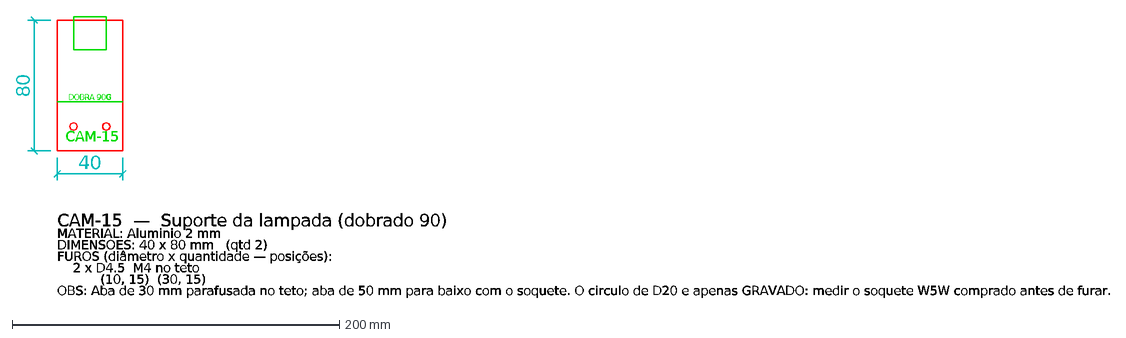
[picture p65: CAD file, 2026-11-02]
painel_interativo/cad_corte/camara/01_pecas/CAM-15.dxf
DOBRA 90G
CAM-15
40
80
CAM-15 — Suporte da lampada (dobrado 90)
MATERIAL: Aluminio 2 mm
DIMENSOES: 40 x 80 mm (qtd 2)
FUROS (diâmetro x quantidade — posições):
2 x D4.5 M4 no teto
(10, 15) (30, 15)
OBS: Aba de 30 mm parafusada no teto; aba de 50 mm para baixo com o soquete. O circulo de D20 e apenas GRAVADO: medir o soquete W5W comprado antes de furar.
