Brunobnhtr/projeto-integrador-camara-frigorifica/painel_interativo/cad_corte/camara/02_chapas/CHAPA_isopor_eps_1mm.dxf

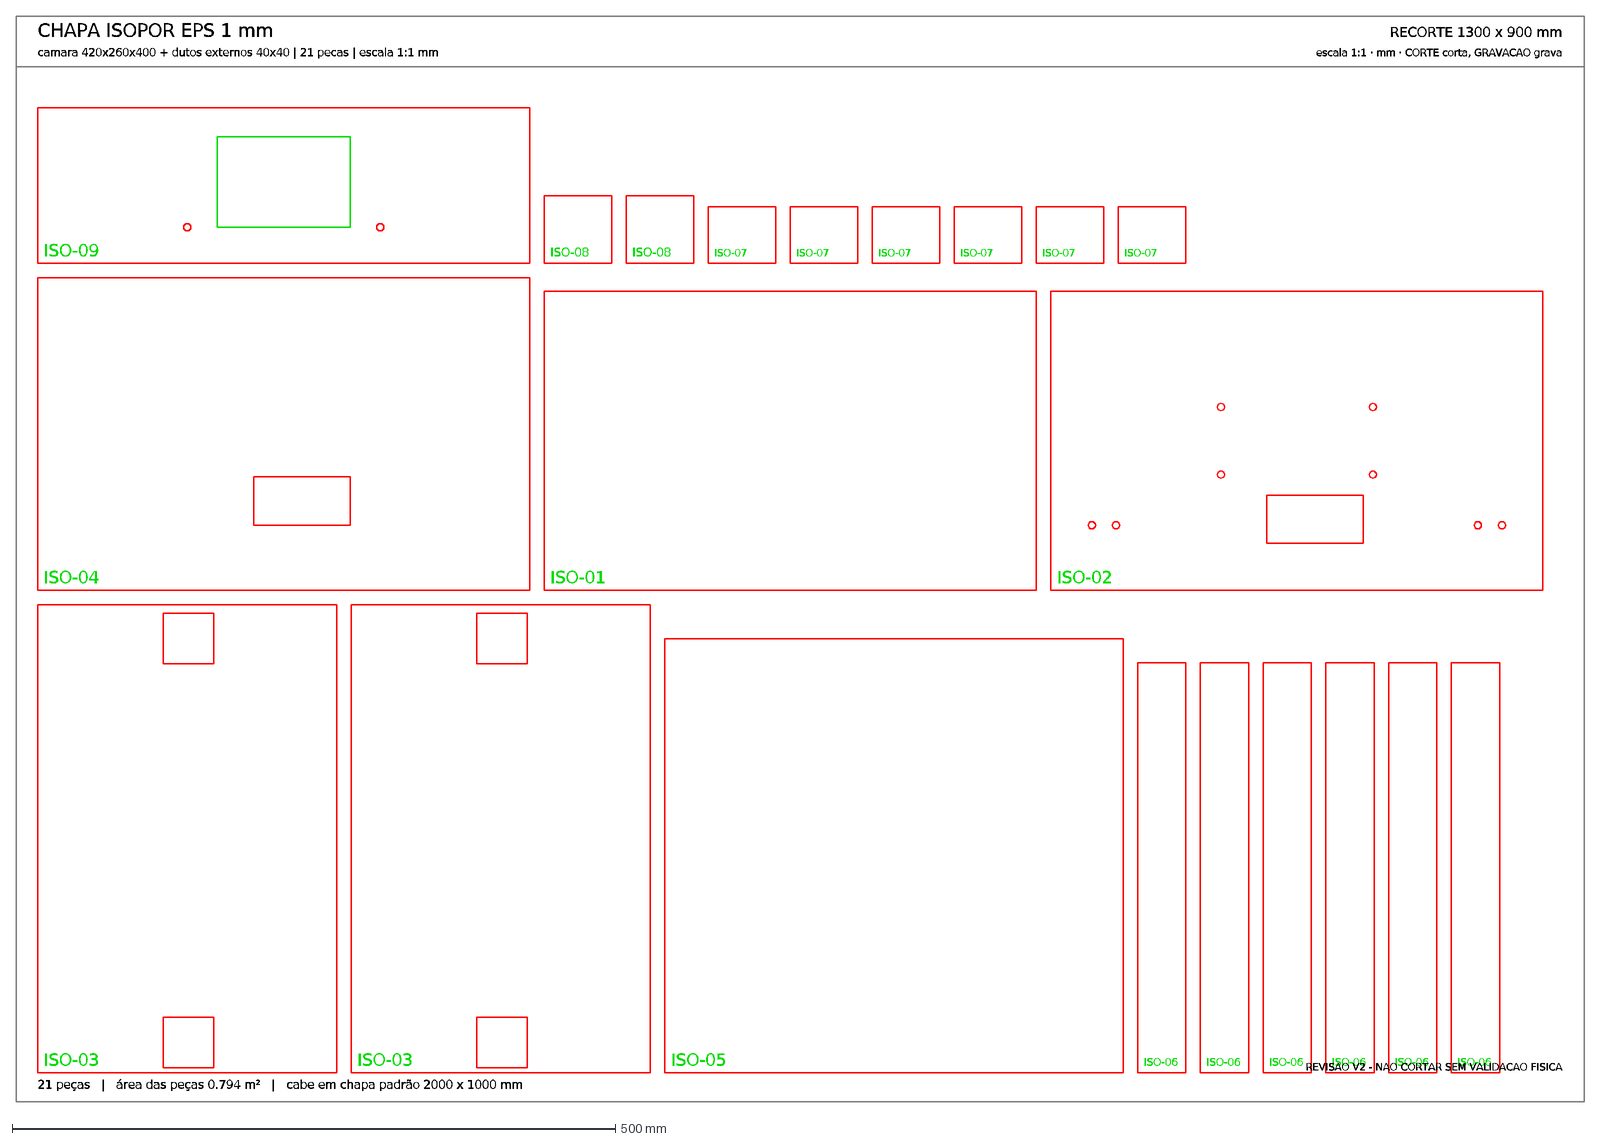
[picture p66: CAD file, 2026-11-02]
painel_interativo/cad_corte/camara/02_chapas/CHAPA_isopor_eps_1mm.dxf
CHAPA ISOPOR EPS 1 mm
camara 420x260x400 + dutos externos 40x40 | 21 pecas | escala 1:1 mm
RECORTE 1300 x 900 mm
escala 1:1 · mm · CORTE corta, GRAVACAO grava
ISO-03
ISO-05
ISO-06
ISO-04
ISO-01
ISO-02
ISO-09
ISO-08
ISO-07
21 peças | área das peças 0.794 m² | cabe em chapa padrão 2000 x 1000 mm
REVISAO V2 - NAO CORTAR SEM VALIDACAO FISICA
