Brunobnhtr/projeto-integrador-camara-frigorifica/painel_interativo/cad_corte/camara/01_pecas/ISO-01.dxf

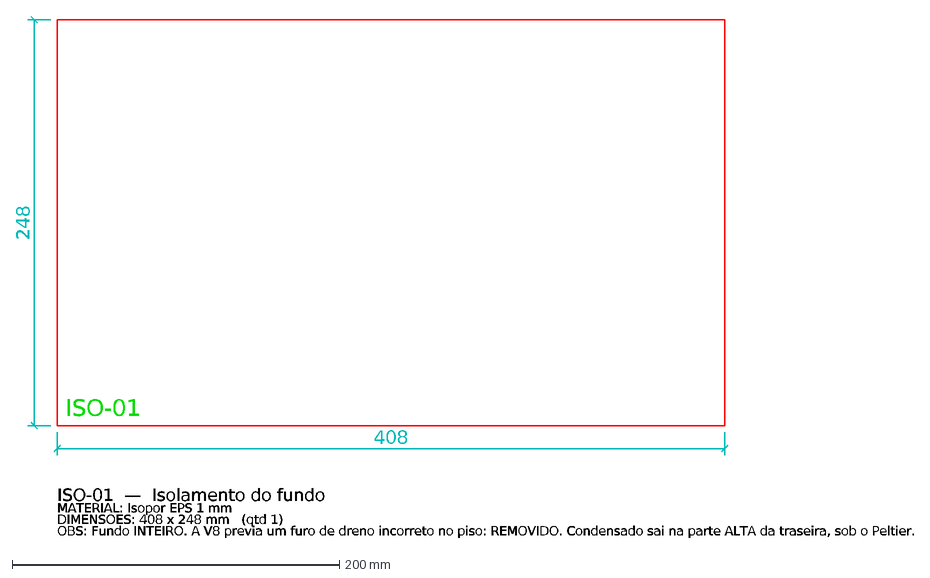
[picture p67: CAD file, 2026-11-02]
painel_interativo/cad_corte/camara/01_pecas/ISO-01.dxf
ISO-01
408
248
ISO-01 — Isolamento do fundo
MATERIAL: Isopor EPS 1 mm
DIMENSOES: 408 x 248 mm (qtd 1)
OBS: Fundo INTEIRO. A V8 previa um furo de dreno incorreto no piso: REMOVIDO. Condensado sai na parte ALTA da traseira, sob o Peltier.
