Brunobnhtr/projeto-integrador-camara-frigorifica/painel_interativo/cad_corte/camara/02_chapas/CHAPA_acrilico_cristal_5mm.dxf

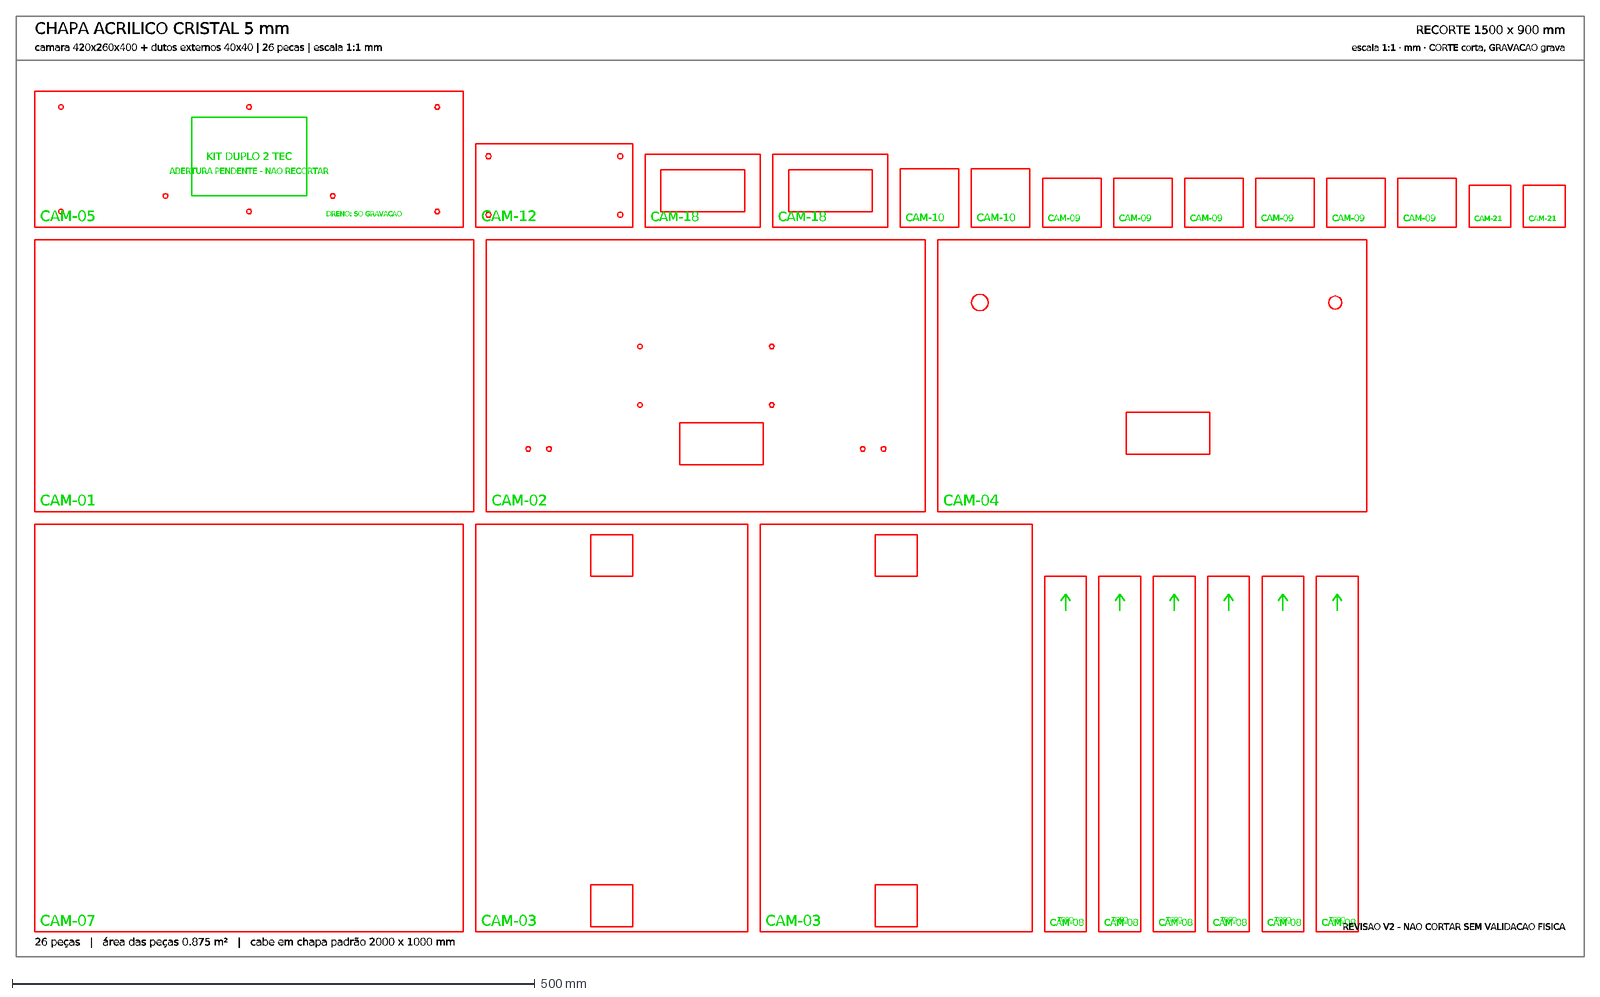
[picture p68: CAD file, 2026-11-02]
painel_interativo/cad_corte/camara/02_chapas/CHAPA_acrilico_cristal_5mm.dxf
CHAPA ACRILICO CRISTAL 5 mm
camara 420x260x400 + dutos externos 40x40 | 26 pecas | escala 1:1 mm
RECORTE 1500 x 900 mm
escala 1:1 · mm · CORTE corta, GRAVACAO grava
CAM-07
CAM-03
TOPO
CAM-08
CAM-01
CAM-02
CAM-04
KIT DUPLO 2 TEC
ABERTURA PENDENTE - NAO RECORTAR
DRENO: SO GRAVACAO
CAM-05
CAM-12
CAM-18
CAM-10
CAM-09
CAM-21
26 peças | área das peças 0.875 m² | cabe em chapa padrão 2000 x 1000 mm
REVISAO V2 - NAO CORTAR SEM VALIDACAO FISICA
