Brunobnhtr/projeto-integrador-camara-frigorifica/painel_interativo/cad_corte/camara/01_pecas/CAM-12.dxf

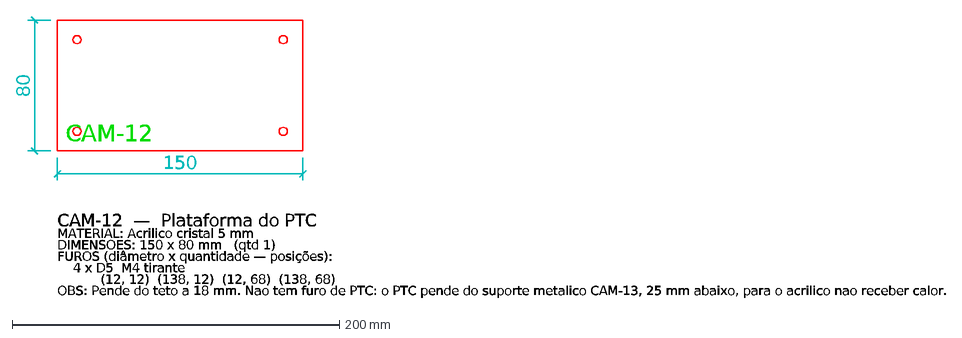
[picture p69: CAD file, 2026-11-02]
painel_interativo/cad_corte/camara/01_pecas/CAM-12.dxf
CAM-12
150
80
CAM-12 — Plataforma do PTC
MATERIAL: Acrilico cristal 5 mm
DIMENSOES: 150 x 80 mm (qtd 1)
FUROS (diâmetro x quantidade — posições):
4 x D5 M4 tirante
(12, 12) (138, 12) (12, 68) (138, 68)
OBS: Pende do teto a 18 mm. Nao tem furo de PTC: o PTC pende do suporte metalico CAM-13, 25 mm abaixo, para o acrilico nao receber calor.
