Brunobnhtr/projeto-integrador-camara-frigorifica/painel_interativo/cad_corte/camara/02_chapas/CHAPA_aluminio_2mm.dxf

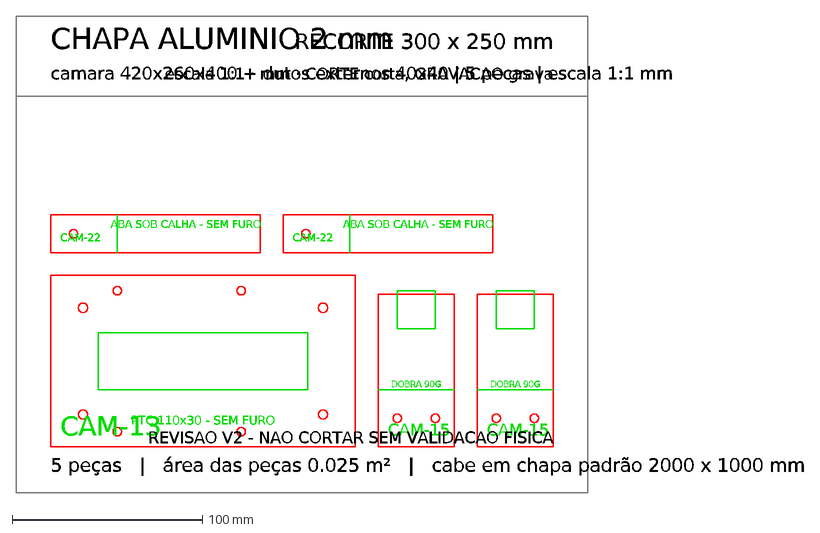
[picture p70: CAD file, 2026-11-02]
painel_interativo/cad_corte/camara/02_chapas/CHAPA_aluminio_2mm.dxf
CHAPA ALUMINIO 2 mm
camara 420x260x400 + dutos externos 40x40 | 5 pecas | escala 1:1 mm
RECORTE 300 x 250 mm
escala 1:1 · mm · CORTE corta, GRAVACAO grava
PTC 110x30 - SEM FURO
CAM-13
DOBRA 90G
CAM-15
ABA SOB CALHA - SEM FURO
CAM-22
5 peças | área das peças 0.025 m² | cabe em chapa padrão 2000 x 1000 mm
REVISAO V2 - NAO CORTAR SEM VALIDACAO FISICA
