Brunobnhtr/projeto-integrador-camara-frigorifica/painel_interativo/cad_corte/camara/01_pecas/CAM-24.dxf

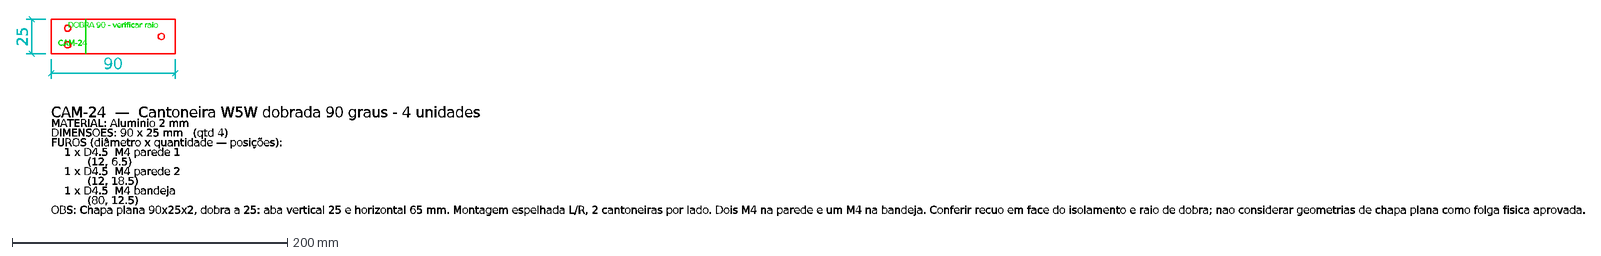
[picture p71: CAD file, 2026-11-02]
painel_interativo/cad_corte/camara/01_pecas/CAM-24.dxf
DOBRA 90 - verificar raio
CAM-24
90
25
CAM-24 — Cantoneira W5W dobrada 90 graus - 4 unidades
MATERIAL: Aluminio 2 mm
DIMENSOES: 90 x 25 mm (qtd 4)
FUROS (diâmetro x quantidade — posições):
1 x D4.5 M4 parede 1
(12, 6.5)
1 x D4.5 M4 parede 2
(12, 18.5)
1 x D4.5 M4 bandeja
(80, 12.5)
OBS: Chapa plana 90x25x2, dobra a 25: aba vertical 25 e horizontal 65 mm. Montagem espelhada L/R, 2 cantoneiras por lado. Dois M4 na parede e um M4 na bandeja.
