Brunobnhtr/projeto-integrador-camara-frigorifica/painel_interativo/cad_corte/camara/01_pecas/CAM-09.dxf

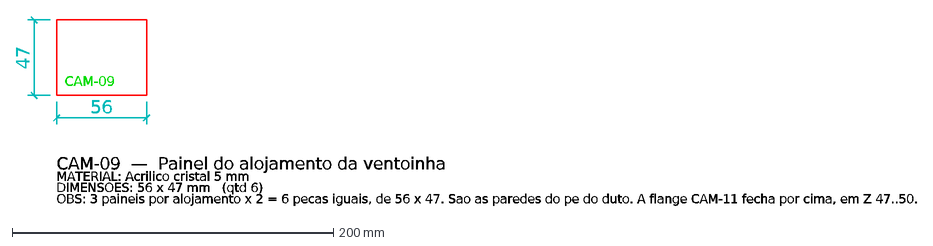
[picture p72: CAD file, 2026-11-02]
painel_interativo/cad_corte/camara/01_pecas/CAM-09.dxf
CAM-09
56
47
CAM-09 — Painel do alojamento da ventoinha
MATERIAL: Acrilico cristal 5 mm
DIMENSOES: 56 x 47 mm (qtd 6)
OBS: 3 paineis por alojamento x 2 = 6 pecas iguais, de 56 x 47. Sao as paredes do pe do duto. A flange CAM-11 fecha por cima, em Z 47..50.
