Brunobnhtr/projeto-integrador-camara-frigorifica/painel_interativo/cad_corte/camara/01_pecas/CAM-14.dxf

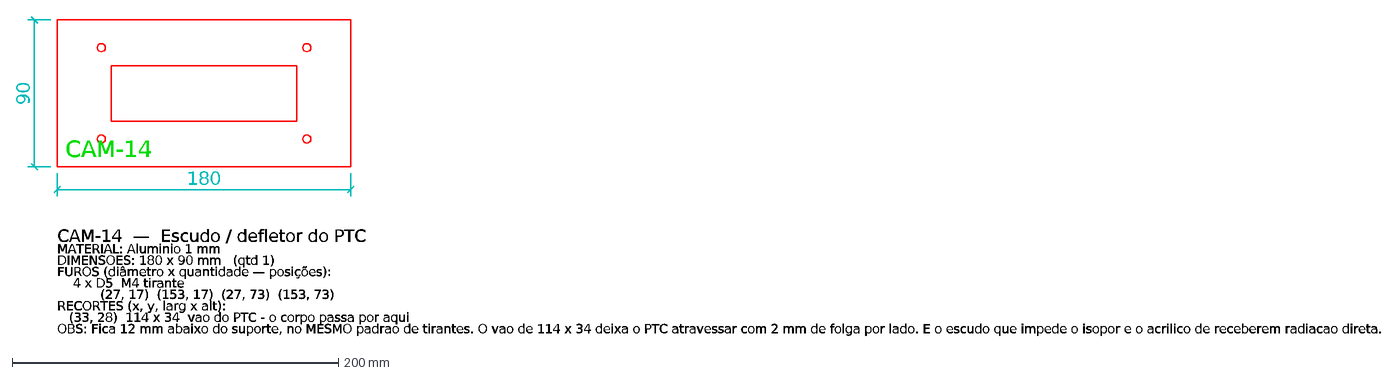
[picture p73: CAD file, 2026-11-02]
painel_interativo/cad_corte/camara/01_pecas/CAM-14.dxf
CAM-14
180
90
CAM-14 — Escudo / defletor do PTC
MATERIAL: Aluminio 1 mm
DIMENSOES: 180 x 90 mm (qtd 1)
FUROS (diâmetro x quantidade — posições):
4 x D5 M4 tirante
(27, 17) (153, 17) (27, 73) (153, 73)
RECORTES (x, y, larg x alt):
(33, 28) 114 x 34 vao do PTC - o corpo passa por aqui
OBS: Fica 12 mm abaixo do suporte, no MESMO padrao de tirantes. O vao de 114 x 34 deixa o PTC atravessar com 2 mm de folga por lado. E o escudo que impede o iso
