Brunobnhtr/projeto-integrador-camara-frigorifica/painel_interativo/cad_corte/camara/01_pecas/ISO-09.dxf

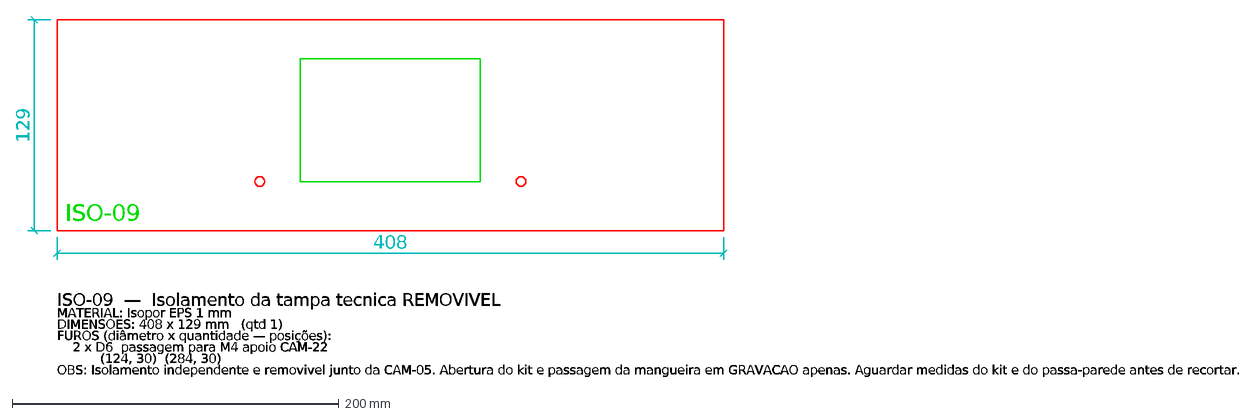
[picture p74: CAD file, 2026-11-02]
painel_interativo/cad_corte/camara/01_pecas/ISO-09.dxf
ISO-09
408
129
ISO-09 — Isolamento da tampa tecnica REMOVIVEL
MATERIAL: Isopor EPS 1 mm
DIMENSOES: 408 x 129 mm (qtd 1)
FUROS (diâmetro x quantidade — posições):
2 x D6 passagem para M4 apoio CAM-22
(124, 30) (284, 30)
OBS: Isolamento independente e removivel junto da CAM-05. Abertura do kit e passagem da mangueira em GRAVACAO apenas. Aguardar medidas do kit e do passa-parede
