Brunobnhtr/projeto-integrador-camara-frigorifica/painel_interativo/cad_corte/camara/01_pecas/ISO-06.dxf

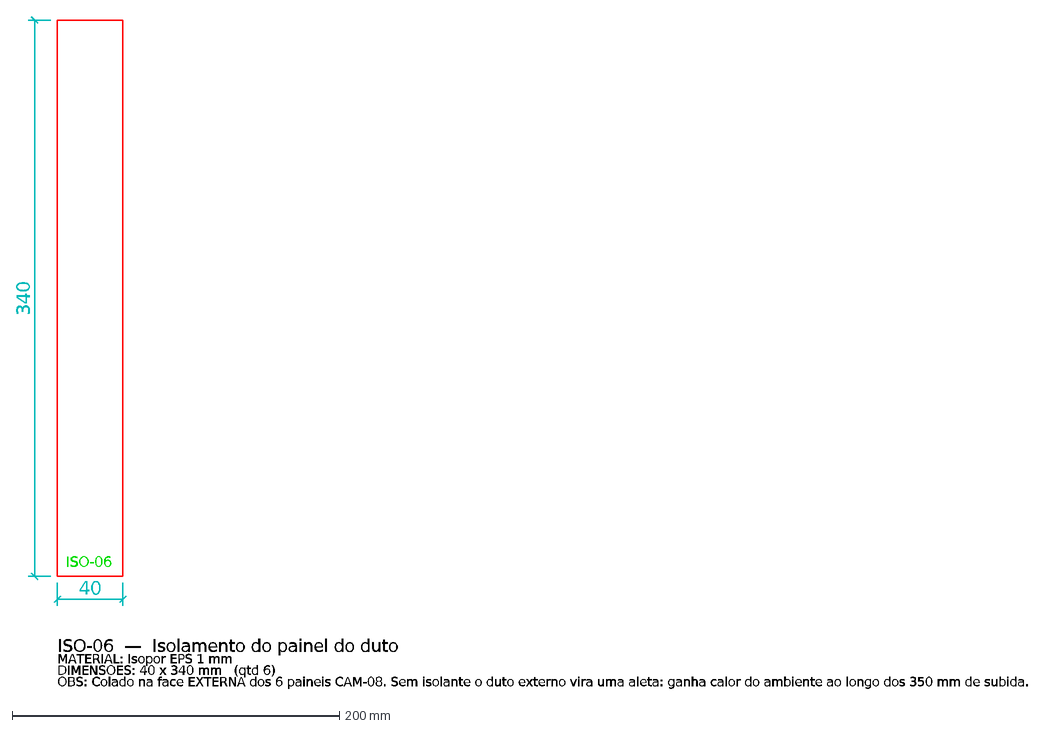
[picture p75: CAD file, 2026-11-02]
painel_interativo/cad_corte/camara/01_pecas/ISO-06.dxf
ISO-06
40
340
ISO-06 — Isolamento do painel do duto
MATERIAL: Isopor EPS 1 mm
DIMENSOES: 40 x 340 mm (qtd 6)
OBS: Colado na face EXTERNA dos 6 paineis CAM-08. Sem isolante o duto externo vira uma aleta: ganha calor do ambiente ao longo dos 350 mm de subida.
