Brunobnhtr/projeto-integrador-camara-frigorifica/painel_interativo/cad_corte/camara/01_pecas/CAM-22.dxf

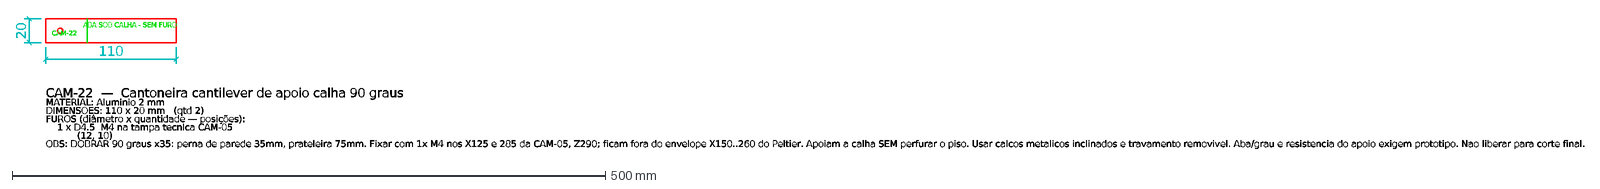
[picture p76: CAD file, 2026-11-02]
painel_interativo/cad_corte/camara/01_pecas/CAM-22.dxf
ABA SOB CALHA - SEM FURO
CAM-22
110
20
CAM-22 — Cantoneira cantilever de apoio calha 90 graus
MATERIAL: Aluminio 2 mm
DIMENSOES: 110 x 20 mm (qtd 2)
FUROS (diâmetro x quantidade — posições):
1 x D4.5 M4 na tampa tecnica CAM-05
(12, 10)
OBS: DOBRAR 90 graus x35: perna de parede 35mm, prateleira 75mm. Fixar com 1x M4 nos X125 e 285 da CAM-05, Z290; ficam fora do envelope X150..260 do Peltier. Ap
