Brunobnhtr/projeto-integrador-camara-frigorifica/painel_interativo/cad_corte/camara/01_pecas/CAM-08.dxf

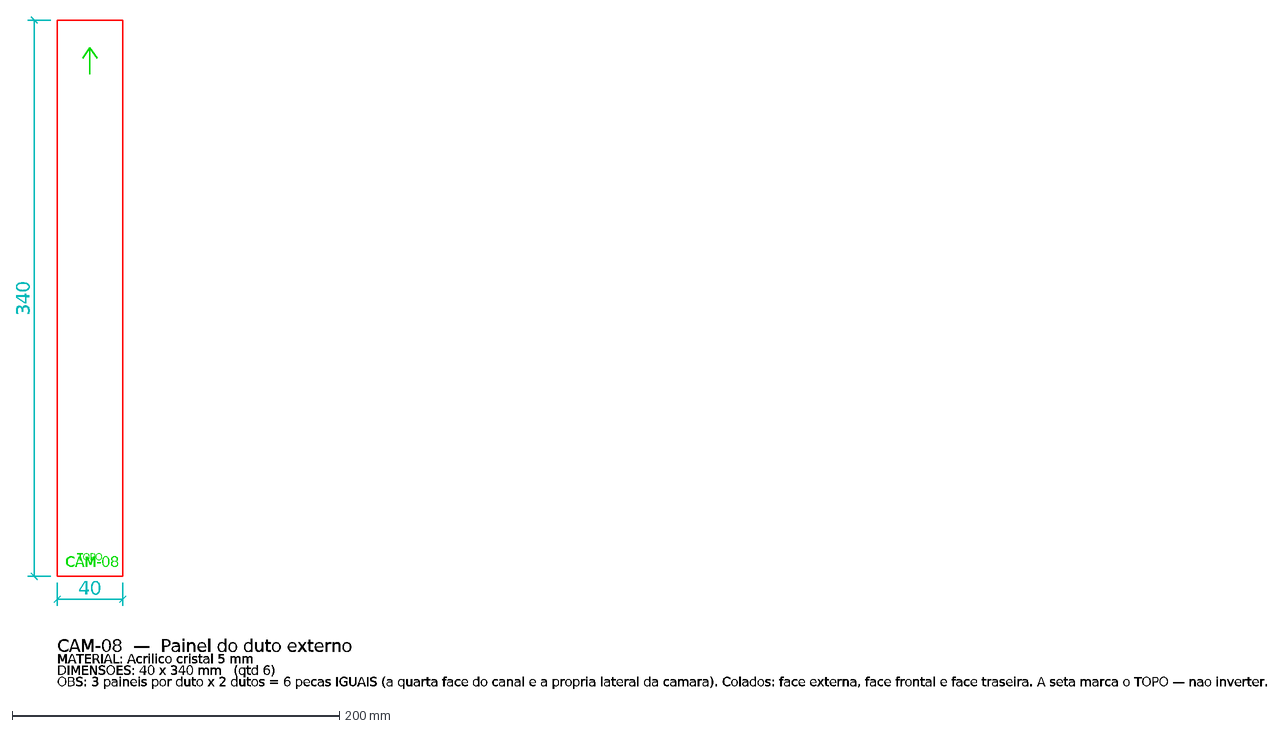
[picture p77: CAD file, 2026-11-02]
painel_interativo/cad_corte/camara/01_pecas/CAM-08.dxf
TOPO
CAM-08
40
340
CAM-08 — Painel do duto externo
MATERIAL: Acrilico cristal 5 mm
DIMENSOES: 40 x 340 mm (qtd 6)
OBS: 3 paineis por duto x 2 dutos = 6 pecas IGUAIS (a quarta face do canal e a propria lateral da camara). Colados: face externa, face frontal e face traseira.
