Brunobnhtr/projeto-integrador-camara-frigorifica/painel_interativo/cad_corte/camara/01_pecas/CAM-04.dxf

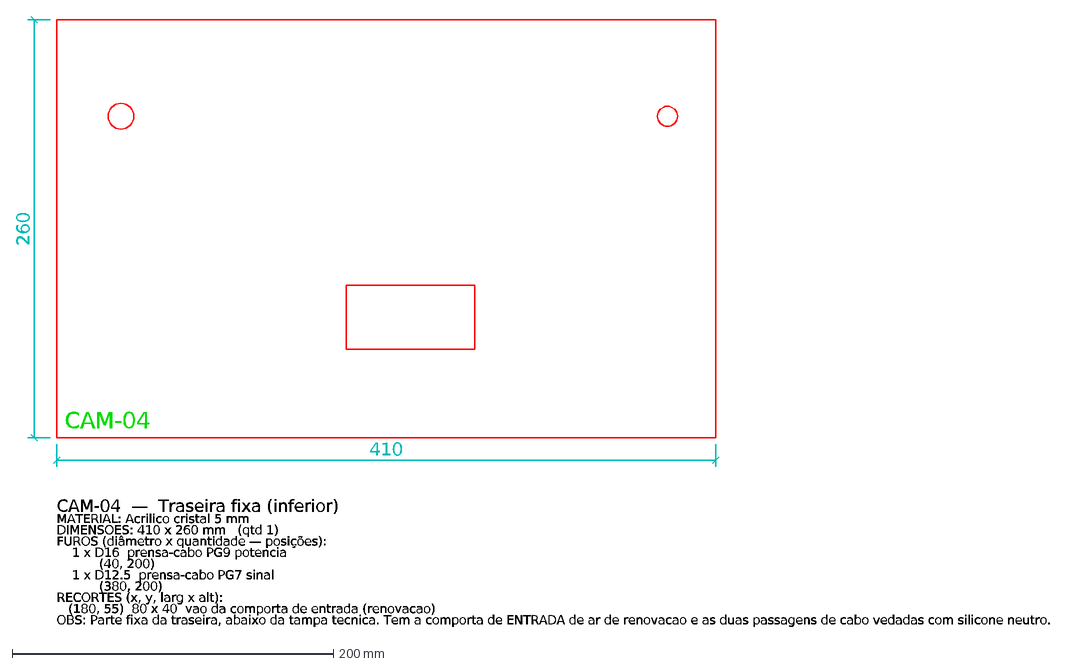
[picture p78: CAD file, 2026-11-02]
painel_interativo/cad_corte/camara/01_pecas/CAM-04.dxf
CAM-04
410
260
CAM-04 — Traseira fixa (inferior)
MATERIAL: Acrilico cristal 5 mm
DIMENSOES: 410 x 260 mm (qtd 1)
FUROS (diâmetro x quantidade — posições):
1 x D16 prensa-cabo PG9 potencia
(40, 200)
1 x D12.5 prensa-cabo PG7 sinal
(380, 200)
RECORTES (x, y, larg x alt):
(180, 55) 80 x 40 vao da comporta de entrada (renovacao)
OBS: Parte fixa da traseira, abaixo da tampa tecnica. Tem a comporta de ENTRADA de ar de renovacao e as duas passagens de cabo vedadas com silicone neutro.
