Brunobnhtr/projeto-integrador-camara-frigorifica/painel_interativo/cad_corte/camara/01_pecas/ISO-08.dxf

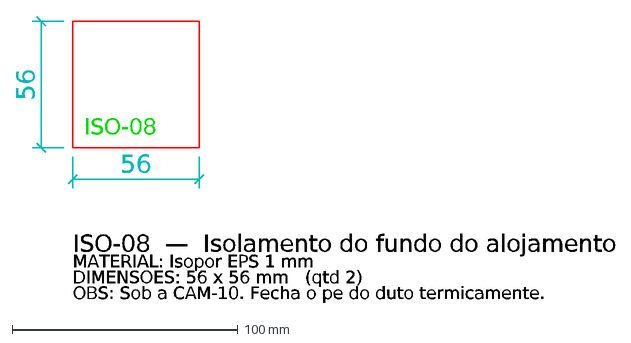
[picture p79: CAD file, 2026-11-02]
painel_interativo/cad_corte/camara/01_pecas/ISO-08.dxf
ISO-08
56
ISO-08 — Isolamento do fundo do alojamento
MATERIAL: Isopor EPS 1 mm
DIMENSOES: 56 x 56 mm (qtd 2)
OBS: Sob a CAM-10. Fecha o pe do duto termicamente.
