Brunobnhtr/projeto-integrador-camara-frigorifica/painel_interativo/cad_corte/camara/01_pecas/ISO-04.dxf

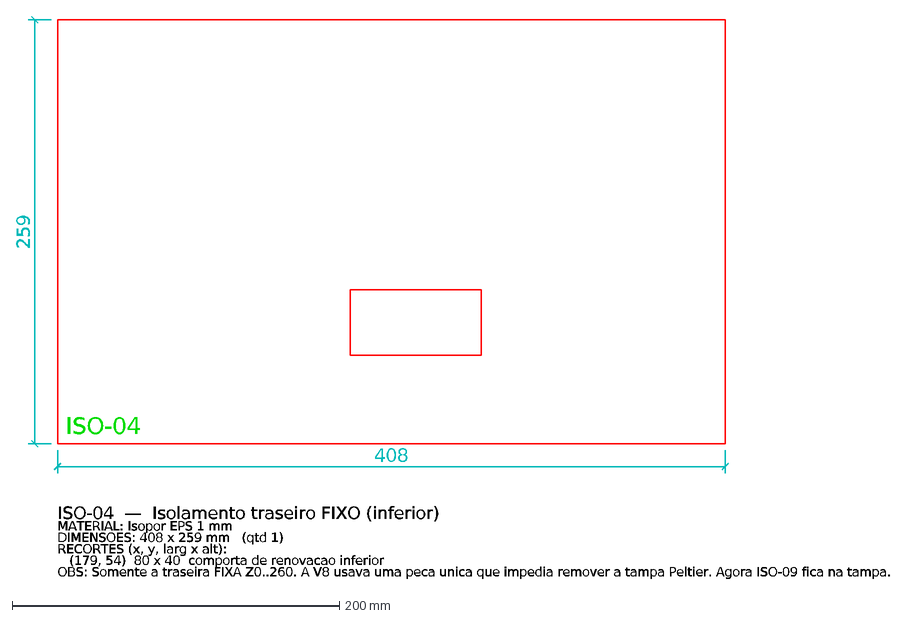
[picture p80: CAD file, 2026-11-02]
painel_interativo/cad_corte/camara/01_pecas/ISO-04.dxf
ISO-04
408
259
ISO-04 — Isolamento traseiro FIXO (inferior)
MATERIAL: Isopor EPS 1 mm
DIMENSOES: 408 x 259 mm (qtd 1)
RECORTES (x, y, larg x alt):
(179, 54) 80 x 40 comporta de renovacao inferior
OBS: Somente a traseira FIXA Z0..260. A V8 usava uma peca unica que impedia remover a tampa Peltier. Agora ISO-09 fica na tampa.
