Brunobnhtr/projeto-integrador-camara-frigorifica/painel_interativo/cad_corte/camara/01_pecas/CAM-07.dxf

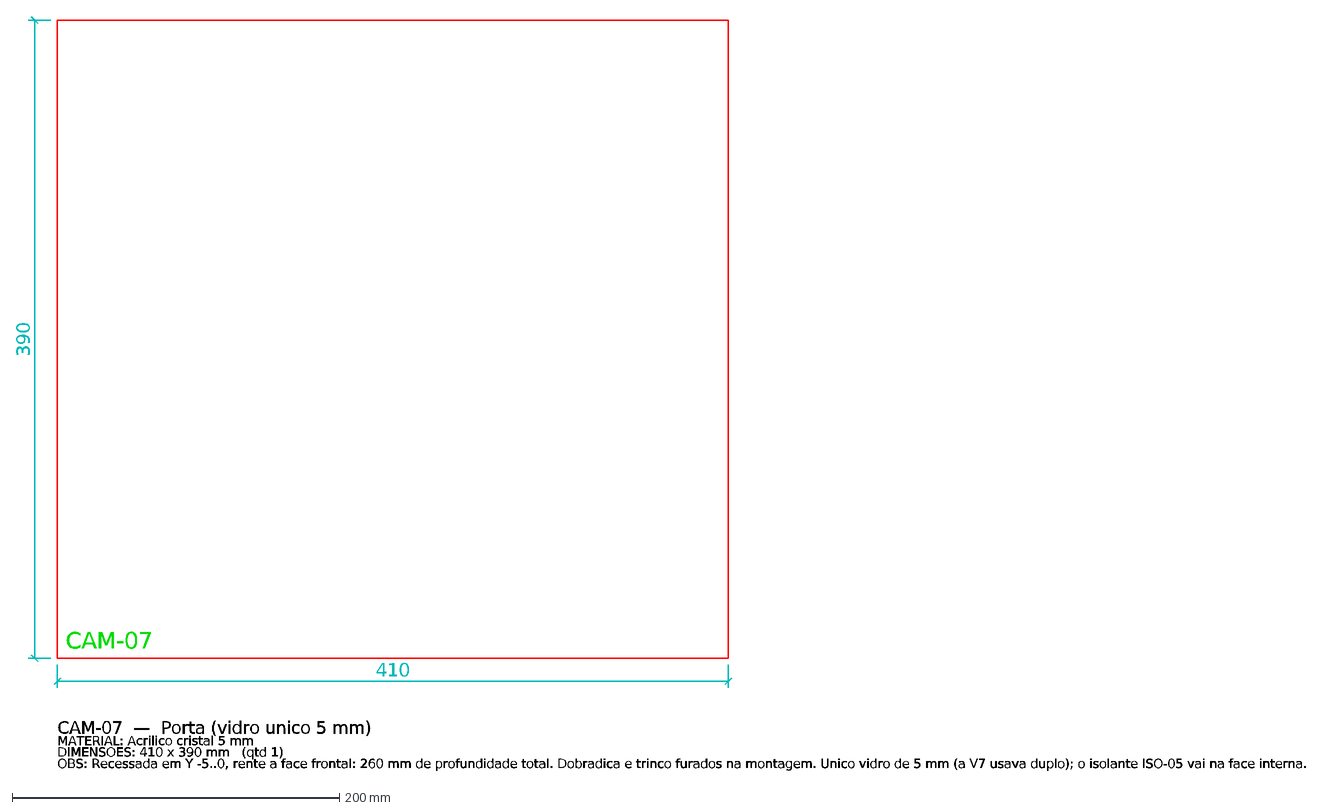
[picture p81: CAD file, 2026-11-02]
painel_interativo/cad_corte/camara/01_pecas/CAM-07.dxf
CAM-07
410
390
CAM-07 — Porta (vidro unico 5 mm)
MATERIAL: Acrilico cristal 5 mm
DIMENSOES: 410 x 390 mm (qtd 1)
OBS: Recessada em Y -5..0, rente a face frontal: 260 mm de profundidade total. Dobradica e trinco furados na montagem. Unico vidro de 5 mm (a V7 usava duplo); o
