Brunobnhtr/projeto-integrador-camara-frigorifica/painel_interativo/cad_corte/camara/01_pecas/CAM-18.dxf

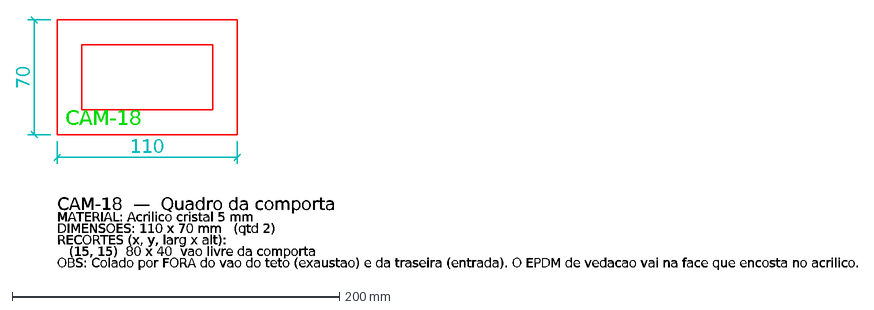
[picture p82: CAD file, 2026-11-02]
painel_interativo/cad_corte/camara/01_pecas/CAM-18.dxf
CAM-18
110
70
CAM-18 — Quadro da comporta
MATERIAL: Acrilico cristal 5 mm
DIMENSOES: 110 x 70 mm (qtd 2)
RECORTES (x, y, larg x alt):
(15, 15) 80 x 40 vao livre da comporta
OBS: Colado por FORA do vao do teto (exaustao) e da traseira (entrada). O EPDM de vedacao vai na face que encosta no acrilico.
