Brunobnhtr/projeto-integrador-camara-frigorifica/painel_interativo/cad_corte/camara/01_pecas/ISO-03.dxf

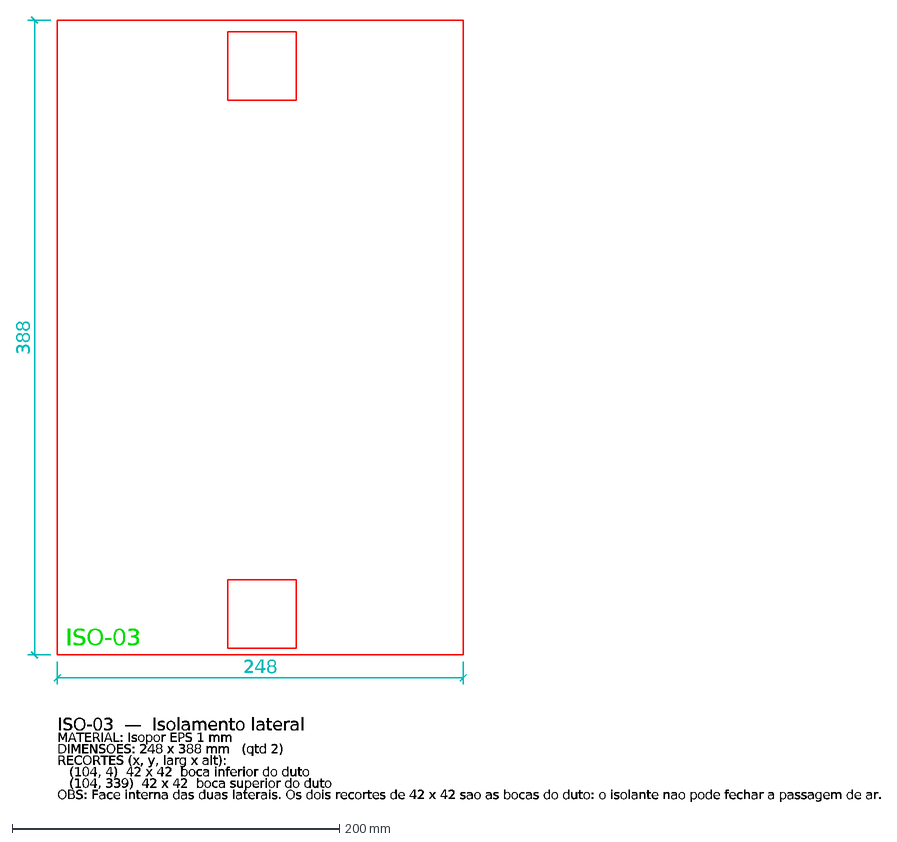
[picture p83: CAD file, 2026-11-02]
painel_interativo/cad_corte/camara/01_pecas/ISO-03.dxf
ISO-03
248
388
ISO-03 — Isolamento lateral
MATERIAL: Isopor EPS 1 mm
DIMENSOES: 248 x 388 mm (qtd 2)
RECORTES (x, y, larg x alt):
(104, 4) 42 x 42 boca inferior do duto
(104, 339) 42 x 42 boca superior do duto
OBS: Face interna das duas laterais. Os dois recortes de 42 x 42 sao as bocas do duto: o isolante nao pode fechar a passagem de ar.
