Brunobnhtr/projeto-integrador-camara-frigorifica/painel_interativo/cad_corte/camara/01_pecas/ISO-07.dxf

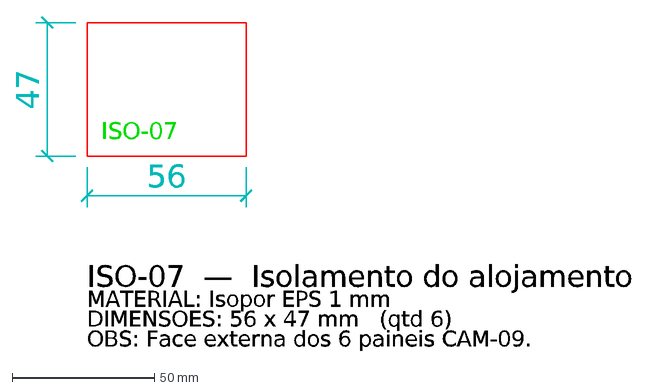
[picture p84: CAD file, 2026-11-02]
painel_interativo/cad_corte/camara/01_pecas/ISO-07.dxf
ISO-07
56
47
ISO-07 — Isolamento do alojamento
MATERIAL: Isopor EPS 1 mm
DIMENSOES: 56 x 47 mm (qtd 6)
OBS: Face externa dos 6 paineis CAM-09.
