Brunobnhtr/projeto-integrador-camara-frigorifica/painel_interativo/cad_corte/camara/01_pecas/CAM-20.dxf

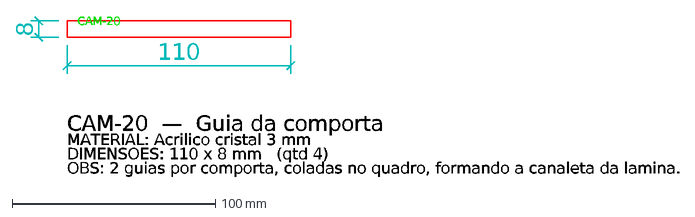
[picture p85: CAD file, 2026-11-02]
painel_interativo/cad_corte/camara/01_pecas/CAM-20.dxf
CAM-20
110
8
CAM-20 — Guia da comporta
MATERIAL: Acrilico cristal 3 mm
DIMENSOES: 110 x 8 mm (qtd 4)
OBS: 2 guias por comporta, coladas no quadro, formando a canaleta da lamina.
