Brunobnhtr/projeto-integrador-camara-frigorifica/painel_interativo/cad_corte/camara/01_pecas/ISO-05.dxf

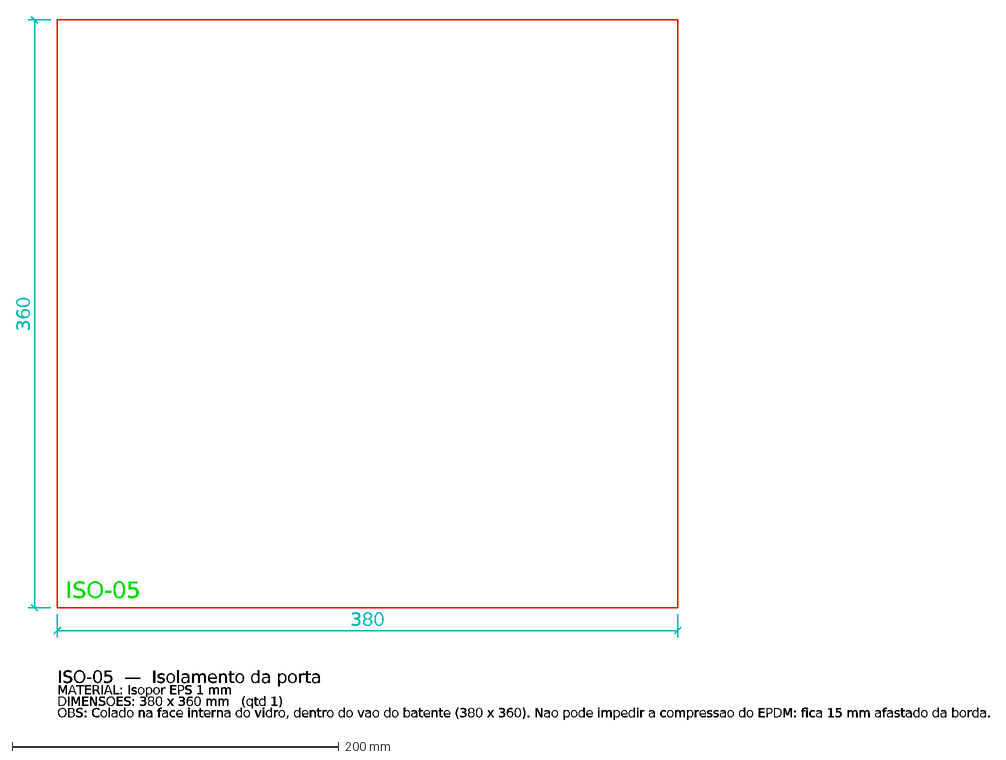
[picture p86: CAD file, 2026-11-02]
painel_interativo/cad_corte/camara/01_pecas/ISO-05.dxf
ISO-05
380
360
ISO-05 — Isolamento da porta
MATERIAL: Isopor EPS 1 mm
DIMENSOES: 380 x 360 mm (qtd 1)
OBS: Colado na face interna do vidro, dentro do vao do batente (380 x 360). Nao pode impedir a compressao do EPDM: fica 15 mm afastado da borda.
