Brunobnhtr/projeto-integrador-camara-frigorifica/painel_interativo/cad_corte/camara/01_pecas/CAM-06.dxf

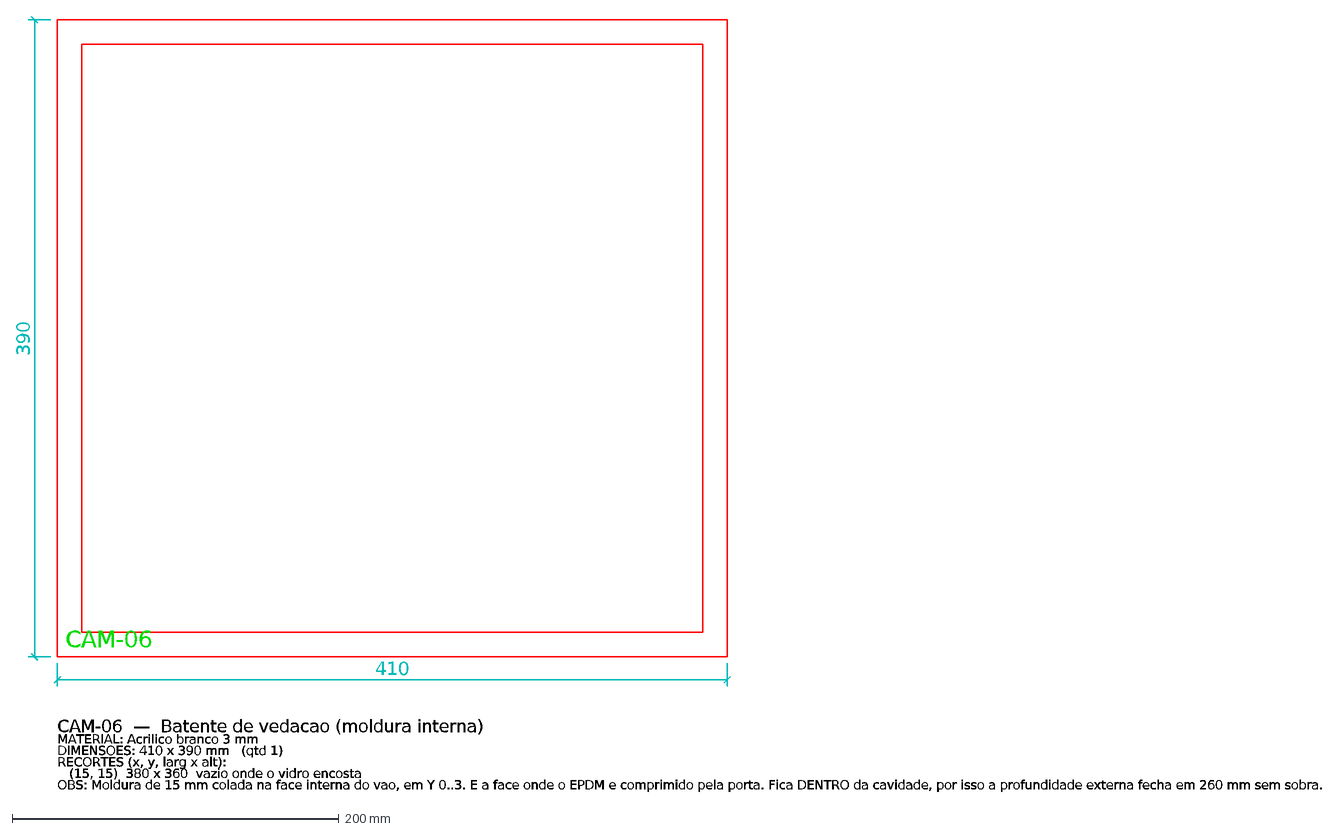
[picture p87: CAD file, 2026-11-02]
painel_interativo/cad_corte/camara/01_pecas/CAM-06.dxf
CAM-06
410
390
CAM-06 — Batente de vedacao (moldura interna)
MATERIAL: Acrilico branco 3 mm
DIMENSOES: 410 x 390 mm (qtd 1)
RECORTES (x, y, larg x alt):
(15, 15) 380 x 360 vazio onde o vidro encosta
OBS: Moldura de 15 mm colada na face interna do vao, em Y 0..3. E a face onde o EPDM e comprimido pela porta. Fica DENTRO da cavidade, por isso a profundidade e
