Brunobnhtr/projeto-integrador-camara-frigorifica/painel_interativo/cad_corte/camara/01_pecas/CAM-21.dxf

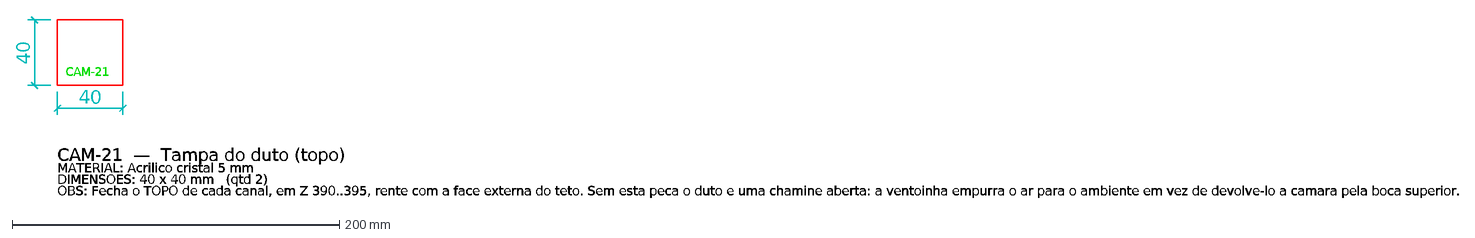
[picture p88: CAD file, 2026-11-02]
painel_interativo/cad_corte/camara/01_pecas/CAM-21.dxf
CAM-21
40
CAM-21 — Tampa do duto (topo)
MATERIAL: Acrilico cristal 5 mm
DIMENSOES: 40 x 40 mm (qtd 2)
OBS: Fecha o TOPO de cada canal, em Z 390..395, rente com a face externa do teto. Sem esta peca o duto e uma chamine aberta: a ventoinha empurra o ar para o amb
