Brunobnhtr/projeto-integrador-camara-frigorifica/painel_interativo/cad_corte/camara/01_pecas/CAM-11.dxf

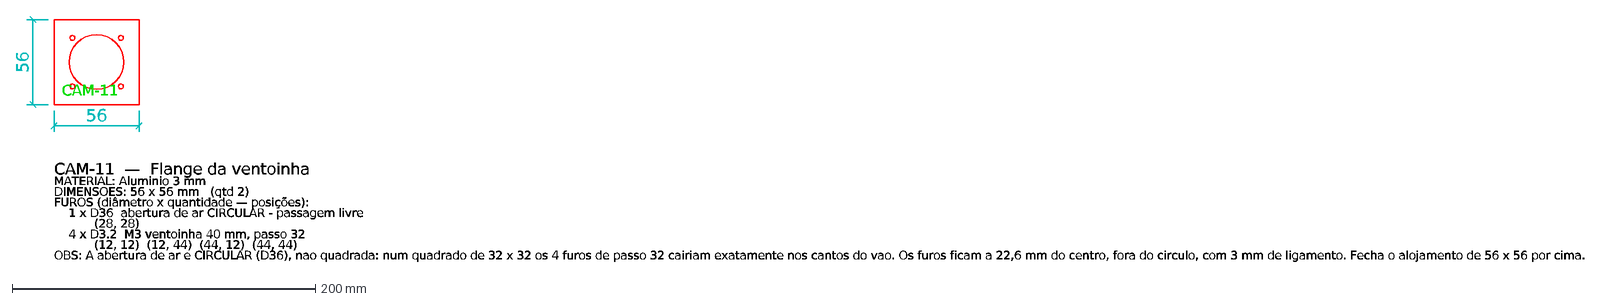
[picture p89: CAD file, 2026-11-02]
painel_interativo/cad_corte/camara/01_pecas/CAM-11.dxf
CAM-11
56
CAM-11 — Flange da ventoinha
MATERIAL: Aluminio 3 mm
DIMENSOES: 56 x 56 mm (qtd 2)
FUROS (diâmetro x quantidade — posições):
1 x D36 abertura de ar CIRCULAR - passagem livre
(28, 28)
4 x D3.2 M3 ventoinha 40 mm, passo 32
(12, 12) (12, 44) (44, 12) (44, 44)
OBS: A abertura de ar e CIRCULAR (D36), nao quadrada: num quadrado de 32 x 32 os 4 furos de passo 32 cairiam exatamente nos cantos do vao. Os furos ficam a 22,6
