Brunobnhtr/projeto-integrador-camara-frigorifica/painel_interativo/cad_corte/camara/01_pecas/ISO-02.dxf

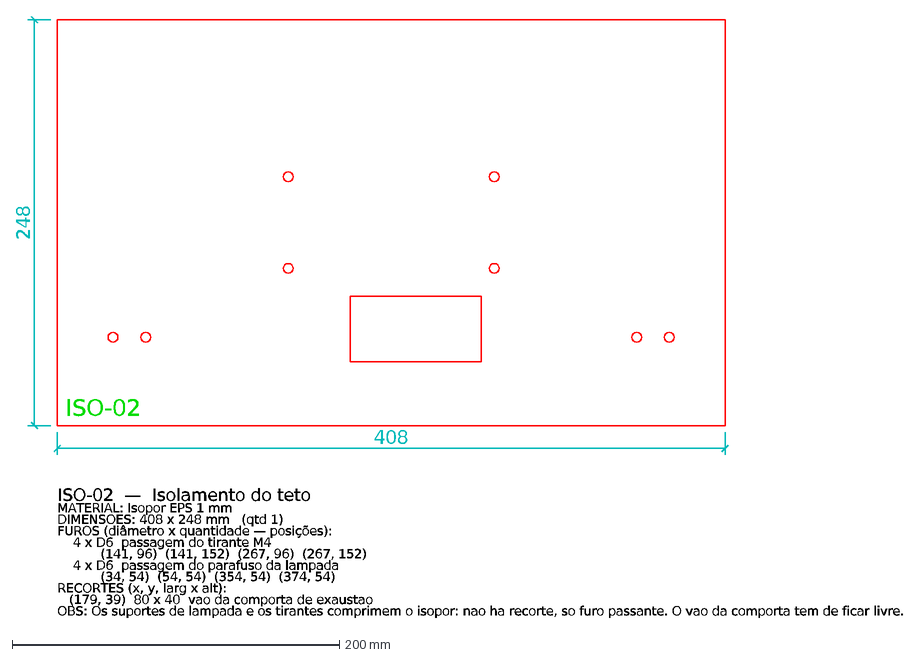
[picture p90: CAD file, 2026-11-02]
painel_interativo/cad_corte/camara/01_pecas/ISO-02.dxf
ISO-02
408
248
ISO-02 — Isolamento do teto
MATERIAL: Isopor EPS 1 mm
DIMENSOES: 408 x 248 mm (qtd 1)
FUROS (diâmetro x quantidade — posições):
4 x D6 passagem do tirante M4
(141, 96) (141, 152) (267, 96) (267, 152)
4 x D6 passagem do parafuso da lampada
(34, 54) (54, 54) (354, 54) (374, 54)
RECORTES (x, y, larg x alt):
(179, 39) 80 x 40 vao da comporta de exaustao
OBS: Os suportes de lampada e os tirantes comprimem o isopor: nao ha recorte, so furo passante. O vao da comporta tem de ficar livre.
