Brunobnhtr/projeto-integrador-camara-frigorifica/painel_interativo/cad_corte/camara/01_pecas/CAM-16.dxf

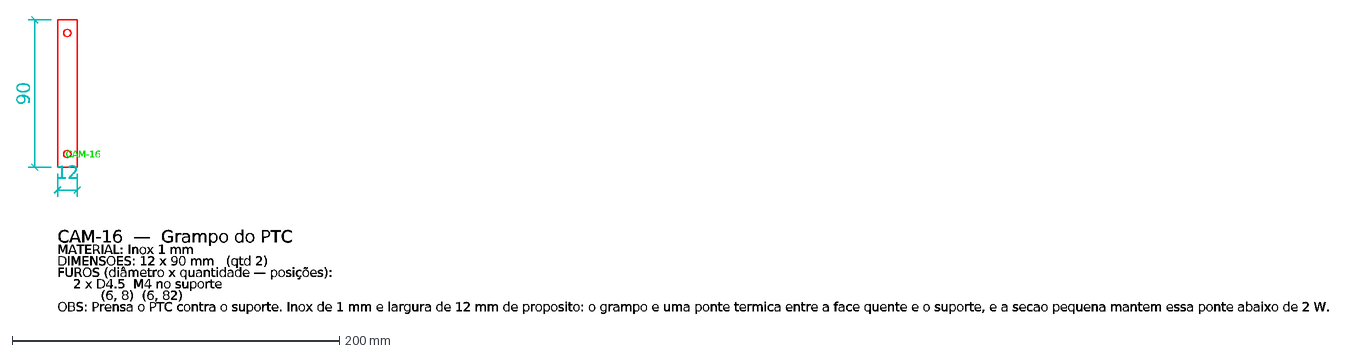
[picture p91: CAD file, 2026-11-02]
painel_interativo/cad_corte/camara/01_pecas/CAM-16.dxf
CAM-16
12
90
CAM-16 — Grampo do PTC
MATERIAL: Inox 1 mm
DIMENSOES: 12 x 90 mm (qtd 2)
FUROS (diâmetro x quantidade — posições):
2 x D4.5 M4 no suporte
(6, 8) (6, 82)
OBS: Prensa o PTC contra o suporte. Inox de 1 mm e largura de 12 mm de proposito: o grampo e uma ponte termica entre a face quente e o suporte, e a secao pequen
