Brunobnhtr/projeto-integrador-camara-frigorifica/(list of files, cad)

Other CAD files:
painel_interativo/cad_corte/V12_SUPORTES_PTC_LAMPADAS_FANS_INTERNAS/CAM-25_bandeja_lampadas.dxf
painel_interativo/cad_corte/camara/01_pecas/CAM-05.dxf
painel_interativo/cad_corte/camara/01_pecas/CAM-17.dxf
