Brunobnhtr/projeto-integrador-camara-frigorifica/(commit log)

2026-08-13 Projeto Integrador - Planta Industrial Didatica com Camara Frigorifica
    Documentacao completa em 6 camadas de construcao, com a arquitetura de
    energia "Potencia em 24 V" ja aplicada em todos os documentos:
    - Carga termica (2x Peltier em serie + PTC 24 V) ligada direto ao
    barramento de 24 V, sem conversor intermediario
    - Poste P1 vira derivacao; T2 e T3 sao LM2596 com display integrado
    - Crowbar Zener eliminado (protecao nativa do LM2596)
    - Sinaleiros do painel em 24 V via ULN2803 na placa de interface PI-1
    - 7 desenhos tecnicos em SVG, simulador Python, projeto Wokwi e
    tutoriais em video (Remotion)
    [BOM_Projeto_Integrador.xlsx]
2026-08-13 Corrige gerador da BOM: itens eliminados voltavam para a lista de compras
    A tabela "Itens que NAO existem mais nesta versao" tem "Item removido"
    no cabecalho, e o filtro so testava "Item" — entao ela era importada
    como se fossem itens a comprar. Alem disso, o guard contra tachado
    (~~item~~) rodava DEPOIS de limpar(), que ja havia removido os "~~",
    entao nunca disparava.
    Resultado: XL4016, XL4015, 6 diodos Zener, cooler de 30 mm, tubo de
    63 mm e os voltimetros de 3 fios apareciam na planilha de compras.
    Correcoes:
    - checagem de tachado feita na celula BRUTA, antes de limpar()
    - secoes de itens removidos ignoradas por regex
    Planilha regerada: 166 itens em 17 secoes (era 182 em 18, com 16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
    [BOM_Projeto_Integrador.xlsx]
2026-08-14 Realinha o projeto ao edital 6.01 03 e inicia a refatoracao didatica
    O edital pede "Sistema de Controle Inteligente com ESP32 para Cabine
    Climatizada", com a restricao de manter a continuidade operacional.
    A documentacao estava centrada na maquete de distribuicao e nao cobria
    o nucleo do problema: os dispositivos energizados sob ensaio.
    Doc 01 (Visao Geral):
    - Camada "Em palavras simples" nas secoes principais
    - Tabela mapeando cada exigencia do edital ao ponto do projeto
    - Arquitetura de controle DUPLA com arbitragem por chave LOCAL/REMOTO:
    Arduino mantem controle de tempo real e seguranca; ESP32 supervisiona
    sempre e comanda quando em REMOTO. Atende a restricao de nao parar o
    proces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
2026-08-14 Refatoracao didatica: Docs 02, 03, 10, 11, 12 e 20
    Cada documento ganha uma abertura 'Em palavras simples' com analogias
    do dia a dia e um dicionario dos termos tecnicos que ele usa. O
    conteudo tecnico permanece integralmente abaixo.
    - Doc 02: energia explicada como agua encanada (pressao/vazao/cano)
    - Doc 03: como usar a lista, os 5 lotes e os 6 erros de compra
    - Doc 10: os 3 pontos criticos da base (esquadro, vao, furar antes)
    - Doc 11: a rua eletrica em miniatura e por que o P1 nao tem trafo
    - Doc 12: geladeira que tambem e forno; por que a porta e o vilao
    - Doc 20: as 3 pecas que organizam um painel e por que 3 trilhos
2026-08-14 Refatoracao didatica: Docs 30, 31, 32, 40, 41, 42 e 50
    Completa a camada 'Em palavras simples' em todos os documentos, com
    analogias e dicionario de termos por documento.
    - Doc 30: montagem por trechos; por que os cabos sao numerados
    - Doc 31: como a maquina para; o selo explicado passo a passo; por
    que os botoes de parada sao NF (a falha leva ao estado seguro)
    - Doc 32: o sistema nervoso; por que sinal e sensivel a ruido
    - Doc 40: PID explicado como dirigir a 60 km/h; por que PWM de 1 Hz
    - Doc 41: ESP32 e a analogia do carro de autoescola; MQTT como mural
    - Doc 42: errar de graca antes de comprar; ordem de testes
    - Doc 50: comissionar por partes, nunca tudo de uma vez
    Doc 41 tambem ganh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
2026-08-14 BOM: links de busca automaticos + PTC ajustado para 80 W
    Nenhuma skill adequada de sourcing existe no registro (as candidatas
    tem 18-173 instalacoes, autores desconhecidos e miram a Amazon, nao o
    Mercado Livre). A pesquisa foi feita direto.
    Achado da pesquisa: PTC de 24 V NAO existe em 60 W no mercado
    brasileiro. As versoes reais sao 80, 100 e 150 W. Especificacao
    mudada para 80 W - fica equilibrada contra os ~60 W de refrigeracao
    e mantem a corrente em 3,3 A. A de 150 W passaria a ser o pior caso
    do ramal (6,25 A) e desequilibraria o controle.
    Gerador da planilha agora monta sozinho, para cada item:
    - link de busca no Mercado Livre
    - link de busca na Amazon BR
    - coluna separada para colar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
    [BOM_Projeto_Integrador.xlsx]
2026-08-14 BOM: coluna AliExpress com busca em ingles e curadoria do que importar
    O AliExpress exige busca em INGLES - termo em portugues nao acha quase
    nada la. E nem todo item deve ser importado, entao a lista e curada:
    52 itens ganham link de AliExpress, 123 nao.
    Ausencia de link e recomendacao de compra nacional, nao falha:
    - Disjuntor, fonte, reles KA1/KA2, porta-fusiveis e trilho DIN ficam
    nacionais porque fazem parte da cadeia de protecao, e o edital exige
    'conformidade com normas de seguranca eletrica' - importacao direta
    nao traz certificacao INMETRO
    - Cabos, MDF, acrilico e cenografia por peso/volume
    Nova secao no Doc 03 sobre importar, com o que muda no planejamento:
    - prazo de 20 a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
    [BOM_Projeto_Integrador.xlsx]
2026-08-14 BOM: fusiveis de lamina, localizacao na subestacao e bloco de 3 posicoes
    Esclarecimentos motivados por duvida real de compra:
    1. Os 3 ramais sao TODOS de 24 V no ponto dos fusiveis. E natural ler
    '3 ramais' e pensar '24, 12 e 5 V', mas os 12 V e 5 V so nascem no
    topo dos postes P2 e P3, DEPOIS dos LM2596. O que difere entre os
    ramais e a CORRENTE (6 A no R1, menos de 1 A nos outros), nao a
    tensao - e e por isso que F1 e de 10 A e os outros de 2 A.
    2. F1/F2/F3 ficam na SUBESTACAO, nao no painel. Eles protegem a linha
    que atravessa a maquete pelos postes; no painel, o trecho mais
    longo e exposto ficaria sem protecao. Mesmo principio da chave
    fusivel real, que fica no pos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
2026-08-14 Subestacao vira patio aberto com casa de comando; PTC 80 W propagado
    O usuario decidiu abrir a subestacao (sem caixa), com uma caixa apenas
    para a fonte. Isso quebrava a regra de ouro do projeto - '127 V so
    dentro da caixa fechada' - entao a solucao foi reproduzir o que uma
    subestacao real ao tempo tem: patio aberto e cercado + CASA DE COMANDO
    fechada.
    - Dentro da casa de comando (127 V): fonte, disjuntor, chave rotativa,
    barra de terra. Disjuntor e chave montam NA PAREDE: corpo dentro,
    manopla fora, como em painel real
    - No patio, a vista (24 V, SELV): bloco de fusiveis F1/F2/F3, bornes,
    estruturas. Ganho didatico: os fusiveis viram chaves fusiveis
    visiveis, como numa subestacao de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
2026-08-14 BOM: Arduino Mega com 1 reserva e orientacao de versao USB
    - Quantidade 1 -> 2. Ele roda o PID e as protecoes; pela regra de
    importacao definida no doc ('se para o projeto quando falha e vem do
    exterior, compre dois'), estava faltando na lista de reservas
    - Versao recomendada: CH340 + USB Type-C. O chip USB nao e o
    processador - o ATmega2560 e o mesmo nas tres versoes; muda so a
    ponte USB<->serial, usada apenas para gravar e depurar
    - Ressalva: CH340 pode exigir driver no Windows. Em PC de escola sem
    permissao de instalar, a versao com ATmega16U2 ('sem CH340') e nativa
    - Ressalva Type-C: usar cabo A-para-C, porque placas baratas as vezes
    omitem os resistores de 5,1k nos pinos CC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
2026-08-14 Corrige ligacao do L_EN: vai junto com o R_EN, nao ao 0 V
    Duvida do usuario ('por que 2 BTS se o modulo tem R_EN e L_EN?')
    levou a um erro real na fiacao documentada.
    O IBT-2 nao tem dois canais independentes: e UMA ponte H, e as duas
    metades compartilham o mesmo par de saida (M+/M-). A corrente sai por
    M+, atravessa a carga e VOLTA por M- - ou seja, precisa atravessar a
    metade L.
    Com L_EN aterrado (como estava documentado), a metade L fica
    desabilitada e o retorno passa pelo DIODO DE CORPO do MOSFET inferior:
    diodo de corpo: ~0,9 V x 6,0 A = ~5,4 W por driver
    MOSFET: ~0,1 V x 6,0 A = ~0,6 W por driver
    Eram ~5 W de calor desnecessario por modulo, contra um balanco termico
    que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
2026-08-14 BOM: guia de compra dos reles de interface
    Duvida do usuario ao procurar no AliExpress. O vocabulario e a
    armadilha principal: 'reversivel' vira CO/changeover em ingles, e o
    anuncio quase nunca usa a palavra esperada.
    - Tabela SPST-NO / 1CO / 2CO com o que serve para cada rele
    - KA1 precisa de 2CO (DPDT); 5 a 8 A ja sobra porque conduz mA
    - KA2 precisa do valor declarado em DC ('10A 250VAC / 10A 30VDC').
    So o de VAC nao basta: em corrente continua o arco nao se apaga
    sozinho e o contato desgasta a cada desligamento
    - Recomendado 16 A em vez de 10 A no KA2: ao fechar, os capacitores
    de entrada dos 2 BTS carregam de uma vez, num pico curto de dezenas
    de amperes que vai desgastando o c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
2026-08-14 BOM: reles - termo correto no Brasil e solucao real para o KA2
    O usuario nao achava os reles em loja nenhuma. Motivo: no Brasil o
    termo comercial e 'rele ACOPLADOR', nao 'rele de interface'.
    Pesquisa de mercado revelou um problema que a especificacao anterior
    nao cobria: praticamente todo rele acoplador vendido no Brasil e de
    6 a 8 A. Isso atende o KA1 (conduz mA) mas NAO atende o KA2, cuja
    carga e 6,0 A - 100% da capacidade, sem margem.
    Solucao para o KA2: rele de 8 pinos (JQX-13F / LY2N 24VDC, 2 contatos
    de 10 A) + base PTF08A/PYF08A para trilho DIN. E o arranjo classico de
    painel brasileiro, custa ~R$ 40 o conjunto e esta em qualquer loja.
    Bonus: o mesmo modelo atende o KA1, entao da pa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
2026-08-14 BOM: relés KA1 e KA2 padronizados num modelo só
    Comparacao de dois anuncios reais avaliados pelo usuario:
    Finder 49.52 - R$ 58 - 2 reversiveis 8 A, base nao informada
    Generico 8 pinos - R$ 39 - 2 reversiveis 10 A, base inclusa
    Escolhido o generico: o Finder e melhor rele, mas 8 A nao atende o
    KA2 (carga de 6,0 A), entao seria preciso comprar o Finder E um
    segundo modelo para a potencia. O generico de 10 A atende os dois -
    3 unidades (2 em uso + 1 reserva) por ~R$ 117.
    Ressalva do generico documentada com o raciocinio: sem marca nao ha
    datasheet com a corrente em DC, mas desgaste de contato depende de
    QUANTAS VEZES ele interrompe corrente. O KA2 so abre com 6 A em STOP
    ou emergencia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
2026-08-14 BOM: coerencia da nota sobre importar reles
    A tabela 'o que nao importar' justificava os reles com 'generico nao
    fornece datasheet' - o que passou a conflitar com a decisao de comprar
    justamente um generico nacional.
    O argumento correto e outro: comprando aqui voce ve o produto, tem
    nota fiscal e consegue trocar. Importado, um rele sem marca chega em
    40 dias e sem recurso - e rele e peca de seguranca, no caminho critico
    da montagem.
2026-08-14 Doc 31: explicita que o rele nao esta no caminho do comando
    Duvida do usuario: 'os comandos de pulso passam por arduino > rele >
    bts, ou arduino > bts?'. O documento nao deixava isso explicito.
    Acrescentado diagrama dos DOIS CAMINHOS, que so se encontram dentro do
    chip do BTS7960:
    - potencia: fonte > F1 > P1 > KA2 > BD-POT > B+ do BTS
    - comando: Arduino D4/D5 > pinos logicos do BTS
    E a tabela de papeis: KA2 e chave de SEGURANCA (comandada pelas
    botoeiras, atua dezenas de vezes na vida do projeto); BTS e chave de
    CONTROLE (comandada pelo Arduino, 86.400 vezes por dia a 1 Hz).
    Numero que torna a distincao concreta: rele tem vida eletrica de
    ~100.000 operacoes. A 1 Hz acabaria em ~28 horas.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
2026-08-14 Corrige erro: os BTS NAO recebem 24 V ao ligar o painel
    Pergunta do usuario expos uma contradicao que eu havia introduzido no
    Doc 02 §2.9.
    O passo 3 afirmava '24 V presentes nos 3 ramais - inclusive na ENTRADA
    dos BTS (P1 e passante)'. Isso contradizia o passo 6 do mesmo bloco
    ('KA2 fecha -> 24 V chegam ao BD-POT') e esta errado.
    Caminho real, conforme os cabos 34/35/45 do Doc 30:
    entrada do painel -> KA2 contato 11 -> [NA, ABERTO] -> contato 14
    -> BD-POT -> BTS B+
    Com o KA2 desenergizado, BD-POT e BTS B+ ficam em 0 V. O que e
    passante e o poste P1, nao o caminho ate o driver.
    O que e verdade e foi mantido, com o enquadramento correto: antes
    havia DUAS barreiras em serie (partida do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
2026-08-14 BOM: adota kit duplo de Peltier com as 3 modificacoes obrigatorias
    Usuario encontrou um kit pronto com 2x TEC1-12706, radiador, blocos
    frios, ventoinhas e junta termica ja montada - que e a parte mais
    facil de errar (quantidade de pasta, aperto uniforme, vedacao).
    Confirmado pelo usuario: fios das pastilhas separaveis, ventoinhas com
    fiacao independente, e a camara tem espaco.
    O kit e anunciado como 12 V / 15 A, o que denuncia ligacao em PARALELO
    (2 em serie dariam 24 V / 6 A). Tres modificacoes ficam documentadas:
    1. Religar as pastilhas em serie -> 24 V / 6,0 A
    2. Separar as ventoinhas das pastilhas. Kits assim costumam ter UMA
    entrada de 12 V alimentando tudo junto; ligar 24 V ali q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
2026-08-14 Esquema eletrico da PI-1: separa em 4 blocos + desenho SVG
    O desenho ASCII anterior era confuso: ao espremer 4 circuitos numa
    figura so, as colunas empurraram o C3 para debaixo da coluna do D9,
    sugerindo uma ligacao que nao existe. O usuario apontou corretamente.
    Correcao de abordagem: os 4 circuitos da placa sao ELETRICAMENTE
    INDEPENDENTES - so compartilham o barramento de 0 V. Passam a ser
    apresentados separados:
    A - filtros dos pinos IS (C1, C2)
    B - divisor que le os 24 V (R1, R2, C3) - com R2 e C3 em PARALELO,
    os dois do no D25 para o 0 V
    C - pull-up do 1-Wire (R3)
    D - driver dos sinaleiros (ULN2803A)
    Novo desenho: desenhos/08_placa_pi1_esquema.svg, no mesmo padrao dos
    o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
2026-08-14 Diagrama de ligacao da PI-1 + esclarece que os bornes nao sao E/S
    Duas duvidas do usuario, ambas por falha da apresentacao:
    1. 'Nao entendi porque no borne inferior tem 24V-POT e 24V-SRV, os
    bornes inferiores sao saidas?'
    Nao sao. J1 e J2 estao divididos por PARA ONDE O FIO VAI - J1 para
    o Arduino (ao lado, no mesmo trilho), J2 para o painel (blocos do
    trilho 1 e lampadas da porta). E geografia, nao direcao de sinal:
    dentro de cada borne ha sinal entrando e saindo. Os dois 24 V ficam
    em J2 porque vem dos blocos de distribuicao, nao do Arduino.
    Rotulos dos desenhos trocados para 'todos estes fios vao para o
    ARDUINO' / 'para o PAINEL'.
    2. 'Nao consegue criar diagram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
2026-08-14 Esquema eletrico da PI-1 em norma IEC, gerado por script
    O usuario achou o Circuit Diagram (circuit-diagram.org) - e foi a
    primeira ferramenta que resolve o problema dos dois lados:
    - editor web gratuito, sem instalar nada (para ele editar)
    - formato .cddx ABERTO: ZIP com XML documentado (para eu gerar)
    - CLI oficial que renderiza PNG/SVG (para eu VALIDAR antes de entregar)
    Sobre as opcoes descartadas antes:
    - repo Move2win/Fritzing: binarios .exe de terceiro nao verificado.
    Nao instalei. E nao adiantaria: Fritzing e GUI, eu nao clico nele
    - compilar o fritzing-app oficial: exigiria Qt (3-5 GB) que a maquina
    nao tem, 2-4 h de build, e continuaria sendo GUI
    Gerado desenhos/10_placa_pi1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
2026-08-14 Corrige o esquema da PI-1: liga todos os fios e acerta os pinos do CI
    O usuario apontou que os fios estavam soltos. Duas correcoes:
    1. BARRAMENTO DE 0 V. Cada retorno estava desenhado como um borne '0 V'
    isolado, o que fazia o desenho parecer desconectado. Agora ha uma
    linha horizontal unica ligando C1, C2, R2 e C3, com nos marcados e
    UM borne de 0 V - que e como o circuito realmente e.
    2. FIOS ATE OS PINOS DO CI. Os rotulos estavam posicionados ao lado do
    ULN2803 mas sem fio nenhum ligando. Agora ha condutor de cada borne
    ate o pino.
    E um erro que so apareceu ao ligar os fios: o componente 'integrated
    _circuit' numera os pinos ALTERNANDO esquerda/direita (p0 esq, p1 dir,
    p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
2026-08-14 PI-1 com entradas e saidas separadas + esclarece o 0 V unico
    Decisao do usuario: J1 = so ENTRADAS, J2 = so SAIDAS. O fluxo passa a
    ser sempre 'vem de algum lugar -> J1 -> componente -> J2 -> vai para
    algum lugar', que e como ele esperava desde o inicio e e mais facil de
    seguir na montagem.
    - J1 com 11 vias, cada uma com a ORIGEM documentada
    - J2 com 8 vias, cada uma com o DESTINO documentado
    - Esquema redesenhado com fluxo esquerda->direita
    Respondida a duvida dos neutros, que era a pergunta tecnica mais
    importante da conversa: NAO existem 3 neutros. Os LM2596 sao
    conversores nao isolados - o 0 V da entrada e o da saida sao o mesmo
    condutor. E tem que ser unico porque o Arduino mede os sin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
2026-08-14 Painel interativo em React Flow: primeira versao navegavel
    Base: o app React do projeto antigo (cadesimu), que ja usava React Flow.
    Copiado para painel_interativo/ e refatorado - o backend em Python e os
    dados mock sairam; entrou o modelo de dados do NOSSO painel.
    src/data/painel.js e a fonte da verdade, com tres conceitos:
    - COMPONENTES: equipamentos com terminais nomeados e trilho
    - CABOS: cada fio com origem, destino, bitola, cor e numero do Doc 30
    - PI1_INTERNO: os 7 componentes soldados dentro da placa
    Funciona hoje:
    - painel desenhado por trilho, com cor por tensao
    - clicar num componente abre os terminais dele
    - cada terminal lista os cabos, e clicar num destino NAVEGA ate o outro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
2026-08-14 npm audit fix: zera as 6 vulnerabilidades do painel interativo
    Todas em ferramenta de build, nada no codigo que roda no navegador.
    As correcoes sao compativeis - nenhuma exigiu --force.
    A que de fato importava aqui: vite 8.0.x tinha duas falhas especificas
    de Windows (bypass do server.fs.deny por caminhos alternativos e
    vazamento de hash NTLMv2 via caminho UNC no launch-editor), e o
    npm run dev roda em Windows. Subiu para 8.2.1.
    Build refeito e limpo: 389 kB, 423 ms.
2026-08-14 PI-1 furo por furo em escala real, e a caixa vira 4 modulos
    O pedido era ver o componente em tamanho real com a pinagem. Nao usei
    foto: a placa ilhada e uma grade matematica, entao SVG gerado bate mais
    com a realidade do que uma imagem - cada furo fica clicavel, a cota de
    2,54 mm e exata e o zoom nao borra.
    src/data/pi1_fisico.js guarda o layout em COORDENADAS DE FURO, nao em
    milimetros. Se aqui um resistor ocupa 4 furos, na placa real ele ocupa
    10,16 mm. Da para montar contando furo.
    O que o visualizador mostra:
    - os 696 furos, os 2 bornes com parafuso, o barramento de 0 V
    - os 6 discretos e o ULN2803 no soquete, cada um no seu furo
    - os 20 jumpers do lado da solda, tracejados
    - filtro do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
2026-08-15 Pinagens reais dos modulos, tiradas das fotos do Bruno
    As 4 fotos em imagens/ viraram desenho navegavel. Nao dava para inventar
    a pinagem: agora BTS7960, DNLCB30, LM2596 e o kit Peltier estao
    desenhados com a serigrafia que aparece na foto.
    O zoom de componente ganhou duas abas: a placa como ela e, e so a lista
    de ligacoes. Clicar num pino mostra o papel dele e para onde vai o cabo.
    Deixei explicito no rodape o que e exato e o que nao e: a ordem e o nome
    dos pinos vem da serigrafia (confie para ligar o fio), o contorno da
    placa e estimado (nao use para furar chapa).
    Achados das fotos que valem para o projeto:
    - BTS7960: confirma B+/B-/M+/M- no borne verde e a barra 2x4 com R_PWM,
    L_PWM,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
2026-08-15 Vista ampliada de cada no: responde onde entra cada perna
    O Bruno perguntou o essencial sobre o C1: o fio entra no lado positivo ou
    negativo do capacitor, e qual ponta segue para a saida. A pergunta expos
    duas coisas.
    1. UM ERRO REAL DE LAYOUT. No meu desenho o furo do no A0 receberia TRES
    pernas passantes (fio de entrada + perna do C1 + fio de saida). Furo de
    placa ilhada tem ~1 mm: nao entram tres. Agora cada perna tem seu furo
    e uma ponte de fio nu os une - isso e o que um NO e de verdade. Foram
    declarados 4 nos (A0, A1, 1-Wire, D25) e o layout todo se reorganizou.
    2. O VALIDADOR ESTAVA COM O MODELO FISICO ERRADO. Ele contava jumper como
    se ocupasse o furo. Nao ocupa: o f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
2026-08-15 Vista real do trilho 1, blocos redimensionados e SD para o ESP32
    Tres entregas.
    1. SD DO ARDUINO PARA O ESP32. Eu tinha criado um cabo SPI de ~450 mm ao
    empurrar o SD para o trilho 1. A correcao nao e mover de novo, e trocar
    quem manda no cartao: o ESP32 ja recebe tudo pela Serial1 para o MQTT,
    entao gravar vira escrever o que ele ja ia mandar. E ele esta no 24 V
    permanente, entao continua registrando durante a emergencia. O DS3231
    fica no trilho 1 - I2C tolera distancia, SPI nao.
    2. BLOCOS DE DISTRIBUICAO SUBDIMENSIONADOS. Contei cabo a cabo no Doc 30
    e tres nao fechavam:
    - BD-5V: 7 cargas em 6 saidas (54 e 54b disputavam a saida 6) -> 8
    - BD-24V: 5 cargas em 4 sai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
2026-08-15 Tres cerebros: o ESP32-S3 com tela entra como IHM
    Decisao do Bruno: a tela do S3 fica no painel, o DNLCB30 com o ESP32 de
    IoT continua. Entao nao e substituicao, e um TERCEIRO processador.
    Arduino Mega ---Serial1--> ESP32 (DNLCB30) Wi-Fi, MQTT
    \--Serial2--> ESP32-S3 + tela IHM, log no SD, e no
    futuro a IA da Xiaozhi
    O S3 acumula duas pecas que somem da lista: a tela Nextion e o modulo de
    cartao SD. O slot dele e armazenamento de verdade no SPI do ESP32 - ao
    contrario do Nextion, onde o cartao so grava o firmware da tela.
    Por que tres e nao dois, ja que o ESP32 de IoT existe: redesenhar em LVGL
    trava a tarefa por dezenas d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
2026-08-15 Conversor de nivel entra na lista: o ESP32 nao tolera os 5 V do Mega
    O Bruno ia ligar a tela ao Arduino normalmente. Nao da: GPIO de ESP32
    tem maximo absoluto de 3,6 V e o Mega transmite em 5 V.
    O perigo e que ligar direto PARECE funcionar. Os diodos internos de
    protecao grampeiam a tensao e a comunicacao estabelece, mas passa
    corrente por eles continuamente e o pino degrada em semanas. Quando
    falhar vai parecer defeito de fabrica.
    Quem faz essa adaptacao para o outro ESP32 e a propria DNLCB30 (esta na
    serigrafia da foto: 3.3V to 5V level). O modulo de tela nao tem.
    Entrou na lista: conversor de nivel logico bidirecional de 4 canais.
    Registrei tambem os 3 cuidados de alimentar pelo cabo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
2026-08-15 Tela identificada: e a ESP32-2432S028R (Cheap Yellow Display)
    A foto do verso e a ficha fecharam o modelo. O PDF que o anuncio linka
    nao ajuda em nada - e o Flash Download Tool generico da Espressif, sem
    uma linha sobre a placa. A pinagem veio da comunidade, que para esta
    placa e enorme (e uma das mais documentadas que existem, o que conta a
    favor num projeto escolar).
    Confirmado:
    - microSD existe E esta em barramento SPI SEPARADO do display, entao nao
    ha o conflito de barramento que eu tinha levantado como risco
    - 5 V / 115 mA
    - ILI9341, o driver mais bem suportado por LVGL e TFT_eSPI
    - sobram exatamente 3 GPIOs: 35 (so entrada), 22 e 27
    A serial cabe por um acaso feliz: o GPIO35 e SO E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
2026-08-15 Alimentacao nao e nivel logico: registra a duvida dos 5 V
    O Bruno perguntou se a placa dispensa conversor por ser alimentada com
    5 V. Nao dispensa, e a confusao vale ficar escrita porque e das mais
    comuns: os 5 V entram num regulador na propria placa e viram 3,3 V. O
    chip e os pinos trabalham em 3,3 V.
    Usei uma analogia do proprio projeto: a DNLCB30 recebe 24 V e o ESP32
    dentro dela segue em 3,3 V. Alimentacao e nivel logico sao grandezas
    diferentes.
    Registrei tambem que so UM sentido precisa de conversao (Arduino TX 5 V
    -> CYD RX). O contrario vai direto, porque o Mega le acima de 3,0 V como
    alto.
    E um detalhe que decide a compra a favor do modulo em vez de dois
    resistores: os conversore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
2026-08-15 RX passa para o GPIO27: pull-up interno e tudo num cabo so
    O Bruno notou que o cabo da tela tem 4 fios e perguntou como caberia.
    Notando bem, ele achou um problema real na minha proposta: eu tinha posto
    RX no GPIO35, que fica no P3 - e o P3 nao traz 3,3 V. Precisaria de dois
    cabos.
    O CN1 resolve, porque tem GND, GPIO22, GPIO27 e 3,3 V: exatamente as 4
    coisas de que a tela precisa, num cabo so.
    E a troca traz um ganho de brinde: o GPIO27 TEM pull-up interno, ao
    contrario do GPIO35. Aquele resistor de 10k que eu tinha exigido para a
    linha de RX nao flutuar deixa de existir - resolve com
    pinMode(27, INPUT_PULLUP). Um resistor a menos e um cabo a menos.
    Fica GPIO27 = RX, GPIO22 = TX, e o GPIO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
2026-08-15 Troca a tela pela ES3C28P: e S3, e tem os 8 MB de PSRAM que faltavam
    O anuncio omite a informacao que decide tudo. Ele lista so
    384 KB ROM + 512 KB SRAM + 16 MB Flash - sem PSRAM. Mas a wiki oficial da
    LCDWIKI e o pacote de suporte no GitHub confirmam 8 MB de PSRAM OPI, e o
    proprio anuncio promete suporte ao Xiaozhi, o que so faz sentido por
    causa dela.
    E o que separa esta placa da Cheap Yellow Display, que era a candidata
    anterior: sem PSRAM a Xiaozhi nao roda; com 8 MB, roda. Como a Xiaozhi
    era um dos motivos do Bruno para o terceiro processador, essa e a
    escolha certa.
    Ganhos alem da PSRAM: ESP32-S3, toque capacitivo (sem caneta),
    microfone embutido, alto-falante na caixa, -30 a 80 C, 4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
2026-08-15 Varredura do Nextion: 45 trocas, e duas mudancas fisicas de verdade
    Com o modelo definido, deu para varrer os documentos com os pinos reais
    em maos. Sairam 45 mencoes ao Nextion em 12 documentos.
    Duas nao eram troca de nome, eram mudanca fisica:
    1. O RECORTE DA PORTA muda de tamanho E DE ORIENTACAO. A Nextion 3.2 pol
    era paisagem, 98 x 57 mm. A ES3C28P e RETRATO: modulo de 50 x 86 mm,
    janela do toque 45,2 x 59,45. O recorte vira 47 x 61 mm em pe.
    Registrei o aviso de nao furar a porta antes de a placa chegar - 2 mm
    de erro em recorte retangular nao tem conserto. E ela e mais funda:
    10,6 mm mais o conector JST, entao precisa de 25 mm livres atras.
    2. A LINHA MAIS PERIGOSA es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
2026-08-15 Corrige: o pino de 5 V do conector UART e provavelmente saida
    O Bruno viu num video que a alimentacao e pelo Type-C e desconfiou de
    duas coisas. Estava certo nas duas, e a segunda derruba algo que eu
    afirmei.
    1. TXD e RXD sao 3,3 V. Confirmado por tres fontes: o BSP no GitHub
    mapeia TX=GPIO44 e RX=GPIO43; a ficha declara operacao em 3,0-3,6 V
    para o modulo; e a wiki fala em modulo USB-serial externo, que para
    ESP32 e de 3,3 V. Nenhuma documentacao menciona conversor de nivel a
    bordo. O conversor externo segue obrigatorio.
    2. EU ERREI ao escrever que dava para alimentar pelo conector UART e que
    o cabo Type-C deixava de ser necessario. A wiki oficial lista apenas
    DUAS entra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
    [pinagens.js]
2026-08-15 Documenta por que a DNLCB30 nao serve de conversor para a tela
    Pergunta do Bruno, e boa: ja que a DNLCB30 tem conversor de nivel, por
    que comprar outro? Vale ficar escrito, porque e a primeira coisa que
    alguem revisando o projeto vai perguntar.
    O motivo e a topologia. O conversor dela fica ENTRE o soquete do ESP32 e
    o borne: o lado de 5 V e o borne, acessivel, mas o lado de 3,3 V termina
    no pino do soquete, onde o ESP32 esta encaixado. Nao ha borne para ele.
    Para o sinal chegar na tela, o ESP32 teria que repassar por software -
    que e a arquitetura em cadeia ja descartada.
    Grampear um fio no pino do soquete resolveria no papel, e registrei os
    tres problemas. O terceiro e o que decide: retro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
2026-08-15 Conversor de nivel desenhado e chicote da tela fio a fio
    A foto mostrou o conversor de 2 canais com nomes de UART (TXI/TXO,
    RXI/RXO), 14,7 x 12,7 mm. E o tipo certo para esta ligacao, mas se
    comporta diferente do BSS138 de 4 canais que eu vinha citando: cada
    canal e UNIDIRECIONAL. Isso e bom para serial, onde cada fio tem sentido
    fixo, mas significa que trocar TXI com RXI nao comunica.
    Entrou no painel React:
    - pinagem do conversor, com o papel de cada um dos 8 pinos
    - o conversor desenhado na porta, atras da tela
    - o chicote completo da tela em 3 trechos, com nota em cada fio
    O chicote em 3 trechos nao e organizacao, e decisao de projeto:
    tela --(4 fios curtos, 3,3 V)--> CONVERSOR --(4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
    [pinagens.js]
2026-08-15 Refatora o app: a maquete vista de cima vira a pagina inicial
    O Bruno disse que estava uma bagunca, e estava mesmo: o App.jsx acumulava
    a casca, o mapa React Flow, o painel lateral e o zoom, tudo junto.
    Agora o App e so navegacao, com tres abas que vao do geral ao detalhe:
    1. A maquete de cima - por onde a energia entra e como chega na camara
    2. Dentro do painel - blocos, porta e fios em escala
    3. Mapa de ligacoes - o React Flow, para consultar uma conexao
    O React Flow saiu do App.jsx para MapaComponentes.jsx.
    A pagina inicial e nova (VistaMaquete), baseada em
    desenhos/01_maquete_planta.svg, e conta a historia da energia da
    esquerda para a direita: subestacao, postes, painel,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
2026-08-15 Corrige a maquete: rede aerea com 4 condutores e poste vazado no fim
    Correcoes do Bruno ao desenho anterior. Eu tinha posto o 0 V saindo da
    fonte direto por baixo; esta errado.
    Como fica agora:
    - OS QUATRO CONDUTORES VIAJAM PELO ALTO, simulando a rede de rua: os tres
    positivos em cima e o 0 V um pouco abaixo deles. Cada poste ganhou
    cruzeta.
    - CADA RAMAL DESCE NO SEU POSTE e so entao corre por baixo do tabuleiro
    ate o painel. A faixa do subterraneo agora e das descidas, nao de um
    fio unico atravessando tudo.
    - NOS TRANSFORMADORES ENTRAM DOIS FIOS E SAI UM. Descem os 24 V e o 0 V
    ate o T2 e o T3, e sai so o positivo. Esta e a correcao mais bonita,
    porque foi o Bruno que deduzi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
2026-08-15 Maquete 1500x600, os 3 ramais atravessam tudo, e a chave rotativa sai
    Tres correcoes do Bruno mais uma decisao de projeto.
    1. A TOPOLOGIA ESTAVA ERRADA. Eu fazia cada ramal descer no seu poste.
    O certo: os TRES ramais de 24 V atravessam TODOS os postes e so
    descem no P4, lado a lado, em tres entradas individuais.
    Os transformadores viraram DERIVACOES: no P2 e no P3 desce uma
    derivacao ate o conversor (com o 0 V junto), mas o ramal nao para -
    segue por cima. E como o transformador de poste de verdade, que fica
    pendurado na rede enquanto ela continua passando.
    Consequencia boa: sobra um 24 V de RESERVA chegando no painel. O R1 e
    a potencia, o R3 vira os servicos, e o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
2026-08-15 So dois 24 V entram no painel, e o servico sai do R2
    Correcao do Bruno: eu tinha tres 24 V descendo no P4. Sao dois - o R1,
    que nao entra em transformador nenhum, e o R2, que alimenta o T2 e
    segue. O R3 agora TERMINA no T3, no poste 3.
    Com isso o P4 tem tres entradas lado a lado, como ele descreveu antes:
    24 V de potencia, 24 V de servicos e o 0 V.
    A INTUICAO DELE DE TIRAR O SERVICO DO R2 CONFERE, e por dois motivos:
    1. Folga. O R2 alimenta so o transformador de 5 V, e a eletronica toda
    consome ~75 mA vistos do lado de 24 V. O R3 alimenta as ventoinhas e
    puxa ~265 mA. O R2 e mais de tres vezes mais leve.
    2. Seguranca, que pesa mais. Ventoinha e a peca que mais trava
    mecanicament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
2026-08-15 Corrige a entrada dos fios nos transformadores T2 e T3
    As linhas paravam ANTES da caixa do transformador (terminavam em y=168
    com a caixa comecando em 176) e as saidas comecavam DENTRO dela. Ficava
    parecendo que o fio flutuava ao lado.
    Agora o transformador tem bornes de verdade, definidos em TRAFO:
    - DUAS entradas no topo: 24 V a esquerda, 0 V a direita
    - UMA saida embaixo, no meio: so o positivo
    Isso torna visivel a regra que o Bruno mesmo deduziu: entram dois fios e
    sai um so, porque o 0 V e o mesmo condutor dos dois lados do conversor.
    Antes o desenho dizia isso por escrito; agora a geometria mostra.
    O R3 tambem foi corrigido: ele TERMINA dentro do T3, em vez de parar no
    ar acima dele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
2026-08-15 Inventario completo de terminais do painel, com validador
    O Bruno pediu para primeiro colocar os componentes com TODOS os seus
    terminais, para conferir antes de desenhar. Feito: 22 componentes, 272
    terminais, 160 usados.
    Cada componente traz os bornes que ele tem DE VERDADE, nao so os que o
    projeto usa. O Mega esta com os 80 pinos das quatro barras; a DNLCB30
    com os 28 bornes; os BTS com os 4 parafusos mais a barra 2x4; os reles
    com os 8 terminais da base PTF08A na numeracao IEC (A1, A2, 11, 12, 14,
    21, 22, 24).
    scripts/valida_painel.mjs confere o que importa para a compra:
    - se o bloco citado tem a saida citada (BD-5V saida 8 so existe se ele
    tiver 8)
    - quantos fios chegam ao BD-0V, com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
2026-08-15 Seletora LOCAL/REMOTO definida no firmware, e a PI-1 fica sem reserva
    Os tres pontos que o Bruno respondeu.
    1. PI-1 SEM RESERVA, por decisao dele: e placa feita a mao para este
    projeto, entao se um dia precisar de outro sinal ela e refeita de
    qualquer jeito. Borne sobrando so ocuparia trilho. Registrei o
    motivo no inventario para nao parecer descuido.
    2. SELETORA CONFIRMADA NO FIRMWARE. E aqui achei um buraco: o Doc 41 ja
    usava CHAVE_LOCAL_REMOTO no codigo, mas o pino nunca tinha sido
    definido em lugar nenhum. Agora e o D26, que o Doc 32 listava como
    livre desde que o rele K0 saiu.
    E corrigi a logica, que estava perigosa. O Doc 41 dizia
    HIGH = REMOTO. Com INPUT_PUL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
    [painel_completo.js]
2026-08-16 Painel interno novo: vista de frente com os terminais nas bordas
    Sai o VistaTrilho1 e o trilho1.js; entra o VistaPainelInterno, montado
    sobre o inventario que o Bruno acabou de validar.
    Cada terminal e um quadrado com o ID dentro, colocado na BORDA onde ele
    fica de verdade no componente. Marquei o lado de cada um dos 37 grupos:
    - Mega: PWM e digitais em cima (a fileira dupla em 2 linhas, como na
    placa real), alimentacao e analogicas embaixo
    - BTS7960: borne verde de potencia a esquerda, barra 2x4 a direita
    - DNLCB30: GPIOs nas duas laterais, alimentacao embaixo
    - blocos de distribuicao: entrada em cima, saidas embaixo
    - PI-1: J1 em cima (entradas), J2 embaixo (saidas)
    Amarelo = terminal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
2026-08-16 Canaletas com segregacao potencia x sinal, e as correcoes do Bruno
    - SAI o cooler dos BTS. Eles ja vem com dissipador grande.
    - S4 vira S3. A numeracao pulava de S2 para S4.
    - O Mega vira ADAPTADOR DE BORNES: bornes de parafuso nas tres bordas,
    com o Mega encaixado no meio. Placa maior, 120 x 72 mm.
    - BD-AUX passa a alimentar as ventoinhas do radiador e do duto, ja que
    o cooler dos BTS deixou de existir.
    - Terminais de 3,0 para 4,0 mm e passo de 3,6 para 4,6, para o ID caber.
    - Zoom pelo scroll do mouse, ate 10x, mantendo sob o cursor o que
    estava sob ele.
    CANALETAS: entram 4 horizontais (topo, entre os trilhos 3-2 e 2-1, e a
    inferior) e 2 verticais nas bordas. Cada uma tem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
2026-08-16 Ventoinhas passam a ser controladas em 3 grupos, e o Mega e o real
    A foto boa do adaptador resolveu a pinagem: 82 bornes, 35 em cima, 13 na
    borda esquerda (D31-D43) e 34 embaixo. O D21/SCL e o D20/SDA aparecem
    duas vezes na borda de cima - e o mesmo pino espelhado, como no Mega.
    Substitui a suposicao pelo que esta na serigrafia.
    E o pedido das ventoinhas mudou o projeto. Elas eram sempre ligadas;
    agora sao TRES grupos com condicoes diferentes:
    RADIADOR liga resfriando desliga com pos-ventilacao
    PTC liga aquecendo desliga com pos-ventilacao
    CIRCULACAO liga em qualquer ensaio desliga na hora
    Por que o radiador fica desligado ao aquecer: com a Peltier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
    [painel_completo.js]
2026-08-16 Painel cresce para 500 mm: nao cabia mais. E a DNLCB30 tem 62 bornes
    O Bruno estava certo sobre a DNLCB30: eu contei 28 bornes e sao 62. Cada
    lado tem DUAS colunas - a externa entrega 5 V e a interna e o GPIO. E o
    que a serigrafia chama de "5V IO Level Converter": cada sinal ja sai com
    alimentacao ao lado. Corrigido para 14 pares por lado mais os 2 de
    alimentacao.
    ACHADO QUE MUDA A COMPRA: o painel de 400 mm nao cabe mais. Com o MV-1,
    a PI-2 e os porta-fusiveis, o trilho mais cheio passou a precisar de
    356 mm - e num painel de 400, descontadas as canaletas verticais e as
    margens, sobram 312 mm de trilho util. Passou a caixa para 500 x 500,
    que da 420 mm uteis e deixa 64 mm de folga no pior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
    [painel_completo.js]
2026-08-16 Mega em fileira unica, como o adaptador real, e sai o slider de afastar
    Duas correcoes do Bruno.
    1. OS BORNES DO MEGA ESTAVAM EM FILEIRA DUPLA. No adaptador real eles
    ficam um ao lado do outro, em fileira unica. Corrigido - e isso
    obrigou a placa a crescer de 120x72 para 134x96 mm, porque 35 bornes
    lado a lado precisam de comprimento.
    Com 3,74 mm por borne, o ID nao cabe deitado dentro do quadrado.
    Entao a etiqueta passou a ser IMPRESSA EM PE, para dentro da placa -
    que e exatamente como borne de verdade e identificado. Os grupos
    folgados continuam com o ID dentro do quadrado.
    2. O SLIDER "AFASTAR" SAIU. No lugar entraram folgas REAIS de 5 mm entre
    componentes, que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
    [painel_completo.js]
2026-08-16 Conversor ampliado no desenho e checagem de rotulo no validador
    O validador novo pegou um caso que eu teria deixado passar: o conversor
    de nivel tinha 26 x 16 mm no desenho, e com 6 bornes por lado o passo
    caia abaixo de 4,2 mm. Isso dispara a etiqueta em pe, que desce ~9 mm
    para dentro - de cima e de baixo, num corpo de 16 mm, as duas se
    encontrariam no meio.
    Ampliado para 34 x 22 mm, o passo volta a 4,6 e o ID cabe deitado dentro
    do quadrado. (Ele ja estava marcado como fora de escala: a placa real
    tem 14,7 x 12,7 mm.)
    A checagem de rotulo entrou no valida_painel: reprova passo abaixo de
    2,7 mm e etiqueta em pe que nao caiba na altura da placa.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
2026-08-16 Terminais viram retangulo, e o MOSFET achado e de 1 canal (viram 3)
    O modulo que o Bruno achou tem UM canal, nao quatro. Entao o MV-1 virou
    tres modulos: MV-1 radiador, MV-2 PTC e MV-3 circulacao, comandados por
    D27, D28 e D29.
    Escolha do transistor, entre as tres opcoes da loja: AOD4184. O LR7843
    tem 161 A mas so 30 V, e 30 V e perto demais dos 24 V do painel - quando
    a ventoinha desliga, o enrolamento devolve um pico acima da tensao de
    alimentacao e come essa margem. Escolher pela corrente e esquecer a
    tensao e erro classico. O AOD4184 da 40 V com 5,5 mohm.
    O optoacoplador rendeu uma observacao que vale para a defesa: como o
    projeto tem um unico 0 V, a isolacao galvanica acaba desfeita n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
2026-08-16 Modulo MOSFET de 4 canais no lugar dos tres de 1 canal
    E de 4 canais mesmo, e resolve melhor: 66 mm de trilho em vez de 114, um
    par VIN/GND em vez de tres, 2 retornos no BD-0V em vez de 6, e ainda
    sobra um canal com borne e jumper proprios.
    Com isso a barra do BD-0V volta de 24 para 20 pontos, com 17 em uso.
    REVISAO DO QUE EU TINHA DITO SOBRE O LR7843: eu havia desaconselhado
    por causa dos 30 V. Continua valendo o raciocinio, mas nao se aplica
    aqui - todas as ventoinhas do projeto sao de 12 V, e nessa tensao o
    LR7843 tem margem de sobra. A condicao ficou registrada: os 4 canais
    dividem o MESMO VIN, entao se um dia o radiador virar 24 V ele nao pode
    compartilhar este modulo.
    Detalhe que a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
    [painel_completo.js]
2026-08-16 DNLCB30: so os bornes de parafuso, o soquete do ESP32 sai do desenho
    O soquete de 30 pinos onde o ESP32 encaixa nao tem borne nenhum - ele
    fica no meio da placa, coberto pelo proprio ESP32. Nao ha o que ligar
    ali, entao sumiu do desenho. Ficaram os 58 bornes de parafuso: 28 em
    cada lado mais os 2 de alimentacao.
    O diagrama legivel confirmou a estrutura de PAR: a coluna de fora
    entrega 5 V e a de dentro e o sinal, ja convertido dos 3,3 V do ESP32. E
    o que a serigrafia chama de "5V IO Level Converter". Sensor de 5 V liga
    direto, sem regua extra.
    Notas do fabricante que entraram no inventario:
    - os pinos 2 e 12 NAO sao trazidos para borne
    - GPI3(RX0), 34, 35, 36(VP) e 39(VN) sao so entrada
    -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
2026-08-16 O esquematico da DNLCB30 resolve as duas duvidas dos bornes
    O Bruno mandou o esquematico e ele fecha o que as fotos deixavam em
    aberto.
    1. NO H1 (esquerda) o segundo borne e D4, nao D14. O esquematico mostra
    D4_O. O diagrama de fiacao do vendedor tinha erro de digitacao - e
    por isso o GPIO14 aparecia nos dois lados.
    2. O H2 (direita) tem D12 E D14, os dois. O diagrama simplesmente
    esqueceu de listar o D12, que no esquematico esta como D12_O. Por
    isso a direita tem 15 linhas e a esquerda 14.
    3. Isso derruba a nota 1 do proprio fabricante, que diz "2/12PIN didn't
    lead out". O D12 esta no borne e esta no esquematico. Quem nao sai e
    so o D2. Ficou registrado para conferir co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
    [painel_completo.js]
2026-08-16 Corrige as duas colunas de borne: o par estava sendo partido no meio
    O que o Bruno viu como "terminais duplicados" era um bug meu de
    distribuicao, nao dado errado.
    Os dados vem INTERCALADOS, porque e assim que o borne e na placa: um par
    5V+sinal por linha. Mas eu distribuia dividindo a lista ao meio - os 14
    primeiros pinos numa coluna e os 14 ultimos na outra. Resultado: sete
    pares inteiros iam para a coluna de fora e sete para a de dentro,
    misturando 5V com sinal nas duas.
    Agora a coluna avanca a cada `linhas` pinos, e nao na metade da lista:
    ESP32.H1 externa: 5V x14 interna: GPIO15, GPIO4, GPIO16...
    ESP32.H2 externa: 5V x15 interna: GND, GPIO13, GPIO12...
    BTS1.J1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
2026-08-16 DNLCB30 pela serigrafia: 15 bornes por bloco, fileira unica
    Eu tinha desenhado duas colunas - 5 V do lado de fora e sinal do lado de
    dentro. Errado. As fotos da borda externa que o Bruno mandou mostram uma
    FILEIRA UNICA de 15 bornes por bloco, e o "5V" e simplesmente o primeiro
    deles.
    O que eu li como segunda coluna nas fotos anteriores era o furo de
    entrada do fio, que fica ao lado do parafuso em qualquer borne desse
    tipo.
    Os nomes agora sao exatamente os impressos na placa:
    H1 5V D15 D4 D16 D17 D5 D18 GND D19 D21 RX0 TX0 D22 D23 GND
    H2 5V GND D13 D14 D27 D26 D25 GND D33 D32 D35 D34 VN VP GND
    E isso resolve a duvida do D12 no sentido contrario do que eu tinha
    concluido: NAO existe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
    [painel_completo.js]
2026-08-16 Resumo do projeto para submeter ao blueprint.io
    Pesquisei o site antes de escrever. Sao DOIS produtos com esse nome: um
    construtor de sites para SEO e um de hardware. O relevante e o de
    hardware - ele transforma texto em diagrama de ligacoes, BOM com links,
    3D estrutural e guia de montagem, e suporta Arduino Mega e ESP32.
    Duas limitacoes que um review pratico apontou: NAO gera firmware, e o 3D
    sai como esboco em arame.
    Escrevi o resumo, mas com uma ressalva honesta no topo: o ponto forte
    dessa ferramenta e o COMECO de um projeto, e este esta no fim. BOM e
    diagrama de ligacoes, que e o que ela faz de melhor, nos ja temos com
    mais detalhe - conferidos contra fotos, esquematicos e medidas.
    E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
2026-08-16 Reforca no resumo que os DUTs sao 24 V CC, nao 127 V
    O Blueprint colou a Parte 1 e perguntou como comutar 127 V AC para os 4
    dispositivos sob ensaio. Premissa errada: eles sao alimentados com 24 V
    continuos, ~130 mA cada, com fusivel individual de 500 mA. O unico ponto
    com 127 V no projeto e a entrada da fonte.
    Eu tinha escrito que tudo depois da fonte e tensao segura ao toque, mas
    nao explicitei a tensao dos dispositivos - deu margem. Corrigido nas duas
    versoes, portuguesa e inglesa.
    Acrescentei tambem um item na secao de como avaliar a resposta: conferir
    se ele leu a tensao certa. Vale ler as PERGUNTAS dele com o mesmo cuidado
    com que se le a resposta.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
2026-08-16 Posicoes de ensaio: de 4 para 2
    Decisao do Bruno. Varri o projeto inteiro - 24 substituicoes em 7
    documentos, mais o inventario do painel.
    O que muda:
    - 2 INA219 em vez de 4, nos enderecos 0x40 e 0x41. O 0x44 e o 0x45 ficam
    livres, entao voltar a 4 depois e so acrescentar modulos.
    - PI-2 encolhe de caixa DIN de 4 modulos (70 mm) para 2 modulos (35 mm)
    - 1 porta-fusivel de 2 vias com interruptor, em vez de 2
    - carga termica dentro da camara cai de ~12 W para ~6 W, e o total do
    Doc 12 de ~21,5 para ~15,5 W
    - o scanner I2C passa a esperar 4 enderecos, nao 6
    - so 3 fios entram na camara: 2 positivos e um retorno comum
    RESPONDENDO A DUVIDA DELE: nao, o INA219 nao pode ser um so. Cada modulo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
2026-08-16 Doc 13 ganha a secao da escala: como isso vira 50 canais na empresa
    Pergunta do Bruno, e das melhores: o prototipo tem 2 INA219, mas a
    empresa tem 50 placas. Ninguem poe 50 modulos num painel. E agora?
    Primeiro, um acerto meu: o INA219 tem 16 enderecos, nao 4. Os modulos
    prontos trazem dois jumpers de solda, que dao 4 combinacoes - dai a
    confusao. Mas o CHIP tem dois pinos de endereco e cada um aceita quatro
    ligacoes (GND, V+, SDA, SCL): 4 x 4 = 16, de 0x40 a 0x4F. Corrigido no
    Doc 13, que dizia "exatamente 4".
    Mas o ponto central e outro: o problema nao e o endereco, e o modulo.
    Pensar em um modulo por canal e pensar como maker. A industria separa
    duas coisas que o modulo pronto junta - o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
2026-08-16 Completa a 13.9: o que entra no prototipo e como o CLP realmente entra
    Duas perguntas do Bruno.
    O QUE ENTRA NAS DUAS POSICOES: as placas simuladoras de DUT do 13.3 -
    LED mais resistor de potencia. Mas sugeri monta-las DIFERENTES, 220 e
    330 ohm, dando 127 e 92 mA. Com correntes diferentes fica provado que o
    sistema nao usa limiar unico: cada posicao aprende a corrente normal
    dela e compara consigo mesma. E o que acontece na empresa, onde as 50
    placas nunca sao identicas - e com duas placas iguais essa qualidade do
    projeto fica invisivel.
    O CLP COM 50 ENTRADAS: nao, e a resposta muda de forma. A unidade de
    escala nao e o sensor, e o SUPORTE INSTRUMENTADO - a burn-in board onde
    os dispositivo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
2026-08-16 Doc 14: do prototipo as 50 posicoes, e sem trocar de plataforma
    A informacao de que a FABRICA JA USA ARDUINO como padrao muda a resposta,
    e para melhor. Propor CLP significaria trocar de plataforma, de
    ferramenta de programacao e de peca de reposicao, e treinar de novo quem
    faz manutencao - o ganho tecnico nao paga esse custo. Ajustei o Doc 13,
    que recomendava CLP, e criei o Doc 14 com a engenharia completa.
    A SOLUCAO PARA 50 CANAIS: multiplexador CD74HC4067, 16 canais, ~R$ 6.
    Quatro deles com os pinos de selecao compartilhados dao 64 canais usando
    8 pinos do Mega - 4 digitais e 4 analogicos.
    O truque que simplifica: SHUNT GRANDE. Medidor de precisao usa 0,1 ohm
    para nao atrapalhar a carga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
2026-08-16 A bancada passa a usar o MULTIPLEXADOR, com um INA219 de referencia
    Argumento do Bruno, e ele esta certo: o desafio e apresentar a solucao
    para a EMPRESA, e ela nao vai comprar 50 INA219. Validar uma arquitetura
    na bancada e entregar outra na fabrica nao prova nada sobre o que sera
    implantado.
    Um prototipo existe para tirar risco do que vem depois. O risco nao esta
    em saber se o INA219 funciona - esta em saber se o MULTIPLEXADOR da
    conta: leitura estavel, tempo de acomodacao, ruido do painel. So se
    descobre montando.
    A PI-2 virou a placa do multiplexador:
    - 1 CD74HC4067, 16 canais
    - shunt de 4,7 ohm por canal, 2 em uso e 14 livres
    - 5 pinos do Mega: D31-D34 para selecionar o canal e A2 par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
2026-08-16 Mux em placa com pinos, e o pino EN que faltava
    O Bruno achou o CD74HC4067 nas duas formas e preferiu a placa com pinos.
    E a escolha certa, e por um motivo que o preco esconde: o CI avulso sai
    R$ 15,62 por UM, e a placa sai R$ 16,97 por CINCO - R$ 3,40 cada, 4,6
    vezes mais barata por unidade. E ja vem com capacitor de desacoplamento,
    barra de pinos e furos de fixacao, que no CI avulso teriam que ser
    soldados numa placa ilhada.
    Vir em pacote de 5 ainda calha: um para montar, um de reserva, e se a
    empresa escalar para 64 canais sao exatamente 4 modulos.
    ACHADO NA MONTAGEM: faltava o pino EN no inventario. O multiplexador so
    conduz com o EN em nivel baixo. A maioria das placas ja traz resisto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
    [painel_completo.js]
2026-08-16 PI-2 refeita: os bornes sao os FIOS, e o que chega e o RETORNO
    O Bruno achou dois erros meus, e o segundo e de circuito.
    1. EU TINHA POSTO OS PINOS DO CI COMO BORNES DA PLACA. O CD74HC4067 vai
    soldado dentro, entao S0-S3 e SIG so viram borne porque vao para o
    Arduino; o EN nao vira, porque e ligacao interna e permanente. Criei
    um campo `interno` que lista o que fica soldado sem borne, e a vista
    mostra isso em destaque.
    2. A PERGUNTA DELE - "o IN1 e IN2 vem dos fusiveis? antes de passar pelo
    fusivel?" - expos um erro de verdade. Nao vem dos fusiveis coisa
    nenhuma: como o shunt e de BAIXO, o que chega na placa e o RETORNO
    que volta da camara, depois de passar pelo dispos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
2026-08-16 Doc 14 responde: sim, sao 50 retornos - mas viram trilha, nao fio
    Pergunta do Bruno depois de entender a medicao de baixo: com 50
    dispositivos seriam 50 fios de retorno na placa?
    Sim, e vale dizer que sim sem rodeio: medicao individual exige retorno
    individual. Se as voltas se juntam, as correntes se somam e a medicao
    perde o sentido. Nao tem como fugir disso.
    Mas a pergunta certa nao e como evitar os 50 retornos, e ONDE eles
    ficam. O erro seria traze-los ate o painel: 100 fios de 20 m
    atravessando a fabrica, com sinal de milivolts ao lado de motores.
    O certo e a medicao ir ate os dispositivos. Numa placa de suporte eles
    encaixam em SOQUETES, e o retorno de cada um vira uma TRILHA DE COBR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
2026-08-16 Doc 14 ganha a secao 14.0: separa o desenho do prototipo do da fabrica
    O Bruno ficou confuso e a culpa e do documento: eu desenhei a
    arquitetura da FABRICA - 16 soquetes, trilhas, suporte instrumentado - e
    ele tentou encaixar aquilo na bancada dele, onde nada disso existe.
    A 14.0 agora abre o documento separando os dois desenhos numa tabela, e
    avisa em destaque que os soquetes e as trilhas sao da fabrica. O desenho
    do suporte ganhou o mesmo aviso em cima.
    Respondi tambem as perguntas basicas que ficaram para tras, porque eu
    vinha usando os termos sem definir:
    - O QUE E DUT: dispositivo sob ensaio. Na empresa e uma placa de
    verdade; na bancada e a placa simuladora, que so precisa consumi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
2026-08-16 Refatora para arquitetura distribuida: RS-485 e modulos de ensaio
    Decisao do Bruno: parar de tratar como bancada e entregar a solucao que
    a empresa quer, com ate 50 dispositivos. Ele apontou o caminho certo -
    RS-485 ou outro protocolo de barramento.
    A INVERSAO QUE RESOLVE: em vez de trazer 50 sinais ate o cerebro, levar
    pequenos cerebros ate os 50 sinais.
    Quatro modulos MPE ficam junto da camara. Cada um cuida de 16 posicoes:
    distribui os 24 V, protege com polyfuse, mede a corrente com shunt e
    mux, compara com a referencia aprendida e decide sozinho quem falhou. Ao
    painel, todos mandam a resposta pelos MESMOS dois fios.
    Do painel saem QUATRO FIOS para o sistema inteiro - 24 V, 0 V, A e B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
    [painel_completo.js]
2026-08-16 MB-1 detalhado por dentro, e o que sai do painel
    Tres coisas que o Bruno pediu.
    O MB-1 POR DENTRO: nao e so o MAX485. Sao quatro componentes, e dois
    deles sao os que costumam faltar - os resistores de POLARIZACAO DE
    REPOUSO, 680 ohm de A para +5 V e 680 ohm de B para 0 V.
    Sem eles, quando nenhum no esta transmitindo o par A/B fica flutuando, e
    receptor com entrada flutuante nao le silencio: le LIXO. O painel acha
    que esta recebendo mensagem quando nao esta. E a causa numero um de
    barramento que funciona na bancada e enlouquece na instalacao - na
    bancada ha sempre alguem falando, na instalacao existem silencios. A
    maioria dos modulos MAX485 baratos nao traz esses resistores.
    CORRECAO DE LE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
2026-08-16 Volta ao mux direto, e o Doc 14 responde a conta dos cabos
    O Bruno escolheu a opcao A depois de eu reconhecer que superprojetei. Com
    o painel a poucos metros da camara, o RS-485 resolvia um problema que
    nao existe: eu tinha vendido "100 fios contra 4" quando na verdade e 9
    contra 4, porque o multiplexador ja resolve a multiplicacao ANTES do
    cabo.
    Revertido: sai o MB-1, voltam a PI-2 com o CD74HC4067 e o porta-fusivel
    de 2 vias. O Mega volta a ler por D31-D34 e A2; liberados D14, D15 e D30.
    O Doc 14 foi reescrito para responder a duvida real dele, que era a
    quantidade de cabos:
    - QUANTOS MUX: 4 para 50 posicoes (64 canais, 14 livres). As sobras nao
    sao desperdicio, sao projeto - crescer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
    [painel_completo.js]
2026-08-16 Nova aba no React: o circuito completo da deteccao de falha
    O Bruno perguntou o que sao os 4 fios que saem do painel e pediu para
    montar o esquema no React. Feito - aba "Deteccao de falha".
    O desenho mostra a volta inteira da corrente, do BD-24V ate o Arduino:
    barramento, porta-fusivel com as duas chaves, os 4 fios atravessando a
    parede da camara, os DUTs desenhados por dentro (LED com resistor de
    1,2 k e resistor de potencia), os retornos voltando, os dois shunts, o
    multiplexador e a leitura chegando no A2. Tem um botao que isola a
    corrente da posicao 1 para acompanhar o caminho todo, e bolinhas
    animadas mostrando o sentido em cada fio.
    Duas coisas que o desenho corrige na cabeca de quem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
2026-08-16 Doc 13 explica por que o DUT e de 24 V e nao de 5
    Pergunta do Bruno: se e so acender um LED, por que nao alimentar com os
    5 V do barramento? A resposta expoe uma coisa que o desenho esconde - o
    LED nao e a carga.
    O LED gasta 18 mA e serve so para mostrar que a posicao esta viva. Quem
    trabalha e o resistor de potencia, que precisa dissipar ~2,6 W para
    simular o calor de uma placa real. Ensaio termico com camara vazia nao
    representa nada: numa cabine de verdade as proprias placas aquecem, e
    esse calor muda o comportamento do controle.
    E ai a conta decide. Para os mesmos 2,6 W:
    24 V -> 109 mA
    5 V -> 524 mA
    Mesma potencia, quase cinco vezes menos corrente, porque P = V x I.
    O que MATA a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
2026-08-16 DUT vira so LED e resistor - e o shunt sobe de 4,7 para 47 ohm
    Decisao do Bruno: nao queremos simular carga termica, queremos provar a
    deteccao de qual componente parou. Entao o simulador e so um LED em
    serie com um resistor.
    posicao 1: LED vermelho + 1,2 kohm -> 17,6 mA
    posicao 2: LED verde + 2,2 kohm -> 9,8 mA
    As duas correntes sao propositalmente diferentes: com valores distintos
    fica provado que o sistema compara cada posicao com o normal DELA e nao
    com um limiar unico. Numa fabrica as 50 placas nunca consomem igual.
    A consequencia que a decisao arrasta: o shunt. Com a corrente caindo de
    127 para 17,6 mA, os 4,7 ohm entregariam 83 mV - 17 contagens do ADC,
    perto demais do ruid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
2026-08-16 Nova aba: dentro da camara, com validador cruzando com o painel
    Corte frontal da camara mostrando onde cada componente fica e por que
    fica ali. Peltier dupla na tampa (o ar frio desce sozinho), PTC na base
    sobre o plenum (o ar quente sobe sozinho), sensor AM2315C no centro
    geometrico, e as duas posicoes de ensaio na base, uma de cada lado.
    Setas animadas do ar, com botao para alternar entre ciclo de frio e
    ciclo de calor - as duas circulacoes correm em sentidos opostos.
    Clicando num componente sai onde ele fica, por que ali, e de qual borne
    do painel vem cada fio dele.
    O validador novo (npm run valida:camara) e o que faz isso valer alguma
    coisa. Ele confere quatro coisas:
    1. Todo fio qu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
2026-08-16 Corrige o circuito de ar e separa a travessia em dois prensa-cabos
    Duas observacoes do Bruno, e a primeira era erro de projeto, nao de
    desenho.
    1. O AR NAO PODE INVERTER
    O doc 12 dizia que o ar mudava de sentido entre resfriar e aquecer:
    centro para baixo no frio, centro para cima no quente. Isso nao e
    executavel. Ventoinha DC nao gira ao contrario - invertendo a polaridade
    ela nao parte, porque a eletronica interna de comutacao nao trabalha em
    reverso, e mesmo que partisse a pa e assimetrica e moveria quase nada de
    ar para tras. Pior: as 2 ventoinhas do duto dividem um canal so (MV-1
    O3), entao nao existe nem comando para tentar.
    O circuito de ar agora e unico e fixo: desce pelo centro,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
2026-08-16 Sai a aba mapa, entra o desenho da PI-2 furo por furo
    A aba "Mapa de ligacoes" foi removida. Ela levava junto o desenho fisico
    da PI-1, que estava enterrado tres cliques fundo - agora ele sai direto
    do painel.
    Na aba "Dentro do painel", clicando num componente que tem placa aparece
    um botao:
    PI-1 e PI-2 -> "Ver a placa e como soldar" (o desenho furo por furo)
    BTS, ESP32, tela, conversor -> "Ver o modulo e a pinagem real"
    A PI-2 nao tinha desenho fisico nenhum. Criei pi2_fisico.js com o layout
    completo: 24 x 29 furos, 3 bornes (J1 retornos em cima, J2 e J3 dividindo
    a borda de baixo), barramento de 0 V na linha 11, os 2 shunts de 47 ohm
    em pe entre os nos e o barramento, e os 18 jumper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
2026-08-16 Separa os dois lados da placa e registra o corte da placa de 7x9 cm
    O desenho da PI-1 estava confuso porque misturava num quadro so os
    componentes, que ficam em cima, e os 20 jumpers, que ficam embaixo. Vinte
    curvas tracejadas cruzando o meio da placa.
    Agora sao dois desenhos separados:
    LADO DOS COMPONENTES (cima) - bornes, resistores, capacitores, CI ou
    modulos. Sem nenhum fio.
    LADO DA SOLDA (baixo) - barramento de 0 V, pontes de no e todos os
    fios. ESPELHADO.
    O espelhamento e a parte que importa. E assim que voce ve a placa ao
    virar na mao: a coluna 1, que estava a esquerda, passa para a direita.
    Desenho nao espelhado obriga a fazer essa inversao de cabeca a cada fio,
    e e a caus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
2026-08-16 Gera a lista de bornes por script - a escrita a mao ja estava errada
    Pergunta do Bruno sobre qual borne comprar para a placa de 2,54 mm.
    Resposta: KF301 (KRE no Brasil) de passo 5,08 mm, que e exatamente 2
    furos.
    A armadilha e que existe o de 5,00 mm vendido lado a lado, com aparencia
    identica. A diferenca de 0,08 mm por via some no primeiro pino, mas
    acumula: num bloco de 11 vias o ultimo pino sai 0,8 mm fora do furo -
    quase o diametro do furo inteiro. Ou nao entra, ou entra torto.
    Os passos que alinham com 2,54 sao 2,54 (1 furo), 5,08 (2) e 7,62 (3).
    Os de 3,5 e 3,81 nao alinham com nada.
    Outra coisa que nao estava documentada: os KF301 tem rabo de andorinha
    e encaixam lado a lado. Nao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
2026-08-16 Placas de 9x15, roteador em angulo reto e o furo que saia da placa
    Quatro coisas.
    1. O FURO QUE FICAVA PARA FORA
    Bug meu: o retangulo da placa comecava em x=0 e os furos em x=1*PASSO.
    A ultima coluna caia exatamente na borda direita, meio furo para fora,
    enquanto a esquerda tinha 2,54 mm de margem. Agora o retangulo comeca em
    meio passo, e sobra 1,27 mm dos dois lados.
    2. AS PLACAS EM 9 x 15
    De 24 x 29 para 34 x 29 furos - 86,4 x 73,7 mm, mais 42% de area. A
    altura NAO muda, e isso e o ponto: a caixa DIN limita a altura em ~74 mm
    seja ela de 4, 6 ou 12 modulos, porque a altura e padronizada pelo
    trilho. A placa cresce em largura, nunca em altura.
    E uma placa comprada rende AS DUAS: um c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
    [painel_completo.js]
2026-08-16 Siga o sinal: le a placa como rede eletrica, nao como geometria
    O Bruno continua sem conseguir ler o lado de baixo, e ele tem razao -
    por mais que eu melhore o desenho, uma foto de fios nunca vai responder
    "de onde vem e para onde vai este sinal". Ele pediu isso explicitamente:
    entra em J1-2 IS2, passa pelo componente, sai em tal lugar.
    Entao parei de tentar desenhar melhor e escrevi src/lib/rede.js, que le
    o layout como o que ele e eletricamente: uma uniao-busca sobre os furos.
    A distincao que o desenho escondia e que a rede expoe:
    um FIO funde dois pontos num so
    um COMPONENTE separa dois pontos
    Clicando em J1-2 sai isto:
    [ no A1 ] J1-2 = J2-2 = perna do C2 unidos por fio 3, f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
2026-08-16 Endereco de planilha nos furos e inspetor de celula
    A ideia foi do Bruno e e a certa: cada furo com nome unico, coluna em
    letra e fileira em numero, passando de Z para AA como no Excel. O furo
    da coluna 11 fileira 6 e a celula K6.
    O motivo de isso resolver: "furo 11,6" e "furo 6,11" se trocam sozinhos
    na cabeca de quem esta com o ferro na mao - qual dos dois era a coluna?
    K6 nao tem como inverter. E o endereco e do FURO, nao da vista: K6 e o
    mesmo furo pelos dois lados, so as letras e que correm ao contrario no
    lado da solda.
    Cabecalho de letras em cima e de numeros nos dois lados, com a marca de
    5 em 5 para contar rapido. Clicando numa letra acende a coluna inteira,
    num numero acende a fi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
2026-08-16 Corrige o clique na fileira: o realce saia por baixo da placa
    O Bruno relatou que clicar na linha nao mostrava nada, so no furo. O
    clique funcionava e a lista era montada certa - o problema era que o
    retangulo de realce da fileira estava desenhado ANTES do corpo da placa
    no SVG, entao ficava escondido atras dele. Sem realce nenhum, o clique
    parecia nao ter acontecido, e a lista na lateral passava despercebida.
    Agora o realce vai por cima, com contorno, e com pointerEvents desligado
    para nao roubar o clique dos furos.
    Junto, tornei o cabecalho mais facil de acertar: as celulas de letra
    subiram de 4,4 para 6,0 e as de numero de 4,4 para 5,8 unidades, com cor
    azulada nas marcas de 5 em 5. Os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
2026-08-16 Camara em 3D giravel e letras AA empilhadas no cabecalho
    Duas coisas.
    1. AS LETRAS QUE DOBRAM
    De AA em diante as duas letras lado a lado estouravam os 2,54 mm da
    coluna e invadiam a vizinha. Agora saem empilhadas, uma sobre a outra,
    dentro da propria celula do cabecalho.
    2. A CAMARA EM 3D
    A aba da camara ganhou um seletor: "3D giravel" (padrao) e "corte com
    medidas" (a vista antiga, que continua sendo a que tem as camadas de
    parede e o balanco termico).
    O 3D e projecao ortografica escrita a mao, sem biblioteca. Para uma
    caixa com caixinhas dentro e suficiente, e ortografica e melhor que
    perspectiva num desenho tecnico - as medidas nao encolhem com a
    distancia. Arrasta com o mouse para g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
2026-08-16 A antena entra no modelo e a porta ganha canaletas
    Conferindo o que estava faltando, achei duas coisas.
    1. A ANTENA NAO ESTAVA NO MODELO
    Ela esta documentada desde o doc 20 - lateral direita, X=100 da
    traseira, Y=430 de altura, conector SMA de painel furo 6,5 mm, pigtail
    IPEX de 30 cm - mas nao existia em painel_completo.js, entao nao
    aparecia em lugar nenhum do React.
    Criei a lista LATERAIS, porque nem tudo mora na placa de montagem ou na
    porta, e uma faixa "LATERAL DIREITA" no desenho, com a antena
    articulada, o furo cotado e o pigtail descendo ate o DNLCB30.
    O motivo, que o Bruno lembrou: a caixa e uma gaiola de Faraday. Com a
    antena dentro dela o alcance despenca e o MQTT cai sozinho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
2026-08-16 Fiacao etapa 1: as entradas, e o 0 V que estava contado quatro vezes
    Comecando a fiacao pelas entradas, como o Bruno pediu. Antes de desenhar
    qualquer coisa achei uma contradicao no doc 30.
    A tabela de entradas listava OITO condutores: 24 V de potencia, 5 V,
    12 V, 24 V de servicos e um RETORNO para cada um. Isso contradiz o que a
    maquete faz - "do transformador sai SO O POSITIVO" - e contradiz a
    propria arquitetura de terra do projeto.
    Os LM2596 dos postes nao sao isolados. O negativo deles e fisicamente o
    mesmo cobre. Puxar quatro retornos nao daria quatro circuitos: daria
    quatro caminhos para a mesma corrente, formando malhas de terra. E o
    BD-0V tem UMA entrada de 10 mm2 declarada, o que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
2026-08-16 Fiacao etapa 2: o comando, e dois erros graves que ele escondia
    Antes de tracar qualquer fio, auditei o circuito de comando contra os
    docs 31 e 40. Achei duas contradicoes serias no inventario.
    1. S2 E S3 ESTAVAM TROCADOS
    Os docs 31 e 40 dizem S2 = STOP e S3 = REARME. O painel_completo.js
    dizia S2 = REARME (azul) e S3 = STOP (preto). Quem seguisse o inventario
    na hora da montagem ligaria o rearme no lugar da parada.
    2. O STOP NAO TINHA CONTATO DE HARDWARE
    Pior que o primeiro. O doc 31 afirma que o STOP corta a bobina do KA2
    "sem passar por semicondutor nenhum". Mas no inventario o S3 (o STOP de
    la) tinha SO o bloco de 5 V indo ao D23 - ou seja, montado como estava
    declarado, o STOP seria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
2026-08-16 Fiacao etapa 3, e o erro que deixaria os botoes sem funcionar
    A pergunta do Bruno sobre o selo: sim, apertar o rearme cria o selo. O
    rele puxa em ~10 ms e um dedo fica mais de 100 ms no botao, entao o
    contato 11-14 fecha antes de voce soltar e passa a segurar a bobina.
    Conferi as duas coisas que fazem isso funcionar. O contato do selo e o
    NA (11-14) e nao o NF (11-12) - se fosse o NF o rele chocalharia. E o
    cogumelo esta ANTES do no do selo, entao abrir ele mata os dois
    caminhos; se alimentasse so o ramo do rearme, o selo continuaria vivo e
    a emergencia nao desligaria nada.
    O ERRO DOS BOTOES
    Montando a etapa 3 vi que os blocos de 5 V dos botoes estavam ligados ao
    BD-5V. Mas o firmware usa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
2026-08-16 Fio encosta no terminal, legenda cabe dentro, e a regra do 0 V
    O fio nao encostava no borne porque o retangulo do terminal e desenhado
    DESLOCADO do ponto do pino - o lado comprido entra na placa, entao o
    centro do retangulo nao e o centro do pino. O desenho calculava um
    offset e a rota calculava outro.
    Extrai geoTerminal(), uma funcao so, usada pelos dois. E a rota agora
    termina na PONTA do terminal virada para fora, que e onde o parafuso
    fica de verdade - nao no meio dele.
    A legenda passou a caber dentro: todos os terminais usam a forma
    comprida (11 mm) com o texto correndo ao longo dela, nao so os de passo
    apertado. O tamanho da fonte se ajusta ao comprimento do rotulo, entao
    "24V-SRV" e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
2026-08-16 Fio sai da canaleta que o borne enxerga, e cor vira funcao
    Tres correcoes que o Bruno apontou, e a primeira explicava as outras.
    1. O FIO PASSAVA POR DEBAIXO DO TRILHO
    Um borne da borda de CIMA so alcanca a canaleta que esta acima dele. Eu
    roteava sem olhar isso, entao o fio "atravessava" o componente para sair
    do outro lado - o que na montagem significa passar por debaixo do trilho
    DIN.
    Escrevi canaletaDoGrupo() em painel_completo.js, que dado um componente
    e um grupo de bornes devolve qual canaleta aquele grupo enxerga. Rodando
    nos 34 grupos apareceu o padrao que eu tinha errado: TODAS as saidas dos
    barramentos ficam de frente para a CH-base, e eu roteava pela CH-2x1.
    Refiz as 35 rotas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
2026-08-16 Fios entram nos bornes laterais, e a porta parava de escondê-los
    Tres coisas que o Bruno viu, e as tres eram bugs de verdade.
    1. OS FIOS DA PORTA EXISTIAM, MAS ESTAVAM ESCONDIDOS
    Sao 6 fios cruzando a dobradica (C1 a C4, C7 e C8, a cadeia de comando
    inteira). Eles estavam sendo desenhados ANTES do retangulo da porta, que
    e opaco - a porta pintava por cima deles. Movi a camada de fiacao para
    depois da porta e da lateral, e antes dos componentes. Agora os fios
    passam por tras dos componentes e por cima das areas de fundo, que e a
    ordem certa.
    2. O BORNE LATERAL NAO RECEBIA O FIO
    A ultima perna do traçado era sempre "horizontal ate o X do borne,
    depois vertical ate ele". Isso funciona par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
    [painel_completo.js]
2026-08-16 Bornes sobrepostos na PI-2, e o rele em duas fileiras
    1. O ERRO DA PI-2 ERA REAL
    O J2 e o J3 estao os dois na borda de baixo, e posicoes() calculava cada
    grupo centrado na largura INTEIRA do componente. Os bornes de um caiam
    em cima dos do outro - por isso o "0V" e o "+5V" apareciam espremidos no
    meio do S0..SCL.
    Agora a borda e REPARTIDA entre os blocos, proporcional ao numero de
    vias, com 4 mm entre eles. Na PI-2 o J2 ocupa de 9,7 a 15,1 mm e o J3 de
    49,2 a 81,6 - sem encostar.
    O validador ganhou a regra: dois blocos na mesma borda precisam caber
    nela. Hoje so a PI-2 esta nessa situacao (105 mm disponiveis, 30 mm
    necessarios).
    2. O RELE EM DUAS FILEIRAS
    O Bruno esta certo: base PTF08A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
2026-08-16 O trilho DIN atravessava as canaletas, e a pinagem do rele comprado
    O BRUNO ESTAVA CERTO SOBRE O KA1
    Escrevi um teste que cruza cada componente e o trilho contra as
    canaletas, e apareceram dois problemas estruturais:
    1. O TRILHO DIN ATRAVESSAVA AS DUAS VERTICAIS
    Ele era desenhado de 16 a 484, e as canaletas verticais ocupam 14-40 e
    460-486. Ou seja: o trilho passava POR CIMA das duas. Qualquer fio
    subindo pela CV-esq aparecia cruzando por baixo do trilho - e na bancada
    seria pior, porque a tampa da canaleta nao fecharia com o trilho por
    dentro.
    Em painel de verdade o trilho e CORTADO antes da canaleta. Agora ele vai
    de 42 a 458, e o validador reprova se voltar a invadir.
    2. O DNLCB30 IN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
    [painel_completo.js]
2026-08-16 Clicar no fio mostra as duas pontas, e o pino da base no terminal
    O QUE ERA AQUILO NO KA1
    Nao era fio: era a ANILHA. Eu desenhava o numero de cada fio no meio do
    percurso, e como os quatro fios do KA1 (A1, A2, 11 e 24) tem percurso
    curto e paralelo, as quatro etiquetas se empilhavam logo abaixo do rele
    e viravam um borrao laranja com riscos dentro.
    Agora a anilha so aparece no fio SELECIONADO, e maior. Nos outros fica
    um pontinho da cor do circuito.
    CLICAR NO FIO MOSTRA AS DUAS PONTAS
    Painel novo, com as duas pontas em destaque:
    SAI DE componente · borne (e o pino da base, se for rele)
    nome do componente, onde ele fica
    o que o inventario diz daquele borne
    CH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
2026-08-16 A pinagem do rele e de fabrica, e ela mudou o layout do painel
    O Bruno esta certo e eu estava errado. Eu tinha distribuido os terminais
    do rele "do meu jeito" - pondo na fileira de baixo os que recebem fio
    externo, porque era o que convinha ao roteamento. Rele nao funciona
    assim: as fileiras sao de fabrica.
    Pelo diagrama que ele mandou (padrao MY2/LY2/JQX-13F):
    CIMA 4=NF2 8=NA2 12=COM2 14=bobina -> 22 24 21 A2
    BAIXO 1=NF1 5=NA1 9=COM1 13=bobina -> 12 14 11 A1
    A bobina fica a direita, com uma perna em cada fileira. Corrigi o
    modelo.
    E AI APARECEU A CONSEQUENCIA
    Com as fileiras fixas, o rele recebe fio EM CIMA E EMBAIXO - nao ha como
    concentrar de um lado. Entao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
    [painel_completo.js]
2026-08-16 Todo borne na borda: fila dupla nao deixa ver o fio entrando
    Os 8 pinos de sinal do BTS estavam desenhados em fila dupla, como e a
    barra real do modulo. O problema e que o pino da segunda fila cai no
    MEIO do componente, e nao existe como desenhar o fio entrando nele - ele
    sumiria atras da peca. E o objetivo desta vista e exatamente mostrar
    qual fio entra em qual pino.
    Adotei a convencao: no desenho todo borne fica na BORDA, em fila unica.
    A ordem e a mesma da barra real; muda so o desenho.
    Conferi que cabe antes de mudar:
    BTS J1 8 vias em 50 mm -> passo 5,9 mm
    BD-0V R 20 vias em 100 -> passo 4,8 mm
    Os dois folgados. Nao havia outro grupo em fila dupla.
    Anotei no BTS um "a confer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
    [painel_completo.js]
2026-08-17 As duas calhas de travessia, e o contato do KA1 que elas escolheram
    A travessia para a porta virou objeto de verdade: duas CALHAS no canto
    inferior direito, uma acima da outra e bem separadas.
    CL-pot y=444 CH-base <-> CP-vpot a cadeia de comando de 24 V
    CL-sin y=398 CV-dir <-> CP-vsin tela, botoes de 5 V, seletora
    46 mm entre elas. Cada uma sai de uma canaleta diferente da placa e
    chega numa canaleta diferente da porta, entao a segregacao se mantem do
    comeco ao fim - inclusive no unico trecho que flexiona. Desenhadas com
    a textura de espiral e a nota da folga de 60 mm.
    Antes a travessia era uma curva solta no meio do desenho, com a altura
    escrita a mao no codigo. Agora a altu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
2026-08-17 Cada calha morre dentro da SUA vertical na porta
    O Bruno viu que a calha de sinal estava comprida demais. Estava mesmo:
    as duas terminavam no mesmo x, entao a de sinal atravessava a sua
    propria vertical e ia parar em cima da de potencia.
    Agora cada calha declara onde entra (`entraEm`) e morre dentro da
    vertical dela:
    CL-sin entra em x=13, dentro da CP-vsin (2-24) <- a mais CURTA
    CL-pot entra em x=37, dentro da CP-vpot (26-48)
    E isso obrigou a decidir a ORDEM das duas verticais na porta. A de sinal
    tinha que ficar na BORDA da dobradica: se fosse o contrario, a calha de
    sinal teria que passar por cima da vertical de potencia para chegar ao
    destino, misturando as classes justamente n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
2026-08-17 Etapa 4: os 30 fios de sinal, e um bug no proprio auditor
    A calha de sinal subiu para y=305, com centro em 317 - o mesmo da
    CH-2x1, como o Bruno pediu.
    ETAPA 4 — OS SINAIS
    30 fios, todos em canaleta azul. E a etapa que a regra de segregacao
    existe para proteger.
    Mega -> PI-1 comando dos 4 sinaleiros
    PI-1 -> Mega os dois IS analogicos, o 1-Wire e o vigia do 24 V
    BTS -> PI-1 o IS bruto, que nasce a centimetros dos 6 A chaveados
    Mega -> BTS PWM e enable dos dois, com ponte R_EN-L_EN no modulo
    Mega -> MV-1 os tres grupos de ventoinha
    Mega <-> PI-2 S0..S3 do mux e o SIG de volta
    I2C Mega -> RTC -> PI-2, em cadeia
    UART Mega D18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
    [painel_completo.js]
2026-08-17 Etapa 6: as 21 saidas para a camara, e a serie das Peltier
    Os dois prensa-cabos de saida entraram no modelo, separados pelo mesmo
    motivo das entradas:
    PG9-2 (x=300) POTENCIA 12 condutores de 14 · Peltier, PTC, ventoinhas
    PG9-3 (x=470) SINAL 9 de 10 · retornos das posicoes, I2C, DS18B20,
    os dois RPM
    O PG9-3 fica embaixo da CV-dir, para os fios subirem direto pela
    canaleta de sinal sem passar pela de potencia.
    E anotei a distincao que confunde: sao DOIS destinos diferentes. Dentro
    da camara vao Peltier, PTC, ventoinhas internas, as 2 posicoes e o
    AM2315C. Na TAMPA, lado quente e do lado de fora, ficam as 2 ventoinhas
    do radiador, o DS18B20 e os 2 RPM - e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
2026-08-17 Vista nova: a camara em 7 partes, com as ligacoes de cada uma
    Aba "Dentro da camara", botao "Ligacoes por parte". Lida de cima para
    baixo, na ordem em que se monta, exatamente as partes que o Bruno pediu:
    B1 TAMPA, lado quente, do lado de FORA
    dissipadores, as 2 ventoinhas do radiador e o DS18B20
    B2 TAMPA, a Peltier atravessando — a SERIE das duas pastilhas
    B3 DENTRO, as 2 ventoinhas frias
    B4 DENTRO, centro — o AM2315C
    B5 DENTRO, base — as 2 posicoes de ensaio
    B6 DENTRO, base — o PTC e a ventoinha dele
    B7 DENTRO, nos dutos — as 2 ventoinhas de retorno
    Cada bloco diz tres coisas: o que CHEGA DO PAINEL (com o numero do fio,
    que e o mesmo da etapa 6, mais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
2026-08-17 A camara entra na aba do painel, com tampa que fecha
    A vista "Dentro do painel" agora mostra os tres: painel, porta e camara
    fria, nessa ordem da esquerda para a direita.
    BOTAO "FECHAR A TAMPA"
    Fechando, a porta some do desenho e no lugar dela aparece a face externa
    da tampa - espelhada, com os botoes e sinaleiros onde eles ficam de
    verdade quando visto de fora. A camara encosta no painel, que e como a
    bancada fica montada.
    Os fios da porta e os componentes dela somem junto, para nao ficar fio
    apontando para o nada.
    OS DOIS FUROS DO FUNDO
    Como o Bruno definiu:
    PG9-2 x=230 POTENCIA 12 fios · mais a esquerda
    PG9-3 x=470 SINAL 9 fios · no canto direito, embaixo da CV-dir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
2026-08-17 Etapa 5, a porta: 100% dos bornes com fio declarado
    O Bruno viu certo - faltava a porta inteira. Agora estao os 29 fios:
    os 4 sinaleiros, a tela com o conversor de nivel, os blocos de 5 V dos
    comandos e os LEDs da maquete.
    O QUE A ETAPA 5 OBRIGOU A CORRIGIR
    1. Os blocos de contato saem por lados OPOSTOS
    O S0 e o S2 tem dois blocos cada: um de 24 V, que e cadeia de comando, e
    um de 5 V, que e leitura do Arduino. Eu tinha os dois no mesmo lado, e
    ai um deles ficava obrigado a usar canaleta da classe errada.
    Agora cada bloco sai para a canaleta da SUA classe - o de 24 V para a de
    potencia, o de 5 V para a de sinal. E o modelo do painel refletindo o
    que a peca realmente permite: os dois bloc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
    [painel_completo.js]
2026-08-17 Os fios agora entram na camara e param dentro de um borne
    Duas coisas que o desenho nao respondia.
    1. A tela e alimentada pelo Type-C, e o diagrama mostrava "VBUS" e
    "GND-PWR" como se fossem uma segunda entrada ao lado dele. Sao o
    Type-C: VBUS e o +5 V do conector e GND-PWR e o 0 V. Ganharam nome
    porque todo condutor precisa de um destino que o script consiga
    conferir. Na montagem viram um rabicho USB-C de dois fios.
    Junto disso apareceu um erro real: P10 e P11 sao os dois fios do
    MESMO plugue e estavam declarados com rotas diferentes -- no desenho
    o par se separava e descia por canaletas distintas, coisa que o
    plugue nao deixa fazer. Agora ha o campo `juntoCom` e u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
2026-08-17 Os 21 fios da camara nunca foram desenhados dentro do painel
    Voce estava certo: nao havia cabo nenhum nos bornes de baixo do MV-1,
    nem no F-P, nem em metade da PI-2. Nao era falta de dado -- era o
    A funcao que decide onde termina o risco de um fio so sabia de duas
    coisas: um componente do painel, ou um prensa-cabo declarado dentro do
    `de`/`para`. Os fios da etapa 6 tem uma ponta que e `{camara: 'PELT'}`,
    que nao e nenhuma das duas. Ela devolvia nulo, o `pts` saia vazio, e o
    fio simplesmente nao aparecia. O modelo dizia que MV-1 O1+ estava
    ligado; a tela mostrava o borne vazio.
    Agora a ponta de fora resolve no prensa-cabo do painel, e os 21 fios
    aparecem: saem do borne, seguem a ca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
    [painel_completo.js]
2026-08-17 O selo do KA1 estava escondido atras do proprio rele
    Os dois bornes amarelos sem fio no KA1 sao o 21 e o 24, e a causa e a
    mesma para os quatro jumpers do painel: quando um fio liga dois bornes
    do MESMO componente, o tracado ia em linha reta de um ao outro,
    cortando o corpo da peca pelo meio. Como os componentes sao desenhados
    POR CIMA da fiacao, a ponte sumia inteira.
    No KA1 isso escondia o C6, que e O SELO -- o contato NA realimentando a
    propria bobina, o fio que segura o rele ligado depois que voce solta o
    rearme. O borne aparecia amarelo e solto.
    Agora a ponte contorna a peca por fora, que e onde a chave de fenda
    alcanca o parafuso, com folga diferente para cada uma para nao se
    sobrepo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
2026-08-17 DS18B20 de tres fios, e o RPM que ia queimar o Mega
    Voce viu certo: o modelo declarava um fio so para o DS18B20. Sao tres --
    VCC, GND e DATA -- e os tres chegam no painel. Sem o VCC ele nao liga;
    sem o GND o 1-Wire nao tem referencia e a leitura sai lixo, quando sai.
    Entraram o X22 (BD-5V O11 -> VCC) e o X23 (GND -> BD-0V R19).
    A auditoria disso levou a um problema pior.
    As duas ventoinhas do radiador estavam no canal 1 do MV-1. O MV-1 e um
    modulo de MOSFET canal N: ele chaveia o NEGATIVO. E o tacometro da
    ventoinha -- o terceiro fio, o RPM -- e um transistor em coletor aberto
    cujo emissor esta ligado a esse mesmo negativo.
    Com o canal desligado o preto sobe para perto de 12 V e empurra
    c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
    [painel_completo.js]
2026-08-17 Auditoria: LPWM solto, cartao SD fantasma e o STOP mal descrito
    Varredura componente por componente. Tres achados.
    1. O LPWM dos dois BTS estava declarado LIVRE. O Doc 32 sempre mandou
    aterrar ("fixo em nivel baixo, carga unidirecional"), mas nenhum fio
    dizia isso -- na montagem o borne sairia sem nada.
    Entrada de PWM flutuando e o pior caso: com o RPWM comandando a
    metade R e o LPWM em nivel BAIXO, a metade L fica com o MOSFET de
    baixo ligado e e por ele que a corrente volta do M- para o B-. Solto,
    o LPWM pega ruido, a metade L comeca a chavear junto com a R, e as
    duas conduzindo ao mesmo tempo e curto no barramento de 24 V com 6 A
    disponiveis. Entraram S311 e S312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
    [painel_completo.js]
2026-08-17 O painel virou simulador, e o simulador achou erros nas contas
    O STOP voltou a ser o circuito classico: o KA2 ganhou selo proprio e o
    botao verde voltou como comando de 24 V. Aperta uma vez, solta, e a
    potencia nao volta -- so o verde religa. A seletora LOCAL/REMOTO saiu:
    ela era a segunda camada de uma regra que a primeira ja garante sozinha,
    que e o START nunca ser aceito por MQTT.
    O Q1 e o Q2 discretos viraram KA3 e KA4, dois modulos de rele de 1 canal
    com optoacoplador. Um contato seco nao tem lado alto nem lado baixo, e
    foi isso que apagou o problema de chavear o negativo das ventoinhas do
    radiador -- o tacometro delas e referenciado nesse negativo.
    O simulador (src/sim) roda a cadeia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
2026-08-17 Mais duty da MENOS frio, e o simulador provou com numero
    O modelo termico da Peltier era uma potencia fixa, e com ele mais duty
    sempre dava mais frio. Isso e falso, e escondia justamente o problema
    que voce descreveu: o ar-condicionado que nao chega na temperatura e
    fica ligado direto.
    Agora o modelo usa Qc = Qc_max * duty * (1 - dT/dT_max), e a curva
    medida com a camara segura em 5 C e ambiente a 25 C:
    100 % -> 11,0 W de frio, dissipador a 63,7 C
    60 % -> 19,5 W de frio, dissipador a 51,5 C <- 77 % MAIS frio
    Mais duty joga mais calor no dissipador, dissipador quente aumenta o dT,
    e dT maior derruba o Qc. Realimentacao positiva no sentido errado.
    Entao o controle mudou em tres pont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
2026-08-17 Ciclo termico com cooldown, e o sentido do ensaio deixou de ser adivinhado
    O alvo virou faixa com SENTIDO. Num ensaio de frio a borda de esforco e
    a minima; num de quente, a maxima. E o sentido vem da RECEITA, nunca da
    temperatura do momento -- que era um defeito real: passar 0,07 C abaixo
    da minima fazia o firmware concluir "estou frio demais" e LIGAR O PTC
    para voltar a maxima. Num ensaio de frio o aquecedor nao dispara nunca.
    Tres receitas: so frio, so quente, e ciclo termico. O ciclo alterna com
    PATAMAR em cada extremo e COOLDOWN entre eles -- e o cooldown nao e
    enfeite: trocar direto significa disparar o PTC com o dissipador da
    Peltier a ~52 C, jogando calor pela pastilha no sentido er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
2026-08-18 Enxuga o aplicativo: saem as abas de camara e de deteccao
    Removidas as vistas "Dentro da camara" e "Deteccao de falha", junto com
    os dois componentes que so elas usavam (Camara3D e LigacoesCamara).
    Sao 1.201 linhas a menos e o bundle caiu de 553 para 495 kB.
    O que NAO saiu: camara.js e camara_ligacoes.js ficaram, porque quem
    depende deles nao e a tela -- e o valida_camara e o valida_camara_rotas,
    que continuam provando que os dois prensa-cabos estao em cantos opostos,
    que nenhum componente invade a parede, que o sensor esta no centro
    geometrico e que todo fio que entra na camara tem borne de verdade no
    painel. Perdeu-se a ilustracao, nao a verificacao.
    O camara.js tambem continua alimentan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
2026-08-18 O KA4 estava no contato errado, e os desenhos nao sabiam do KA3
    O fail-safe do KA4 apontava para o lado oposto ao que devia: com o
    contato NA, Arduino morto parava a ventoinha do radiador com o
    dissipador quente -- e o proprio Doc 40 ja chamava isso de "o pior
    caso". Passa para o NF, e a logica do D30 inverte junto: rele solto
    = ventoinha girando. O pior caso vira o comportamento antigo, que o
    projeto ja considerava seguro.
    Junto vieram tres coisas que so apareceram ao puxar esse fio:
    - o cortarPotencia() nunca era conferido. O D25 existia, lia o BD-POT
    e so servia de pre-condicao do START. Agora confere o corte em
    150 ms e acusa CORTE_FALHOU -- que e o unico jeito de descobrir um
    KA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
    [painel_completo.js]
2026-08-18 Desenha a ligacao dos quatro reles, parafuso por parafuso
    Faltava a figura. O projeto descrevia KA1 a KA4 em texto e nos dados,
    e os validadores conferiam tudo -- mas nao havia desenho nenhum
    mostrando ONDE o fio encosta, e o numero gravado na base nao e o
    mesmo nome que o diagrama usa (o diagrama diz KA1-14; o parafuso tem
    gravado 5). E o erro de montagem mais comum com rele de 8 pinos.
    Gerado do painel_completo.js pelo mesmo motivo dos outros dois
    geradores: desenho feito a mao sobre um modelo vivo acaba mentindo.
2026-08-18 KA3/KA4 voltam ao modulo, e da para VER o componente no borne
    Duas coisas nesta revisao.
    1. O rele de 8 pinos saiu do KA3 e do KA4. Conferindo contato por
    contato: o KA3 conduz 37 mA (a bobina do KA2) e o KA4 conduz
    0,36 A (duas ventoinhas). Dos cinco reles, so o KA2 chega perto
    dos 10 A -- ele interrompe 6 A em corrente continua. Pagar R$ 75
    por dois reles de 10 A para conduzir miliamperes e comprar folga
    que ninguem vai usar, e o modulo de R$ 12 tem COM/NO/NC, entao a
    correcao do NC no KA4 funciona igual nele. KA1 e KA2 seguem com o
    rele de 8 pinos: o KA1 porque precisa de 2 contatos numa cadeia
    sem Arduino, o KA2 porque precisa mesmo dos 10 A em CC.
    2. Da para cl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
2026-08-18 Os geradores param de reprovar por fim de linha
    Os tres comparam o arquivo em disco com o que produzem para decidir se
    o desenho saiu de sincronia com o modelo. So que eles escrevem LF e um
    checkout Windows entrega CRLF -- entao a comparacao byte a byte
    reprovaria o `npm run valida`, e com ele o deploy do GitHub Pages, por
    um motivo que nada tem a ver com o projeto.
    Normaliza antes de comparar. Testado convertendo o SVG para CRLF de
    proposito: o gerador continua dizendo "ja esta em dia".
2026-08-18 Todo componente discreto passa a existir num cadastro so
    Ate aqui "componente discreto" nao era um tipo de coisa no modelo: so
    existiam FIO e BORNE. Cada resistor foi encaixado onde deu -- os da PI-1
    viraram peca de placa, os dos reles um segundo cadastro, o D1 foi
    declarado duas vezes (e uma delas fingindo ser um fio, o C12), e os que
    ficam longe do painel (R8, R9, R4-R7, D2 e os dois DUTs) nao existiam em
    cadastro nenhum: so em paragrafo. Paragrafo nao e desenhado, nao e
    validado e nao vira passo de montagem.
    Agora sao 23 registros / 29 pecas em 10 lugares, cada um com: onde mora,
    como liga (serie, paralelo, antiparalelo, derivacao), cada perna com seu
    destino, polaridade e como identific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
2026-08-18 Atualiza BOM com referencia do React
    [BOM_Projeto_Integrador.xlsx]
2026-08-19 Aba nova: da para VER onde cada componente solto se liga
    A PI-1, a PI-2 e os reles ja tinham desenho. Os outros dois lugares nao:
    os 10 kOhm soldados por baixo do BTS7960 e tudo que fica fora do painel
    (os 220 Ohm na base dos postes, o D2 nas ventoinhas, os dois DUTs) so
    existiam em paragrafo -- e sao justamente os que a montagem esquece.
    A ficha e desenhada A PARTIR DO CADASTRO, nao a mao:
    - o ARRANJO escolhe a forma do desenho. Em serie, o fio atravessa o
    componente. De lado (paralelo, derivacao, antiparalelo), o desenho
    mostra o fio do circuito passando por cima e o componente pendurado
    embaixo -- que e a resposta visual para "ele fica no meio do cabo ou
    nao?"
    - os nomes dos par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
2026-08-19 O guia de montagem: 31 passos, e cada um diz o que medir
    O repositorio tinha documentacao de PROJETO -- por que 24 V, por que
    dois selos, por que um divisor -- e nada que respondesse "o que eu faco
    agora, com a peca na mao". Quem nunca mexeu com eletronica precisa das
    duas coisas, e da segunda em ordem.
    Sao 5 fases: bancada (o que se prepara com o painel ainda fechado), as
    duas placas, painel e fiacao, energizacao por trechos e ensaios. Todo
    passo tem PEGUE, ANTES, FACA, CONFIRA e SE ERRAR -- e o CONFIRA e
    obrigatorio, cobrado pelo validador: quem esta aprendendo nao tem como
    saber sozinho se ficou certo, entao cada passo termina numa medida.
    Quase nada e escrito a mao:
    - os 6 passos de f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
2026-08-19 Limpeza: o repositorio para de mandar rodar o que nao existe
    O README mandava "python simulacao/simulador.py" e o Doc 42 ensinava a
    compilar a pasta simulacao/wokwi/ -- as duas sairam ha varios commits,
    quando o simulador virou parte do aplicativo. O indice ainda tinha uma
    secao inteira de tutoriais em video e uma arvore de pastas descrevendo um
    repositorio que nao existe mais. Para quem esta comecando, documento que
    manda fazer o impossivel e pior que documento faltando.
    - Doc 42: os comandos do simulador.py e o "caminho A" do Wokwi saem; fica
    o simulador do aplicativo, e o Wokwi pelo navegador com o firmware do
    Doc 40
    - indice: a secao de video sai e entra a do aplicativo, com as 6 ab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
2026-08-19 Plano: registra as etapas 3 a 5 prontas e o que sobrou da 6
2026-08-19 O sinaleiro virou de 5 V, e metade da PI-1 deixou de ter razao de existir
    A pergunta veio do grupo: "por que nao usamos LED de 5 V em vez do rele e
    do circuito integrado?". A resposta e que o CI existia por UMA diferenca
    -- o pino do Arduino da 5 V e o sinaleiro era de 24 V. Com sinaleiro de
    5 V (existe em 22 mm, mesmo corpo industrial), o pino acende direto e
    nao ha o que adaptar.
    Sairam junto: o ULN2803A, o soquete DIP-18, 9 das 19 vias de borne da
    PI-1, 10 dos 20 jumpers, o quarto circuito inteiro da placa, 5 fios do
    painel e 2 saidas do BD-24V. A placa caiu de 34x29 para 22x22 furos e a
    caixa DIN de 6 modulos virou uma de 4.
    O que mudou de lugar, e nao sumiu:
    - o LIMITE. Era 500 mA po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
2026-08-19 O PWM da Peltier sobe de 1 Hz para 20 kHz
    O Doc 43 ja tinha provado que a justificativa do PWM lento estava
    invertida: a 490 Hz a massa termica da pastilha filtra tudo e a juncao
    NAO cicla; quem a faz ciclar termicamente e justamente 1 Hz, que esta
    dentro da constante de tempo dela. A analise ficou registrada e o codigo
    nao mudou. Agora mudou.
    20 kHz sai exato de um timer de 16 bits (16 MHz / 800), fica acima da
    audicao -- chiado de 8 kHz numa sala de apresentacao a banca ouve antes
    de ver -- e abaixo dos 25 kHz que o BTS7960 aguenta. Timer3 no D5 e
    Timer4 no D6, os dois em Fast PWM com TOP em ICR, escrevendo OCR direto:
    analogWrite() reescreveria o modo e derrubaria a frequencia de volta.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
2026-08-19 Um nome, um dono: separa as tres familias que se chamavam R1
    O proprio validador tinha avisado: "a ref R1 e usada por 2 componentes
    diferentes". E era pior que isso -- R1, R2 e R3 eram, ao mesmo tempo,
    resistores da PI-1, ramais de energia e pontos de retorno do BD-0V. Na
    bancada, "meca o R12" podia ser duas pecas diferentes, e "o R2 esta
    solto" tres coisas.
    - shunts da PI-2: R1, R2 -> RS1, RS2
    - ramais de energia: R1, R2, R3 -> RM1, RM2, RM3
    - pontos do BD-0V: R1..R21 -> Z1..Z21
    - resistores discretos ficam como estao: agora sao os unicos R do projeto
    Os dois validadores que reconheciam ponto de retorno por /^R\d+$/ foram
    ajustados, e o indice ganhou a tabela de convencao -- prefixo p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
2026-08-19 Corta a explicacao repetida: o doc 33 tinha tres secoes duplicadas
    O item 3 era "remover explicacoes repetidas", e a primeira coisa que a
    varredura mostrou foi que quase nao ha texto copiado ENTRE documentos --
    nenhuma linha longa identica em dois arquivos do projeto. A duplicacao
    estava DENTRO do doc 33:
    - "🔎 O que os desenhos do aplicativo mostram" aparecia duas vezes, com o
    mesmo paragrafo de abertura
    - "Como cortar sem lascar" aparecia duas vezes, com os mesmos 5 passos
    - "Esquema eletrico -- 4 circuitos" e "Como ler o desenho" ja tinham sido
    removidos no commit dos sinaleiros
    Junto saiu o que descrevia a INTERFACE dentro do documento (como clicar
    num furo, o campo "ir para celu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
2026-08-19 Espaca o divisor na placa: os tres rotulos se sobrepunham
    Conferido na tela: com R1, R2 e C3 dividindo a linha 14 e colunas
    vizinhas, os nomes se escreviam por cima uns dos outros no lado dos
    componentes -- justamente na hora de saber qual resistor vai em qual
    furo. R1 recuou para as colunas 12-16, R2 ficou na 17 e o C3 foi para a
    20. O no D25 acompanhou.
    O rotulo da PI-1 na lista de placas ainda dizia 20 jumpers.
2026-08-19 A deteccao de dispositivo morto vira digital: 1 bit em vez de uma placa
    A pergunta do ensaio sempre foi binaria -- "esta posicao ainda funciona?"
    --, mas a resposta vinha por um caminho longo: shunt de 47 Ohm 1%,
    multiplexador CD74HC4067, INA219 de referencia e a placa PI-2 inteira
    para abrigar os tres. Media-se 17,6 mA com precisao para, no fim,
    comparar com zero.
    Agora um sensor de corrente com saida digital responde sozinho, e o
    Arduino le a resposta num pino em INPUT_PULLUP.
    O que saiu: a PI-2 (placa, caixa DIN e validador), o mux, os 2 shunts,
    os 2 INA219, 6 fios do painel, 5 pinos do Mega (D31-D34 e A2), a posicao
    de ensaio 2 e o segundo fusivel do F-P. Cerca de R$ 88 e uma placa a
    m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
2026-08-19 Regenera a tabela dos trilhos e os desenhos: a PI-2 saiu do painel
    Os geradores leem o painel_completo.js, entao a §20.3 do Doc 20 e os dois
    SVGs acompanharam sozinhos: sai a PI-2, entra o sensor SC-1, a PI-1
    encolhe de 6 para 4 modulos e o F-P de duas vias para uma.
    ⚠️ As pastas desenhos/ e "documento componente" tinham sumido do disco
    -- nao pelo git, porque continuavam rastreadas no HEAD. Restaurei do
    proprio repositorio (git restore); nada se perdeu.
2026-08-19 A ficha do sensor ganha desenho proprio, e um arranjo novo: por passagem
    O desenho generico mostrava o sensor como se fosse o BTS7960 e dizia que
    a corrente ATRAVESSA o componente -- que e falso e importante: o fio
    passa POR DENTRO do furo sem encostar. Quem cruza de um lado ao outro e
    o campo magnetico. E por isso que da para medir sem abrir o circuito.
    Entrou o arranjo 'passagem' no cadastro (junto com serie, paralelo,
    antiparalelo e derivacao) e um desenho do host mostrando as 10 voltas
    entrando pelo fusivel e saindo para a camara.
2026-08-19 O firmware muda de pasta, e a escala real ganha arquitetura: MCP23017
    Tres coisas neste commit.
    1. A pasta firmware/ virou camada_4_programacao/firmware/ -- codigo de
    Arduino e material da camada 4, e nao raiz do repositorio.
    2. Doc 13 §13.4b: a explicacao dos sensores escrita para SER LIDA EM VOZ
    ALTA na apresentacao. As tres perguntas que a escolha provoca, com a
    analogia da balanca: a SZC23 e balanca de caminhao (nao pesa maca), o
    trimpot do WCS2702 nao muda a balanca -- so move a linha do que conta
    como peso -- e por isso as 10 voltas, que aumentam o SINAL em vez de
    apertar o ajuste.
    Inclui a conta do LED, que era duvida do grupo: 20 mA nominais, 25-30
    como ma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
2026-08-19 O aplicativo alcanca as mudancas de hoje -- inclusive na prosa
    Os validadores conferem estrutura, nao texto. Entao, com a PI-2, o mux e
    os INA219 fora do modelo, sobraram descricoes que ainda contavam a
    historia antiga: o BD-5V dizendo que a saida 8 "alimenta o mux e o
    INA219", o Z17 sendo "retorno das posicoes depois dos shunts", o resumo
    do Mega listando "D31 a D34 -> mux da PI-2", o I2C com "2x INA219", a
    camara mandando o X13 para o shunt, e o guia ensinando a cortar a placa
    em duas metades quando a segunda metade nao existe mais.
    Corrigidos. O que ficou falando do passado esta marcado como passado --
    "ERAM seis fios", "ela ja foi quase o dobro" -- porque explica a decisao.
    E um achado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
2026-08-19 Segregacao de canaletas: a conta era de 2 pulsos por segundo, agora e 40 mil
    Com o PWM em 20 kHz o texto que justifica separar potencia de sinal
    ficou desatualizado -- e no sentido de subestimar o problema. A
    segregacao deixou de ser boa pratica e virou requisito.
    [painel_completo.js]
2026-08-19 O trilho 1 nao estava estourado -- o numero na tela e que estava errado
    Fui mover o BD-AUX como combinado, e o validador reprovou por um motivo
    que vale mais que os 36 mm: o trilho 3 so e servido por canaleta de
    SINAL (CH-topo e CH-3x2). Subir um barramento de 12 V para la obrigaria
    o cabo de entrada a atravessar canaleta de sinal -- exatamente o que a
    regra §31.4 do proprio projeto proibe, e ao lado do 1-Wire e do IS
    analogico, que sao os dois sinais mais fraceis do painel. O BD-AUX
    ficou onde estava.
    Investigando o "sobram -17 mm", achei a causa real: a tela comparava a
    soma das larguras com um 360 FIXO no codigo, e o trilho util tem
    TRILHO_X1 - TRILHO_X0 = 416 mm. Nunca faltou espaco; f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
    [painel_completo.js]
2026-08-19 Tira as ultimas mencoes a PI-2 e ao plural das placas
    Ficaram: o guia chamando a fase B de "as duas placas" e mandando conferir
    "as duas placas de interface" antes de energizar; a lista de componentes
    dizendo "nas placas de interface"; o desenho do DUT no Doc 13 mandando o
    retorno para o shunt; o Doc 14 dizendo que a placa junto da camara e "a
    mesma PI-2"; e o Doc 20 explicando o PG9-3 pela medicao que nao existe
    mais.
    O que fala do passado continua marcado como passado -- as tabelas
    comparativas do §13.4 e do §33.5 precisam citar a PI-2 para explicar o
    que saiu e por que.
2026-08-19 A PI-1 tambem deixa de existir: dois modulos com borne e dois capacitores
    Fechando o caminho que comecou com o ULN2803A: a placa que tinha 6 pecas
    soldadas agora e
    · SV-1 — modulo sensor de tensao 0-25 V, no lugar do divisor R1+R2+C3
    · AD-1 — adaptador do DS18B20, que ja traz o pull-up R3 de 4,7 kOhm
    · BS-1 — tres bornes onde os dois capacitores de 100 nF entram
    PARAFUSADOS, junto com o fio, como o D1 na bobina do KA2
    Zero solda no painel. Sairam o pi1_fisico.js, o valida_pi1.mjs e o
    lista_bornes.mjs -- nao ha mais placa ilhada no projeto.
    ⚠️ DOIS NUMEROS QUE MUDAM A MONTAGEM, e viraram passo de guia:
    - o modulo divide por 5, e o divisor soldado dividia por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
2026-08-19 A lista de componentes perde a familia 'placa': nao ha mais nenhuma
2026-08-19 Os documentos alcancam o painel sem placa
    BOM: saem a placa ilhada do painel, a caixa DIN que a abrigava e os
    bornes KF301 que eram dela; entram o modulo sensor de tensao, o kit
    DS18B20 com adaptador e tres bornes de passagem de 2,5 mm² -- de 2,5
    porque em dois deles entram TRES condutores (o fio do BTS, o fio do
    Arduino e a perna do capacitor).
    Doc 33 mudou de nome: era "Placa de Interface e Componentes Discretos" e
    virou "Componentes Discretos e Modulos de Interface", porque nao ha mais
    placa. A §33.4, que ensinava a construi-la, agora conta como ela acabou
    -- em tres etapas, e em nenhuma por otimizacao: em cada uma, a razao de
    existir da peca desapareceu.
    Os dois numeros que o guia ma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
2026-08-19 A varredura vira ferramenta: npm run audita
    Os dez validadores conferem ESTRUTURA -- se o borne existe, se a rota
    fecha, se o furo tem uma perna so. Nenhum le TEXTO, e foi por texto que
    o projeto passou dias dizendo que o BD-5V "alimenta o mux e o INA219"
    depois de os dois terem saido.
    O audita.mjs confere as tres coisas que sobravam:
    1. PECA A PECA -- os 16 componentes soltos, um por um: host que existe,
    pernas apontando para terminais que existem, ensaio, porque, passo, e
    as duas frases obrigatorias de quem tem polaridade
    2. LIGACAO A LIGACAO -- 188 terminais marcados como usados, e todos com
    fio declarado. Aprendeu que jumper de configuracao (o H/L do MV-1) e
    usado sem receb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
2026-08-19 Lista de compras cruzada com o carrinho real -- e cinco achados
    Entrou no Doc 03 a secao do carrinho de 19/08, com os precos do dia e o
    que cada item e no projeto. Conferir anuncio contra projeto e o momento
    em que o erro de compra aparece, e apareceram cinco:
    1. O DS18B20 do carrinho parece ser SO A SONDA. O pull-up de 4,7 kOhm
    esta no ADAPTADOR, e e ele que faz o sensor responder. Ou compra o
    kit com adaptador, ou compra um resistor de 4,7 kOhm avulso -- e mede
    ao receber, de qualquer jeito
    2. As placas de ensaio (R$ 64) e os bornes KF128 (R$ 16) nao servem mais
    para nada: eram da PI-1 e da PI-2, que deixaram de existir. Sobra a
    placa do DUT, que cabe em 30x40 mm. ~R$ 65 de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
2026-08-20 O MOSFET sai do painel, e os reles passam a comecar no 1
    O MV-1 (modulo MOSFET 4 canais, R$ 43,51) tinha sobrado com 1 dos 4 canais
    em uso: ligar 5 ventoinhas de 12 V / 0,63 A, UMA vez por ensaio, num pino
    (D29) que nem PWM tem. As internas passaram para um terceiro modulo de
    rele -- contato NO, no lado POSITIVO -- e a caixa DIN cresceu de 4M para
    6M. O trilho 2 ainda ganhou 51 mm de folga, porque o modulo media 66.
    Doc 31 §31.16 guarda a decisao com a regra que decide: MOSFET quando
    precisa modular ou comutar milhares de vezes por hora; contato quando e
    liga/desliga. No painel, quem modula sao os BTS7960.
    RENUMERACAO -- o painel comecava no KA2, porque o KA1 existiu e saiu:
    KA2 -> KM1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
    [BOM_Projeto_Integrador.xlsx]
2026-08-21 Clicar num fio do painel derrubava a tela inteira
    O balao da camara descreve o destino do fio escolhido -- mas a selecao e
    COMPARTILHADA com o painel. Com um fio que nao atravessa a parede (um D7,
    um C1, um P14), `naCamara(fio) ?? naTampa(fio)` devolvia undefined e o
    `d.camara` seguinte lancava excecao DURANTE o desenho: o React desmontava
    a arvore inteira e a pagina ficava em branco, sem mensagem nenhuma.
    Eram 89 dos 124 fios -- praticamente todos os de dentro do painel. So os
    da etapa 6, que realmente vao a camara, escapavam; por isso o defeito
    passou pela varredura anterior, que clicava por indice numa lista que o
    proprio clique remexia e acabou testando quase so' esses.
    Agora o balao d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
2026-08-21 O BS-1 ganha desenho: um borne de passagem por dentro
    "BS-1 - 3/3 terminais" nao diz nada a quem nunca viu um borne de
    passagem, e ele era o unico item da lista sem nenhum desenho: nao e placa
    (nao tem o que soldar) nem modulo comprado (nao tem pinagem de foto). E
    tres bornes no trilho com dois capacitores parafusados neles.
    Clicar no BS-1 no painel abre agora "Ver como e o borne e o que entra em
    cada parafuso", com cinco partes:
    1. o que E o componente -- e a BARRA DE LATAO que faz dos dois lados um
    no so'. Sem isso, ninguem entende por que o fio entra de um lado e sai
    do outro sem deixar de ser o mesmo ponto
    2. a duvida em si: no A0 entram 2 fios E o capacitor -- tres condutores.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
2026-08-21 O BS-1 em corte: onde fica o "trilho" de um borne
    O desenho mostrava o borne por fora, e por fora um borne nao explica
    nada -- e a pergunta que veio foi justamente essa: "e uma placa PCB? da
    para ver os trilhos?". Nao e placa: nao ha mais nenhuma no painel desde
    19/08 (Doc 33 §33.4, a PI-1 e a PI-2 sairam, e com elas toda a solda).
    Mas a duvida por tras da pergunta e legitima: onde passa a corrente
    dentro dessa peca. Entao entrou uma vista em CORTE, que e o equivalente
    honesto de ver as trilhas de cobre:
    - as duas GAIOLAS DE APERTO e o parafuso que empurra cada uma
    - a BARRA DE LATAO entre elas -- o "trilho" deste componente: o metal
    que faz dos dois lados um no so'
    - o caminho do cobre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
2026-08-21 Escolher um fio apaga os outros, e o terminal vira o proprio fio
    Duas coisas que atrapalhavam quem tenta LER um trajeto no desenho.
    1 - OS OUTROS FIOS SO' FICAVAM TRANSPARENTES. Com 108 fios sobrepostos,
    "meio transparente" continua sendo um emaranhado: dava para ver que havia
    riscos por baixo, mas nao dava para seguir o escolhido. Agora os nao
    escolhidos SOMEM (opacity 0), e junto vai o pointerEvents -- fio
    invisivel nao rouba clique. Vale no painel e dentro da camara.
    2 - CLICAR NUM TERMINAL ABRIA A FICHA DO COMPONENTE. Mas quem clica num
    borne quer saber PARA ONDE ELE VAI. Agora o terminal acende o proprio
    fio: mesma ficha, mesmo caminho aceso, mesma centralizacao. Terminal com
    mais de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
2026-08-21 O BS-1 sai: os filtros passam para os bornes do proprio Mega
    A objecao veio da bancada e estava certa: "se e um borne de entrada e
    saida no trilho DIN, o capacitor fica pendurado embaixo, e a outra ponta
    nao chega no outro borne".
    Chega mesmo nao. O C1 liga o no A0 ao 0 V, e no BS-1 esses eram bornes
    DIFERENTES -- em bordas opostas de um bloco de 30 mm. A perna de um
    ceramico tem passo de 2,54 ou 5,08 mm: o componente ficaria esticado no
    ar, atravessado sobre o trilho, seguro por duas pernas de 0,5 mm.
    A saida nao foi uma placa: foi olhar a ordem dos pinos do Mega.
    ... A2 A1 A0 GND2 IOREF ...
    \____/
    VIZINHOS, ~3,9 mm
    No adaptador DIN cada pi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
    [BOM_Projeto_Integrador.xlsx]
2026-08-21 Todo componente mostra o que se pendura nele
    A pergunta foi direta: "todos os dispositivos que possuem componentes
    soltos tem o botao para ver a ligacao, igual o Mega?". Nao tinham.
    O levantamento:
    MEGA C1, C2 tinha desenho proprio
    KM1 D1 tinha (conjunto de rele)
    KA123 R10, R11, R12 tinha (conjunto de rele)
    BTS1 R8 tinha desenho, mas so' da PINAGEM -- o resistor
    BTS2 R9 soldado por baixo nao aparecia em lugar nenhum
    SV-1 o proprio modulo nao tinha nada
    AD-1 idem nao tinha nada
    SC-1 idem nao tinha nada
    Em vez de um desenho novo para cada um, a ficha do componente passou a
    listar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
2026-08-21 A entrega academica ganha pasta, trilha e os documentos que ja dava para escrever
    Li o kit do SENAI inteiro -- o Guia Pratico (24 pag) e os cinco cadernos da
    Biblioteca SENAI SESI Tres Rios (Pesquisa, Resumo Expandido, Pitch, BM/PM
    Canvas, Sensibilizacao) -- e montei entrega_senai/ com a trilha das 11
    etapas e o que cada entrega exige, com a regra citada da fonte.
    PRONTO E CONFERIDO:
    - Resumo Expandido com 680 palavras (o limite e 600-700, e o texto foi
    enxugado duas vezes ate caber). Estrutura exata que o caderno pede:
    INTRODUCAO com problema + justificativa, METODOLOGIA com objetivos +
    desenvolvimento, RESULTADOS com viabilidade tecnica + economica,
    CONCLUSAO, 5 palavras-chave
    - O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
2026-08-21 A busca de anterioridade sai do "aparece um monte" e vira numero
    O problema era o metodo, nao a base: procurar patente por palavra solta
    devolve dezenas de milhares de documentos de areas que nada tem a ver com
    o projeto. "camara climatica" no Brasil da 273 resultados -- e sao
    agroquimico, incubacao de aves, adesivo e vidro.
    A saida e' buscar por CLASSIFICACAO (IPC/CPC), que e' como examinador
    trabalha. As classes deste projeto:
    G01R 31/28 ensaio de circuitos eletronicos <- a mais precisa
    F25B 21/02 refrigeracao por efeito Peltier
    G01N 25/00 investigacao por meios termicos
    G05D 23/19 controle automatico de temperatura
    Busca executada em 21/08/2026 no Google Patents, que INDE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
2026-08-21 As perguntas dos cadernos do SENAI, todas respondidas -- e duas correcoes que elas pegaram
    Cada caderno da Biblioteca termina com um bloco de exercicios ("Registro
    de Descobertas", "Redacao Relampago", "Faca um roteiro"). Eles nao sao
    decorativos: sao o rascunho que a banca espera ver por tras de cada
    entrega. Extrai todas as perguntas dos PDF e conferi uma a uma.
    DUAS COISAS ESTAVAM ERRADAS:
    1. O resumo estava em PRIMEIRA PESSOA. O checklist ABNT do caderno manda
    escrever "sem utilizar primeira pessoa no texto", e o nosso dizia
    "Desenvolvemos uma modernizacao...". Virou "Foi desenvolvida uma
    modernizacao...". Conferido por varredura: zero ocorrencias agora.
    2. Faltava a resposta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
2026-08-22 A pastilha nunca inverte -- entao a justificativa do BTS7960 estava errada
    A objecao veio da bancada e esta certa: o projeto dizia que o BTS7960 foi
    escolhido "porque permite inverter a polaridade para aquecer ou
    resfriar". Isso NAO acontece aqui. Quem aquece e' o PTC; a Peltier so'
    resfria. E o proprio desenho prova: o LPWM esta amarrado em 0 V dentro do
    modulo, e o Doc 32 ja mandava ligar assim -- "ligacao correta para carga
    unidirecional". A ponte H opera como chave unidirecional.
    A justificativa era resquicio da analise inicial, de quando o aquecimento
    ainda seria feito pela propria pastilha. O PTC assumiu esse papel e a
    inversao perdeu a funcao -- mas o texto ficou.
    O COMPONENTE CONTI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
2026-08-22 Duas perguntas de bancada viram decisao escrita: quem gera o PWM, e por que dois drivers
    1) "O BTS modula com PWM? so' ele faz isso?"
    Nao. Quem gera o PWM e' o ARDUINO -- o trem de pulsos nasce num timer do
    ATmega2560 e sai pelo D5/D6. O BTS obedece: copia aquele sinal de 5 V
    para os 24 V da carga. Modular por PWM qualquer chave semicondutora faz;
    nao e' privilegio do BTS. O que ele acrescenta e' o pacote -- driver de
    gate, protecoes e o IS.
    2) "Ja que ele tem duas metades, por que nao UM modulo, Peltier no RPWM e
    PTC no LPWM?"
    A ideia funciona eletricamente, e isso esta escrito. RPWM e LPWM nao sao
    saidas de potencia -- sao comando; a potencia sai por M+ e M-. Mas dava
    para ligar cada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
2026-08-22 A ponte H nunca inverte -- e o firmware estava cego quando mandava desligar
    Tres textos ainda justificavam o BTS7960 pela inversao de polaridade, que
    este projeto nao usa: quem aquece e o PTC, e o L_PWM dos dois modulos esta
    presoem 0 V pelos fios S311/S312.
    - fiacao_etapa6: o retorno da Peltier vai ao M- pelo motivo certo -- a
    metade L devolve a corrente pelo MOSFET de baixo ligado (~0,6 W) em vez
    do diodo de corpo (~5,4 W a 6 A) -- e nao "para poder inverter".
    - pinagens: a nota do modulo e o papel do L_PWM.
    - referencias/2026-08: marcado como historico, sem reescrever a analise.
    E, respondendo como se detecta falha no BTS, apareceu um buraco real: o
    lerCorrente() devolve -1 quando o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
2026-09-02 Atualizações PI: adequações CA/CC, limpeza SVGs, referências ABNT e FAQ para banca
2026-09-06 fix(layout): adjust panel 700mm and shorten names
2026-09-07 docs: expand comparison matrix with all infrastructure and power components
2026-09-08 docs: rewrite primary SAGA and create secondary SAGA for Silos de Gipsita
2026-09-08 docs: rewrite both SAGAs in simple didactic language for SENAI board
2026-09-08 docs: add PID and RS-485 explanations, PTC fix, IHM, industrial cost calc
2026-09-08 docs: add Arduino UNO R4 WiFi as evolution option in SAGA and Doc 04
2026-09-08 docs: add non-invasive current sensor option (ZMCT103C / WCS) to maquete specs
2026-09-08 docs: clarify that architecture works for AC loads by simply swapping the sensor to a TC
2026-09-08 docs: clarify RS-485 vs 4-20mA cost benefits (saving 50 transmitter pairs) in SAGA and Doc 04
2026-09-08 docs: explain Arduino limits regarding 50 pins and native 4-20mA constraints to further justify RS-485
2026-09-08 docs: add trick questions section to both SAGA docs to prepare the team for the board evaluation
2026-09-08 docs: detail the 4-20mA to ESP32 connection using HW-685 module and Ohm's Law (V=R*I) calculation for the examination board
2026-09-10 docs: explain SELV, ADC, pull-down, and industrial panel routing separation in viability docs
2026-09-13 docs: deeply analyze ESP32 and Arduino options for connectivity architectures
2026-09-13 docs: expand current sensors section with massive 4-level application hierarchy and AC/DC tables
2026-09-13 docs: restructure power drivers section around unidirectional logic-level MOSFETs vs BTS7960
2026-09-13 docs: restructure Modbus/RS-485 architecture section explaining I2C capacitance limits and industrial ADC variants
2026-09-18 Update docs: novos roteiros de viabilidade e slides
2026-11-02 Atualizacao completa: CAD da camara e painel interativo, suporte em tiras de aluminio com espacadores, simulacao e compras
2026-11-02 Documentacao: PTC 12V 50W liberado com ligacao direta ao BTS2 sem termostatos ST-1/ST-2
2026-11-03 CAD: adiciona CAM-26 com duas barras de aluminio a partir do DXF vigente
2026-11-03 CAD: registra inconsistencias dimensionais e pendencias de corte da revisao atual
2026-11-03 CAD: destaca arquivos obsoletos e CAM-26 atual no leia-me
